Gecesars/emb_ant/README.md

# Painel setorial P1H · 5,09 a 5,25 GHz

**P2M19 R09 — simulações suspensas por solicitação do usuário em 14/11.** Referência RF preservada: R08, 14 passes, 20,544 dBi e ΔS 0,010484. Resumo enviado para gecesars@gmail.com. Planejamento da rede externa e montagem mecânica preliminar concluídos, com base de alumínio e dois conectores N. Falta de memória exige registro e parada sem repetição automática. [Estado, política e comunicação](projetos/P2M19/gestao_R09/README.md).

**P2M19 R08 — passes 13 e 14 concluídos em 14/11.** Malha preservada, colunas 72 mm, refletor 146 mm, 14 núcleos, 5,17 GHz, 16 entradas iguais/em fase e sem sweep. **ΔS final 0,010484 ≤0,05**; ganho frontal total **20,544 dBi**, aberturas **H 22,491° / V 3,783°**, máximos **+0,188° / +0,048°**. VSWR ativo **1,033–1,182**; maior VSWR com demais entradas casadas **1,316**. Entre os passes 13/14, ΔG **+0,0400 dB**, ΔH **−0,0986°**, ΔV **+0,0015°**; maior diferença de E/Emax **0,00353 H / 0,01006 V**. Balanço de potência consistente e zero reparos Major/Minor. O critério completo de 0,1 dB nas nove sondas por dois passes **ainda não foi atendido**; maior variação final 0,182 dB numa direção cerca de 31 dB abaixo do ganho frontal. Executados exatamente dois passes adicionais, sem novos cálculos programados. [Relatório, HFSS, VSWR e diagramas](projetos/P2M19/continuacao_72mm_ref146_14passes/README.md).

**P2M19 R07 — passes 11 e 12 concluídos em 14/11.** Malha preservada, colunas 72 mm, refletor 146 mm, 14 núcleos, 5,17 GHz, 16 entradas iguais/em fase e sem sweep. **ΔS final 0,014268 ≤0,05**; ganho frontal total **20,475 dBi**, aberturas **H 22,683° / V 3,778°**, máximos **+0,144° / +0,039°**. VSWR ativo **1,009–1,174**; maior VSWR com demais entradas casadas **1,301**. Entre os passes 11/12, ΔG **+0,0248 dB**, ΔH **−0,0634°**, ΔV **+0,0044°**. Balanço de potência consistente e zero reparos Major/Minor. A estabilidade completa de 0,1 dB nas nove sondas por dois passes **ainda não foi confirmada**; maior variação final 0,375 dB em uma direção cerca de 31 dB abaixo do ganho frontal. Executados exatamente dois passes adicionais, sem reiniciar a malha ou programar novos cálculos. [Relatório, HFSS, VSWR e diagramas](projetos/P2M19/continuacao_72mm_ref146_12passes/README.md).

**P2M19 R06 — convergência de ΔS confirmada em 14/11.** Executados somente os passes **9 e 10**, preservando os oito anteriores, colunas de 72 mm e refletor de 146 mm. 14 núcleos, 5,17 GHz, 16 entradas de 0,0625 W / 0°, sem sweep. ΔS **0,021617 / 0,024510**, dois passes consecutivos abaixo de 0,05. Ganho frontal total **20,391 dBi**, H/V **22,761° / 3,768°**, VSWR ativo **1,054–1,221** e máximo com demais entradas casadas **1,294**. Balanço de potência consistente e zero reparos Major/Minor. **A estabilidade completa dos campos ainda não foi confirmada**: ganho frontal variou +0,122 dB no último passe; maior variação entre as nove sondas foi 0,463 dB. Nenhum passe além de dez foi executado. [Resultados, HFSS e diagramas atualizados](projetos/P2M19/continuacao_72mm_ref146_10passes/README.md).

**P2M19 R05 — dois passes adicionais concluídos em 13/11, PRELIMINAR.** Preservados a geometria de colunas a 72 mm, refletor 146 mm e os seis passes anteriores; executados somente os passes 7/8, com 14 núcleos, 5,17 GHz, 16 entradas iguais/em fase, sem sweep. Resultado: **20,101 dBi**, H **22,734°**, V **3,753°**, VSWR ativo **1,143–1,353**. **ΔS=0,05196469 >0,05: não convergiu.** Balanço de potência consistente, zero reparos Major/Minor; ganho ainda variou +0,241 dB no último passe. O acompanhamento desta execução está concluído, sem novos passes programados. [Resultados, HFSS, comparação 6/8 e diagramas](projetos/P2M19/continuacao_72mm_ref146_8passes/README.md).

**P2M19 — comparação de 72/88 mm e três refletores concluída em 13/11, PRELIMINAR.** Executada fila local finita, com 14 núcleos, seis passes por geometria, entradas iguais/em fase, 5,17 GHz e sem sweep. Na comparação direta, mantendo refletor de 178 mm, colunas de 72 mm deram **19,209 dBi, H 24,238°, V 3,752°**, lóbulo horizontal **−4,866 dB** e ΔS **0,156138**. Os ajustes para refletores de 162/146 mm deram **19,418/19,500 dBi**, com H **23,989/23,550°**. **Nenhum caso convergiu ao alvo ΔS≤0,05 ou confirmou estabilidade dos campos; nenhum chegou a H=30°.** Balanços de potência consistentes, zero reparos Major/Minor, sem passes adicionais. A fila encerrou; não há agendamento recorrente. [Comparação, diagramas, nativos e evidências](projetos/P2M19/estudo_72mm/README.md) · [Operação da fila local](projetos/P2M19/automacao/README.md).

**P2M19 R01 — 16 níveis × duas colunas a 88 mm, estudo preliminar de 13/11.** Oito placas C12, 32 radiadores, dezesseis entradas de **0,0625 W / 0°**, 5,17 GHz, 14 núcleos e sem sweep. Encerrou no limite de **seis passes**, com **ΔS 0,177100 > 0,05: não convergiu**. Ganho frontal total **19,055 dBi**, abertura central H **19,428°**, V **3,820°**. Atinge 19 dBi numericamente, com margem de apenas 0,055 dB, sem validar a meta. Lóbulo horizontal em −37° a **−2,829 dB** do pico; VSWR ativo **1,364–2,295**. Balanço de potência consistente, zero reparos Major/Minor. Inclui perdas dos divisores impressos; exclui rede externa, cabos 3D e radome. [HFSS, CAD, diagramas, convergência e dados](projetos/P2M19/centro_16x2_88mm/README.md).

**P2S13 R17 — montagem DN100 dimensionada, preliminar (12/11).** Dois flanges Al Ø110 ×4,76 mm com canais **2,5 ×2,5 mm**, fixadores POM, dois N Amphenol082-6784 no flange inferior, chapa com linguetas e chicote completo. [FreeCAD, STEP, BOM, DXF e 12 páginas de documentação](projetos/P2S13/mecanica_R17/README.md). O teste sem abas resultou em **14,305 dBi, H78,77°, V10,11°, VSWR1,124/1,057**; ΔS0,030507 em seis passes, só um consecutivo válido. Abas pouco alteraram H; mantidas na montagem principal pelo vertical mais simétrico no resultado anterior. [Comparação HFSS/Nexxim e limites](projetos/P2S13/comparacao_refletor_R17/README.md). O fechamento mecânico completo ainda não foi qualificado em RF.

**P2S13 no tubo PVC — R16 concluída em 12/11 como estudo preliminar.** O ajuste `dn100_c02` atingiu **VSWR ativo 1,099 / 1,087** nas entradas do conjunto e **14,320 dBi** calculados em 5,17 GHz, com duas fontes iguais/em fase. Antena e divisor simulados separadamente; cabos somente no Nexxim, com perdas nominais. Tubo de catálogo **De 101,6 × parede 1,8 mm**, trecho aberto de 350 mm; propriedades dielétricas preliminares. Divisor convergiu em **6 passes / ΔS 0,017252**; antena encerrou em **6 / 0,041601**, sem os dois passes consecutivos exigidos e sem estabilidade completa de campos. Abertura agora informativa. **Não é qualificação do tubo comercial.** A sintonia melhora o conjunto carregado; isolado com saídas em 50 Ω, o divisor apresenta VSWR 2,154/2,153. [Pesquisa de tubos, explicação do VSWR, resultados e nativos](projetos/P2S13/tubo_pvc/README.md).

**Histórico anterior, sem tubo PVC:**

**P2S13 C09 ajustada — casamento do conjunto confirmado em 12/11.** Selecionada a c02: **VSWR ativo 1,184 / 1,226**, entradas de 0,5 W / 0° em 5,17 GHz; com a outra entrada casada, **1,142 / 1,207**. Seis ramais iguais de 19,323907 mm e PCB de 36 × 78 mm preservados, alterando apenas as duas seções dos transformadores. Divisor recalculado no HFSS: **5 passes, ΔS 0,020366, 14 núcleos**, sem radome, cabos 3D ou sweep. Nexxim efetivamente executado e conferido, erro S2 **6,15×10⁻¹⁶**. Com a antena S6 preservada, **14,146 dBi, H/V 86,241° / 10,068°, máximos 0° / +0,075°** permanecem preliminares pela estabilidade de campos da antena. O ajuste é para a carga da antena; o divisor isolado com saídas em 50 Ω tem VSWR 1,716/1,706. A abertura H≈100° e a qualificação completa continuam pendentes. [Relatório, dimensões, HFSS, Nexxim e FreeCAD](projetos/P2S13/casamento_c09/README.md). Montagem ajustada deixada aberta; nenhum novo Gerber liberado.

**Histórico C09 antes do ajuste:**

**P2S13 C09 compacto — Nexxim executado em 12/11, preliminar.** Novo divisor duplo 1:3 de **36 × 78 mm**, duas seções por ramal e comprimentos físicos/elétricos nominais iguais. HFSS separado para antena S6 e divisor S8, **sem radome e sem cabos longos em 3D**; seis coaxiais iguais de 134 mm representados por RLGC no Nexxim. Em 5,17 GHz, entradas de 0,5 W / 0°: **13,925 dBi** frontais, **VSWR 1,528 / 1,700**, H/V **86,228° / 10,073°**, máximos H/V **0° / +0,069°**. O casamento **não atende 1,25** e a abertura H está abaixo dos aproximadamente 100° buscados. Antena convergiu em **6 passes / ΔS 0,024379** e divisor em **5 / 0,019563**, todos com 14 núcleos; ainda há variação de campo de **0,309 dB** no último passe. A matriz Nexxim confere com cálculo independente, erro **4,61×10⁻¹⁶**. [Circuito nativo, diagramas, CAD e evidências](projetos/P2S13/compacto_c09/c00/README.md). Nenhum novo sweep; C08/Gerbers anteriores preservados, sem liberação C09 para fabricação.

**P2S13 R12 — continuação de oito passes e CAD/KiCad, 12/11.** Executados apenas passes 7 e 8 preservando a malha, 14 núcleos, 5,17 GHz, sem sweep e entradas 0,5 W / 0°. **ΔS 0,034291**, dois passes consecutivos ≤0,05: convergência S atendida. Ganho frontal **11,569 dBi**, VSWR ativo **1,547 / 1,455**, H/V **99,818° / 9,843°**, máximo V **−0,134°**; balanço de potência consistente. **Ganho frontal ≥12 dBi e VSWR ≤1,25 não atendidos; estabilidade de campo e simetria de 0,2 dB ainda pendentes** (assimetria V 0,208 dB). [Resultados, comparação e diagramas](projetos/P2S13/curvilinear_simplificado/continuacao8/README.md) · [KiCad/Gerbers: 3×M00 + 1×C08, DRC zero erros](projetos/P2S13/kicad/conjunto_R12/README.md) · [Montagem FreeCAD preliminar, deixada aberta](projetos/P2S13/mecanica_R12/README.md).

**Histórico P2S13 R12 — seis passes, 12/11, não validado.** Conjunto integral com C08, cabos e radome FR-4 de 2 mm; solver direto, elementos curvilíneos, 14 núcleos, duas entradas de 0,5 W / 0°. Em 5,17 GHz, seis passes: **ΔS 0,07831**, ganho frontal **11,572 dBi**, VSWR ativo **1,620 / 1,523**, H/V **98,902° / 9,796°**. O balanço de potência está consistente e o lóbulo principal vertical está praticamente centrado (**−0,008°**, assimetria **0,068 dB**). **Não atende à convergência, ao ganho frontal ≥12 dBi nem ao VSWR ≤1,25.** O pico horizontal é 12,724 dBi em +27,75°, distinto do ganho frontal. [Nativo, diagramas e auditoria R12](projetos/P2S13/curvilinear_simplificado/README.md).

**KiCad do divisor P2S13 C07 — 11/11:** [projeto, Gerbers e documentação](projetos/P2S13/kicad/divisor_duplo_1x3_C07/README.md), com a geometria nominal HFSS preservada. Conferência CAD/KiCad/CAM concluída; oito furos NPTH Ø0,9195 mm. **Fabricação padrão JLC ainda não liberada:** nove violações de folga mantidas porque o cobre chega aos furos e à borda. O ZIP inclui instruções de revisão especial; nenhum solve ou pedido de compra.

**P2S13 R09 — divisor corrigido e lóbulo principal vertical centrado nominalmente, 11/11.** Selecionada a C07, com compensação física nas trilhas e duas entradas de **0,5 W / 0°**. Em **5,17 GHz**, sem sweep: ganho frontal **12,746 dBi**, VSWR ativo **1,093/1,092**, aberturas H/V **98,614°/10,162°**, máximo vertical **−0,01°** na grade de 0,01° e assimetria máxima de **0,060 dB em ±4°**. Atende numericamente à meta atual de ≥12 dBi e à prioridade de centragem do lóbulo principal. O divisor convergiu em **seis passes**, **ΔS 0,023112**, dois consecutivos ≤0,05, **14 núcleos**, sem reparos Major/Minor; circuito conferido no Nexxim. Com a outra entrada casada, B fica em **1,255**, ligeiramente acima de 1,25. Resultado **preliminar**: permanecem as pendências de campos/reciprocidade da antena e não foi somada a radiação direta do divisor aos diagramas. [Relatório ilustrado, HFSS, FreeCAD, circuito e evidências](projetos/P2S13/divisor_duplo_1x3_correcao/README.md).

**Histórico R08, anterior à correção R09:**

**P2S13 — divisor duplo 1:3 físico simulado em 11/11.** A versão C01 concluiu seis passes, todos com 14 núcleos, em 5,17 GHz e sem sweep: **ΔS 0,049458**, dois passes consecutivos abaixo de 0,05. Conectada ao S6 da antena e conferida no Nexxim, com duas entradas de 0,5 W / 0°: **VSWR ativo 1,319/1,417**, ganho frontal **11,772 dBi**, H/V **99,308°/10,321°**. **Não atende VSWR≤1,25 nem ganho≥13 dBi.** O layout físico apresenta desequilíbrio de potência/fase nas saídas e não confirma o desempenho do plano de linhas anterior. Mantidas as ressalvas da antena e do modelo de componentes; nenhuma liberação para fabricação. [HFSS, circuito, CAD, diagramas e diagnóstico](projetos/P2S13/divisor_duplo_1x3_hfss/README.md).

**P2S13 — continuação de oito passes concluída em 11/11.** Três PCBs de dois elementos, dobra **28,5 mm / 150°**, mesma malha e geometria; somente passes 7 e 8 novos. Em 5,17 GHz, 14 núcleos, seis entradas iguais/em fase e sem sweep: **ΔS 0,017600**, ganho frontal **13,349 dBi**, H/V **98,727°/9,931°**, VSWR ativo máximo **1,3220**. Convergência S atendida; estabilidade de campos e reciprocidade estrita ainda pendentes. [Resultados e nativos](projetos/P2S13/continuacao_tres_placas2/README.md).

**Divisor duplo 1:3 — plano preliminar de circuito:** dois Wilkinson idênticos e ajuste comum de entrada resultam em VSWR máximo **1,1979** nas duas entradas, considerando fontes iguais/em fase e outra entrada casada. Ganho estimado **13,143 dBi**, H/V **98,720°/9,931°**; interconexão conferida no Nexxim. O divisor ainda não tem layout/validação EM, e os limites da malha da antena permanecem. [Plano, dimensões, dados e circuito](projetos/P2S13/divisor_duplo_1x3/README.md). [Histórico de seis passes](projetos/P2S13/tres_placas2/README.md) · [Campanha 4+2 interrompida](projetos/P2S13/dobras_placas_ajustadas/README.md).

**P2M21 R18 — mecânica PRELIMINAR concluída em 10/11:** [documentação, FreeCAD, chapa dobrada/planificada, BOM e imagens](projetos/P2M21/mecanica_preliminar_R18/README.md). Dez PCBs de quatro elementos, cinco por coluna: **20 níveis × 2 colunas**, passos **48/78 mm**, refletor de alumínio 2 mm, grampos de POM e dois N Amphenol 082-6784 a partir do STEP fornecido. Cabos de referência UT-141C. **Simulações interrompidas a pedido do usuário; nenhum solver será retomado automaticamente.** A rede externa de duas entradas para vinte conexões permanece pendente, assim como a liberação RF/mecânica. [Histórico R15/R16 e interrupção R17](projetos/P2M21/comparacao_colunas_niveis/README.md).

**P2M21, oito placas `4_elementos` — R14 de 10/11:** [conjunto 16×2, resultados e comparação](projetos/P2M21/oito_celulas_4_elementos/README.md), com passo horizontal aprovado de **72 mm** e folga de **2 mm**. Ensaio central com 16 portas iguais/em fase: **18,88 dBi**, H **25,25°**, V **3,75°** e VSWR ativo máximo **1,842**. **Ainda não validado: seis passes, ΔS 0,16430; requisito mantido em 0,05.** Nativos HFSS/FreeCAD, S16 e diagramas preservados, sem malhas no Git. Rede externa pendente da validação; sem sweep; a continuação posterior está registrada na R15.

**KiCad 4_elementos — 10/11:** [placa e documentação](projetos/P2M21/kicad/4_elementos/README.md) · [Gerbers para JLCPCB](projetos/P2M21/kicad/4_elementos/4_elementos_gerbers_JLCPCB.zip). Geometria R13 C12 preservada, 70 × 184 mm, RO4350B de núcleo 0,76 mm, dois divisores 1:4; DRC sem erros ou desconexões. O apontamento H +0,75° ainda excede a tolerância atual de ±0,5°; V −0,25° atende.

**P2M21 — módulo de quatro elementos, R13 de 10/11:** casamento numérico **VSWR ≤1,25 em 5,09–5,25 GHz**, com Fast de 161 pontos e conferências discretas. Pior VSWR ativo **1,23548**, outra entrada casada **1,23260**. Em 5,17 GHz: **12,4566 dBi**, H **72,055°**, V **15,183°**; máximos **+0,75°/−0,25°**, mantendo a ressalva de apontamento horizontal. Seis passes, ΔS **1,672%**, 14 núcleos, entradas iguais/em fase e cabos físicos com perdas. [Relatório, curvas, dimensões e nativos](projetos/P2M21/quatro_elementos_casamento_banda/README.md). A aprovação do casamento deste módulo não qualifica o painel completo de 21 dBi.

**P1H semipronta — campanha R07 suspensa a pedido do usuário em 8/11.** A R06 permanece qualificada somente em 5,17 GHz. O centro R07 foi conferido; a varredura de 17 frequências foi interrompida voluntariamente para iniciar o novo projeto. Não há aprovação de banda R07. [Registro do congelamento](resultados/r07/estado_semipronta.json).

**Continuação central P2M21 concluída:** dois passes adicionais, seis no total, em 5,17 GHz; 14 núcleos nos passes finais. Ganho total **23,32 dBi**, H **32,54°**, V **3,48°**. **Preliminar: ΔS 0,110424, sem convergência e com reprovações numéricas.** Sem sweep. [Comparação e diagramas polares E/Emax](projetos/P2M21/centro_sem_refinamento/continuacao_6_passes/README.md) · [Histórico de quatro passes](projetos/P2M21/centro_sem_refinamento/README.md).

**Novo projeto P2M21:** duas colunas, 16 níveis e duas entradas MIMO independentes, com meta de **21 dBi por entrada em 5,09–5,25 GHz**, a outra entrada casada em 50 Ω. [Concepção, placas KiCad, montagem FreeCAD e HFSS separado](projetos/P2M21/README.md).

**R06 qualificada numericamente em 5,17 GHz:** PCB contínua de dez elementos com divisores compactos, duas entradas de 0,5 W a 0°, cabos ideais sem atenuação. Resultado final: **17,3593 dBi, H 96,0643°, V 5,6158°**, VSWR ativo A/B **1,2115 / 1,1292** e com a outra entrada casada **1,2321 / 1,2474**. Convergência de 23 passes, estabilidade de malha aprovada e circuito conferido no Nexxim. [Relatório ilustrado de 15 páginas](resultados/r06/P1H_R06_Relatorio.pdf) · [Resultados e limites](resultados/r06/README.md) · [Cotação JLCPCB](resultados/r06/cotacao.md) · [Montagem e chapa R06](freecad/mecanica_R06/README.md). O aceite é somente no centro da banda, sem perdas dos cabos e com conectores N ideais. Os resultados reprovados abaixo são históricos, sob o método anterior.

**Histórico R02 — cálculo integrado anterior.** As duas montagens com divisores compactos reprovam o requisito conjunto de abertura horizontal e ganho em toda a banda. A 5,17 GHz, a placa contínua produziu **94,82° / 5,54° / 12,00 dBi** e as dez placas individuais **105,13° / 5,57° / 13,48 dBi**, respectivamente em H, V e ganho frontal realizado. A compacta teve a menor perda de distribuição entre as arquiteturas estudadas. [Comparação dos painéis](resultados/r02/comparacao_paineis.md) · [Relatório de engenharia](resultados/r02/Relatorio_P1H.pdf) · [Quatro materiais e divisores alongados](resultados/r03/README.md)

Projeto de uma coluna de dez antenas impressas com duas polarizações e passo de 52,6 mm no eixo X. A comparação atual usa duas PCBs distribuidoras, uma para os cinco radiadores inferiores e outra para os cinco superiores. Cada PCB atende às duas polarizações. A referência de ganho é a potência incidente nas duas entradas N, com 0,5 W a 0° em cada uma. Os modelos anteriores com divisor único e ramais de 254 mm também estão preservados.

| Para consultar | Arquivos |
|---|---|
| Modelos HFSS das duas montagens | [Uma placa](hfss/antenas/P1H_Continua.aedt) · [Dez placas](hfss/antenas/P1H_Separadas.aedt) · [Elemento de origem](hfss/antenas/P1H_AB_em_fase.aedt) |
| Modelos HFSS da alimentação | [Divisor de 22 portas](hfss/alimentacao/Divisor_2x10_PTFE.aedt) · [Transição soldada](hfss/alimentacao/Junta_UT141_P1H.aedt) |
| Fontes KiCad | [Coluna contínua](kicad/P1H_Coluna_10) · [Radiador individual](kicad/P1H_Individual) · [Divisor duplo](kicad/Divisor_2x10) |
| Referências dimensionais FreeCAD | [Uma placa](freecad/P1H_10_Continua.FCStd) · [Dez placas](freecad/P1H_10_Separadas.FCStd) · [Envelope do divisor](freecad/Divisor_2x10_PTFE.FCStd) |
| Mecânica do protótipo com refletor contínuo | [Montagem, chapa dobrada, planificação e desenho de fabricação](freecad/mecanica_R01/README.md) |
| Painel integrado R01 | [Modelo HFSS com duas portas N](hfss/antenas/P1H_R01.aedt) · [Premissas e reprodução](automacao/r01/README.md) · [Cotação da placa contínua e do divisor](resultados/r01/cotacao.md) |
| R02 com divisores inferior e superior | [Montagem, chapa e chicote](freecad/mecanica_R02/README.md) · [HFSS integrado](hfss/antenas/P1H_R02.aedt) · [Reprodução](automacao/r02/README.md) · [Cotação das três placas](resultados/r02/cotacao.md) |
| Controle R02-S com as dez placas individuais | [HFSS no mesmo refletor e rede R02](hfss/antenas/P1H_R02_10Separadas.aedt) · [Comparação convergida dos painéis](resultados/r02/comparacao_paineis.md) · [Comparação dos divisores em 50 Ω](resultados/r02/rede/README.md) · [Relatório de engenharia](resultados/r02/Relatorio_P1H.pdf) |
| R03 com saídas alinhadas e dois divisores alongados | [Comparação com a compacta e quatro laminados](resultados/r03/README.md) · [Montagem e chapa](freecad/mecanica_R03/README.md) · [HFSS do painel completo](hfss/antenas/P1H_R03_Alongada.aedt) · [Cotação](resultados/r03/cotacao.md) |
| Fabricação | [Pacotes Gerber com furação das revisões](fabricacao/gerbers) · [Ligação dos cabos da versão inicial](fabricacao/montagem/ligacao_dos_cabos.csv) · [Cotação JLCPCB inicial](fabricacao/cotacao/Cotacao_JLCPCB.md) |
| Estudos anteriores | [Colunas de 8, 9 e 10 elementos](documentacao/historico/comparacao_colunas.md) · [Elemento com ambas as portas em fase](documentacao/historico/analise_AB.md) · [Dados numéricos](resultados/historico) |
| Como reproduzir | [Procedimento e convenções](automacao/README.md) |

Os **critérios atuais de RF da R06** são abertura horizontal a −3 dB entre 81° e 99° (alvo 90°), VSWR < 1,5 nas duas entradas e ganho realizado frontal ≥ 16 dBi em +Z, no centro de 5,17 GHz e sem perdas dos cabos. A abertura vertical pode ser menor que 7°. A banda de interesse continua 5,09–5,25 GHz; os 17 pontos dos divisores não demonstram por si só desempenho do painel em toda a banda. As reprovações dos painéis integrais anteriores permanecem como histórico.

O ensaio anterior das duas revisões de PCB com refletores individuais foi interrompido após a convergência da placa contínua no centro da banda. O ganho mínimo de 16,58 dBi do estudo histórico corresponde às antenas individuais antes dos ajustes dos pads e furos. As campanhas R01, R02 e R02-S usam a mecânica completa, incluindo o refletor dobrado e os conectores N. [Estudo histórico](documentacao/historico/comparacao_colunas.md)

No painel completo R01, o ponto convergido de 5,17 GHz apresentou 14,06 dBi de ganho frontal e aberturas de 102,34° na horizontal e 6,19° na vertical. A R01 reprova as metas simultâneas de banda. [Campos, convergência e métricas](resultados/r01/README.md)

Os **radiadores** usam RO4350B de 0,76 mm (Dk de projeto 3,66). Os divisores de referência usam PTFE ZYF300CA-C de 1,52 mm. São espessuras do laminado. A placa longa mede 501,7125 × 28,3125 mm e a individual mede 28,3125 × 28,3125 mm. Os modelos RF anteriores usam dez refletores individuais de 48,3125 × 36 mm. Os protótipos mecânicos R01 a R03 usam refletor contínuo dobrado de alumínio de 2 mm, apoios em poliacetal e conectores N com junta de vedação. Os modelos históricos de cobre excluíam a camada de níquel-fósforo; a R06 inclui ENIG nominal sobre cobre físico de 35 µm.

Os modelos HFSS nativos podem gerar a malha novamente. O Git guarda projetos, dados de engenharia e documentos. As malhas, os campos volumétricos, os backups e os arquivos temporários ficam nos diretórios locais de trabalho. Os Gerbers em **fabricacao/gerbers** correspondem aos protótipos cotados. As campanhas integrais anteriores reprovam suas metas; a R06 atende ao aceite de centro pelo método separado solicitado, conforme o relatório final.
