Gecesars/emb_ant/projetos/P2M21/README.md

# P2M21 — duas colunas, MIMO 2×2, meta de 21 dBi por entrada

**P2M21 R18 — mecânica PRELIMINAR concluída em 10/11:** [documentação, FreeCAD, chapa dobrada/planificada, BOM e imagens](mecanica_preliminar_R18/README.md). Dez PCBs de quatro elementos, cinco por coluna: **20 níveis × 2 colunas**, passos **48/78 mm**, refletor de alumínio 2 mm, grampos de POM e dois N Amphenol 082-6784 a partir do STEP fornecido. Cabos de referência UT-141C. **Simulações interrompidas a pedido do usuário; nenhum solver será retomado automaticamente.** A rede externa de duas entradas para vinte conexões permanece pendente, assim como a liberação RF/mecânica. [Histórico R15/R16 e interrupção R17](comparacao_colunas_niveis/README.md).

**Painel de oito células — R14 de 10/11:** [montagem HFSS/FreeCAD, diagramas e comparação](oito_celulas_4_elementos/README.md). Oito cópias de `4_elementos`, em quatro placas verticais × duas colunas, totalizam 16 níveis × 2 radiadores. Passos de **48 mm vertical / 72 mm horizontal**, com **2 mm de folga lateral**. Em 5,17 GHz, 16 portas de 0,0625 W/0°, 1 W total: **18,8776 dBi**, H **25,2549°**, V **3,7541°**, máximos **−1,25° / 0°**, VSWR ativo máximo **1,8421** e com demais portas casadas **1,4125**. **Não validado: seis passes, ΔS 0,164297, acima do alvo 0,05**, e campos ainda variando. Malha sem reparos Major/Minor; passividade, reciprocidade e recomposição dos campos conferidas. Mantidos 14 núcleos, sem GUI e sem sweep; inclui os cabos físicos de 50 mm das células. O painel individual R04 também não convergiu e tem outros espaçamentos, portanto a comparação é histórica. A rede externa de duas entradas para 16 conexões aguarda validação dos diagramas; o estado de seis passes é histórico; os dois passes adicionais autorizados estão registrados na R15.

**KiCad em 10/11 — [4_elementos](kicad/4_elementos/README.md):** criada a placa de **70 × 184 mm**, com passo de **48 mm** e dois divisores 1:4, preservando a geometria R13 C12. [Gerbers/Excellon para JLCPCB](kicad/4_elementos/4_elementos_gerbers_JLCPCB.zip), RO4350B de núcleo 0,76 mm. Cobre, contorno e dez furos conferidos; **DRC sem erros ou desconexões**. A tolerância atual é **±0,5° em H e V**: a C12 mantém H +0,75° (fora) e V −0,25° (dentro). Esta conversão não altera a geometria nem inicia nova simulação.

**Módulo de quatro elementos — R13 concluída em 10/11:** a meta de **VSWR ≤1,25** foi atendida numericamente na banda de **5,09–5,25 GHz**. O Fast tem 161 pontos de saída e foi conferido por soluções discretas em 5,09/5,17/5,25 GHz e no pior ponto, **5,173 GHz**. Máximo ativo confirmado: **1,23548**; com a outra entrada em 50 Ω: **1,23260**. O ajuste usa três seções nos transformadores de raiz, iguais nas duas polarizações, mantendo os dipolos, passo de **48 mm** e altura de **14,949 mm**. [Relatório, dimensões, curvas, HFSS e FreeCAD](quatro_elementos_casamento_banda/README.md).

Em **5,17 GHz**, A=B=0,5 W/0°: **12,4566 dBi frontais**, aberturas **H 72,055° / V 15,183°**, máximos **H +0,75° / V −0,25°** e SLL vertical **−10,075 dB**. A forma e as larguras foram preservadas nos limites documentados; o máximo horizontal ainda excede o limite de trabalho de ±0,5°. Portanto, o casamento atende à meta, com essa ressalva de apontamento. **Seis passes, convergida em ΔS 1,672%, 14 núcleos**, sem novos passes nos sweeps. Inclui os dois cabos físicos de 50 mm e suas perdas. Ganho e diagramas foram calculados somente no centro; esta entrega não qualifica o painel 16×2 ou o desempenho MIMO por entrada.

**Módulo de quatro elementos — continuação R12 de 9/11:** [oito passes e Fast da banda](quatro_elementos_8passes_fast/README.md). A variante com passo de **48 mm** e altura de **14,949 mm** recebeu exatamente os passes 7 e 8, preservando a malha anterior. **Convergiu**, com ΔS final **1,977%**, dois passes consecutivos abaixo de 5% e 14 núcleos. Em **5,17 GHz**, com A=B=0,5 W/0°: **12,7586 dBi frontais**, VSWR ativo **1,3648/1,2285**, casado **1,2091/1,1733**, aberturas **H 73,322° / V 15,058°**, máximos **H 0° / V −1,25°** e SLL vertical **−9,095 dB**. O **Fast de 5,09–5,25 GHz**, com 161 pontos de saída e sem novos passes adaptativos, revelou máximos de VSWR ativo **2,2796/2,0142 em 5,09 GHz**. Portanto, a convergência foi atingida, mas o casamento na banda e o apontamento vertical ainda precisam de ajuste. Ganho e diagramas foram medidos somente no centro. A referência R11 permanece preservada; o ajuste de casamento R13 esta documentado acima.

**R00: concepção criada, ainda sem qualificação eletromagnética do novo painel.** A P1H foi preservada como semipronta; seus resultados não aprovam esta nova geometria.

**Distribuição solicitada em 9/11:** [dez divisores 1:4 em cinco PCBs duplas](rede_dez_1x4/README.md), com dois circuitos centrais e oito locais. O usuário aprovou uma entrada por polarização e as divisões finais 1:2 impressas nas placas radiantes. A integração do painel completo continua pendente; os estudos de módulos usam dois ou quatro elementos verticais e dois cabos físicos.

**Estudo do módulo de dois elementos:** foram testadas conexões centrais, retornos de terra e comprimentos dos divisores impressos, em 5,17 GHz, na GUI, com 14 núcleos e até seis passes por geometria. A comparação distingue apontamento, casamento e convergência e mantém a referência original. [Resultados, diagramas e nativos das variantes](dois_verticais_divisor/README.md). Este módulo não qualifica o painel 16×2 nem a banda MIMO.

**KiCad e expansão em 9/11:** criada a placa [2_elementos](kicad/2_elementos/README.md) a partir da v05 convergida, com 49 × 82,8 mm, DRC sem erros ou conexões pendentes e comparação geométrica com a fonte HFSS. O [planejamento de quatro elementos verticais](planejamento/4_elementos/README.md) foi convertido no ensaio HFSS abaixo, mantendo passo de 48 mm, duas conexões centrais e um divisor 1:4 por polarização, em uma placa de 70 × 178,8 mm.

**Quatro elementos — ajuste R11 de 9/11:** [comparação de divisores, espaçamentos e distância ao refletor](quatro_elementos_ajuste/README.md). Foram preservados 19 ensaios em 5,17 GHz, incluindo passos de 42/44/48/50/52/54 mm e distâncias de 14,949/16,610/18,271 mm. As variantes finais mantêm divisores espelhados e duas entradas de 0,5 W / 0°. O candidato numérico mais promissor usa **48 mm de passo e 14,949 mm entre laminado e refletor**, com transformadores de raiz iguais de **0,656371 × 9,000142 mm**: **12,7018 dBi frontais**, VSWR ativo **1,2327/1,0940**, casado **1,1041/1,1808**, aberturas **H 73,630° / V 15,180°** e SLL vertical **−8,385 dB**. Continua **preliminar, não liberado**: seis passes, **ΔS 0,057225 (5,7225%)**, acima do alvo de 5%, e máximos **H −1,00° / V −1,25°**. Nenhum ensaio R11 completou os dois passes consecutivos de convergência configurados. O estudo usa 14 núcleos, sem GUI, sem sweep, com os dois cabos físicos de 50 mm e perdas nominais; não qualifica o painel 16×2. A comparação controlada de alturas foi preservada separadamente do reajuste posterior do transformador.

**Quatro elementos — referência R10 de 9/11:** [modelo, resultados e diagramas](quatro_elementos_hfss/README.md). Simulação sem GUI, 14 núcleos, somente 5,17 GHz, dois divisores 1:4 impressos e dois cabos físicos de 50 mm, fontes de 0,5 W / 0° cada. Terminou no limite de seis passes com **ΔS = 0,048783 (4,8783%)**, acima do alvo de 4%: **preliminar, não convergido**. Ganho frontal realizado total **11,0946 dBi**; VSWR ativo A/B **1,4470 / 1,5774**. Máximos dos cortes H/V em **−25,25° / +0,50°**, com aberturas **83,858° / 14,961°**. A frente está 0,404 dB abaixo do pico horizontal; o pico não está centrado em 0° e a entrada B excede VSWR 1,5. Malha sem reparos Major/Minor, matriz passiva e balanço de potência conferido; essas verificações não substituem a convergência. Não foi executado sweep nem ampliado o limite de passes.

**Continuação concluída em 9/11:** somente os dois passes adicionais autorizados (5 e 6), mantendo 14 núcleos e 5,17 GHz. Resultado: **23,3227 dBi, H 32,5429°, V 3,4843° e ΔS 0,110424**. Continua **preliminar e não convergido**; a eficiência calculada de 100,425% e o erro de reciprocidade também impedem a qualificação. Os dois diagramas polares E/Emax foram revisados visualmente. [Comparação, dados e diagramas](centro_sem_refinamento/continuacao_6_passes/README.md).

**Histórico do painel completo — 9/11:** somente ganho total e diagramas H/V em **5,17 GHz**, com 16 níveis × 2 colunas e as 64 portas iguais/em fase. A revisão R04 usa Classic com resolução global padrão, sem refinamentos locais/iniciais impostos, sem lambda refinement inicial e com base mista. O primeiro cálculo foi limitado a quatro passes; o pedido seguinte autorizou exatamente mais dois, preservando a malha e o histórico. A continuação terminou às 05:53 com **seis passes no total**, sem sweep e sem alteração geométrica. O resultado de quatro passes permanece arquivado: **23,06 dBi, H 32,72°, V 3,50° e ΔS 0,617681**. [Histórico de quatro passes](centro_sem_refinamento/README.md). O ensaio R02 e a tentativa TAU R03 permanecem históricos. A alimentação direta não inclui a rede externa nem comprova ganho MIMO por entrada.

**Estudo de 9/11, antes de corrigir a malha:** a pedido do usuário, foi comparada a alimentação de **todas as portas A/B simultaneamente, com amplitude igual e fase de 0°**, mantendo 1 W total. A estimativa com a referência P1H R06 favorece manter **16 níveis × 2 colunas**: ganho total frontal de aproximadamente **22,50 dBi**, H **39,1°** e V **3,49°** em 5,17 GHz, sem a nova rede. O caso 10×2 fica em 20,46 dBi. Foram documentadas 36 combinações de níveis, colunas e espaçamentos. Este estudo coerente não comprova o requisito MIMO por entrada nem a banda e não alterou a geometria ou iniciou novo ciclo HFSS. [Comparação, método e gráficos](estimativa_uniforme/README.md).

**Atualização de 8/11, após a execução R00:** a antena terminou às 16h43 sem convergir em seis passes: ΔS = 0,040859, contra o limite então adotado de 0,02. Foram identificados sete corpos com reparos Major. Aquela fila interrompeu antes da varredura do painel e do circuito; ganho e VSWR por entrada nos 17 pontos continuam sem confirmação. [Diagnóstico e evidências](diagnostico_20261108.md).

O requisito original do projeto, ainda não qualificado e fora desta etapa de centro, é ganho frontal realizado **≥21 dBi em cada entrada**, de **5,09 a 5,25 GHz**, nos 17 pontos separados por 10 MHz, com a outra entrada terminada em 50 Ω. Cada entrada alimenta uma polarização dos 32 radiadores, distribuídos nas duas colunas. Os dois canais permanecem independentes. Não se soma a potência dos canais para alegar 21 dBi por entrada.

## Arquitetura escolhida

| Item | R00 |
|---|---|
| Arranjo | 16 níveis × 2 colunas; 32 radiadores de duas polarizações |
| Passo vertical / horizontal | 52,6 / 40 mm |
| Placas radiantes | 4 módulos iguais de 2 colunas × 4 níveis |
| Dimensão de cada módulo | 186,1125 × 68,3125 mm |
| Radiadores | RO4350B, núcleo 0,76 mm; Dk de projeto 3,66; tanδ 0,0037 |
| Alimentação | Um divisor duplo 1:4 central e quatro divisores duplos 1:8 locais |
| Placa de cada divisor | 39 × 78 mm, PTFE ZYF300CA-C de 1,52 mm; Dk 2,94; tanδ 0,0016 |
| Metalização RF | Cu físico 35 µm; ENIG nominal Au 0,0254 µm / NiP 4,5 µm |
| Refletor | Face 850 × 100 mm; alumínio 2 mm; base dobrada a 90° |
| Apoios | Oito berços transversais em poliacetal, espessura 5 mm |
| Entradas mecânicas | Dois furos Ø16 mm na base, reservados aos conectores N |

RO4350B é laminado hidrocarboneto/cerâmico; o PTFE está nas distribuidoras. A disponibilidade dessas famílias e espessuras foi consultada no contexto P1H: [materiais JLCPCB](https://jlcpcb.com/news/rogers-ptfe-high-frequency-pcb-available). A cotação P1H não é uma cotação destas novas placas. Não houve compra.

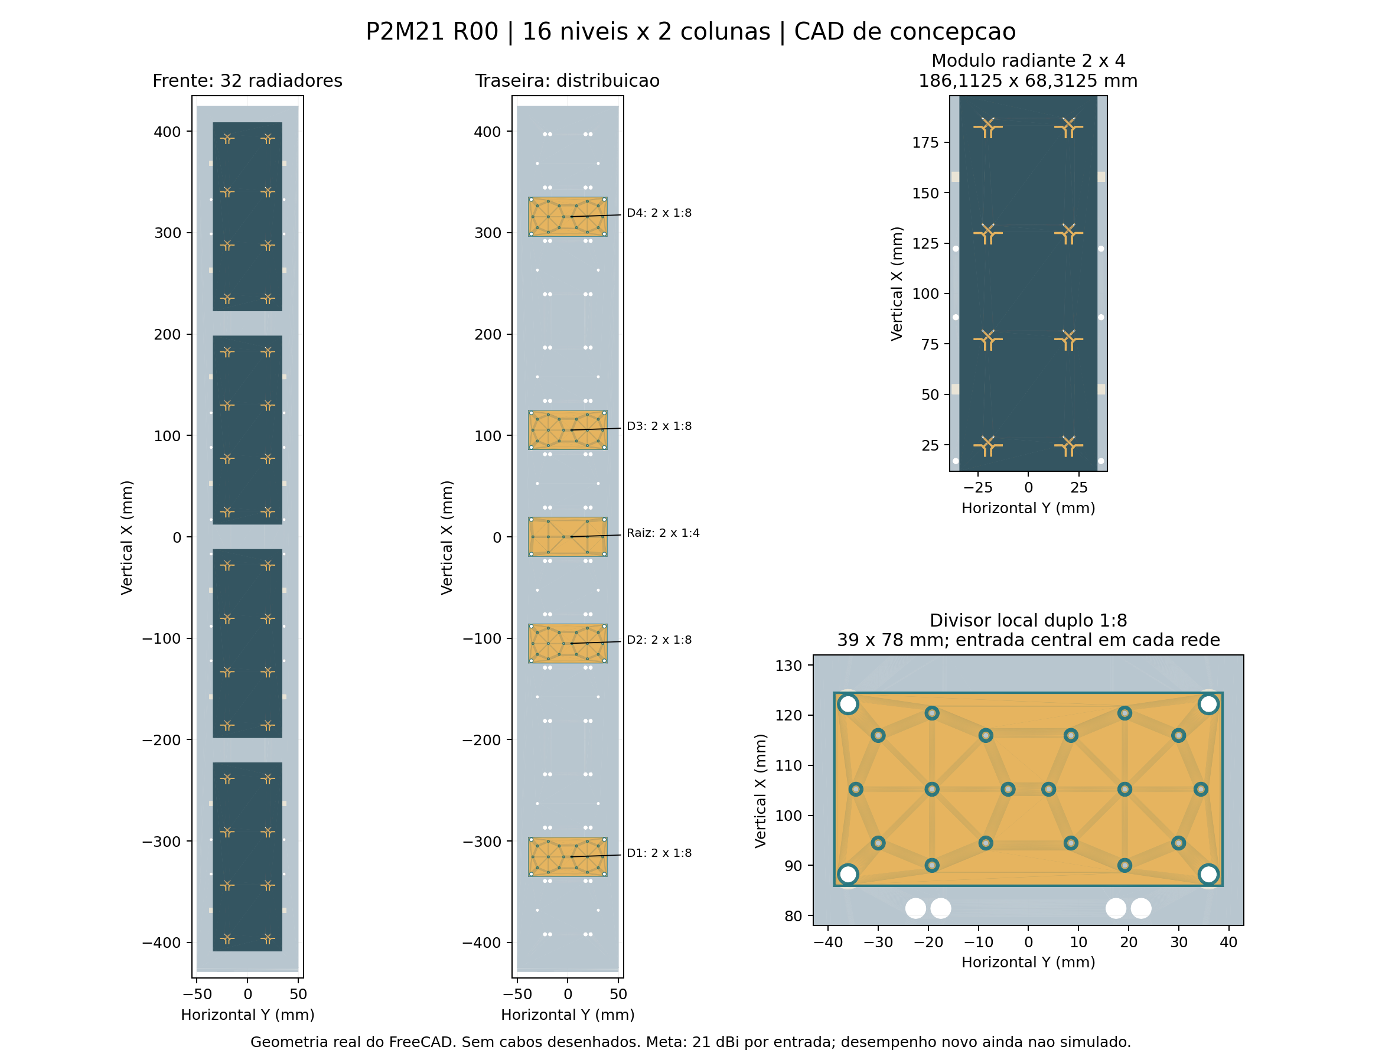
[picture p1: projetos/P2M21/imagens/montagem_e_placas.png]
Montagem CAD e detalhes das placas


[Detalhe do cobre nas duas faces da PCB](imagens/pcb_duas_faces.png)

## Por que 16 níveis e distribuição central

Foram comparados 10, 12, 14, 16, 18 e 20 níveis, com separações entre colunas de 32 a 48 mm. O pré-dimensionamento usa os campos complexos **por entrada individual** da R06 em 5,17 GHz, escala de número de radiadores e fator de arranjo horizontal. A seleção 16×2/40 mm dá uma estimativa de **22,42 dBi antes da reserva adicional**, ou **21,67 dBi com reserva de projeto assumida de 0,75 dB**, H aproximadamente **37,85°** e V aproximadamente **3,57°** no centro. A reserva não é perda simulada nem comprovação de banda. O novo acoplamento, as emendas das PCBs, o refletor e a rede podem alterar esses valores.

[Tabela de alternativas](planejamento/comparacao.csv) · [Gráfico](planejamento/predimensionamento.png) · [Premissas e referência](configuracao.json)

As distribuidoras locais ficam atrás dos centros dos quatro módulos, em X = −315,6, −105,2, +105,2 e +315,6 mm. A raiz fica em X = 0. Isso reduz a maior distância longitudinal entre centros, de 740,6 mm para uma raiz na base a 315,6 mm para a raiz central. Trata-se de comparação geométrica, antes dos arcos e conexões.

O histórico P1H mostrou perdas e desequilíbrios maiores nas versões alongadas inicialmente testadas. Por isso esta R00 parte de distribuidoras compactas locais. As redes são divisores radiais com transformadores de quarto de onda: **não são Wilkinson e não têm resistores de isolamento entre as saídas da mesma polarização**. O circuito completo deve considerar as reflexões e o acoplamento dos radiadores.

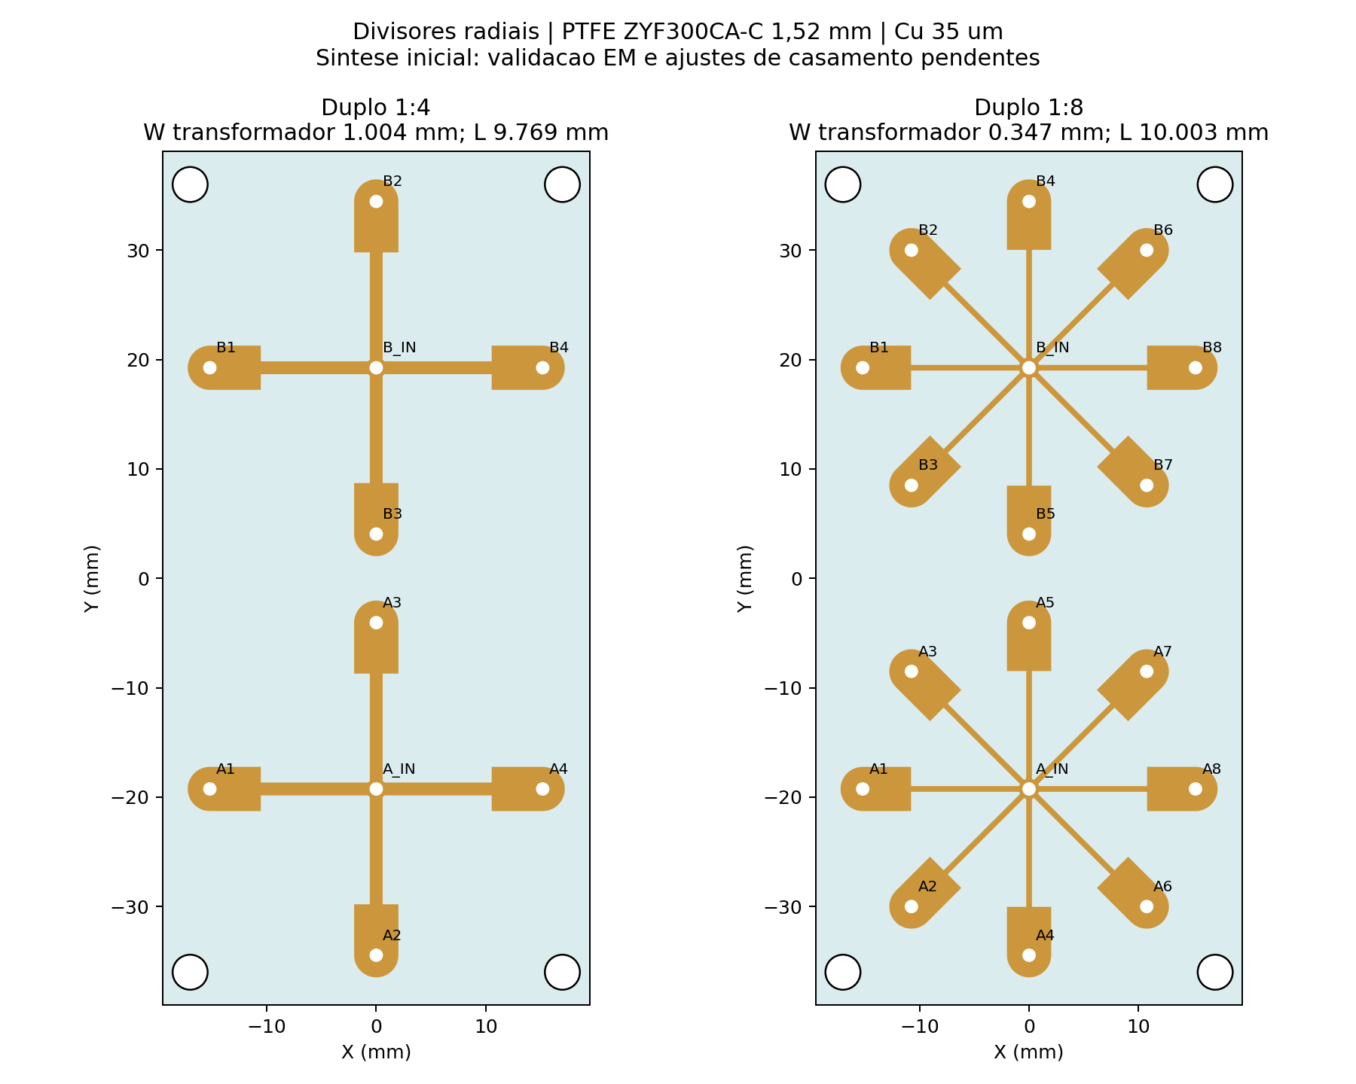
[picture p2: projetos/P2M21/imagens/divisores_detalhados.png]
Divisores em detalhe


O [mapa de conexões](mapa_conexoes.csv) associa as 64 portas dos radiadores às saídas dos divisores. A atribuição minimiza a soma das distâncias ortogonais. Há reservas iniciais iguais de **165 mm nos ramais** e **365 mm nos troncos**, calculadas com margem para roteamento. **Não são comprimentos de corte liberados:** faltam as curvas físicas, folgas de montagem e o ajuste das fases usando as matrizes S reais. As entradas N na base exigem duas ligações adicionais até a raiz. A montagem CAD ainda não inclui o chicote e os conectores N detalhados.

## Arquivos criados

- [Módulo radiante KiCad](kicad/P2M21_Modulo_2x4/P2M21_Modulo_2x4.kicad_pcb), [divisor duplo 1:4](kicad/P2M21_Duplo_1x4/P2M21_Duplo_1x4.kicad_pcb) e [divisor duplo 1:8](kicad/P2M21_Duplo_1x8/P2M21_Duplo_1x8.kicad_pcb).
- [Montagem FreeCAD](freecad/P2M21_Montagem.FCStd), [chapa dobrada STEP](freecad/Refletor_dobrado.step), [planificação FreeCAD](freecad/Refletor_planificado.FCStd) e [DXF de corte/dobra](freecad/Refletor_corte_dobra_R00.dxf).
- HFSS separado: [antena de 64 portas](hfss/antena/P2M21_Antena.aedt), [divisor de 10 portas](hfss/divisor_1x4/P2M21_Duplo_1x4.aedt) e [divisor de 18 portas](hfss/divisor_1x8/P2M21_Duplo_1x8.aedt).

O cobre do radiador foi copiado do CAD R06, incluindo vias e soldas locais; os substratos, distribuição em duas colunas, reflector e apoios são novos. Os scripts em [automacao](automacao) reproduzem a construção. O CAD nativo mantém os corpos separados para edição e posicionamento; não recupera uma árvore de esboços do cobre importado. A montagem é por posicionamento, não uma montagem cinemática.

## Verificações e limites

O primeiro ensaio do divisor duplo 1:4 convergiu em seis passes, com ΔS final 0,01449 e dois passes consecutivos aprovados. Em 5,17 GHz, com todas as saídas casadas, VSWR A/B = 1,53665 / 1,53646; perda excedente = 0,33193 / 0,33038 dB. Isso ainda não aprova o casamento nem o ganho do painel carregado. A fila inicial resolve os divisores em separado e só então o centro da antena, sem aumentar o limite de seis passes. O estado de execução está em [qualificacao.json](qualificacao.json).

O divisor duplo 1:8 também convergiu em seis passes, com ΔS 0,018707 e dois consecutivos aprovados. No centro, VSWR A/B = 1,69614 / 1,69673 e perda excedente = 0,52494 / 0,52296 dB. As terminações casadas desse ensaio não reproduzem a impedância ativa da antena; o casamento final depende do circuito carregado. **Ambos completaram os 17 pontos**, com passividade/reciprocidade verificadas e zero reparos Major/Minor. A execução da antena de 64 portas ocorreu em 8/11 das 16:03 às 16:43 e terminou sem convergência; ainda não há ganho qualificado do painel.

Os modelos CAD foram reabertos e verificados: 653 objetos na antena, 44 no divisor 1:4 e 76 no 1:8, todos válidos, sem interseções volumétricas indevidas entre corpos. Contatos tangentes entre materiais são permitidos. O DRC das três placas tem **zero erros e zero itens desconectados**. Permanecem respectivamente 203, 20 e 36 avisos de máscara aberta/ponte de máscara nas áreas RF; os relatórios completos acompanham os nativos.

A chapa planificada mede 895,398 × 100 mm, com raio interno de 2 mm e fator K assumido de 0,4. Confirmar o raio, ferramental, ajuste dos conectores e vedação antes de fabricação. A planificação é preliminar, não uma liberação industrial.

No histórico R00 foram usados seis passes e ΔS ≤0,02. A revisão R04 foi inicialmente limitada a quatro passes e continuada somente por mais dois mediante novo pedido, com 14 núcleos, sem sweep. O alvo de referência continua 0,04; o ΔS final de 0,110424 não o atende. Atingir o limite de passes não comprova convergência. Os nativos R00 preservam as antigas varreduras; sua existência não autoriza executá-las nesta etapa. Para o estudo futuro da rede separada, a matriz S64 da antena e S10/S18 das distribuidoras serão conectadas por linhas ideais de fase, sem atenuação, com referência à potência incidente em cada entrada MIMO individual.

Para a meta original MIMO, fora desta etapa central, ainda faltam a convergência EM, matrizes e campos nas 17 frequências, circuito carregado, VSWR por entrada, ganho e H/V por canal, isolamento/correlação MIMO e ajustes de casamento. O curto DC deverá incorporar as duas bobinas de entrada da referência P1H, com nova conferência da sua integração. Os avisos de máscara, terminais soldados, conectores e chicote precisam entrar na revisão de fabricação. **Nenhum resultado R00 demonstra ainda 21 dBi em toda a banda.**
