Gecesars/emb_ant/automacao/r03/README.md

# Reprodução do estudo da rede alongada

Os arquivos nativos e os dois Gerbers de referência usam ZYF300CA-C. Os materiais alternativos têm trilhas próprias para conservar as impedâncias e atrasos elétricos. A placa de radiadores usa RO4350B de 0,76 mm em todas as versões. Trabalhar em uma pasta externa ao Git para as malhas.

1. Executar `projeto.py DIRETORIO` em Python com SciPy, NumPy, Shapely e scikit-rf. O programa produz os contornos, fixações, cobre e rede de cada laminado. Executar `chicote.py DIRETORIO/candidatos.json` para sintetizar as entradas coaxiais.
2. No Python do FreeCAD, definir `P1H_R03` como DIRETORIO e executar `montagem.py`. O CAD testa os percursos coaxiais contra a montagem, a folga entre capas e os furos. A macro `../r02/apresentar.FCMacro` usa `P1H_VISTA=R03`, `P1H_R03` e `P1H_REPO` para gravar os documentos com cores e registrar a vista.
3. Usar o Python do KiCad com `../P1H/Divisor_10X_PTFE/gerar_pcb.py` em cada diretório de geometria, exportar Gerber e furação PTH e NPTH pelo KiCad CLI, e executar o DRC. `fabricacao.py DIRETORIO` verifica contornos, diâmetros, centros dos furos, integridade dos ZIPs e os DXFs de corte/dobra da chapa.
4. `perdas.py DIRETORIO` aplica a análise nodal em microstrip e UT-141C às duas arquiteturas para todos os laminados. Os cálculos usam uma polarização com a outra idêntica. Documentar a referência adotada nas comparações.
5. `cupons_hfss.py`, executado pelo AEDT, cria e resolve linhas de 20 e 120 mm de cada laminado. `extrair_cupons.py DIRETORIO` elimina os terminais por autovalores da matriz de transferência composta. Exigir dois passes consecutivos com ΔS ≤ 0,003 e todas as 17 frequências. O script de extração registra o número de passes, inclusive se houver resultado provisório de uma execução anterior.
6. `rede_cad.py` no FreeCAD e `rede_hfss.py` no AEDT produzem a rede física de cada material, com duas emendas metálicas por polarização (sinal e retorno). `P1H_MATERIAIS` seleciona laminados separados por vírgula. `P1H_CALCULAR_REDE=1` habilita a solução, com simetria magnética para as duas entradas em fase. `medir_rede.py DIRETORIO` soma as potências nas dez saídas do modo par depois de transportar as referências pelos coaxiais. Cada porta do modelo já contém 1,5 mm de coaxial, deduzidos ao transportar as referências.
7. Para o painel montado, apontar `P1H_CAD_BASE` para a geometria comum de radiadores/conectores da R01, `P1H_R01` para a pasta de trabalho do novo painel e `P1H_MATERIAL` para o laminado escolhido. Executar `painel_cad.py` no FreeCAD, depois `../r01/modelo_hfss.py` e `../r01/resolver.py` no AEDT. O diretório `estudo` deve existir. Ativar `P1H_ITERATIVO=1`, `P1H_ORDEM=0` e definir `P1H_NOME` como o nome do projeto. `../r01/medir.py` verifica o S2P e os cortes nos planos de referência dos N.

A fila PowerShell aceita o diretório de campanha e os PIDs opcionais dos cálculos anteriores de painel e cupons. Ela preserva as soluções em andamento, refina os cupons que precisam de mais passes, executa uma rede ou painel grande por vez e grava os estados de execução. Os valores com as terminações casadas excluem a bobina, o interior do N e o casamento dos radiadores. A comparação integrada inclui esses elementos.

Para comparar todas as compactas por matrizes HFSS, usar `ensaiar_compactas.ps1 -Estudo DIRETORIO`. Esse ensaio reaproveita as duas matrizes da R02 em ZYF300CA-C, sintetiza o 1:2 e o 1:5 nos outros três laminados e liga os estágios nos mesmos planos dos vinte cabos. Para uma estimativa intermediária, `perdas.py DIRETORIO --cupons` substitui a constante de propagação complexa apenas dos trechos de 50 Ω pelos resultados diferenciais convergidos. Transformadores de outras impedâncias e nós de divisão continuam no modelo por linhas. A previsão intermediária e a matriz da rede física têm arquivos distintos.
