Gecesars/emb_ant/projetos/P2M21/comparacao_colunas_niveis/R17_Dez_Celulas_78mm/README.md

# R17 — interrompida pelo usuario

Dez placas / 40 radiadores, passo entre colunas 78 mm. Simulacao interrompida durante o segundo passe em 10/11/2026. Nao ha ganho, VSWR ou diagrama final. O nativo preserva a geometria preparada; nenhum solver deve ser retomado sem nova instrucao. A mecanica preliminar foi concluida na R18.
