Gecesars/emb_ant/projetos/P2M21/mecanica_preliminar_R18/P2M21_R18_Desenhos_PRELIMINARES_A3.pdf

01 — Montagem do painel e interfaces | PRELIMINAR

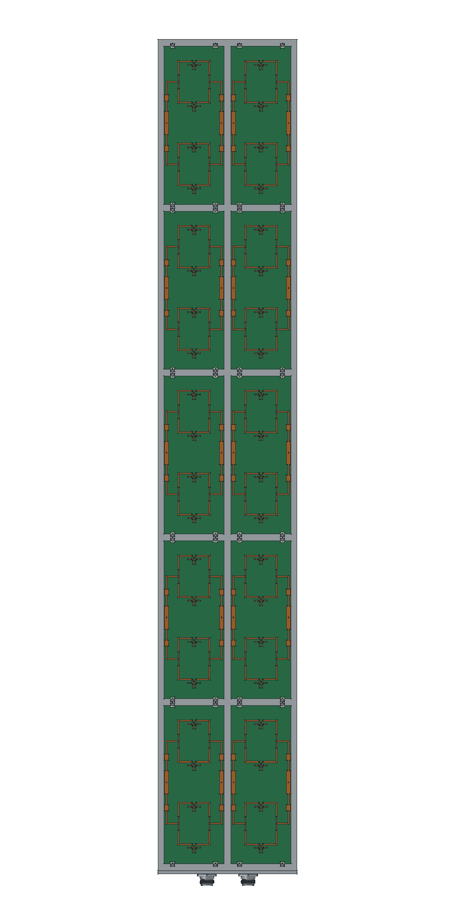
[picture p134: figure]
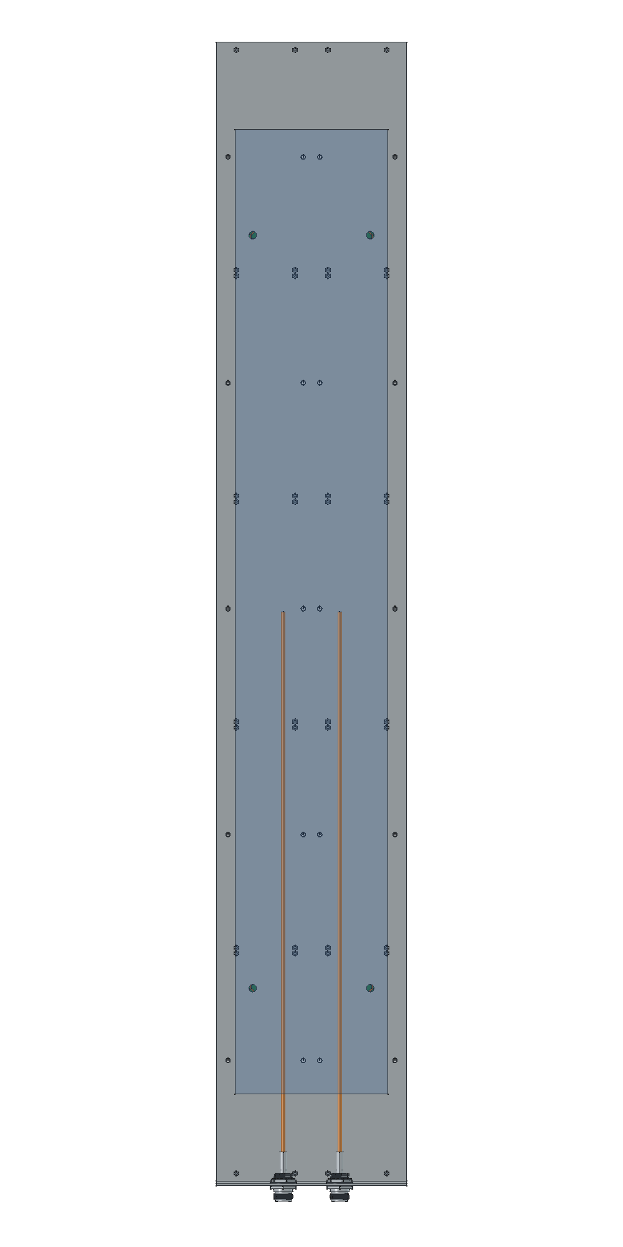
[picture p135: figure]

P2M21 R18 • 10/11/2026 • mm • confirmar tolerâncias e ferramental antes de fabricar | Prancha 1 / 3

Face refletora: 968 × 162 × 2

10 PCBs de 70 × 184; núcleo 0,76

Passo vertical dos radiadores: 48

Passo entre PCBs: 192

Passo entre colunas: 78

Folgas lateral / vertical: 8 / 8

Altura da face inferior do núcleo: 14,949

20 cabos de referência, 50 mm cada

40 grampos POM, seção de 5 mm

2 N Amphenol 082-6784

Rede externa: 2 × 1:10 PENDENTE

Fechamento e mastro: A DEFINIR

02 — Chapa planificada / corte | PRELIMINAR

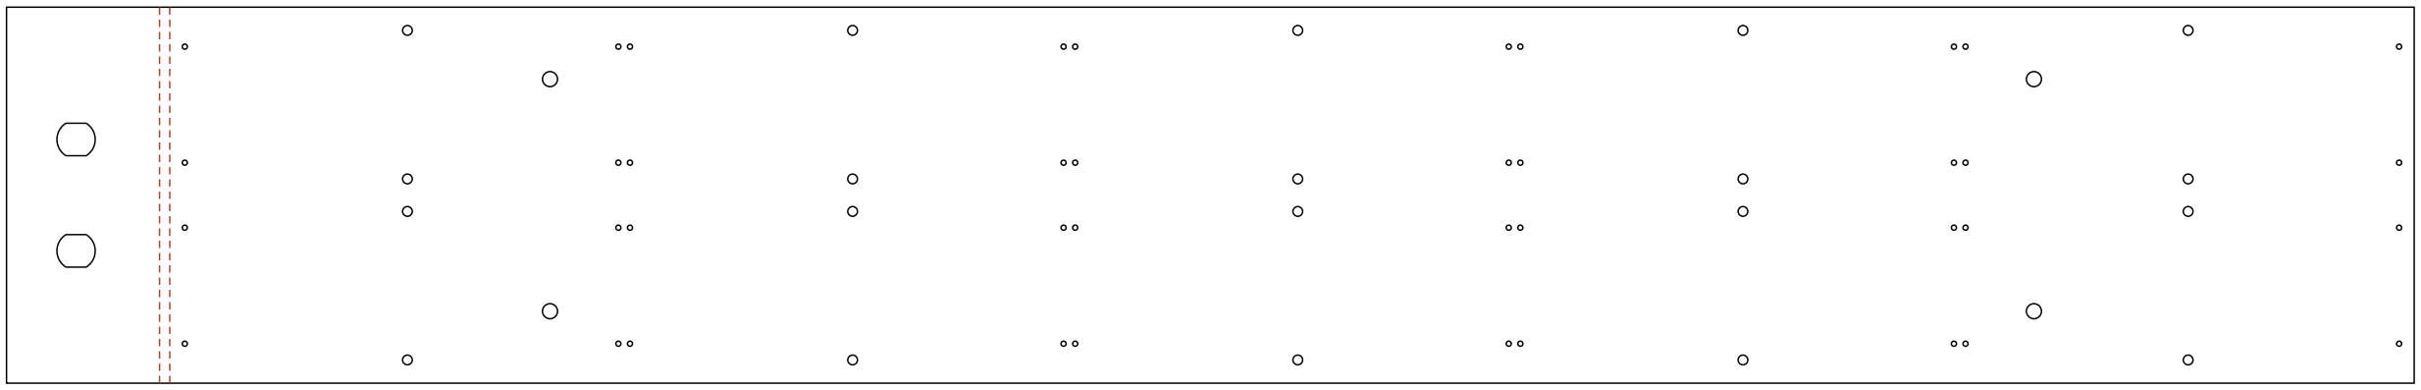
[picture p136: figure]

P2M21 R18 • 10/11/2026 • mm • confirmar tolerâncias e ferramental antes de fabricar | Prancha 2 / 3

Comprimento 1038.398 • largura 162 • espessura 2 • vista em escala 1:3

Material nominal: alumínio 5052; têmpera e acabamento pendentes.

Dobra 90°, Ri=2; K=0,4 assumido; BA=4.398230. Confirmar em oficina.

DXF CORTE: 67 contornos, unidades mm, 1:1. DXF DOBRA separado.

Furação: 20 × Ø4,2 + 40 × Ø2,2 + 4 × Ø6,5 + 2 duplo-D Ø16,5 / planos 14.

Origem: centro da face plana do refletor. Base desenvolve no sentido X negativo.

Furos N: X plano=-524.398230; Y=±24. Na peça dobrada: Z=−40.

Coordenadas completas: furacao_refletor_PRELIMINAR.csv. Não aplicar compensação de corte duas vezes.

03 — Grampo POM e base dos conectores | PRELIMINAR

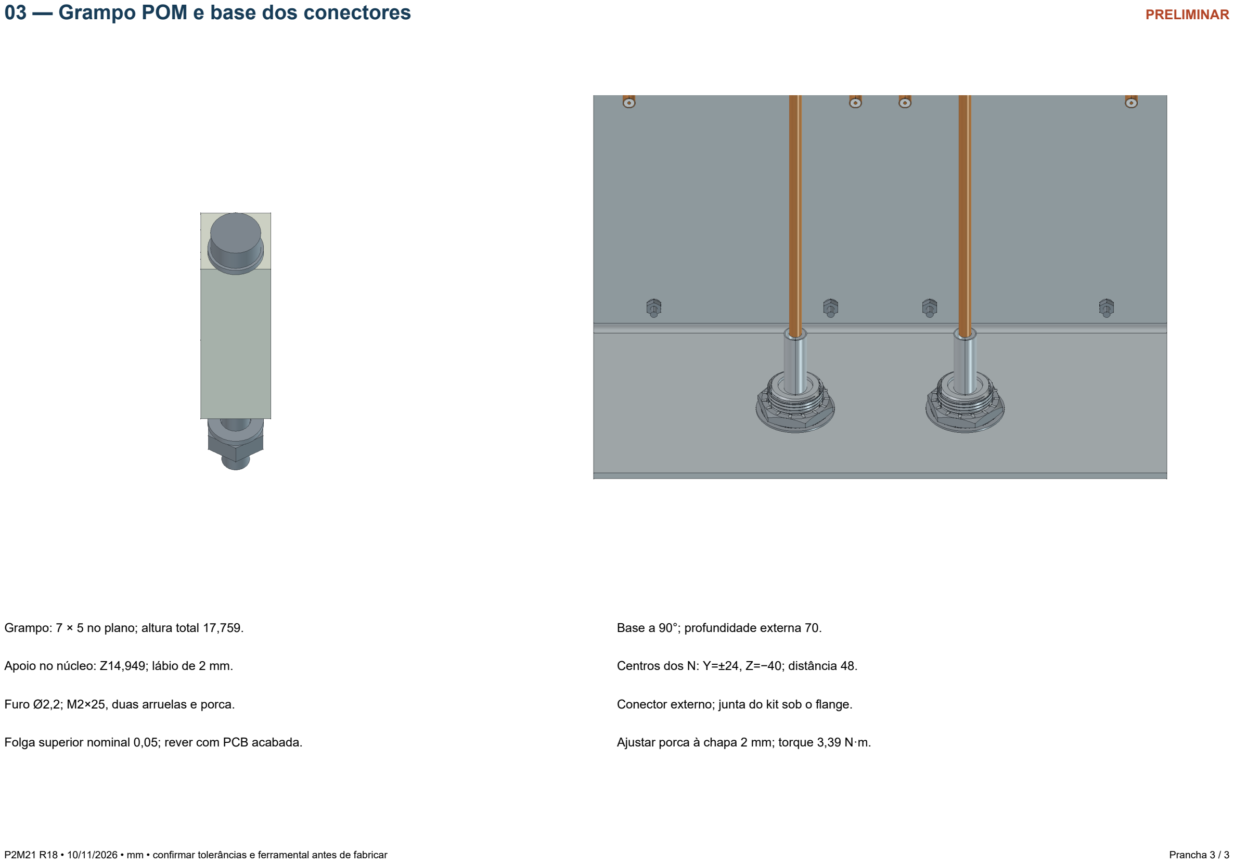
[picture p137: page 3]

P2M21 R18 • 10/11/2026 • mm • confirmar tolerâncias e ferramental antes de fabricar | Prancha 3 / 3

Grampo: 7 × 5 no plano; altura total 17,759.

Apoio no núcleo: Z14,949; lábio de 2 mm.

Furo Ø2,2; M2×25, duas arruelas e porca.

Folga superior nominal 0,05; rever com PCB acabada.

Base a 90°; profundidade externa 70.

Centros dos N: Y=±24, Z=−40; distância 48.

Conector externo; junta do kit sob o flange.

Ajustar porca à chapa 2 mm; torque 3,39 N·m.
