Gecesars/emb_ant/automacao/r02/README.md

# Reprodução da variante com divisores por grupo

As unidades dos geradores mecânicos são milímetros. O eixo X aponta da base para o topo. O projeto HFSS integrado tem duas portas de 50 Ω nos conectores N e 1 W de potência incidente total, 0,5 W a 0° em cada entrada.

1. Definir `P1H_R02` como pasta de trabalho fora do Git. Executar `radiais.py <P1H_R02>/revisao` com NumPy, SciPy, Shapely e scikit-rf. As geometrias contêm os dois 1:2 e os dois 1:5 de cada grupo com Dk 2,94, tan δ 0,0016 e núcleo de 1,52 mm.
2. Executar `ramais.py <P1H_R02>/revisao/1x5/geometria.json <P1H_R02>/compacta`, `enlaces.py <P1H_R02>/compacta` e `placas.py <P1H_R02>`. Para cada lado, apontar `P1H_RADIAL_DIR` a `<P1H_R02>/placas/Inferior` ou `Superior` e executar o [gerador KiCad](../P1H/Divisor_10X_PTFE/gerar_pcb.py) no Python do KiCad 10. Executar DRC com severidade de erro, gerar sete camadas Gerber, job e furação Excellon e executar `verificar_placas.py <P1H_R02>/placas`. O verificador confere contorno externo, janela interna, coordenadas e diâmetros dos furos.
3. Executar `montagem.py` e `chapa.py` no Python do FreeCAD 1.1. Executar `chapa.py --dxf` com ezdxf e Shapely. Para gravar a apresentação e a imagem nativa, abrir `apresentar.FCMacro` numa instância gráfica separada com `P1H_REPO` apontando à raiz deste repositório. O script `fabricacao.py` reabre a montagem, gera o mapa de soldagem e verifica por reimportação os sete STEP dos suportes.
4. Gerar os STEP de referência da R01 conforme o [procedimento da R01](../r01/README.md). Definir `P1H_CAD_BASE` como a pasta destes STEP e `P1H_R01` como a nova pasta FEM da **R02**, distinta da R01. Criar a subpasta `estudo`, definir `P1H_NOME=P1H_R02` e `P1H_ITERATIVO=1`. Rodar `preparar_em.py` no FreeCAD e [modelo_hfss.py](../r01/modelo_hfss.py) no AEDT 2024 R2 por `-ng -RunScriptAndExit`. O conjunto incorpora as duas placas físicas, o condutor e dielétrico dos 26 cabos, as terminações e o refletor montado. A bobina e suas interfaces são copiadas do lançamento integrado original até 5 mm antes do plano da PCB. O script verifica a união galvânica de capa, pino e espiras em um sólido de cobre por entrada.
5. A validação nativa do modelo deve devolver `1`. Executar `gerar_malha.py` no AEDT para antecipar a malha inicial. O [solver](../r01/resolver.py) configura adaptação, varredura e exportação dos planos YZ e XZ. Medir os resultados com [medir.py](../r01/medir.py). As premissas de condutividade, rugosidade, enchimento interno dos N e polímeros são as mesmas da R01.
6. Para ensaiar os estágios isolados, usar o [construtor do divisor](../P1H/Divisor_10X_PTFE/construir_radial.py) e `resolver_divisor.py` no AEDT, com `P1H_RADIAL_DIR` apontando a cada geometria. O alvo é ΔS ≤ 0,012 em dois passes consecutivos a 5,17 GHz. Exportar as matrizes nas 17 frequências. O ensaio de rede usa o diretório `rede/1x2` para o primeiro estágio e `revisao/1x5` para os divisores de grupo. As duas geometrias do 1:2 são idênticas. `ensaiar_rede.py` fecha as conexões bidirecionais nas quatro linhas e termina as vinte saídas em 50 Ω. Os comprimentos elétricos descontam 1,5 mm por lançamento já contido no FEM de cada placa.

[Mecânica completa e comprimentos](../../freecad/mecanica_R02/README.md) · [Modelo integrado HFSS](../../hfss/antenas/P1H_R02.aedt) · [Cotação](../../resultados/r02/cotacao.md)

[Ensaio da rede nas 17 frequências](../../resultados/r02/rede/README.md) · [Verificação independente das conexões](verificar_rede.py)

## Controle com dez radiadores individuais

A [R02-S](../../hfss/antenas/P1H_R02_10Separadas.aedt) compara as PCBs fabricáveis na mesma montagem externa. A coluna contínua vira dez núcleos RO4350B de 28,3125 × 28,3125 × 0,76 mm. As posições das soldas, o cobre de cada elemento, o refletor único, ambas as redes, os conectores e os 26 cabos vêm da R02. As cinco posições de berço recebem duas guias laterais em POM com bolsões e batentes. As guias retêm as dez PCBs na altura original. A diferença de resultado inclui as guias e o laminado retirado entre os elementos. Esta configuração constitui um controle de RF com montagem nominal. Os arquivos de fabricação e a cotação principal se referem à alternativa contínua.

Para reproduzir, definir `P1H_R02_CAD` como os STEP por material da R02 e `P1H_R01` como outra pasta, destinada apenas ao controle. Executar [separar_radiadores.py](separar_radiadores.py) no Python do FreeCAD com essas variáveis. Ele verifica os dez sólidos do laminado e a ausência de penetração das guias nas placas. Criar `estudo` na pasta de destino, definir `P1H_NOME=P1H_R02_10Separadas` e executar os mesmos scripts nativos de modelagem e solução. Para a campanha de bancada com um único painel pesado por vez, a R02 e a R02-S têm bases FEM de ordem zero (`P1H_ORDEM=0`) e alvo de ΔS de 0,015. A referência R01 usa a ordem mista (`P1H_ORDEM=-1`). Avaliar também a estabilidade de ganho e abertura e os avisos de solução ao qualificar os resultados.
