Gecesars/emb_ant/freecad/mecanica_R01/07_Verso.png

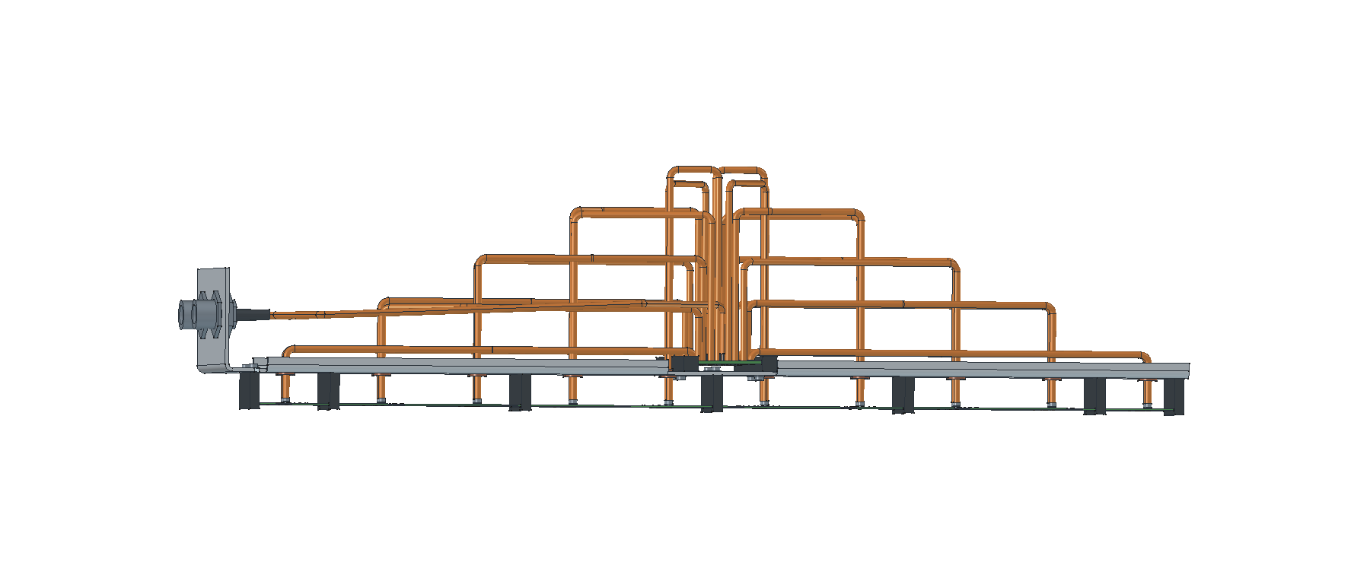
freecad/mecanica_R01/07_Verso.png
