Gecesars/emb_ant/freecad/mecanica_R06/frente.png

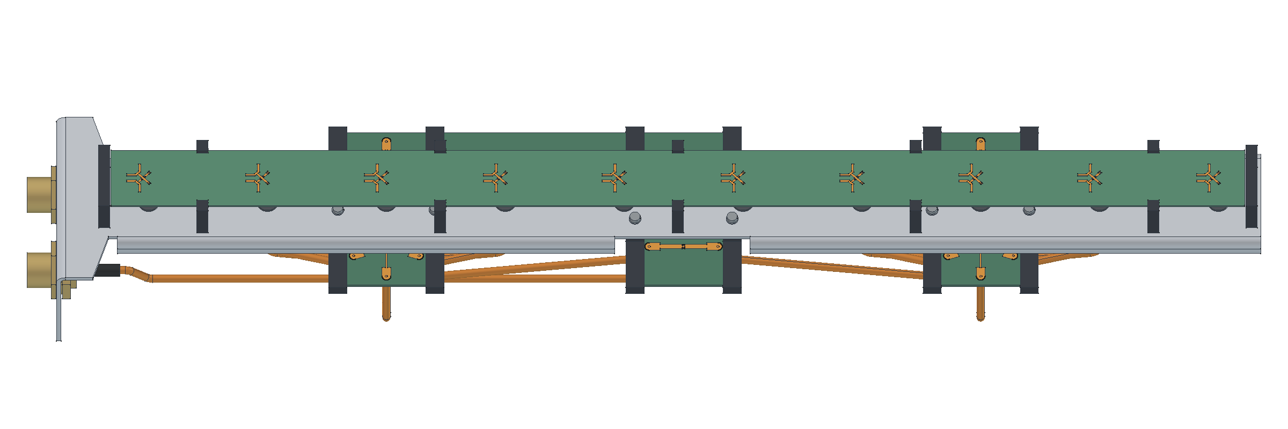
freecad/mecanica_R06/frente.png
