Gecesars/emb_ant/projetos/P2M21/dois_verticais_divisor/variantes/v00_terra6/layout.png

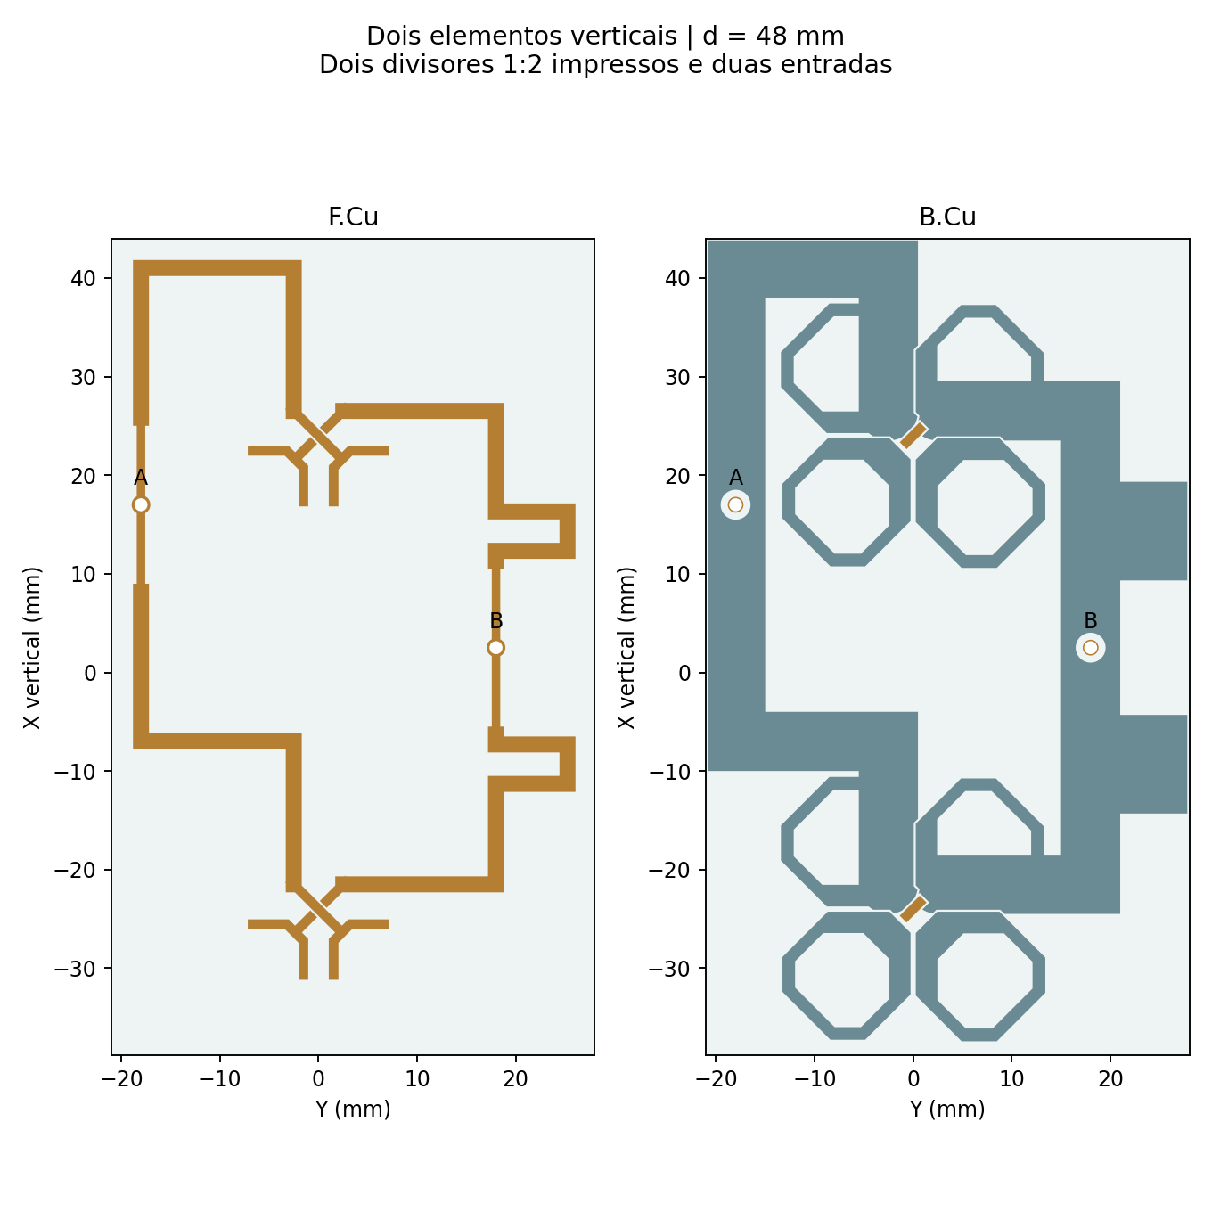
projetos/P2M21/dois_verticais_divisor/variantes/v00_terra6/layout.png
