Gecesars/emb_ant/projetos/P2M21/imagens/pcb_duas_faces.png

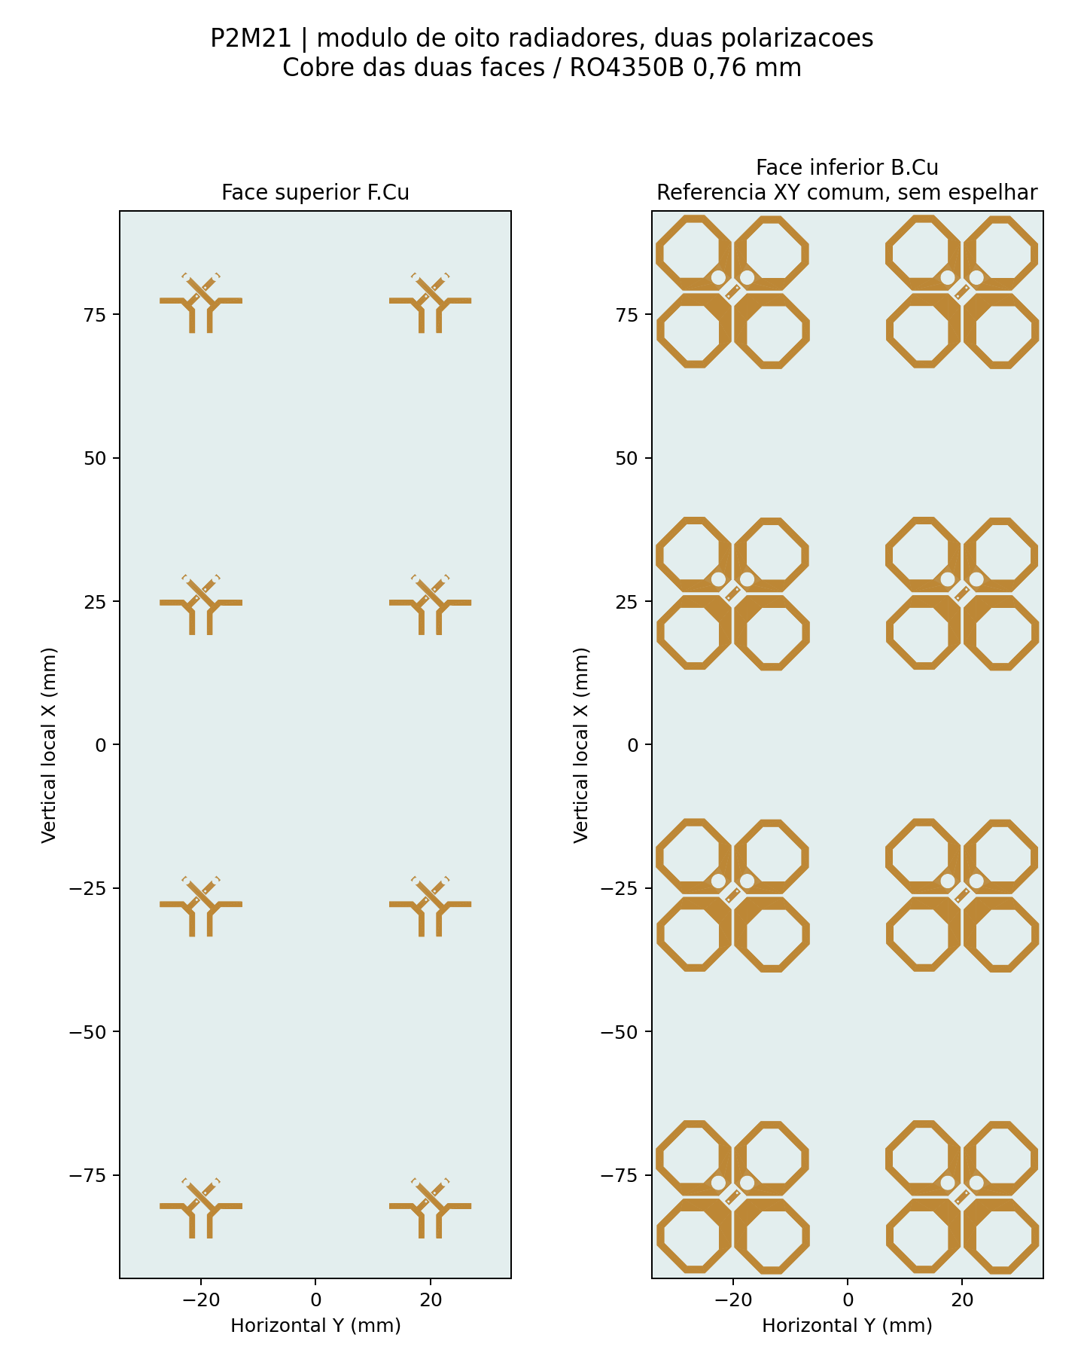
projetos/P2M21/imagens/pcb_duas_faces.png
