Gecesars/emb_ant/projetos/P2M21/kicad/4_elementos/preview/4_elementos.png

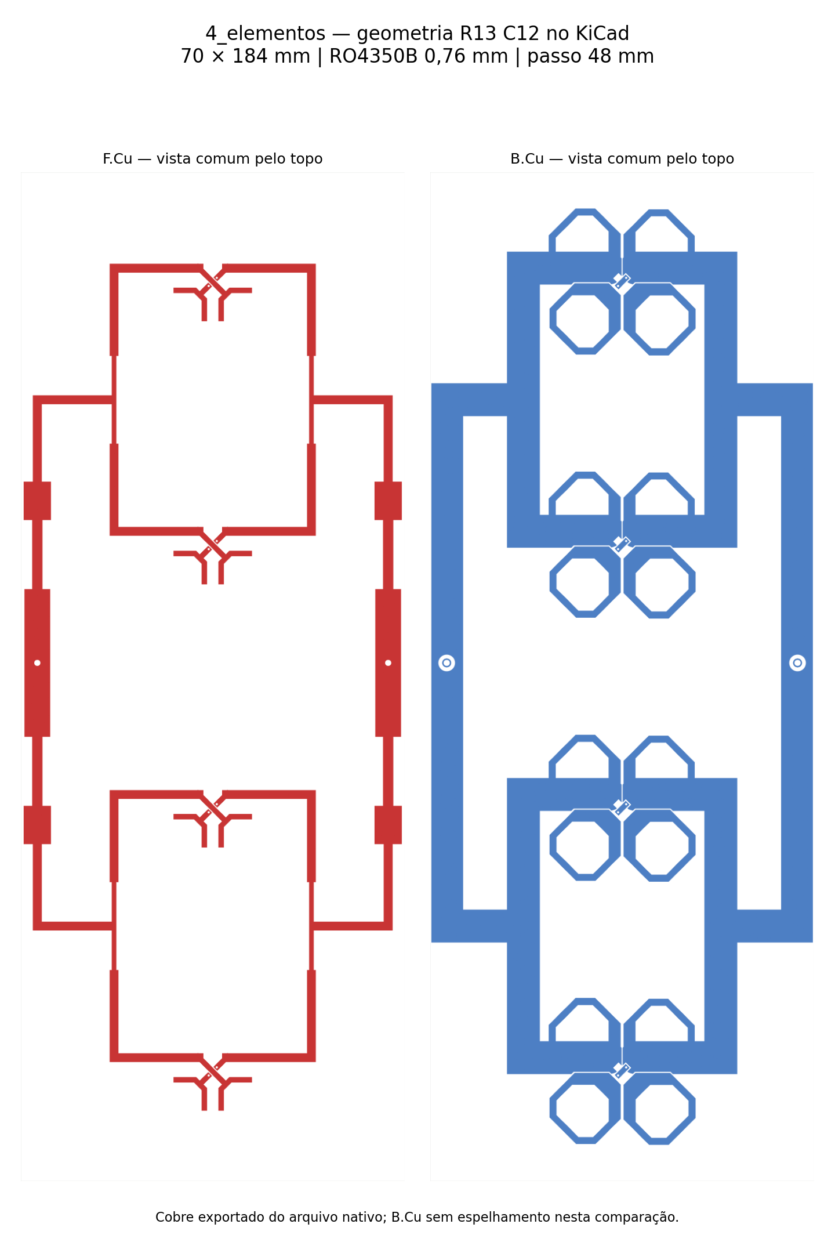
projetos/P2M21/kicad/4_elementos/preview/4_elementos.png
