Gecesars/emb_ant/projetos/P2M21/mecanica_preliminar_R18/imagens/cabo_secao.png

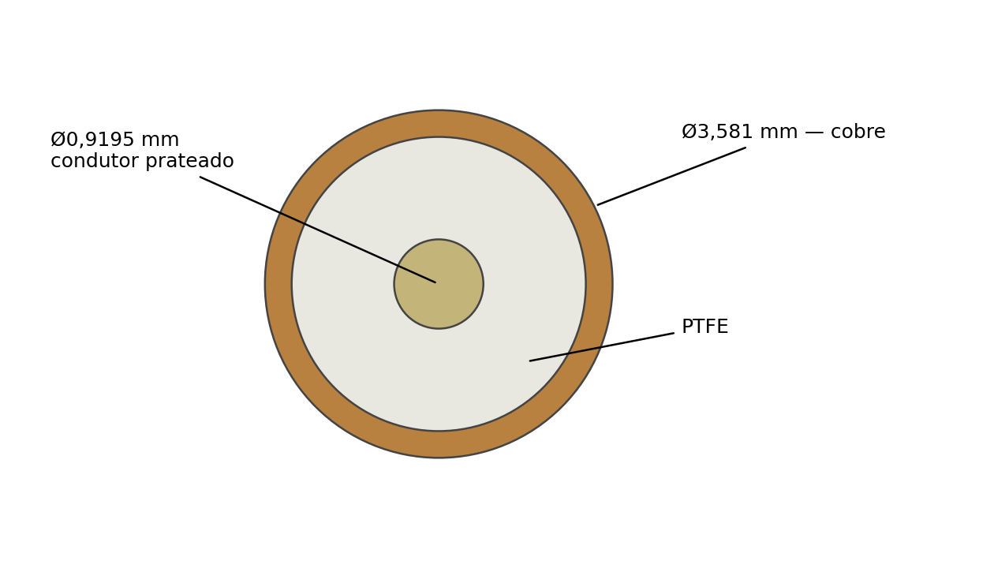
projetos/P2M21/mecanica_preliminar_R18/imagens/cabo_secao.png
