Gecesars/emb_ant/projetos/P2M21/mecanica_preliminar_R18/imagens/chapa_plana.png

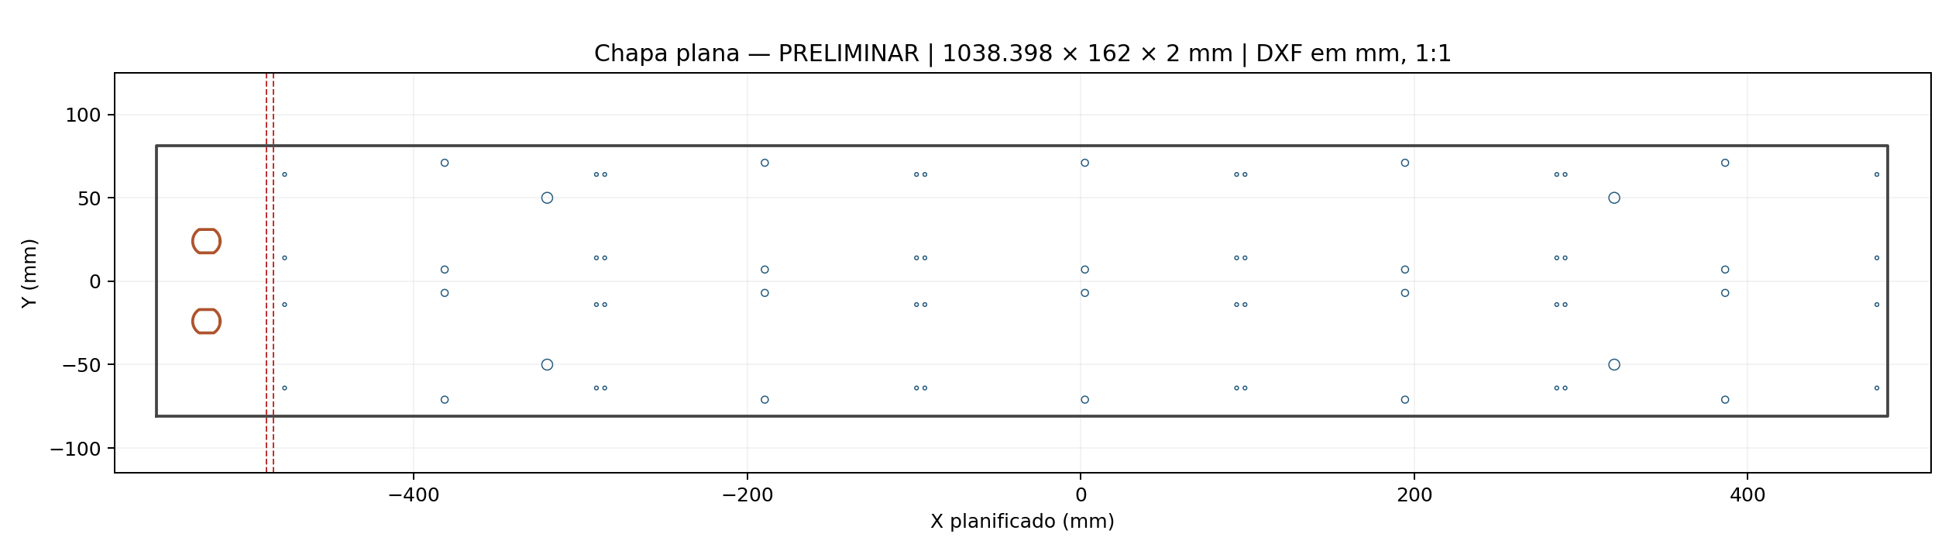
projetos/P2M21/mecanica_preliminar_R18/imagens/chapa_plana.png
