Gecesars/emb_ant/projetos/P2M21/mecanica_preliminar_R18/imagens/fixacao_pom.png

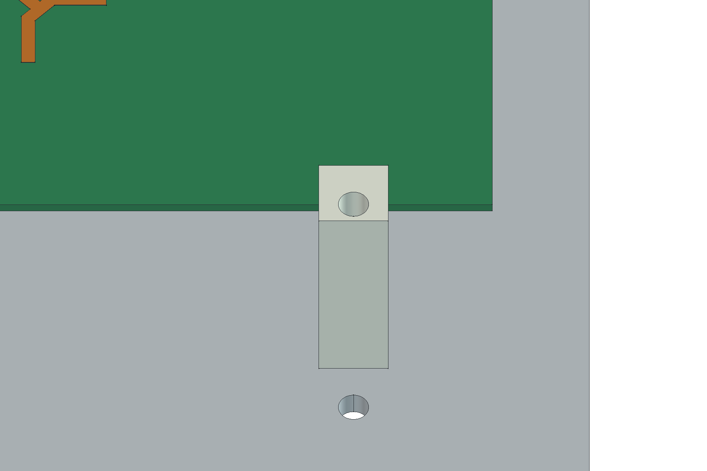
projetos/P2M21/mecanica_preliminar_R18/imagens/fixacao_pom.png
