Gecesars/emb_ant/projetos/P2M21/mecanica_preliminar_R18/imagens/pcb_frente.png

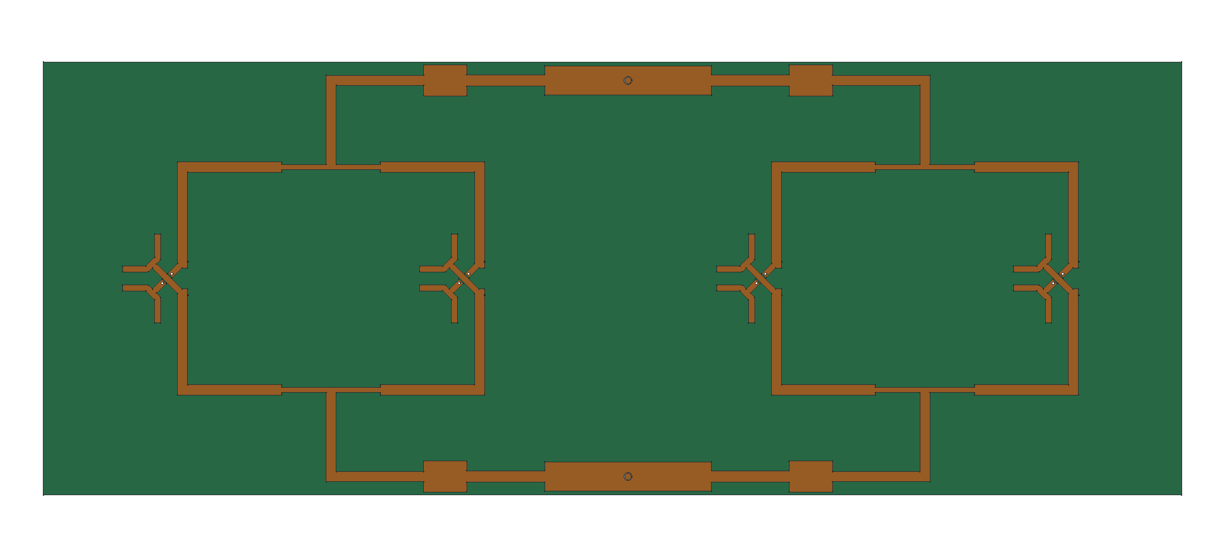
projetos/P2M21/mecanica_preliminar_R18/imagens/pcb_frente.png
