Gecesars/emb_ant/projetos/P2M21/mecanica_preliminar_R18/imagens/refletor_dobrado.png

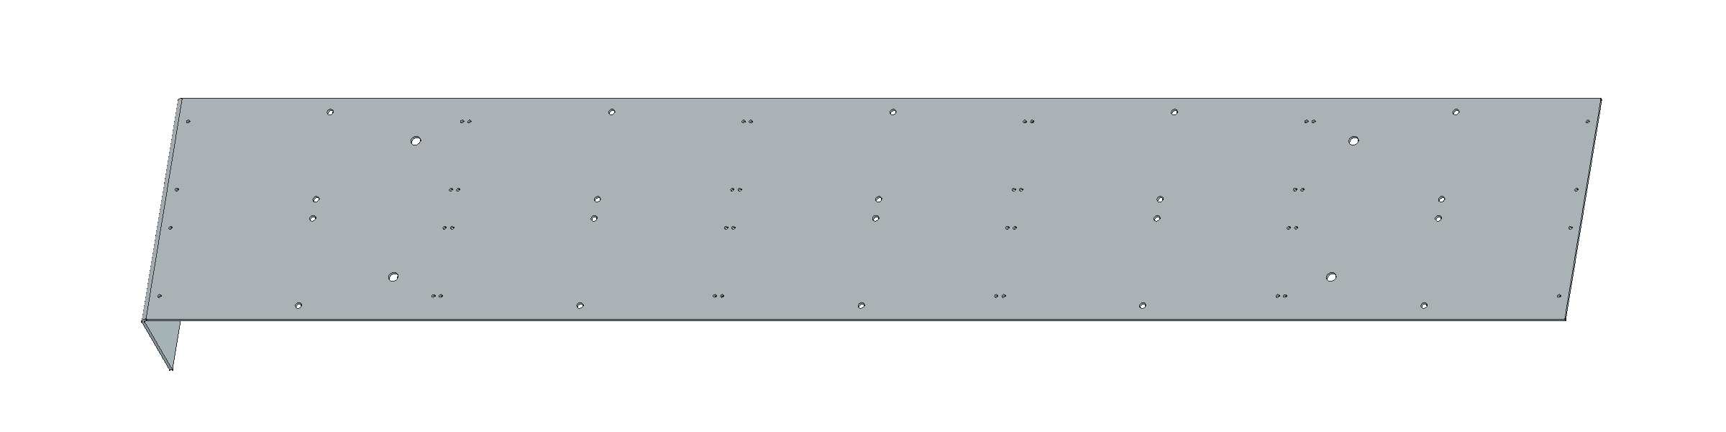
projetos/P2M21/mecanica_preliminar_R18/imagens/refletor_dobrado.png
