Gecesars/emb_ant/projetos/P2M21/oito_celulas_4_elementos/estimativa_inicial.png

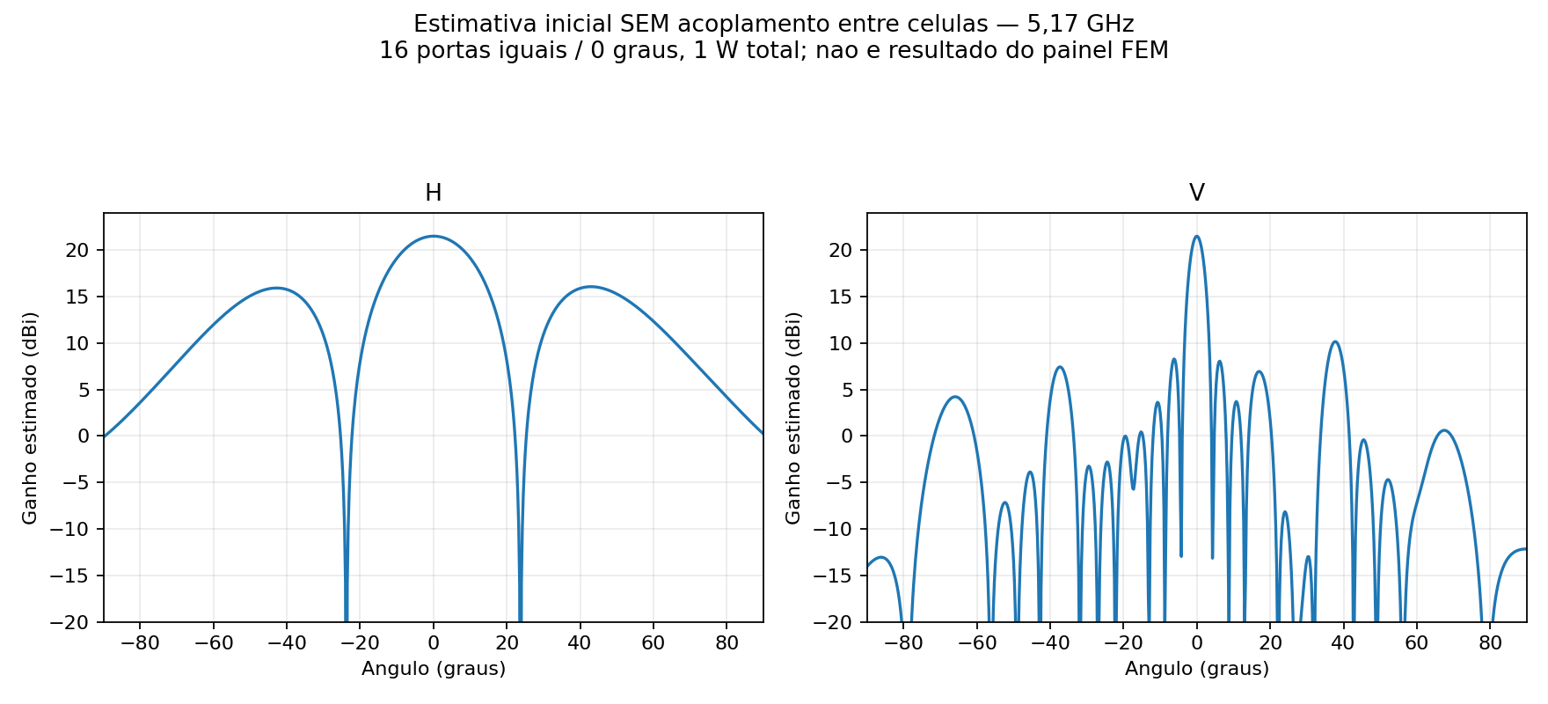
projetos/P2M21/oito_celulas_4_elementos/estimativa_inicial.png
