Gecesars/emb_ant/projetos/P2M21/planejamento/predimensionamento.png

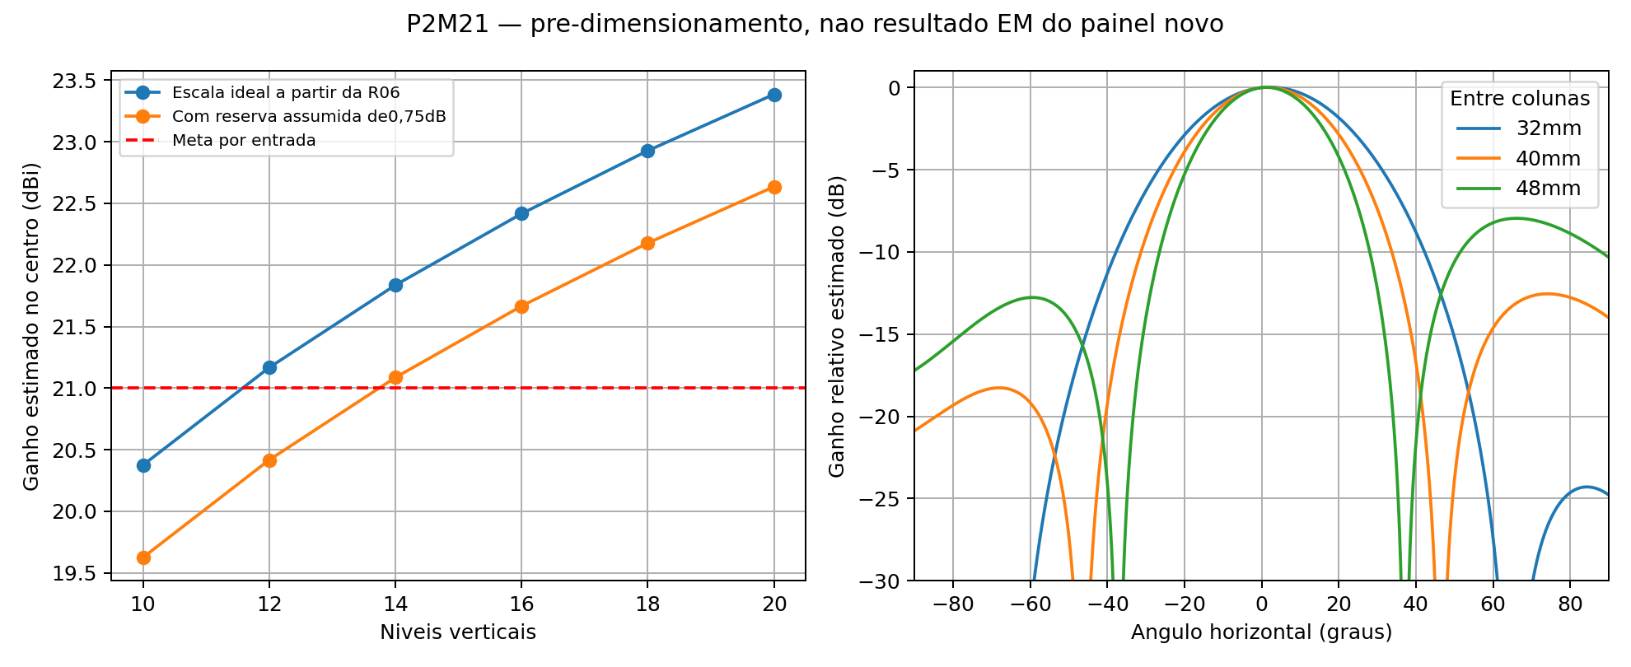
projetos/P2M21/planejamento/predimensionamento.png
