Gecesars/emb_ant/projetos/P2M21/quatro_elementos_8passes_fast/centro/diagramas_HV.png

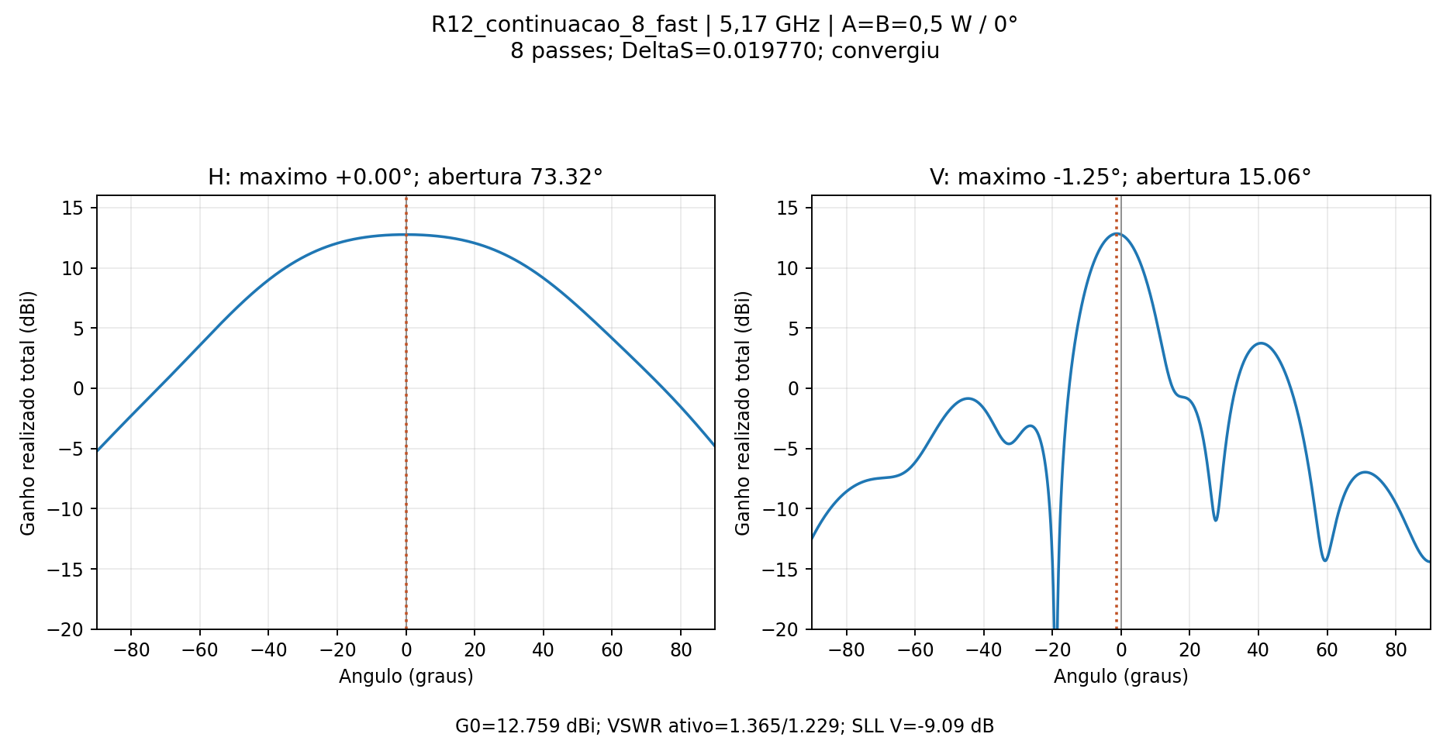
projetos/P2M21/quatro_elementos_8passes_fast/centro/diagramas_HV.png
