Gecesars/emb_ant/projetos/P2M21/quatro_elementos_ajuste/espacamento_ideal.png

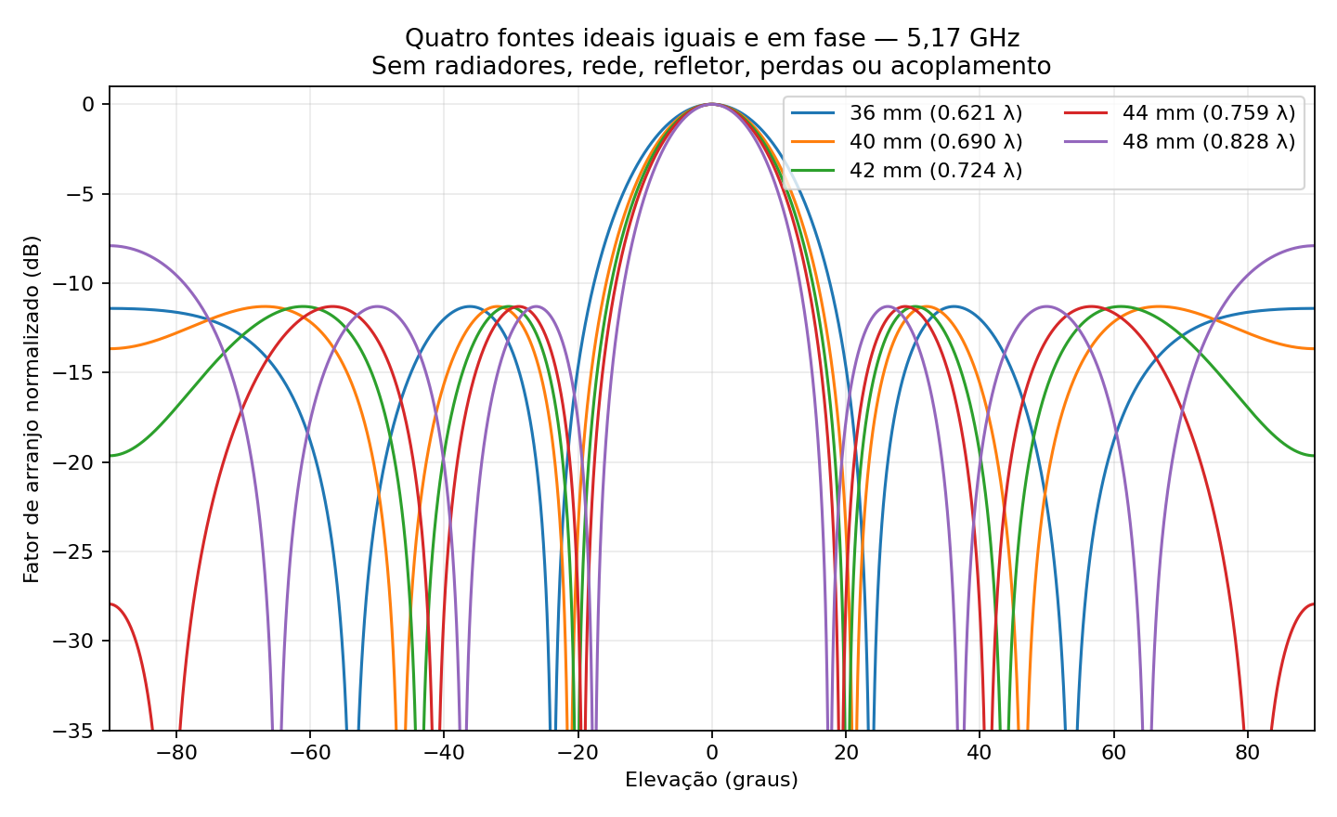
projetos/P2M21/quatro_elementos_ajuste/espacamento_ideal.png
