Gecesars/emb_ant/projetos/P2M21/quatro_elementos_casamento_banda/c11_raiz_largura/diagramas_HV.png

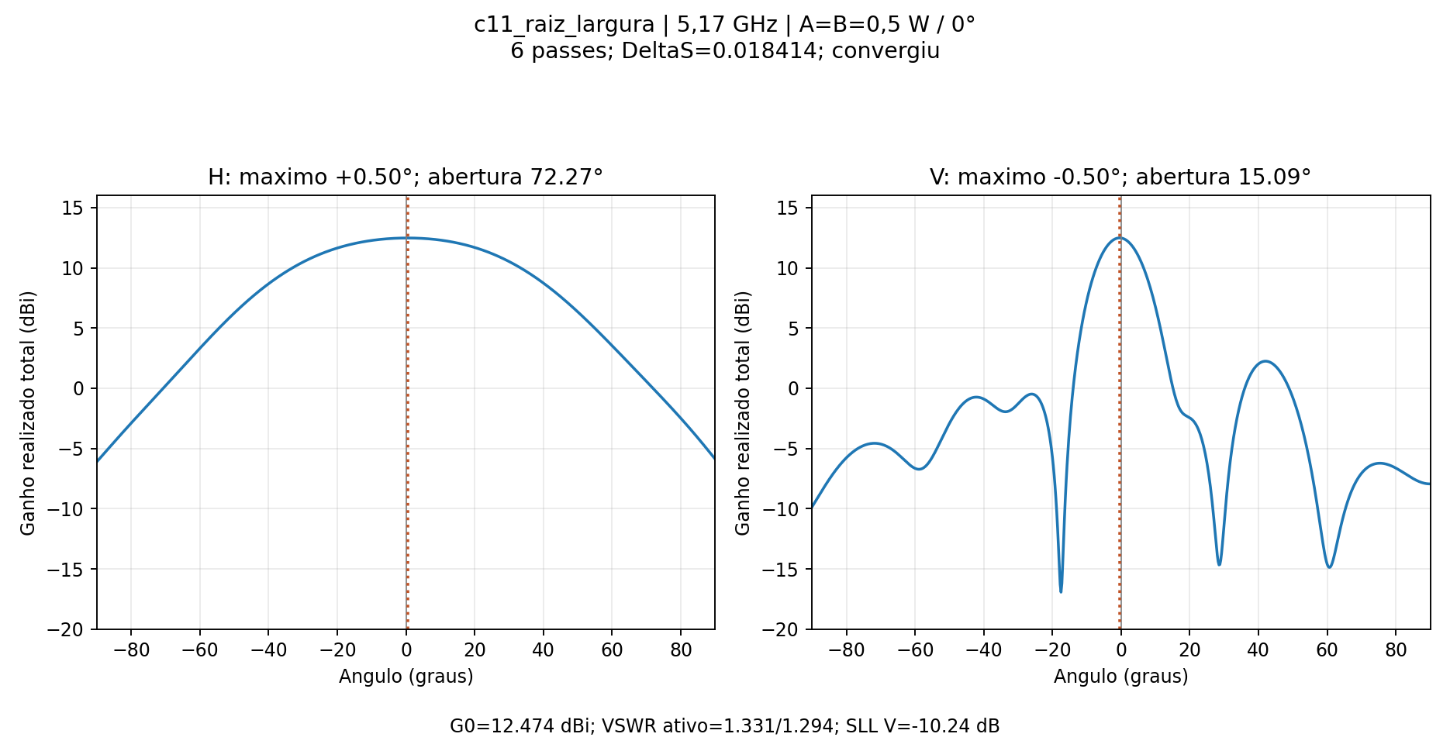
projetos/P2M21/quatro_elementos_casamento_banda/c11_raiz_largura/diagramas_HV.png
