Gecesars/emb_ant/projetos/P2S13/compacto_c09/c00/visual/isometrica.png

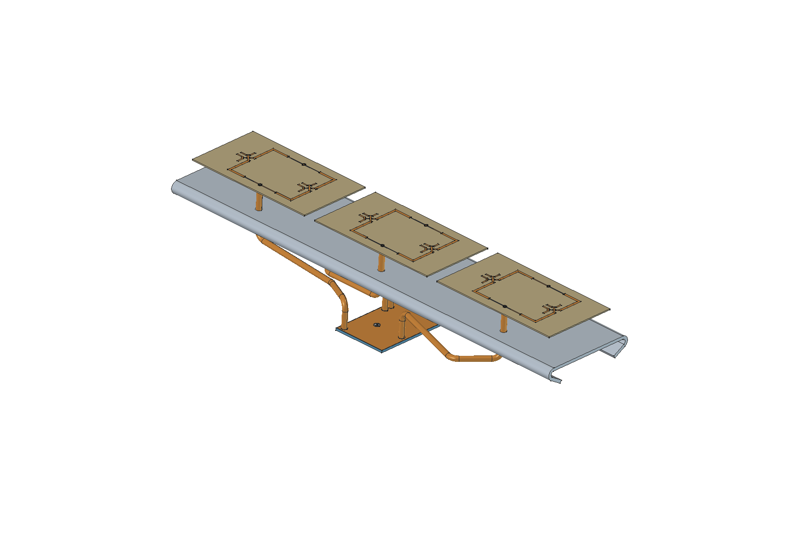
projetos/P2S13/compacto_c09/c00/visual/isometrica.png
