Gecesars/emb_ant/projetos/P2S13/comparacao_HV.png

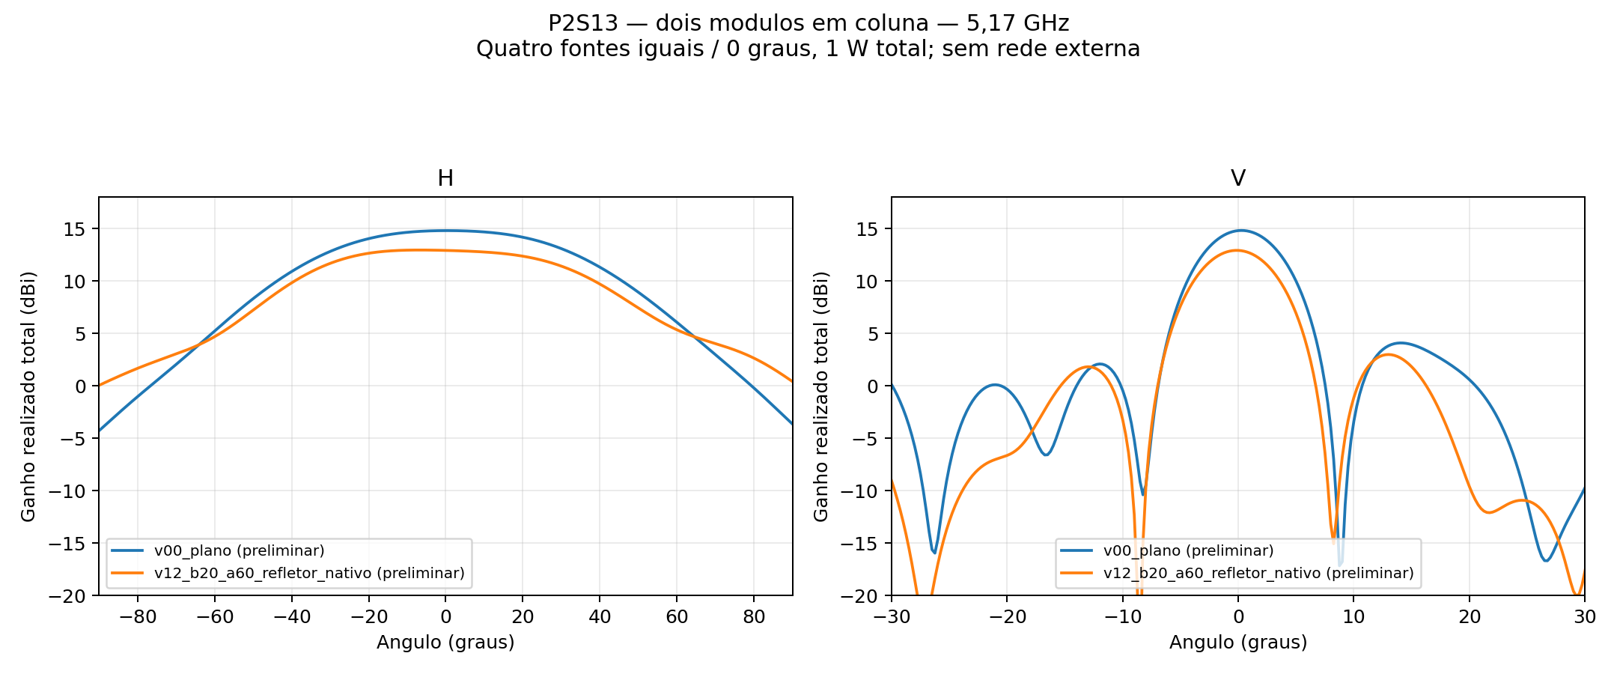
projetos/P2S13/comparacao_HV.png
