Gecesars/emb_ant/projetos/P2S13/comparacao_normalizada.png

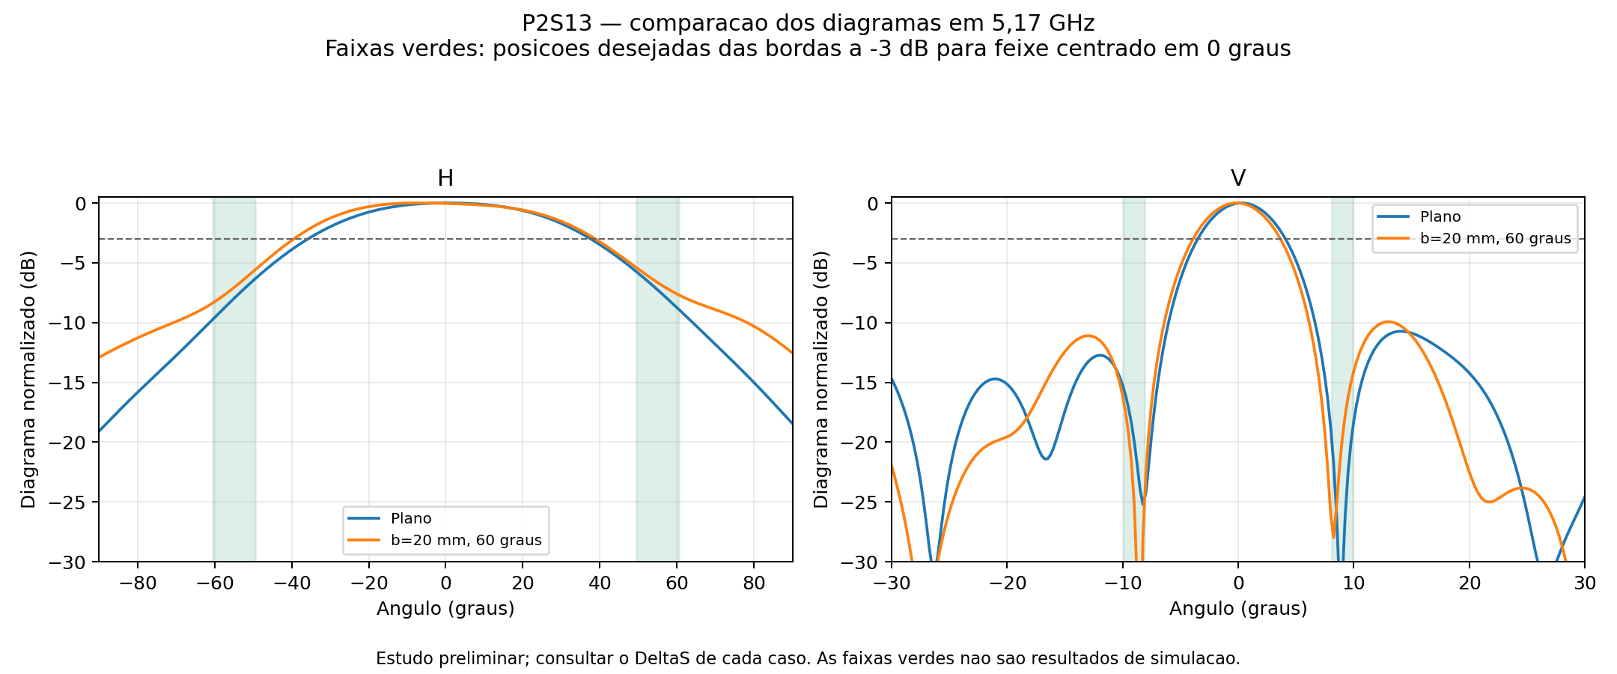
projetos/P2S13/comparacao_normalizada.png
