Gecesars/emb_ant/projetos/P2S13/continuacao_placa2/diagramas_HV.png

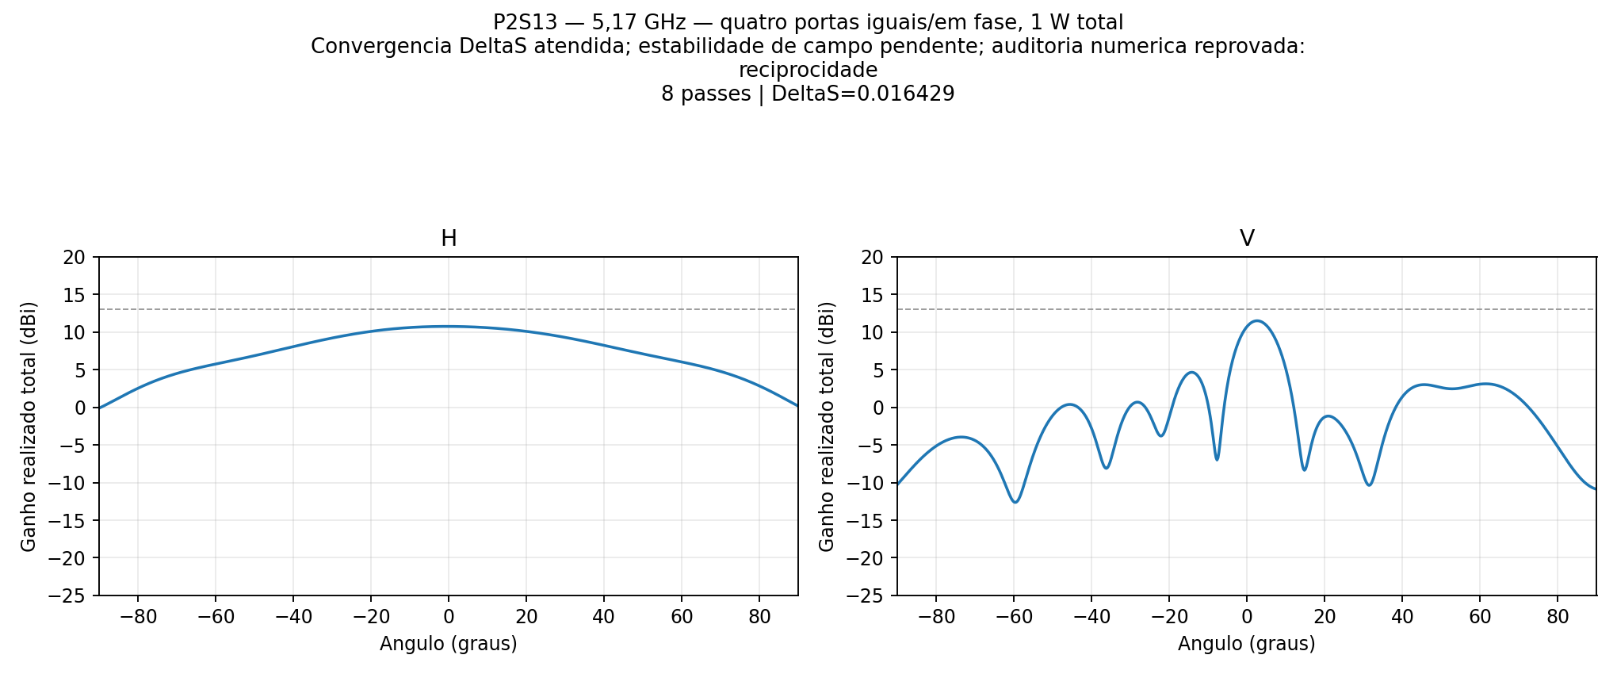
projetos/P2S13/continuacao_placa2/diagramas_HV.png
