Gecesars/emb_ant/projetos/P2S13/continuacao_tres_placas2/diagramas_HV.png

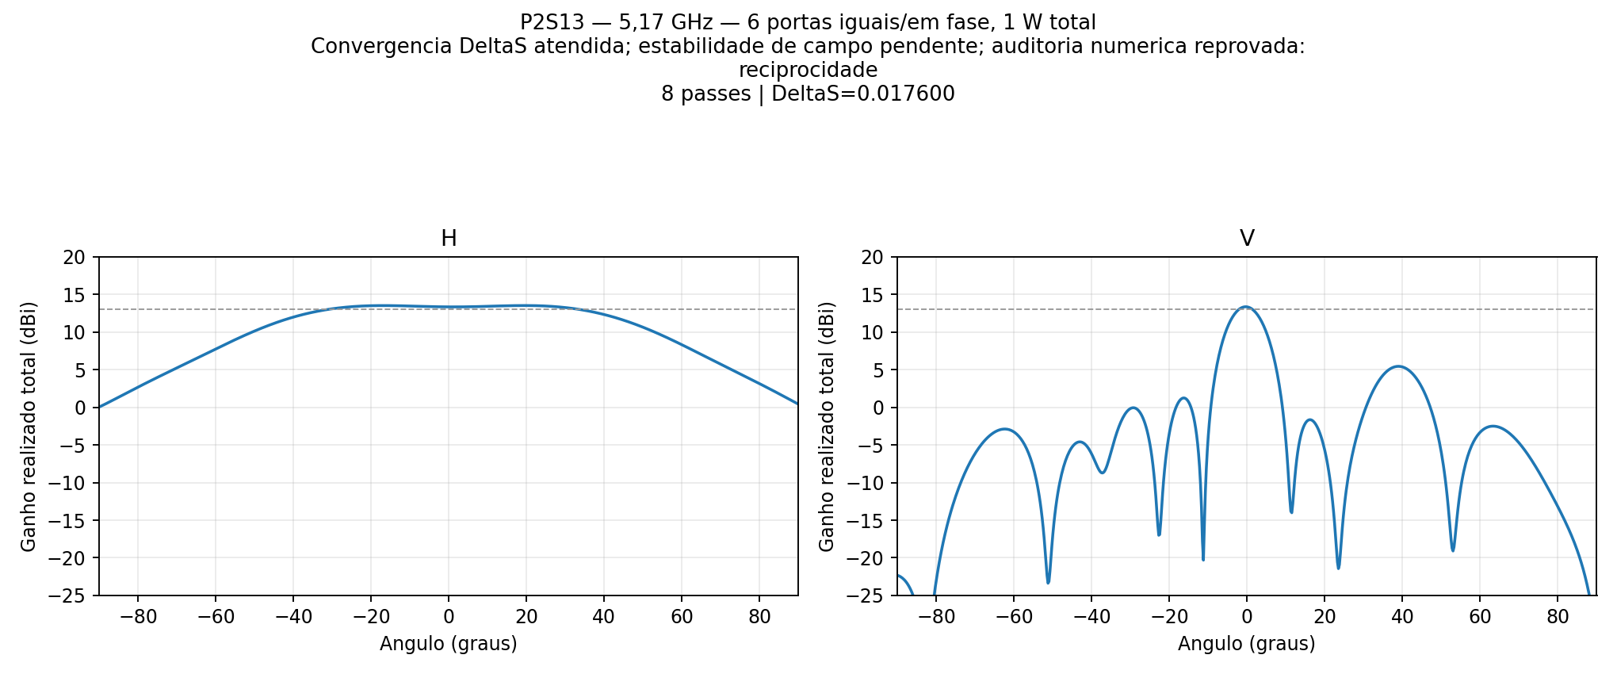
projetos/P2S13/continuacao_tres_placas2/diagramas_HV.png
