Gecesars/emb_ant/projetos/P2S13/divisor_duplo_1x3_correcao/c00_direto/layout.png

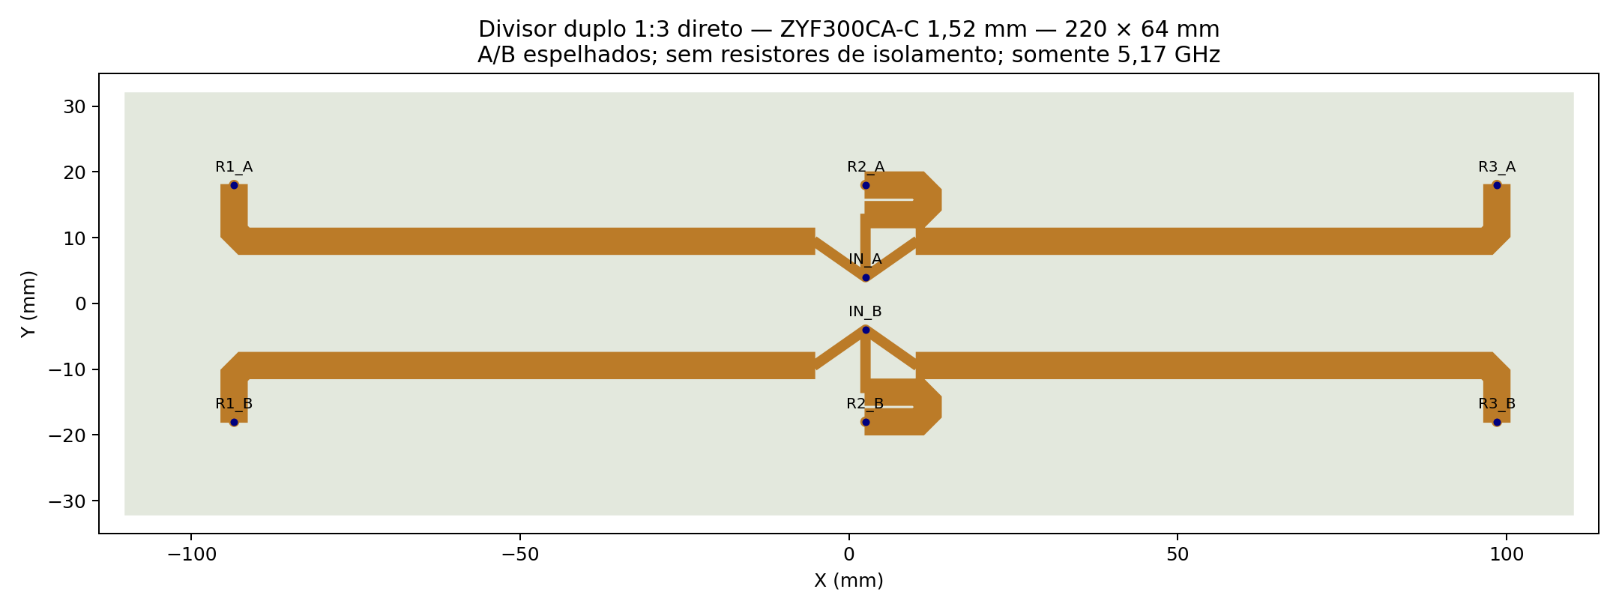
projetos/P2S13/divisor_duplo_1x3_correcao/c00_direto/layout.png
