Gecesars/emb_ant/projetos/P2S13/divisor_duplo_1x3_correcao/c02_fase/balanceamento.png

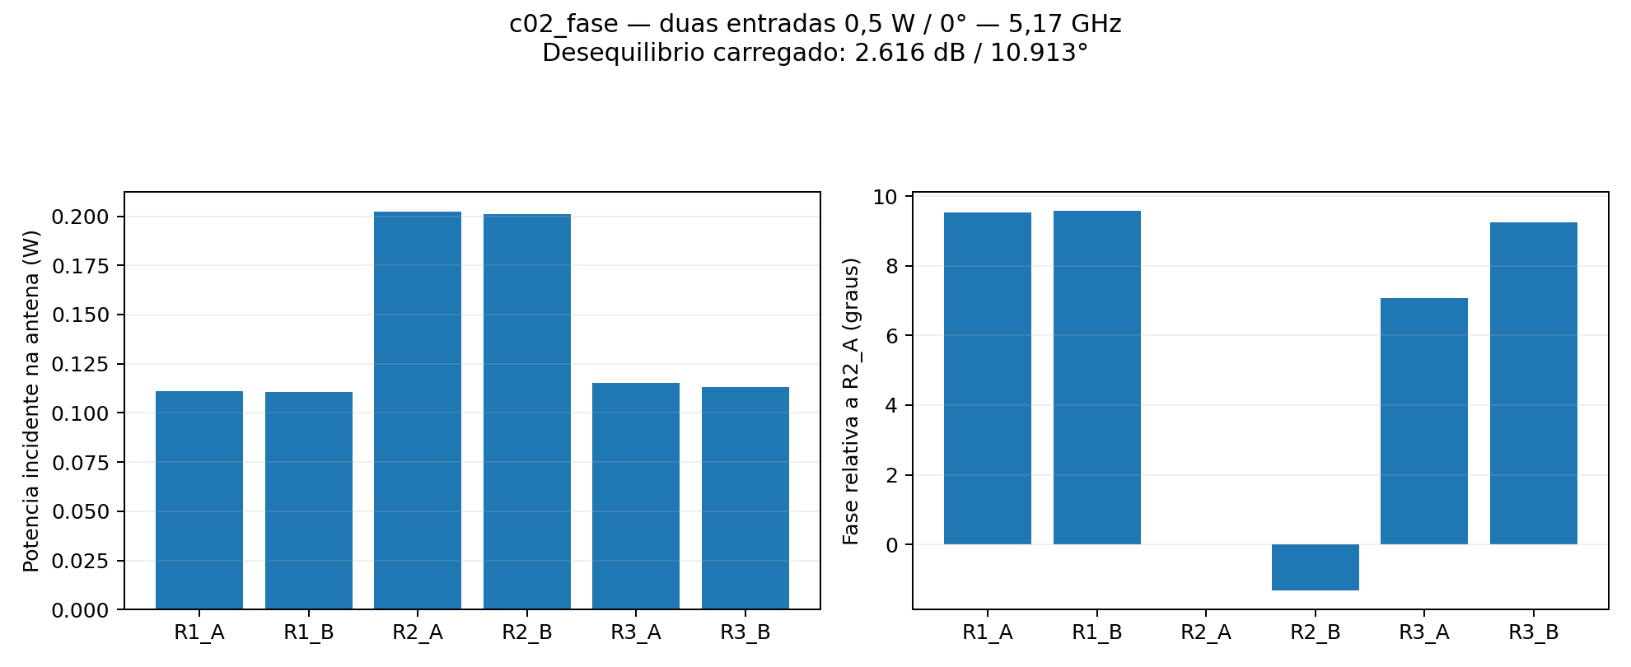
projetos/P2S13/divisor_duplo_1x3_correcao/c02_fase/balanceamento.png
