Gecesars/emb_ant/projetos/P2S13/divisor_duplo_1x3_correcao/c03_ordem2/balanceamento.png

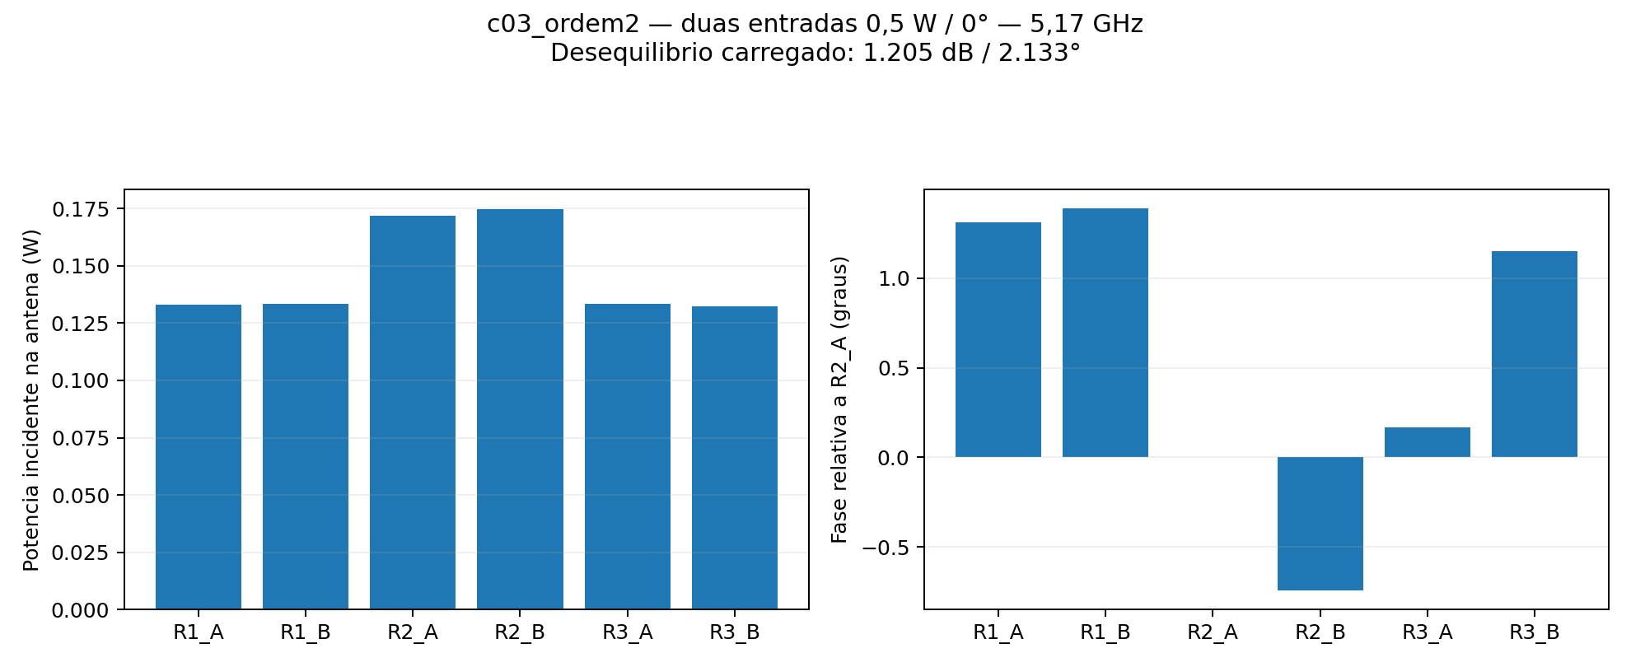
projetos/P2S13/divisor_duplo_1x3_correcao/c03_ordem2/balanceamento.png
