Gecesars/emb_ant/projetos/P2S13/divisor_duplo_1x3_correcao/c04_mascara/layout.png

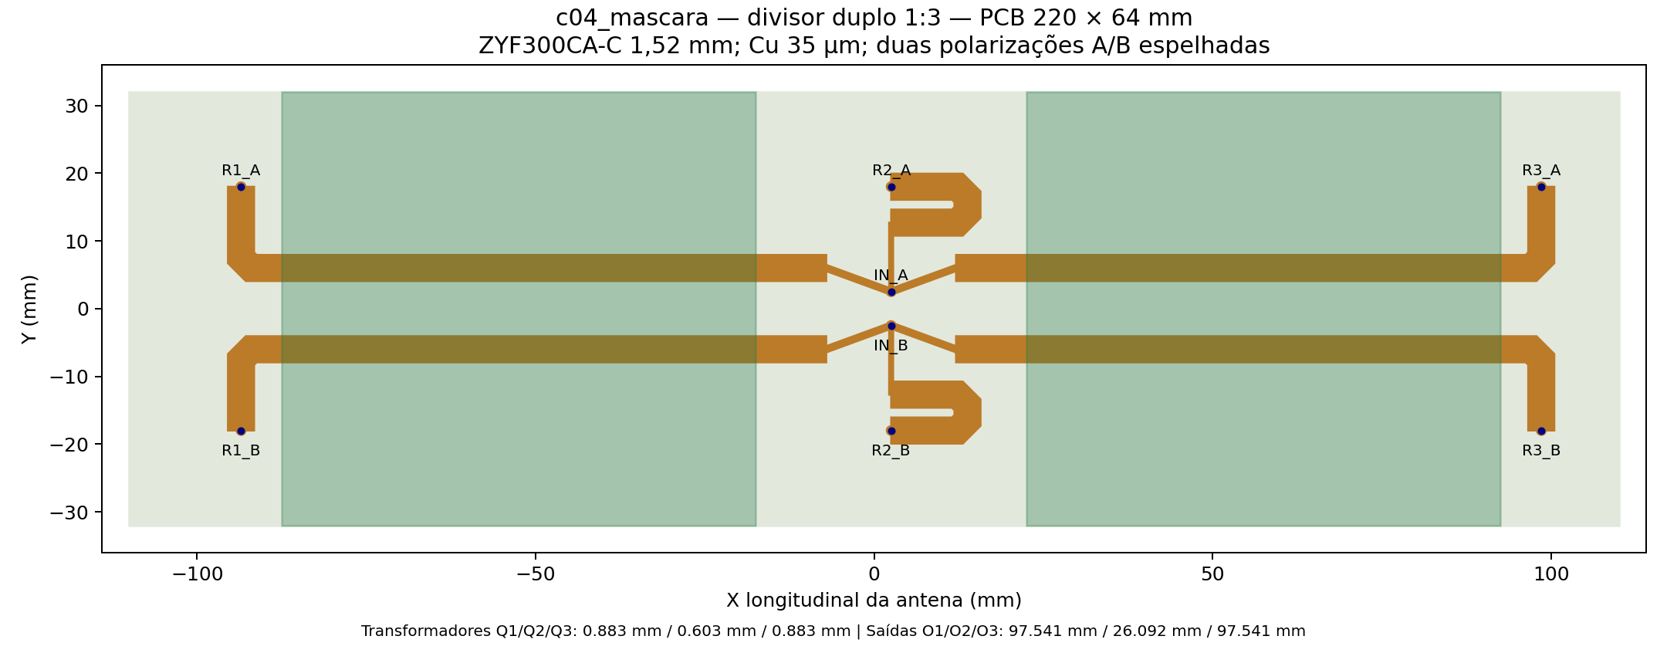
projetos/P2S13/divisor_duplo_1x3_correcao/c04_mascara/layout.png
