Gecesars/emb_ant/projetos/P2S13/divisor_duplo_1x3_hfss/inicial/distribuicao.png

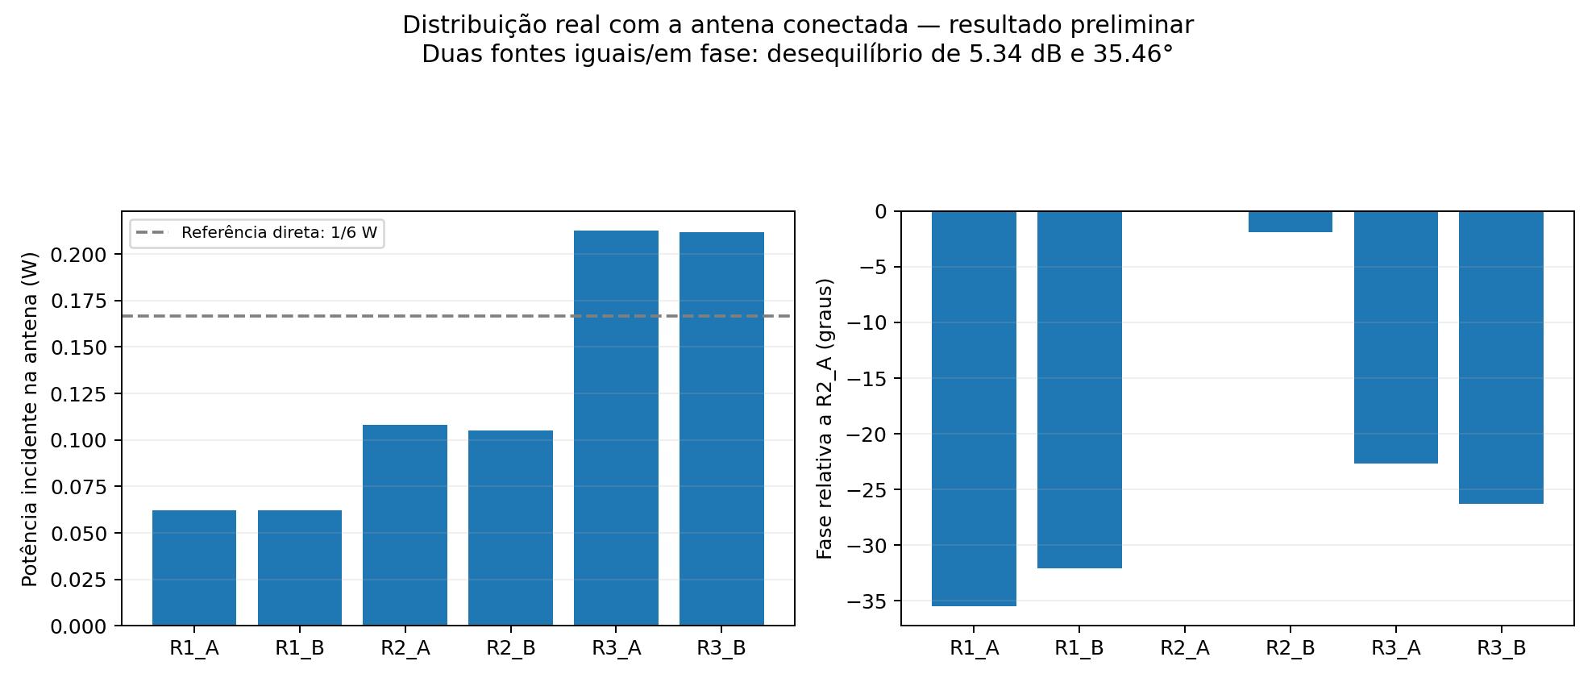
projetos/P2S13/divisor_duplo_1x3_hfss/inicial/distribuicao.png
