Gecesars/emb_ant/projetos/P2S13/dobras_placas_ajustadas/d00_b3_a90/diagramas_HV.png

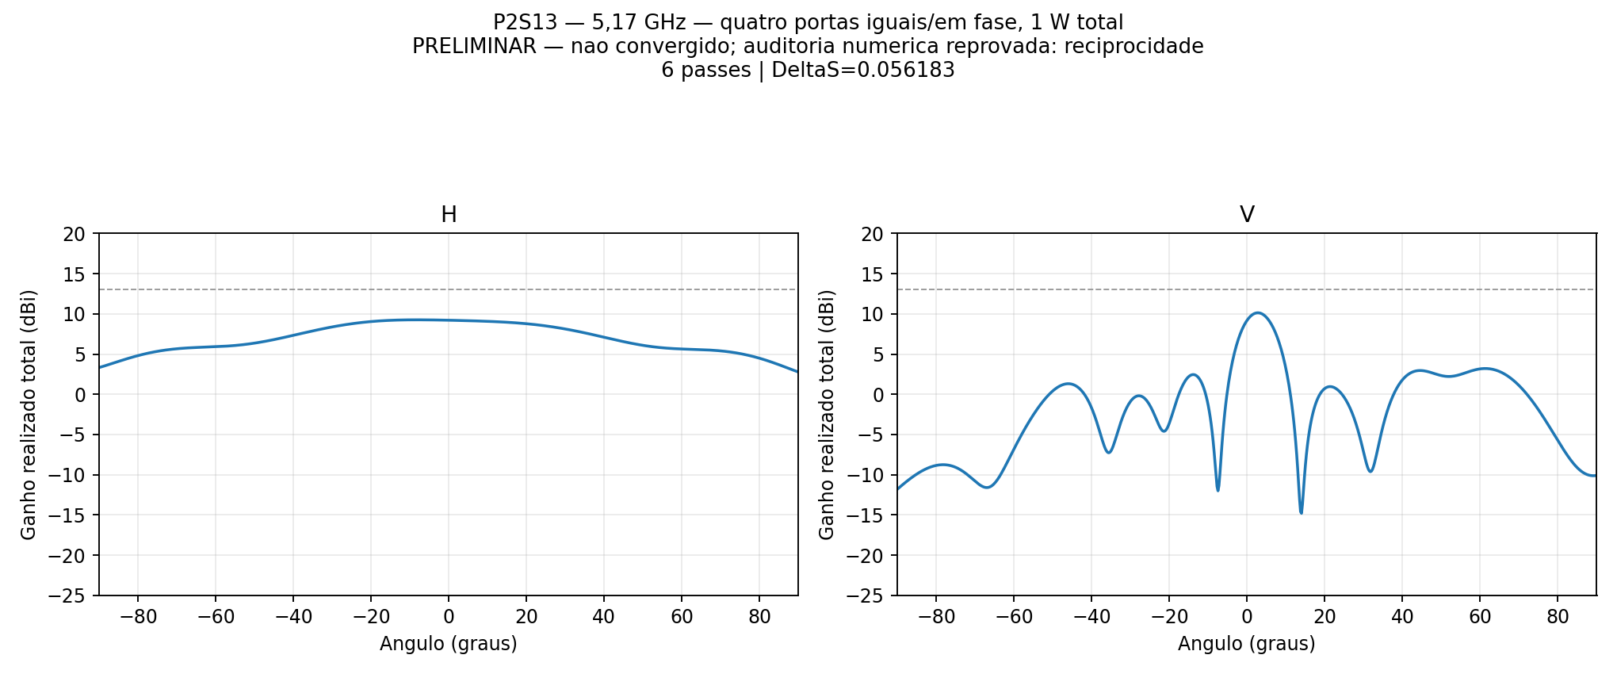
projetos/P2S13/dobras_placas_ajustadas/d00_b3_a90/diagramas_HV.png
