Gecesars/emb_ant/projetos/P2S13/dobras_placas_ajustadas/d02_b20_a150/diagramas_HV.png

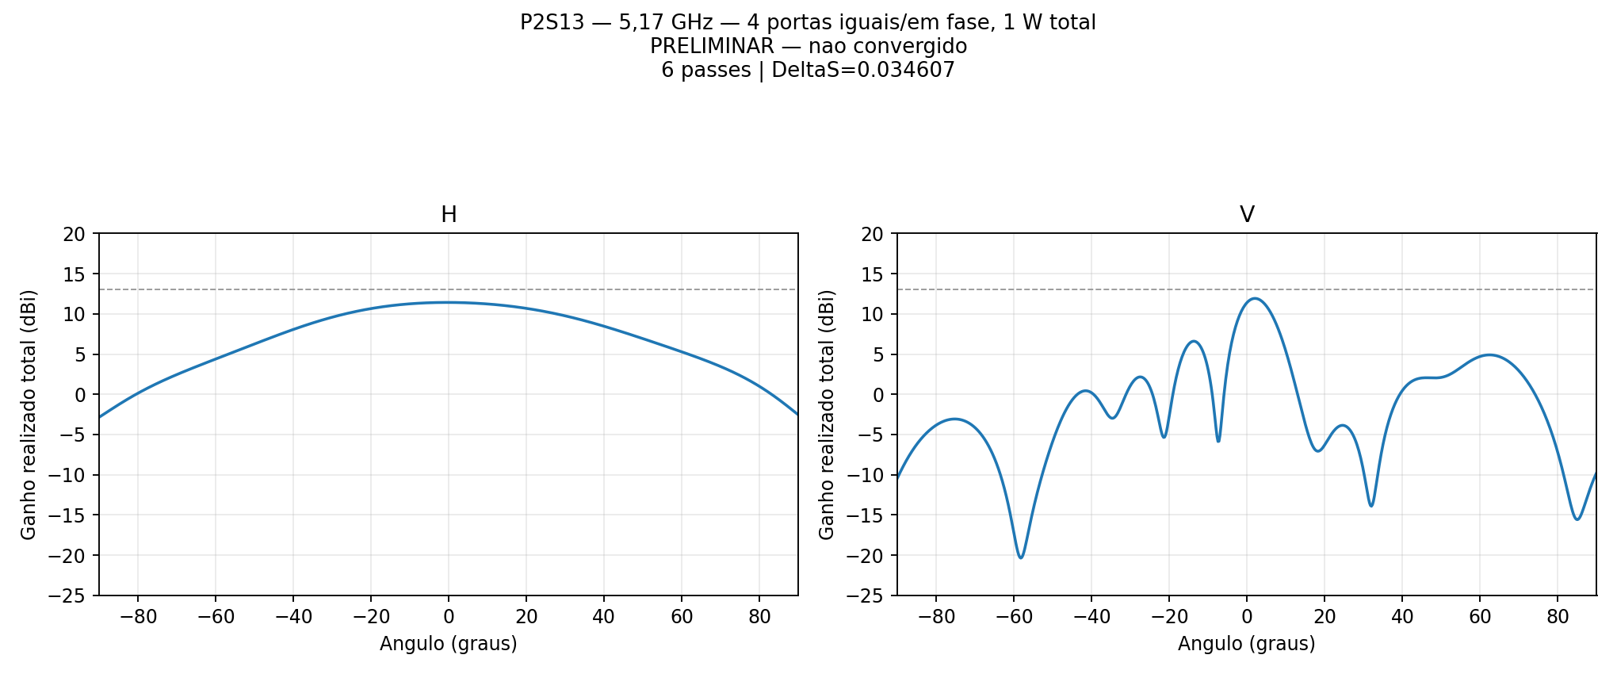
projetos/P2S13/dobras_placas_ajustadas/d02_b20_a150/diagramas_HV.png
