Gecesars/emb_ant/projetos/P2S13/kicad/conjunto_R12/placa2_M00/preview/2_elementos-B_Cu.png

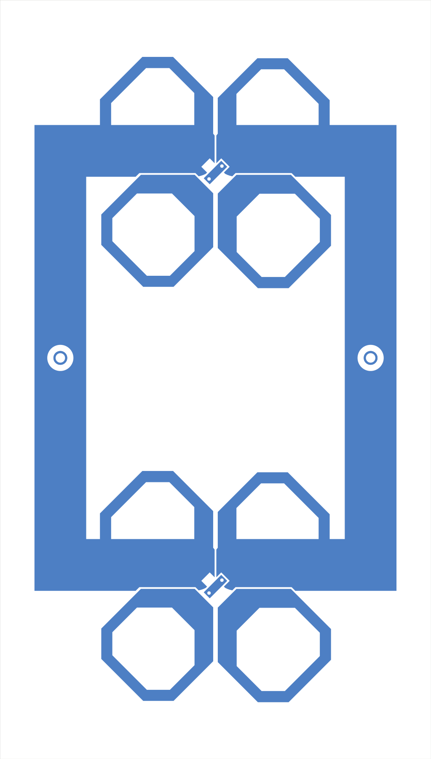
projetos/P2S13/kicad/conjunto_R12/placa2_M00/preview/2_elementos-B_Cu.png
