Gecesars/emb_ant/projetos/P2S13/mecanica_R12/imagens/03_frontal.png

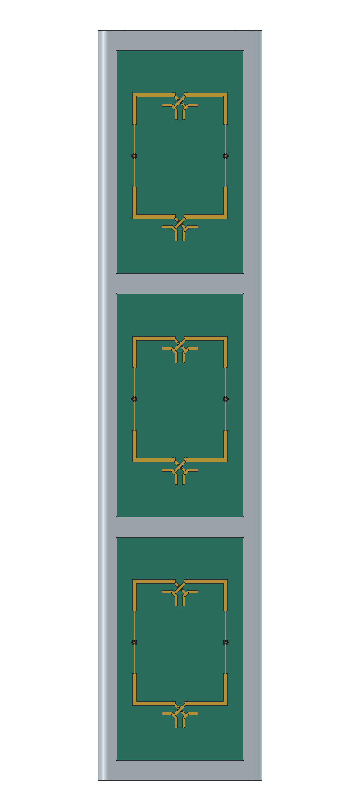
projetos/P2S13/mecanica_R12/imagens/03_frontal.png
