Gecesars/emb_ant/projetos/P2S13/mecanica_R17/imagens/interno_frente.png

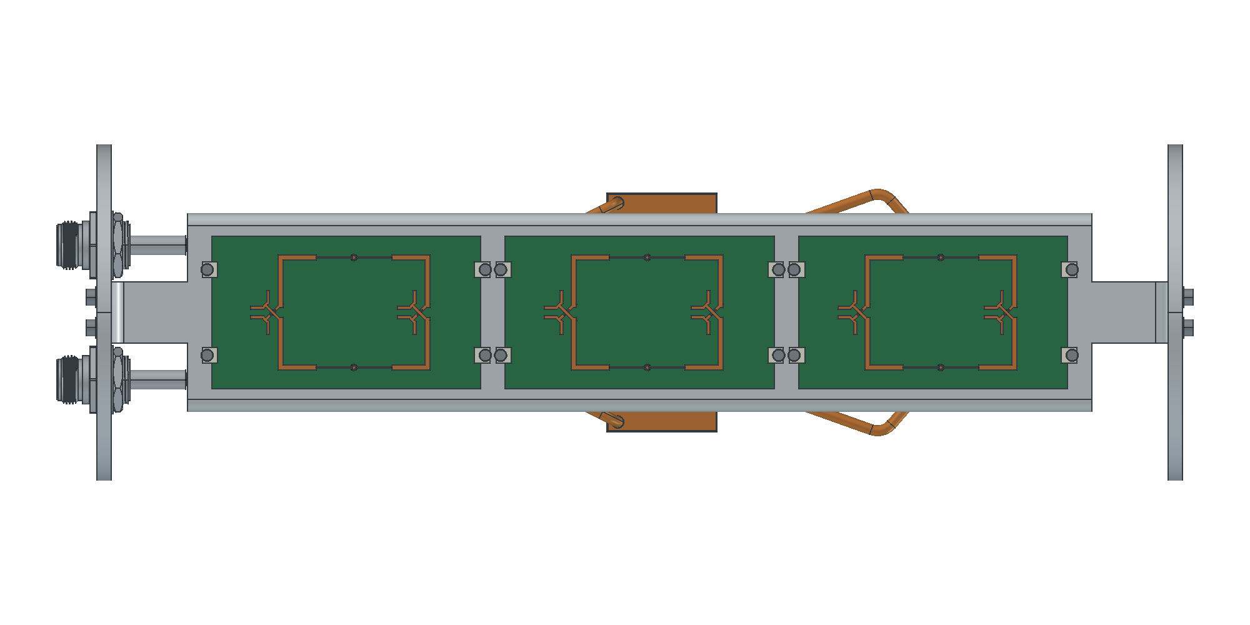
projetos/P2S13/mecanica_R17/imagens/interno_frente.png
