Gecesars/emb_ant/projetos/P2S13/referencia_plana/diagramas_HV.png

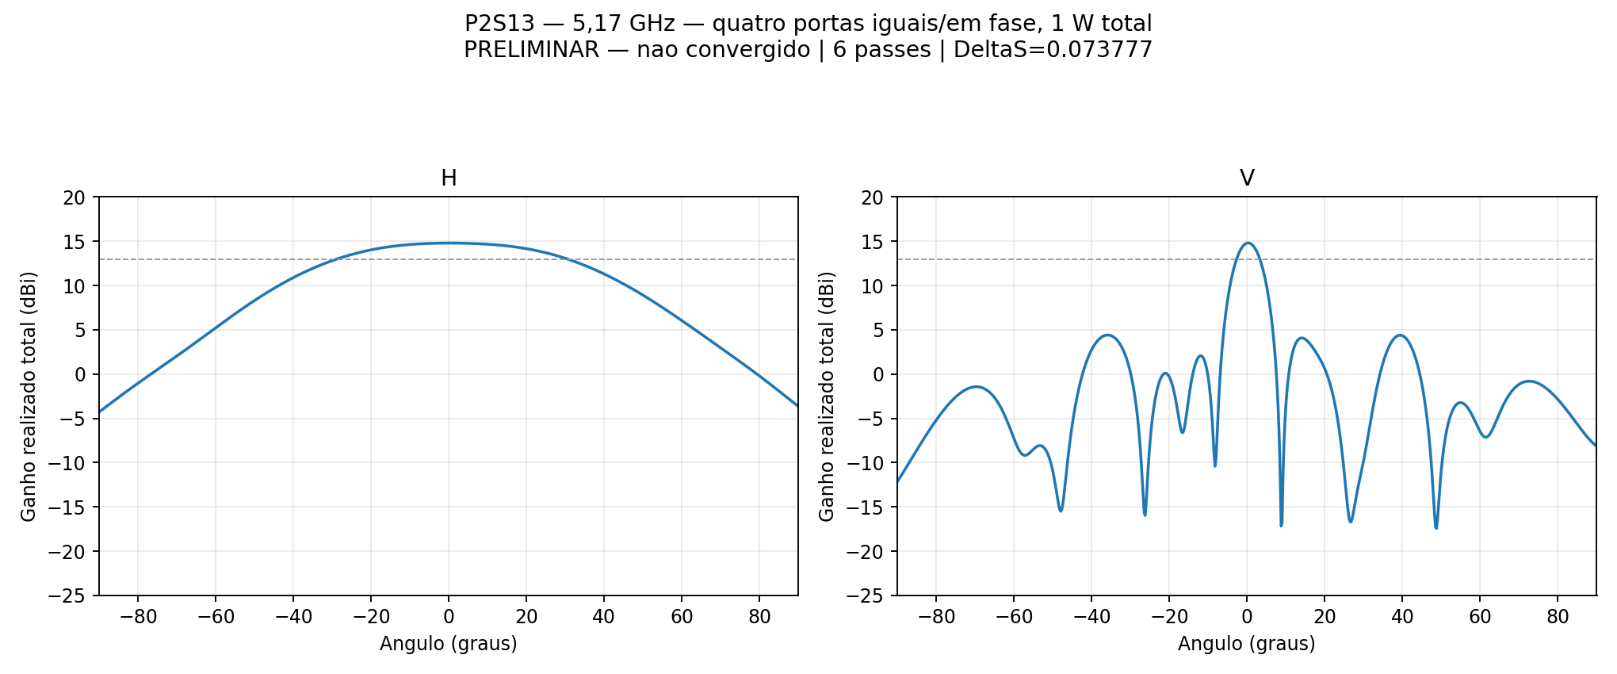
projetos/P2S13/referencia_plana/diagramas_HV.png
