Gecesars/emb_ant/projetos/P2S13/refletor_nativo_b20_60/diagramas_HV.png

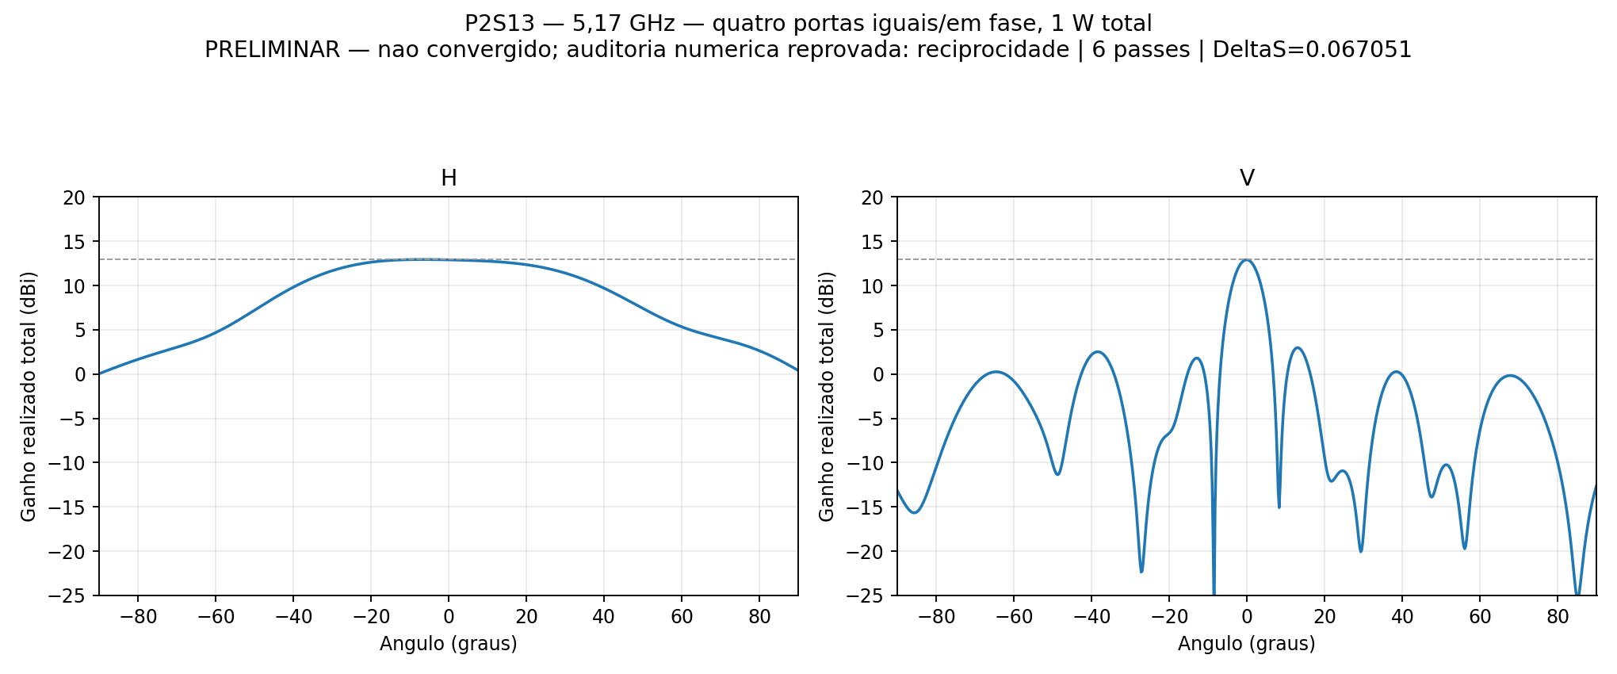
projetos/P2S13/refletor_nativo_b20_60/diagramas_HV.png
