Gecesars/emb_ant/projetos/P2S13/tres_placas2/t00_b3_a90/diagramas_HV.png

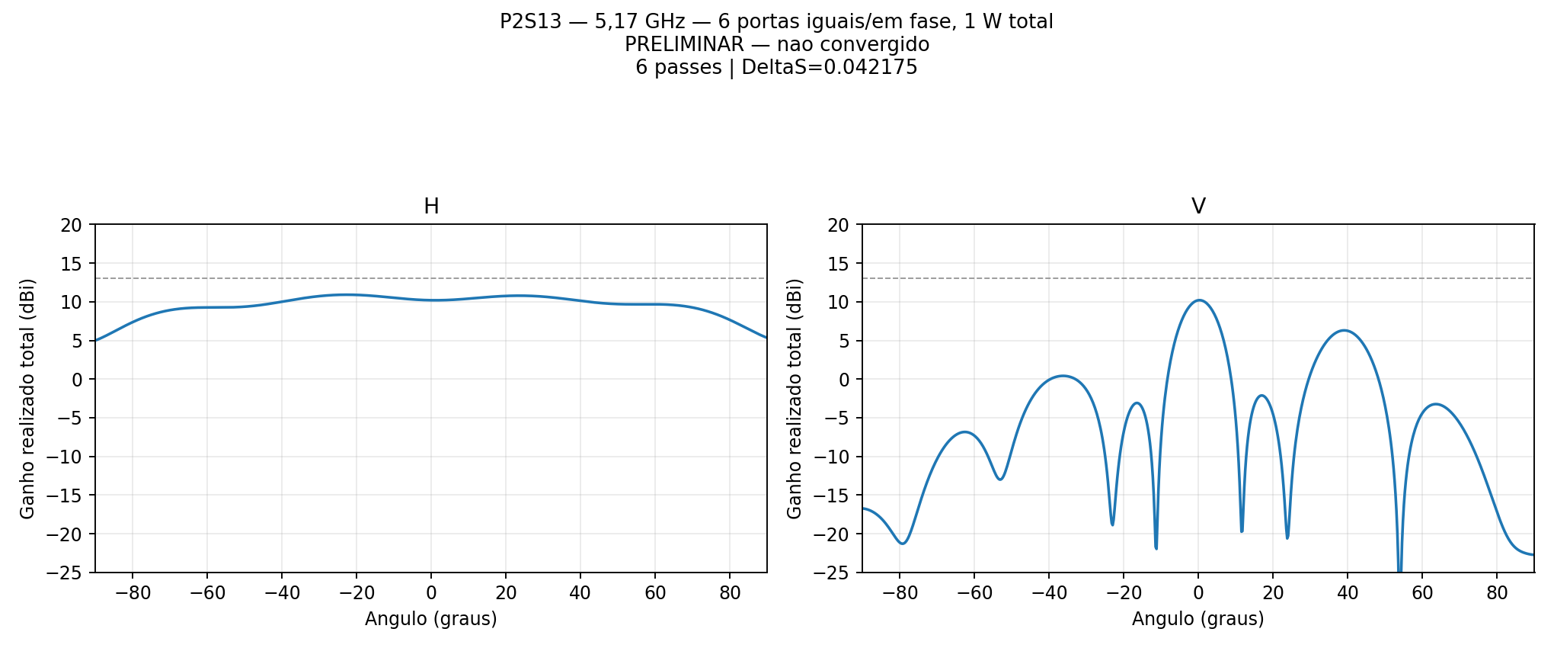
projetos/P2S13/tres_placas2/t00_b3_a90/diagramas_HV.png
