Gecesars/emb_ant/projetos/P2S13/tres_placas2/t01_b20_a120/diagramas_HV.png

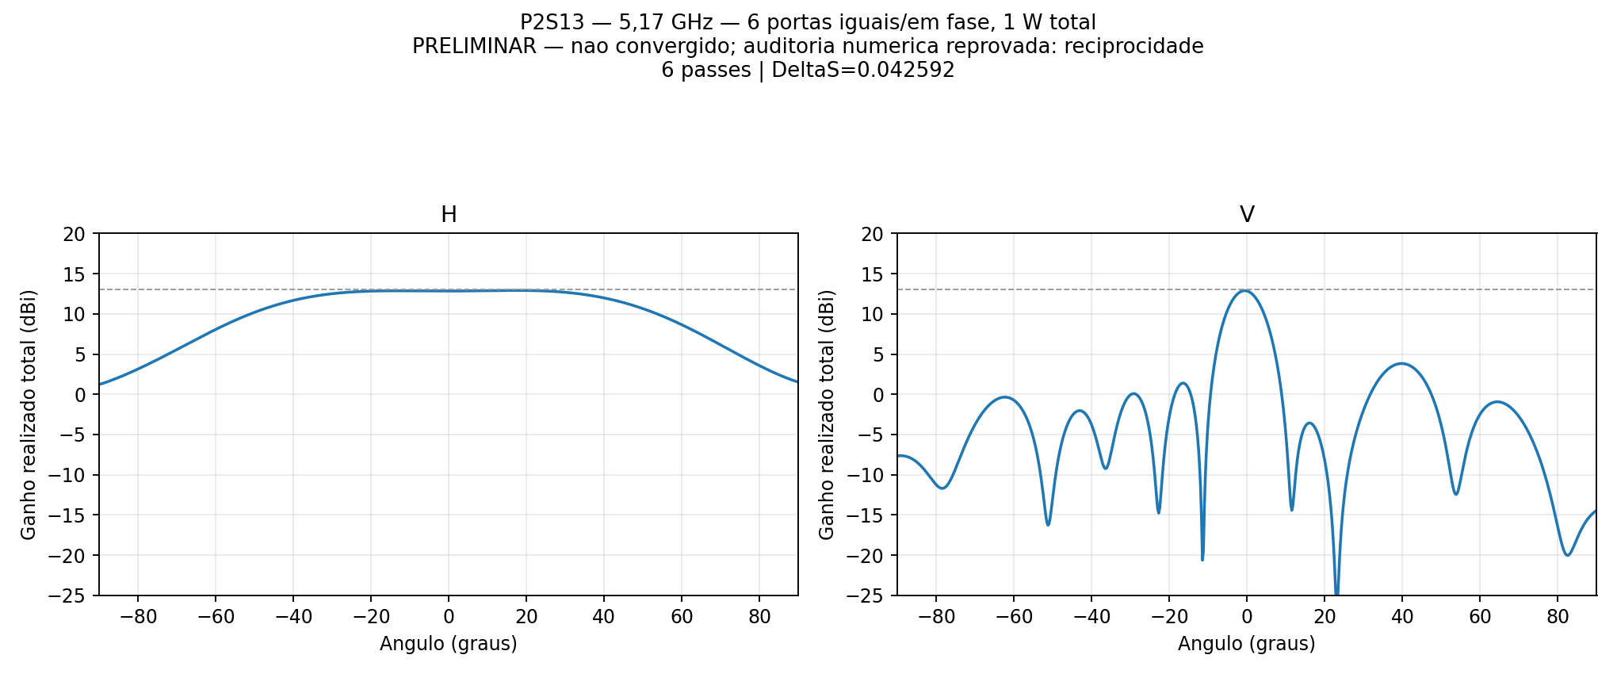
projetos/P2S13/tres_placas2/t01_b20_a120/diagramas_HV.png
