Gecesars/emb_ant/projetos/P2S13/kicad/conjunto_R12/lista_placas.csv

referencia | quantidade_por_antena | arquivo | material | core_mm | cobre_externo_um | metalizacao_PTH_modelada_um | largura_mm | comprimento_mm
R1 R2 R3 | 3 | placa2_M00/2_elementos.kicad_pcb | RO4350B | 0.76 | 35 | 35 | 50 | 88
D1 | 1 | divisor_C08/divisor_duplo_1x3_C08.kicad_pcb | ZYF300CA-C | 1.52 | 35 | 18 | 64 | 220
