Gecesars/emb_ant/projetos/P2S13/kicad/divisor_duplo_1x3_C07/conexoes.csv

Referencia | Porta | HFSS_X_mm | HFSS_Y_mm | KiCad_X_mm | KiCad_Y_mm | Furo_NPTH_mm | Antipad_BCu_mm
J1 | IN_A | 2.50916841304 | 2.5 | 122.50916841304 | 39.5 | 0.9195 | 3.03
J2 | R1_A | -93.49083158696 | 18 | 26.50916841304 | 24 | 0.9195 | 3.03
J3 | R2_A | 2.50916841304 | 18 | 122.50916841304 | 24 | 0.9195 | 3.03
J4 | R3_A | 98.50916841304 | 18 | 218.50916841304002 | 24 | 0.9195 | 3.03
J5 | IN_B | 2.50916841304 | -2.5 | 122.50916841304 | 44.5 | 0.9195 | 3.03
J6 | R1_B | -93.49083158696 | -18 | 26.50916841304 | 60 | 0.9195 | 3.03
J7 | R2_B | 2.50916841304 | -18 | 122.50916841304 | 60 | 0.9195 | 3.03
J8 | R3_B | 98.50916841304 | -18 | 218.50916841304002 | 60 | 0.9195 | 3.03
