Gecesars/emb_ant/fabricacao/historico/ligacao_dos_cabos.csv

ref_placa | porta_divisor | polarizacao | x_placa_mm | y_placa_mm | centro_elemento_X_mm | porta_no_HFSS | comprimento_nominal_UT141C_mm
J1 | A_IN | A | 0 | -16.5 |  | Entrada externa
J2 | A1 | A | -12.2414 | -21.5706 | -184.1 | E016_PA | 195
J3 | A2 | A | -12.2414 | -11.4294 | -131.5 | E016_PA1 | 195
J4 | A3 | A | -5.0706 | -28.7414 | -78.9 | E016_PA2 | 195
J5 | A4 | A | -5.0706 | -4.2586 | -26.3 | E016_PA3 | 195
J6 | A5 | A | 5.0706 | -28.7414 | 26.3 | E016_PA4 | 195
J7 | A6 | A | 5.0706 | -4.2586 | 78.9 | E016_PA5 | 195
J8 | A7 | A | 12.2414 | -21.5706 | 131.5 | E016_PA6 | 195
J9 | A8 | A | 12.2414 | -11.4294 | 184.1 | E016_PA7 | 195
J10 | B_IN | B | 0 | 16.5 |  | Entrada externa
J11 | B1 | B | -12.2414 | 11.4294 | -184.1 | E016_PB | 195
J12 | B2 | B | -12.2414 | 21.5706 | -131.5 | E016_PB1 | 195
J13 | B3 | B | -5.0706 | 4.2586 | -78.9 | E016_PB2 | 195
J14 | B4 | B | -5.0706 | 28.7414 | -26.3 | E016_PB3 | 195
J15 | B5 | B | 5.0706 | 4.2586 | 26.3 | E016_PB4 | 195
J16 | B6 | B | 5.0706 | 28.7414 | 78.9 | E016_PB5 | 195
J17 | B7 | B | 12.2414 | 11.4294 | 131.5 | E016_PB6 | 195
J18 | B8 | B | 12.2414 | 21.5706 | 184.1 | E016_PB7 | 195
