Gecesars/emb_ant/fabricacao/montagem/ligacao_dos_cabos.csv

ref_placa | porta_divisor | polarizacao | x_placa_mm | y_placa_mm | centro_elemento_X_mm | porta_no_HFSS | comprimento_nominal_UT141C_mm
J1 | A_IN | A | 0 | -19.25 |  | Entrada externa
J2 | A1 | A | -14.4561 | -23.9471 | -236.7 | E016_PA | 254
J3 | A2 | A | -14.4561 | -14.5529 | -184.1 | E016_PA1 | 254
J4 | A3 | A | -8.9343 | -31.5471 | -131.5 | E016_PA2 | 254
J5 | A4 | A | -8.9343 | -6.9529 | -78.9 | E016_PA3 | 254
J6 | A5 | A | -0.0 | -34.45 | -26.3 | E016_PA4 | 254
J7 | A6 | A | 0.0 | -4.05 | 26.3 | E016_PA5 | 254
J8 | A7 | A | 8.9343 | -31.5471 | 78.9 | E016_PA6 | 254
J9 | A8 | A | 8.9343 | -6.9529 | 131.5 | E016_PA7 | 254
J10 | A9 | A | 14.4561 | -23.9471 | 184.1 | E016_PA8 | 254
J11 | A10 | A | 14.4561 | -14.5529 | 236.7 | E016_PA9 | 254
J12 | B_IN | B | 0 | 19.25 |  | Entrada externa
J13 | B1 | B | -14.4561 | 14.5529 | -236.7 | E016_PB | 254
J14 | B2 | B | -14.4561 | 23.9471 | -184.1 | E016_PB1 | 254
J15 | B3 | B | -8.9343 | 6.9529 | -131.5 | E016_PB2 | 254
J16 | B4 | B | -8.9343 | 31.5471 | -78.9 | E016_PB3 | 254
J17 | B5 | B | -0.0 | 4.05 | -26.3 | E016_PB4 | 254
J18 | B6 | B | 0.0 | 34.45 | 26.3 | E016_PB5 | 254
J19 | B7 | B | 8.9343 | 6.9529 | 78.9 | E016_PB6 | 254
J20 | B8 | B | 8.9343 | 31.5471 | 131.5 | E016_PB7 | 254
J21 | B9 | B | 14.4561 | 14.5529 | 184.1 | E016_PB8 | 254
J22 | B10 | B | 14.4561 | 23.9471 | 236.7 | E016_PB9 | 254
