Gecesars/emb_ant/freecad/mecanica_R01/03_Antena_montada.FCStd

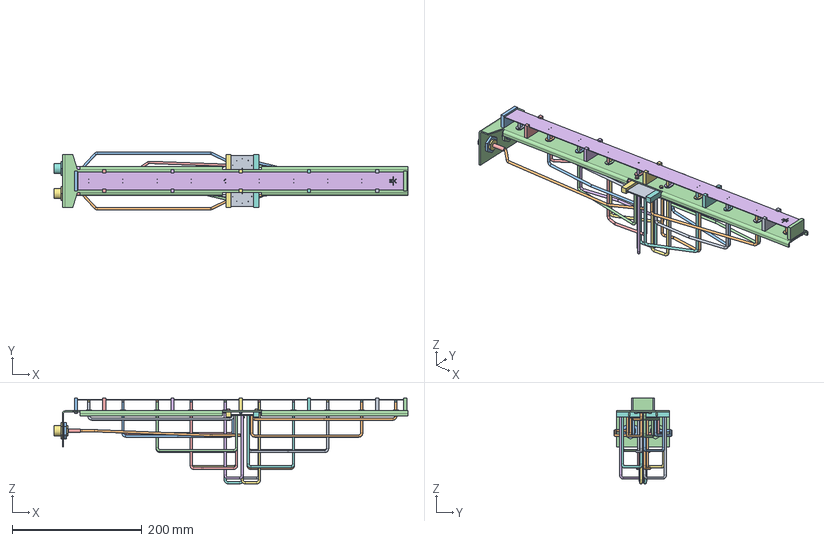
[picture p290: CAD file, 2026-11-06]
freecad/mecanica_R01/03_Antena_montada.FCStd
546.0 x 89.6 x 132.6 mm
Arruela_N_A
Arruela_N_B
Batente_6
Batente_7
Berco_1
Berco_2
Berco_3
Berco_4
Berco_5
Bobina_A
Bobina_B
Chapa_Aluminio_2mm
CobreRF_01
CobreRF_02
CobreRF_03
CobreRF_04
CobreRF_05
CobreRF_06
CobreRF_07
CobreRF_08
CobreRF_09
CobreRF_10
Conector_N_A
Conector_N_B
Divisor_PTFE
Entrada_IN_A
Entrada_IN_B
Junta_N_A
Junta_N_B
Nucleo_continuo
Par_0_0
Par_0_1
Par_1_0
Par_1_1
Par_2_0
Par_2_1
Par_3_0
Par_3_1
Par_4_0
Par_4_1
Par_5_0
Par_5_1
Par_6_0
Par_6_1
Par_trilho_0_0
Par_trilho_0_1
Par_trilho_1_0
Par_trilho_1_1
Passa_cabos_01
Passa_cabos_02
Passa_cabos_03
Passa_cabos_04
Passa_cabos_05
Passa_cabos_06
Passa_cabos_07
Passa_cabos_08
Passa_cabos_09
Passa_cabos_10
Porca_N_A
Porca_N_B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
