Gecesars/emb_ant/freecad/mecanica_R01/componentes/P03_Trilho_E.step

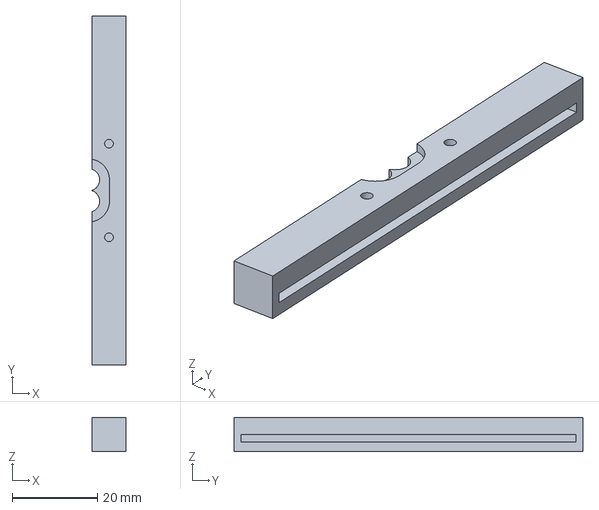
[picture p291: CAD file, 2026-11-06]
freecad/mecanica_R01/componentes/P03_Trilho_E.step
8.00 x 82.0 x 8.00 mm
