Gecesars/emb_ant/freecad/mecanica_R02/componentes/Trilho_RAIZ_E.step

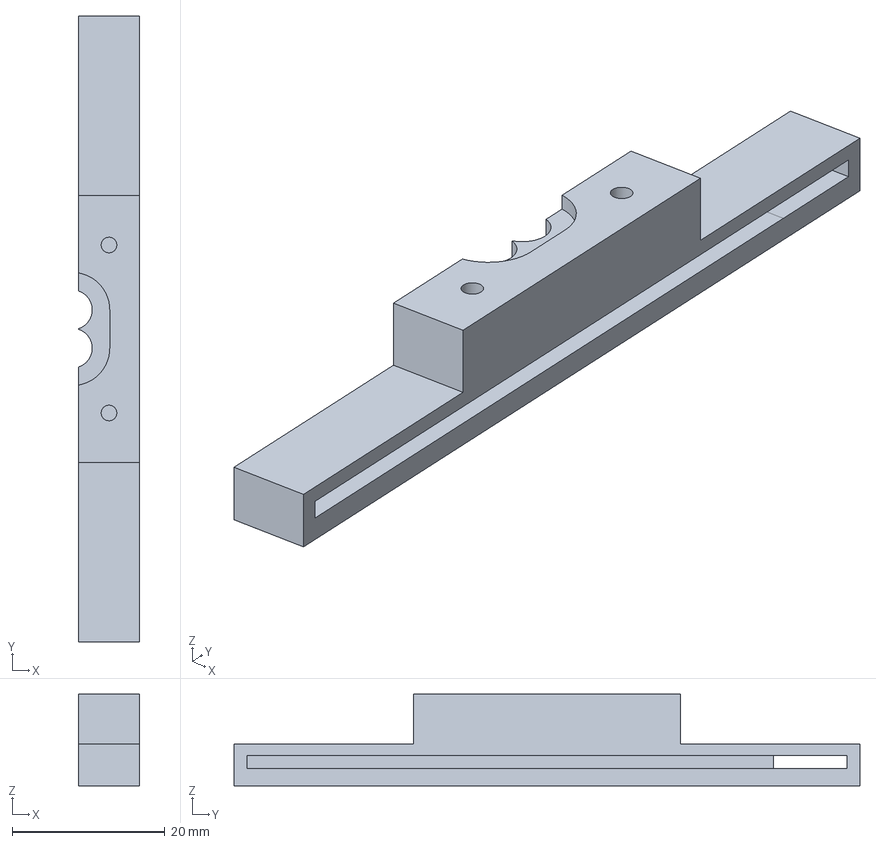
[picture p292: CAD file, 2026-11-06]
freecad/mecanica_R02/componentes/Trilho_RAIZ_E.step
8.00 x 82.0 x 12.0 mm
