Gecesars/emb_ant/freecad/mecanica_R03/02_Refletor_planificado.FCStd

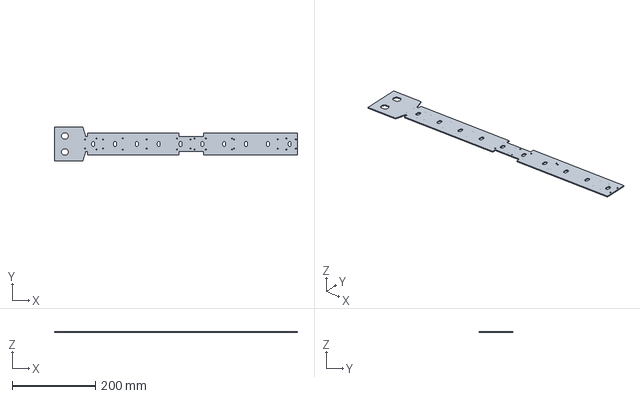
[picture p293: CAD file, 2026-11-07]
freecad/mecanica_R03/02_Refletor_planificado.FCStd
585.4 x 82.0 x 2.00 mm
