Gecesars/emb_ant/freecad/mecanica_R06/04_Refletor_CORTE_1a1.dxf

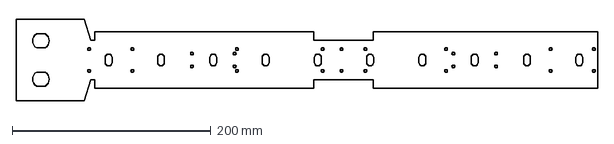
[picture p295: CAD file, 2026-11-07]
freecad/mecanica_R06/04_Refletor_CORTE_1a1.dxf
585.4 x 82.0 mm
