Gecesars/emb_ant/freecad/modelos_RF_R06/antena/PCB_R06.FCStd

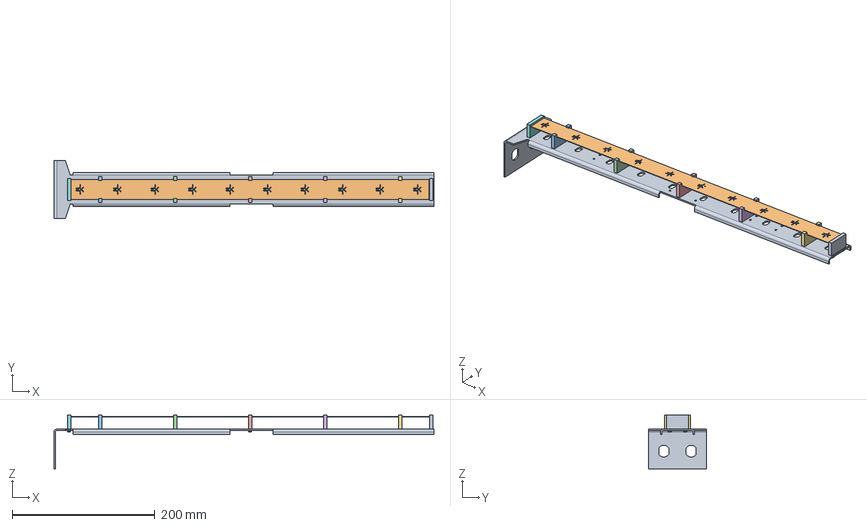
[picture p296: CAD file, 2026-11-08]
freecad/modelos_RF_R06/antena/PCB_R06.FCStd
533.0 x 82.0 x 75.6 mm
Refletor_R05
Rogers
Berco_1
Berco_2
Berco_3
Berco_4
Berco_5
Batente_6
Batente_7
Par_0_001
Par_0_003
Par_1_001
Par_1_003
Par_2_001
Par_2_003
Par_3_001
Par_3_003
Par_4_001
Par_4_003
Par_5_001
Par_5_003
Par_6_001
Par_6_003
Ant01_Ring_Q1
Ant01_Ring_Q2
Ant01_Ring_Q3
Ant01_Ring_Q4
Ant01_Crossover_Bridge
Ant01_Feed_A_Cu0
Ant01_Feed_A_Cu1
Ant01_Feed_B_Outer
Ant01_Feed_B_Inner_Cu0
Ant01_Feed_B_Inner_Cu1
Ant02_Ring_Q1
Ant02_Ring_Q2
Ant02_Ring_Q3
Ant02_Ring_Q4
Ant02_Crossover_Bridge
Ant02_Feed_A_Cu0
Ant02_Feed_A_Cu1
Ant02_Feed_B_Outer
Ant02_Feed_B_Inner_Cu0
Ant02_Feed_B_Inner_Cu1
Ant03_Ring_Q1
Ant03_Ring_Q2
Ant03_Ring_Q3
Ant03_Ring_Q4
Ant03_Crossover_Bridge
Ant03_Feed_A_Cu0
Ant03_Feed_A_Cu1
Ant03_Feed_B_Outer
Ant03_Feed_B_Inner_Cu0
Ant03_Feed_B_Inner_Cu1
Ant04_Ring_Q1
Ant04_Ring_Q2
Ant04_Ring_Q3
Ant04_Ring_Q4
Ant04_Crossover_Bridge
Ant04_Feed_A_Cu0
Ant04_Feed_A_Cu1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
