Gecesars/emb_ant/freecad/modelos_RF_R06/divisor_inferior/cad/SAC305.step

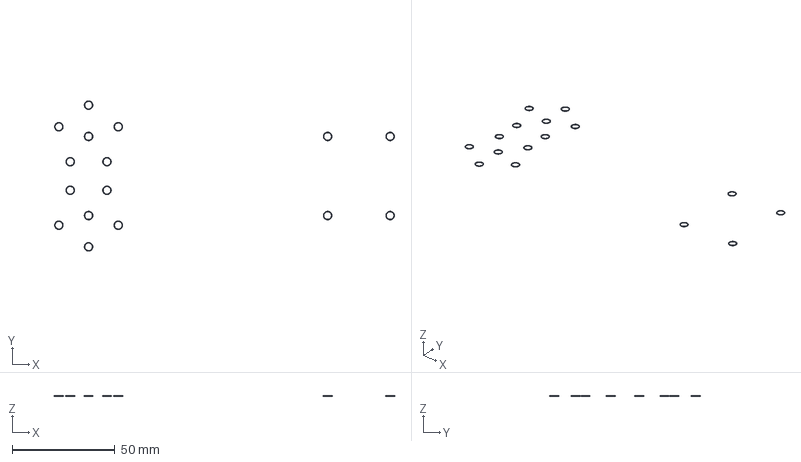
[picture p297: CAD file, 2026-11-08]
freecad/modelos_RF_R06/divisor_inferior/cad/SAC305.step
165.4 x 73.2 x 0.18 mm
Solda_Inferior_A_IN
Solda_Inferior_A1
Solda_Inferior_A2
Solda_Inferior_A3
Solda_Inferior_A4
Solda_Inferior_A5
Solda_Inferior_B_IN
Solda_Inferior_B1
Solda_Inferior_B2
Solda_Inferior_B3
Solda_Inferior_B4
Solda_Inferior_B5
Solda_Inferior_RA1
Solda_Inferior_RA2
Solda_Inferior_RB1
Solda_Inferior_RB2
