Gecesars/emb_ant/freecad/modelos_RF_R06/divisor_inferior/Divisor_Inferior.FCStd

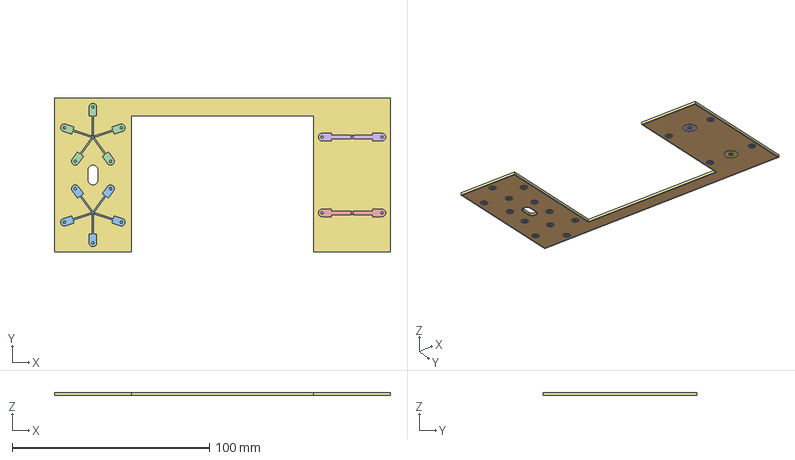
[picture p298: CAD file, 2026-11-08]
freecad/modelos_RF_R06/divisor_inferior/Divisor_Inferior.FCStd
170.5 x 78.0 x 1.77 mm
Terminal_A_IN
Massa_terminal_A_IN
Isol_terminal_A_IN
Terminal_A1
Massa_terminal_A1
Isol_terminal_A1
Terminal_A2
Massa_terminal_A2
Isol_terminal_A2
Terminal_A3
Massa_terminal_A3
Isol_terminal_A3
Terminal_A4
Massa_terminal_A4
Isol_terminal_A4
Terminal_A5
Massa_terminal_A5
Isol_terminal_A5
Terminal_B_IN
Massa_terminal_B_IN
Isol_terminal_B_IN
Terminal_B1
Massa_terminal_B1
Isol_terminal_B1
Terminal_B2
Massa_terminal_B2
Isol_terminal_B2
Terminal_B3
Massa_terminal_B3
Isol_terminal_B3
Terminal_B4
Massa_terminal_B4
Isol_terminal_B4
Terminal_B5
Massa_terminal_B5
Isol_terminal_B5
Terminal_RA_IN
Massa_terminal_RA_IN
Isol_terminal_RA_IN
Terminal_RA1
Massa_terminal_RA1
Isol_terminal_RA1
Terminal_RA2
Massa_terminal_RA2
Isol_terminal_RA2
Terminal_RB_IN
Massa_terminal_RB_IN
Isol_terminal_RB_IN
Terminal_RB1
Massa_terminal_RB1
Isol_terminal_RB1
Terminal_RB2
Massa_terminal_RB2
Isol_terminal_RB2
PCB_Inferior
Pad_Inferior_A_IN
Pad_Inferior_A1
Pad_Inferior_A2
Pad_Inferior_A3
Pad_Inferior_A4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
