Gecesars/emb_ant/freecad/modelos_RF_R06/divisor_superior/Divisor_Superior.FCStd

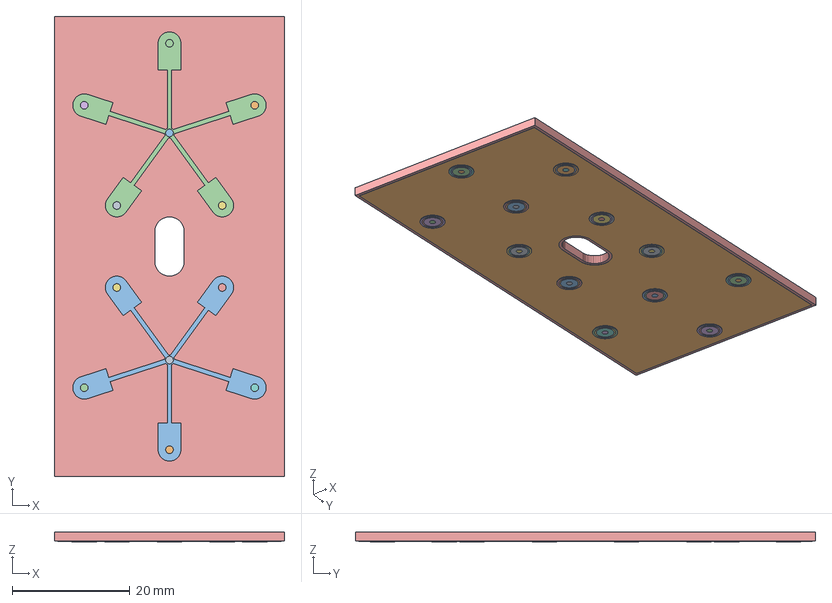
[picture p299: CAD file, 2026-11-08]
freecad/modelos_RF_R06/divisor_superior/Divisor_Superior.FCStd
39.0 x 78.0 x 1.77 mm
Terminal_A_IN
Massa_terminal_A_IN
Isol_terminal_A_IN
Terminal_A1
Massa_terminal_A1
Isol_terminal_A1
Terminal_A2
Massa_terminal_A2
Isol_terminal_A2
Terminal_A3
Massa_terminal_A3
Isol_terminal_A3
Terminal_A4
Massa_terminal_A4
Isol_terminal_A4
Terminal_A5
Massa_terminal_A5
Isol_terminal_A5
Terminal_B_IN
Massa_terminal_B_IN
Isol_terminal_B_IN
Terminal_B1
Massa_terminal_B1
Isol_terminal_B1
Terminal_B2
Massa_terminal_B2
Isol_terminal_B2
Terminal_B3
Massa_terminal_B3
Isol_terminal_B3
Terminal_B4
Massa_terminal_B4
Isol_terminal_B4
Terminal_B5
Massa_terminal_B5
Isol_terminal_B5
PCB_Superior
Pad_Superior_A_IN
Pad_Superior_A1
Pad_Superior_A2
Pad_Superior_A3
Pad_Superior_A4
Pad_Superior_A5
Pad_Superior_B_IN
Pad_Superior_B1
Pad_Superior_B2
Pad_Superior_B3
Pad_Superior_B4
Pad_Superior_B5
Massa_Superior
Estrela_Superior_A
Estrela_Superior_B
Solda_Superior_A_IN
Solda_Superior_A1
Solda_Superior_A2
Solda_Superior_A3
Solda_Superior_A4
Solda_Superior_A5
Solda_Superior_B_IN
Solda_Superior_B1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
