Gecesars/emb_ant/freecad/P1H_10_Continua.FCStd

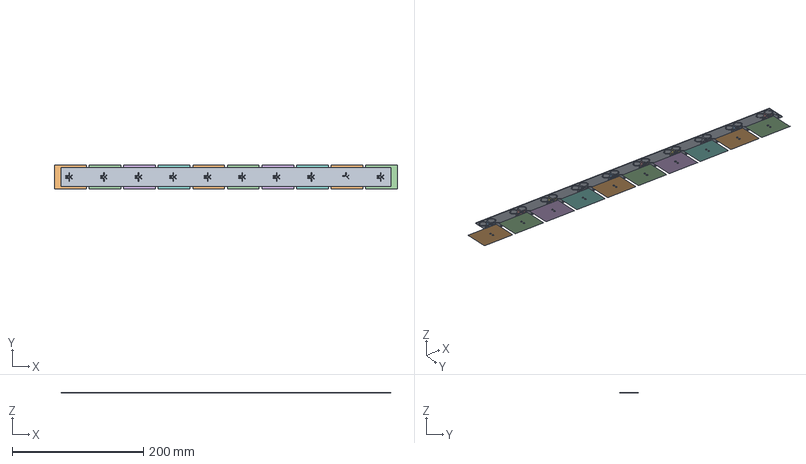
[picture p300: CAD file, 2026-11-06]
freecad/P1H_10_Continua.FCStd
521.7 x 36.0 x 17.4 mm
Nucleo_continuo
Refletor_01
CobreRF_01
Refletor_02
CobreRF_02
Refletor_03
CobreRF_03
Refletor_04
CobreRF_04
Refletor_05
CobreRF_05
Refletor_06
CobreRF_06
Refletor_07
CobreRF_07
Refletor_08
CobreRF_08
Refletor_09
CobreRF_09
Refletor_10
CobreRF_10
