Gecesars/emb_ant/projetos/P2M19/estudo_72mm/casos/R03_72mm_ref162/P2M19_R03_72mm_ref162.FCStd

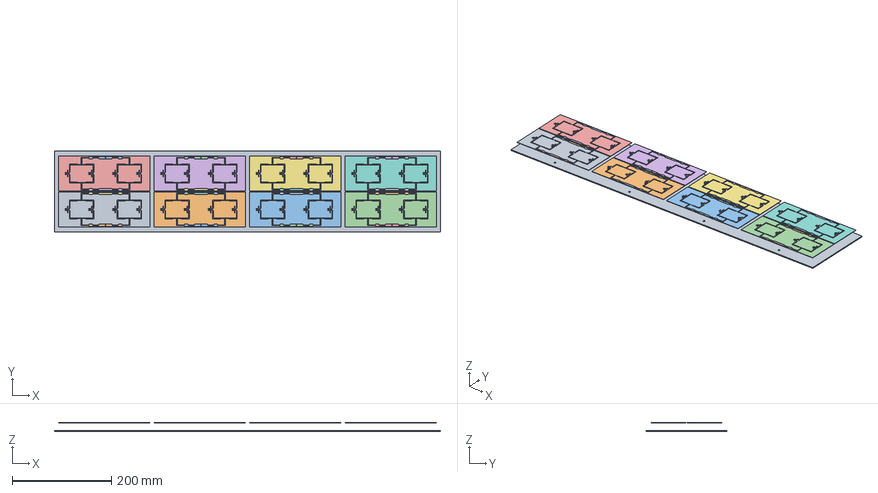
[picture p303: CAD file, 2026-11-13]
projetos/P2M19/estudo_72mm/casos/R03_72mm_ref162/P2M19_R03_72mm_ref162.FCStd
776.0 x 162.0 x 17.8 mm
C1R1_PCB_RO4350B
C1R1_B_E1_Q2_Cu0
C1R1_B_E1_Q3_Cu0
C1R1_B_E2_Q2_Cu0
C1R1_B_E2_Q3_Cu0
C1R1_B_E3_Q2_Cu0
C1R1_B_E3_Q3_Cu0
C1R1_B_E4_Q2_Cu0
C1R1_B_E4_Q3_Cu0
C1R1_B_RET_A_Cu0
C1R1_B_RET_B_Cu0
C1R1_B_SIG_A_Cu0
C1R1_B_SIG_B_Cu0
C1R1_B_SIG_B_Cu1
C1R1_B_SIG_B_Cu2
C1R1_B_SIG_B_Cu3
C1R1_B_SIG_B_Cu4
C1R1_F_SIG_A_Cu0
C1R1_F_SIG_B_Cu0
C1R1_F_SIG_B_Cu1
C1R1_F_SIG_B_Cu2
C1R1_F_SIG_B_Cu3
C1R1_F_SIG_B_Cu4
C1R1_Via_0
C1R1_Via_1
C1R1_Via_2
C1R1_Via_3
C1R1_Via_4
C1R1_Via_5
C1R1_Via_6
C1R1_Via_7
C1R1_Vivo_A
C1R1_Blindagem_A
C1R1_PTFE_A
C1R1_Solda_A
C1R1_PTH_A
C1R1_Vivo_B
C1R1_Blindagem_B
C1R1_PTFE_B
C1R1_Solda_B
C1R1_PTH_B
C1R2_PCB_RO4350B
C1R2_B_E1_Q2_Cu0
C1R2_B_E1_Q3_Cu0
C1R2_B_E2_Q2_Cu0
C1R2_B_E2_Q3_Cu0
C1R2_B_E3_Q2_Cu0
C1R2_B_E3_Q3_Cu0
C1R2_B_E4_Q2_Cu0
C1R2_B_E4_Q3_Cu0
C1R2_B_RET_A_Cu0
C1R2_B_RET_B_Cu0
C1R2_B_SIG_A_Cu0
C1R2_B_SIG_B_Cu0
C1R2_B_SIG_B_Cu1
C1R2_B_SIG_B_Cu2
C1R2_B_SIG_B_Cu3
C1R2_B_SIG_B_Cu4
C1R2_F_SIG_A_Cu0
C1R2_F_SIG_B_Cu0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
