Gecesars/emb_ant/projetos/P2M19/mecanica_R09_PRELIMINAR/referencias/82-6784.stp

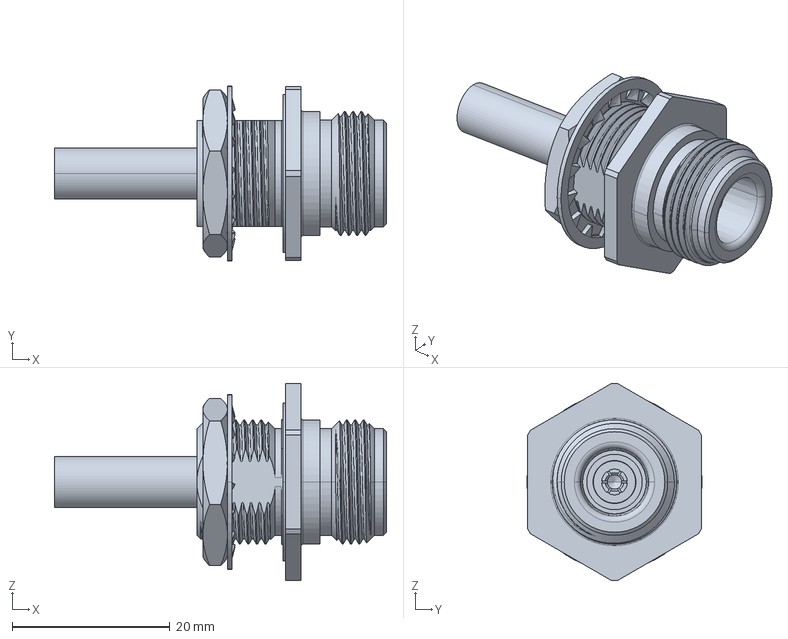
[picture p304: CAD file, 2026-11-10]
projetos/P2M19/mecanica_R09_PRELIMINAR/referencias/82-6784.stp
42.0 x 22.2 x 25.0 mm
