Gecesars/emb_ant/projetos/P2M19/mecanica_R09_PRELIMINAR/Refletor_furado_PRELIMINAR.step

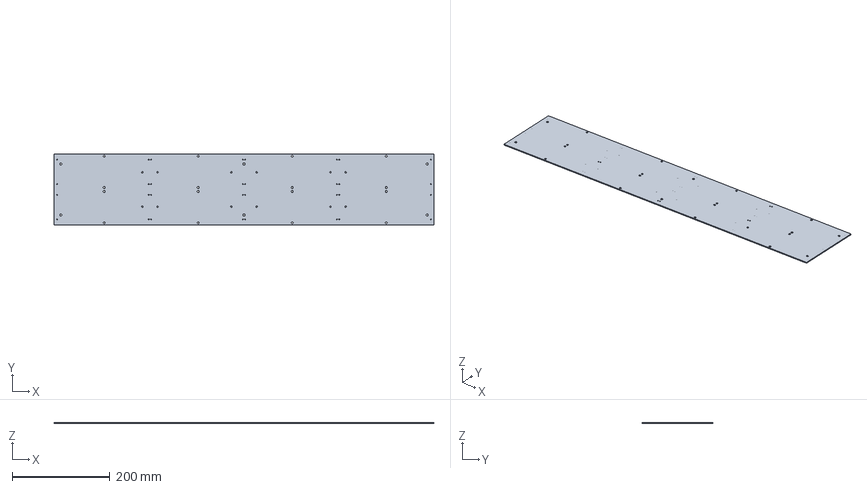
[picture p305: CAD file, 2026-11-14]
projetos/P2M19/mecanica_R09_PRELIMINAR/Refletor_furado_PRELIMINAR.step
776.0 x 146.0 x 2.00 mm
