Gecesars/emb_ant/projetos/P2M21/dois_verticais_divisor/variantes/v02_central_terra6/Dois_Verticais.FCStd

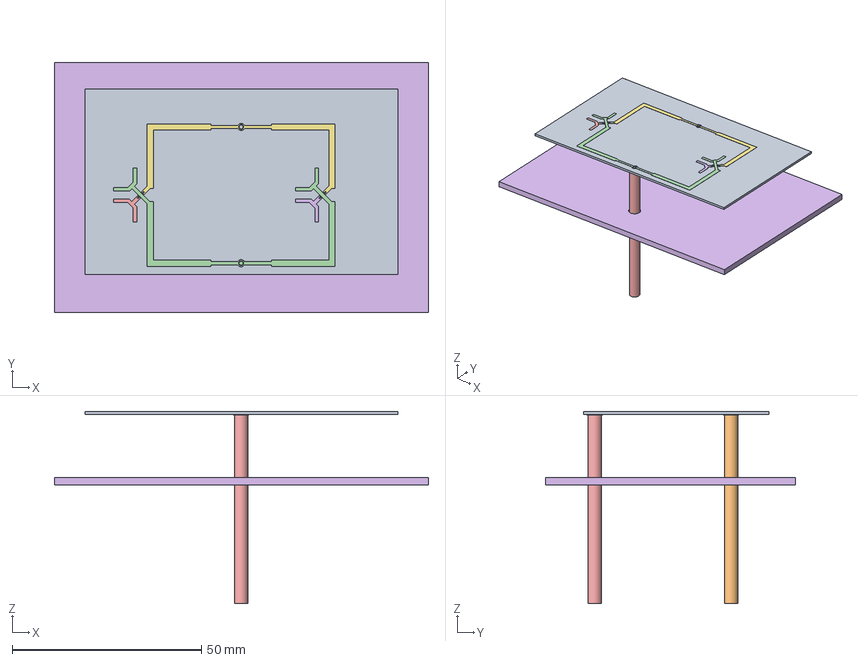
[picture p310: CAD file, 2026-11-09]
projetos/P2M21/dois_verticais_divisor/variantes/v02_central_terra6/Dois_Verticais.FCStd
98.8 x 66.0 x 50.8 mm
PCB_RO4350B
B_E1_Q2_Cu0
B_E1_Q3_Cu0
B_E2_Q2_Cu0
B_E2_Q3_Cu0
B_RET_A_Cu0
B_RET_B_Cu0
B_SIG_A_Cu0
B_SIG_B_Cu0
B_SIG_B_Cu1
B_SIG_B_Cu2
F_SIG_A_Cu0
F_SIG_B_Cu0
F_SIG_B_Cu1
F_SIG_B_Cu2
Via_0
Via_1
Via_2
Via_3
Vivo_A
Blindagem_A
PTFE_A
Solda_A
PTH_A
Vivo_B
Blindagem_B
PTFE_B
Solda_B
PTH_B
Refletor_Al2mm
