Gecesars/emb_ant/projetos/P2M21/freecad/Refletor_planificado.step

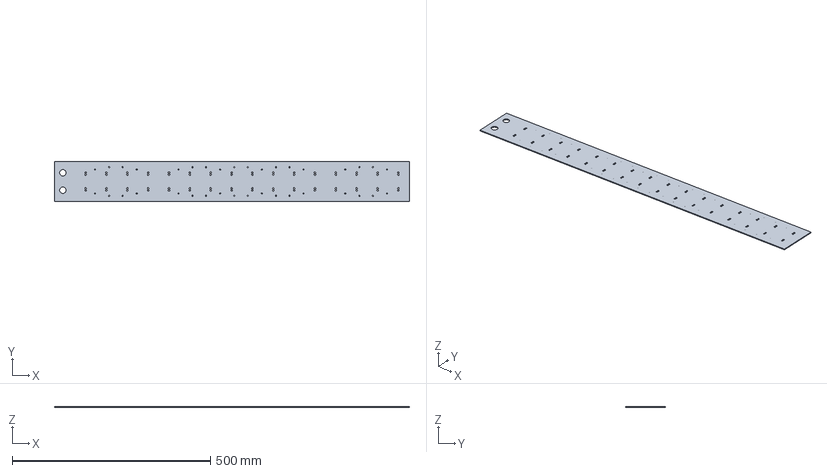
[picture p311: CAD file, 2026-11-08]
projetos/P2M21/freecad/Refletor_planificado.step
895.4 x 100.0 x 2.00 mm
