Gecesars/emb_ant/projetos/P2M21/hfss/antena/cad/SAC305.step

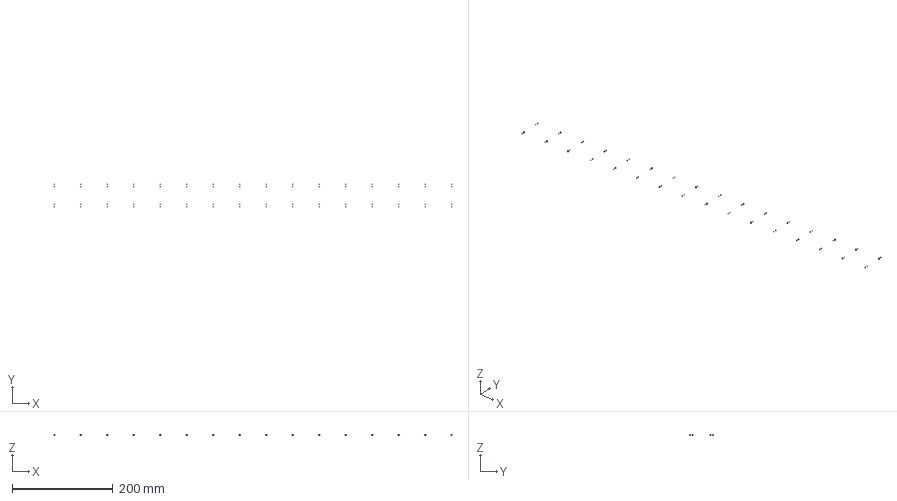
[picture p312: CAD file, 2026-11-08]
projetos/P2M21/hfss/antena/cad/SAC305.step
790.2 x 46.2 x 0.845 mm
E01_Solda_terminal_00
E01_Solda_terminal_01
E01_Solda_terminal_02
E01_Solda_terminal_03
E02_Solda_terminal_00
E02_Solda_terminal_01
E02_Solda_terminal_02
E02_Solda_terminal_03
E03_Solda_terminal_00
E03_Solda_terminal_01
E03_Solda_terminal_02
E03_Solda_terminal_03
E04_Solda_terminal_00
E04_Solda_terminal_01
E04_Solda_terminal_02
E04_Solda_terminal_03
E05_Solda_terminal_00
E05_Solda_terminal_01
E05_Solda_terminal_02
E05_Solda_terminal_03
E06_Solda_terminal_00
E06_Solda_terminal_01
E06_Solda_terminal_02
E06_Solda_terminal_03
E07_Solda_terminal_00
E07_Solda_terminal_01
E07_Solda_terminal_02
E07_Solda_terminal_03
E08_Solda_terminal_00
E08_Solda_terminal_01
E08_Solda_terminal_02
E08_Solda_terminal_03
E09_Solda_terminal_00
E09_Solda_terminal_01
E09_Solda_terminal_02
E09_Solda_terminal_03
E10_Solda_terminal_00
E10_Solda_terminal_01
E10_Solda_terminal_02
E10_Solda_terminal_03
E11_Solda_terminal_00
E11_Solda_terminal_01
E11_Solda_terminal_02
E11_Solda_terminal_03
E12_Solda_terminal_00
E12_Solda_terminal_01
E12_Solda_terminal_02
E12_Solda_terminal_03
E13_Solda_terminal_00
E13_Solda_terminal_01
E13_Solda_terminal_02
E13_Solda_terminal_03
E14_Solda_terminal_00
E14_Solda_terminal_01
E14_Solda_terminal_02
E14_Solda_terminal_03
E15_Solda_terminal_00
E15_Solda_terminal_01
E15_Solda_terminal_02
E15_Solda_terminal_03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
