Gecesars/emb_ant/projetos/P2M21/hfss/divisor_1x4/cad/PTFE_terminal.step

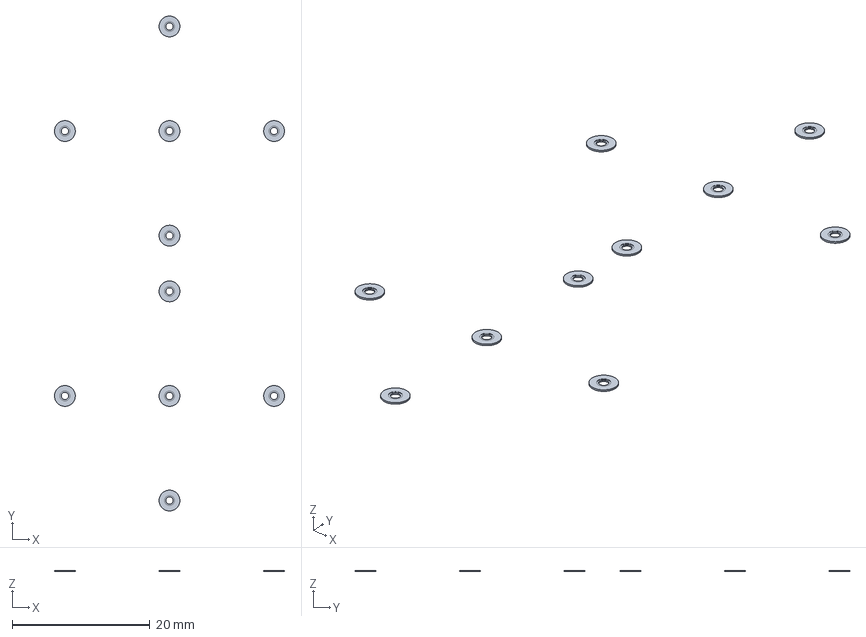
[picture p314: CAD file, 2026-11-08]
projetos/P2M21/hfss/divisor_1x4/cad/PTFE_terminal.step
33.4 x 71.9 x 0.18 mm
Isol_terminal_A_IN
Isol_terminal_A1
Isol_terminal_A2
Isol_terminal_A3
Isol_terminal_A4
Isol_terminal_B_IN
Isol_terminal_B1
Isol_terminal_B2
Isol_terminal_B3
Isol_terminal_B4
