Gecesars/emb_ant/projetos/P2M21/hfss/divisor_1x8/cad/folha_cu.step

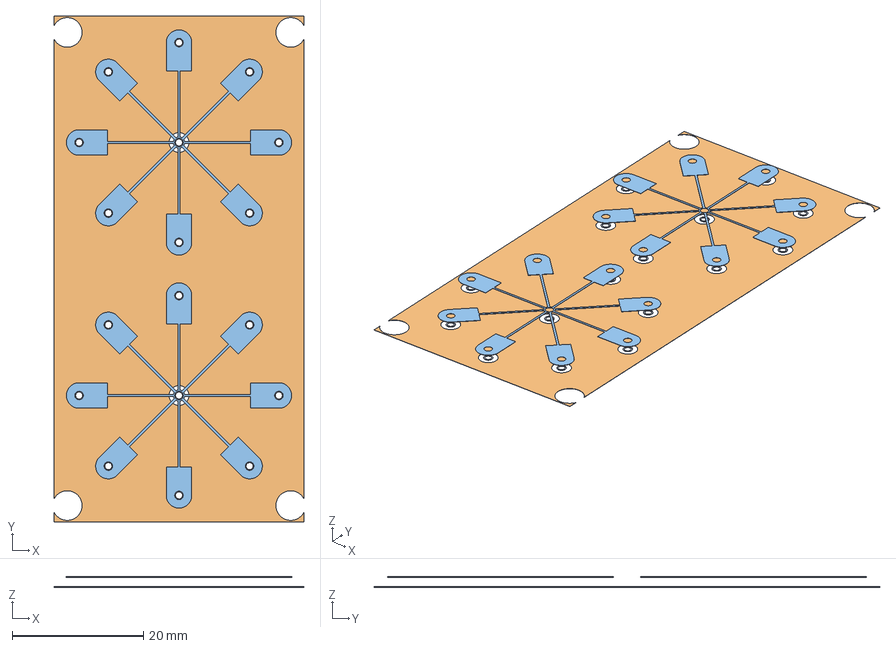
[picture p315: CAD file, 2026-11-08]
projetos/P2M21/hfss/divisor_1x8/cad/folha_cu.step
38.0 x 77.0 x 1.59 mm
Pad_A_IN
Pad_A1
Pad_A2
Pad_A3
Pad_A4
Pad_A5
Pad_A6
Pad_A7
Pad_A8
Pad_B_IN
Pad_B1
Pad_B2
Pad_B3
Pad_B4
Pad_B5
Pad_B6
Pad_B7
Pad_B8
GND
Estrela_A
Estrela_B
