Gecesars/emb_ant/projetos/P2M21/hfss/divisor_1x8/P2M21_Duplo_1x8.FCStd

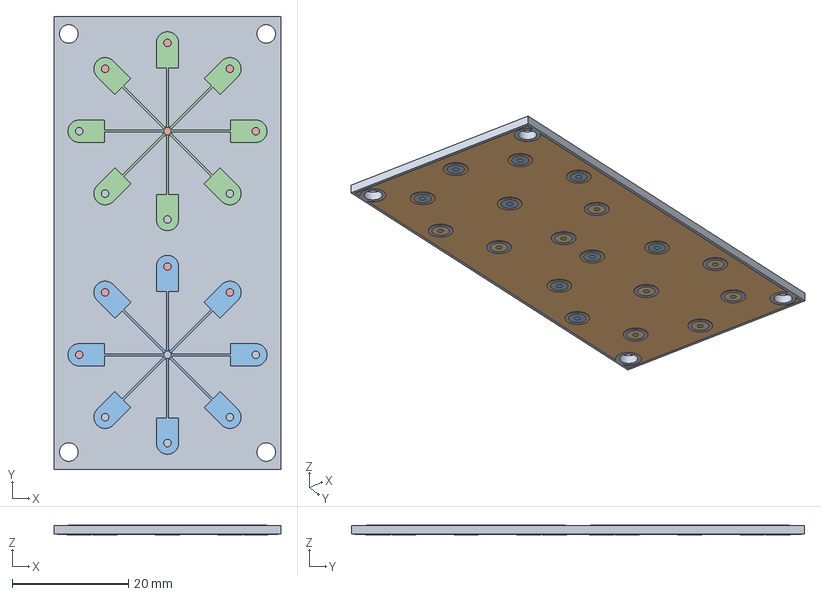
[picture p316: CAD file, 2026-11-08]
projetos/P2M21/hfss/divisor_1x8/P2M21_Duplo_1x8.FCStd
39.0 x 78.0 x 1.77 mm
Terminal_A_IN
Massa_terminal_A_IN
Isol_terminal_A_IN
Pad_A_IN
Terminal_A1
Massa_terminal_A1
Isol_terminal_A1
Pad_A1
Terminal_A2
Massa_terminal_A2
Isol_terminal_A2
Pad_A2
Terminal_A3
Massa_terminal_A3
Isol_terminal_A3
Pad_A3
Terminal_A4
Massa_terminal_A4
Isol_terminal_A4
Pad_A4
Terminal_A5
Massa_terminal_A5
Isol_terminal_A5
Pad_A5
Terminal_A6
Massa_terminal_A6
Isol_terminal_A6
Pad_A6
Terminal_A7
Massa_terminal_A7
Isol_terminal_A7
Pad_A7
Terminal_A8
Massa_terminal_A8
Isol_terminal_A8
Pad_A8
Terminal_B_IN
Massa_terminal_B_IN
Isol_terminal_B_IN
Pad_B_IN
Terminal_B1
Massa_terminal_B1
Isol_terminal_B1
Pad_B1
Terminal_B2
Massa_terminal_B2
Isol_terminal_B2
Pad_B2
Terminal_B3
Massa_terminal_B3
Isol_terminal_B3
Pad_B3
Terminal_B4
Massa_terminal_B4
Isol_terminal_B4
Pad_B4
Terminal_B5
Massa_terminal_B5
Isol_terminal_B5
Pad_B5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
