Gecesars/emb_ant/projetos/P2M21/mecanica_preliminar_R18/Grampo_POM_PRELIMINAR.step

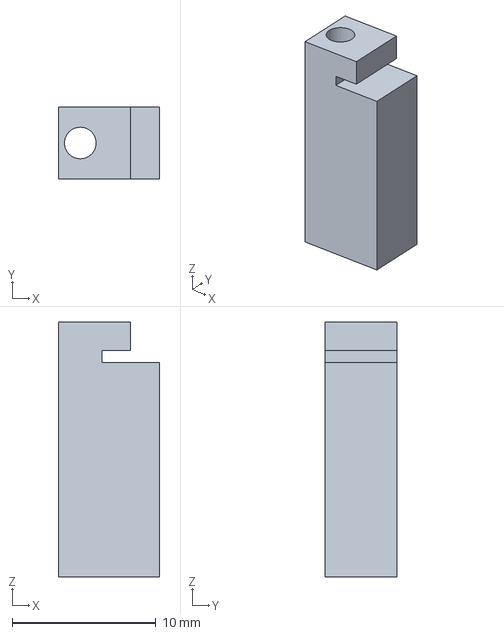
[picture p317: CAD file, 2026-11-10]
projetos/P2M21/mecanica_preliminar_R18/Grampo_POM_PRELIMINAR.step
7.00 x 5.00 x 17.8 mm
