Gecesars/emb_ant/projetos/P2M21/quatro_elementos_casamento_banda/c07_raiz_transicoes/4_elementos.FCStd

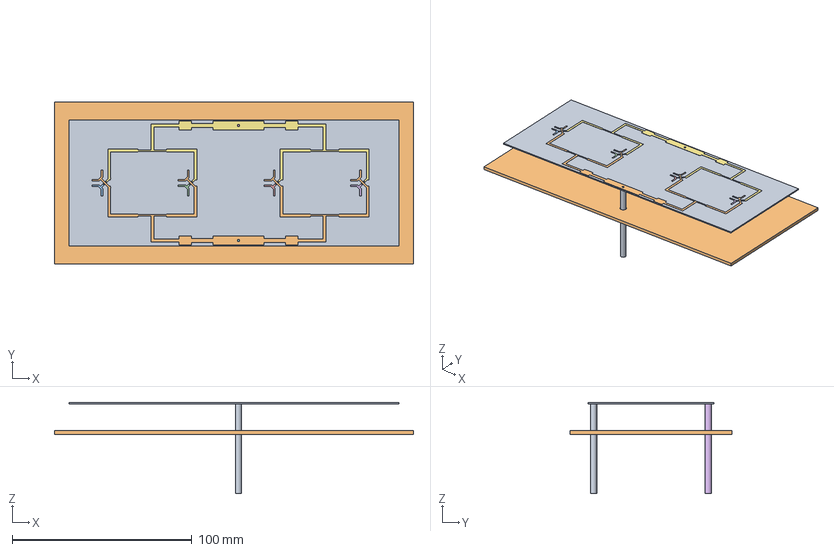
[picture p319: CAD file, 2026-11-10]
projetos/P2M21/quatro_elementos_casamento_banda/c07_raiz_transicoes/4_elementos.FCStd
200.0 x 90.0 x 50.8 mm
PCB_RO4350B
B_E1_Q2_Cu0
B_E1_Q3_Cu0
B_E2_Q2_Cu0
B_E2_Q3_Cu0
B_E3_Q2_Cu0
B_E3_Q3_Cu0
B_E4_Q2_Cu0
B_E4_Q3_Cu0
B_RET_A_Cu0
B_RET_B_Cu0
B_SIG_A_Cu0
B_SIG_B_Cu0
B_SIG_B_Cu1
B_SIG_B_Cu2
B_SIG_B_Cu3
B_SIG_B_Cu4
F_SIG_A_Cu0
F_SIG_B_Cu0
F_SIG_B_Cu1
F_SIG_B_Cu2
F_SIG_B_Cu3
F_SIG_B_Cu4
Via_0
Via_1
Via_2
Via_3
Via_4
Via_5
Via_6
Via_7
Vivo_A
Blindagem_A
PTFE_A
Solda_A
PTH_A
Vivo_B
Blindagem_B
PTFE_B
Solda_B
PTH_B
Refletor_Al2mm
