Gecesars/emb_ant/projetos/P2M21/rede_dez_1x4/freecad/P2M21_Dez_1x4_Posicionamento.FCStd

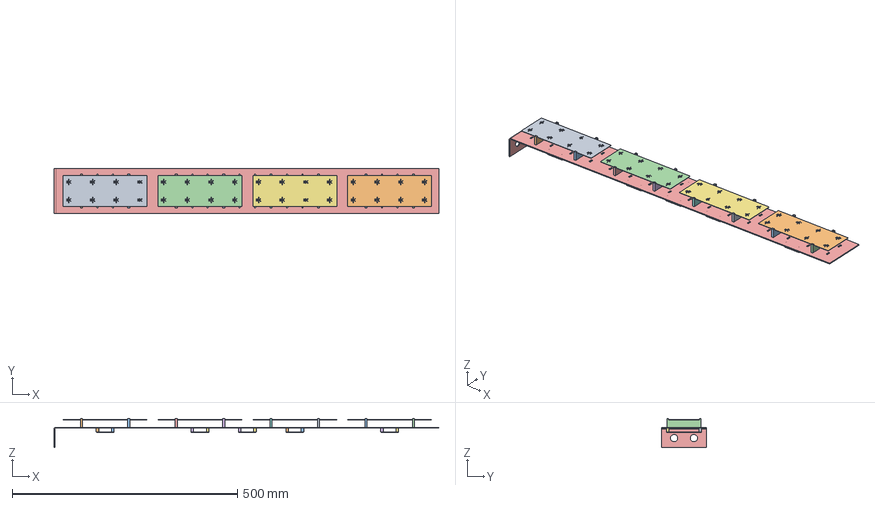
[picture p321: CAD file, 2026-11-09]
projetos/P2M21/rede_dez_1x4/freecad/P2M21_Dez_1x4_Posicionamento.FCStd
854.0 x 100.0 x 64.6 mm
E01_Ant01_Ring_Q1
E01_Ant01_Ring_Q2
E01_Ant01_Ring_Q3
E01_Ant01_Ring_Q4
E01_Ant01_Crossover_Bridge
E01_Ant01_Feed_A_Cu0
E01_Ant01_Feed_A_Cu1
E01_Ant01_Feed_B_Outer
E01_Ant01_Feed_B_Inner_Cu0
E01_Ant01_Feed_B_Inner_Cu1
E01_Via00_0
E01_Via00_1
E01_Sinal_INF_A1
E01_Capa_INF_A1
E01_Sinal_INF_B1
E01_Capa_INF_B1
E01_Solda_terminal_00
E01_Solda_terminal_01
E01_Solda_terminal_02
E01_Solda_terminal_03
E02_Ant01_Ring_Q1
E02_Ant01_Ring_Q2
E02_Ant01_Ring_Q3
E02_Ant01_Ring_Q4
E02_Ant01_Crossover_Bridge
E02_Ant01_Feed_A_Cu0
E02_Ant01_Feed_A_Cu1
E02_Ant01_Feed_B_Outer
E02_Ant01_Feed_B_Inner_Cu0
E02_Ant01_Feed_B_Inner_Cu1
E02_Via00_0
E02_Via00_1
E02_Sinal_INF_A1
E02_Capa_INF_A1
E02_Sinal_INF_B1
E02_Capa_INF_B1
E02_Solda_terminal_00
E02_Solda_terminal_01
E02_Solda_terminal_02
E02_Solda_terminal_03
E03_Ant01_Ring_Q1
E03_Ant01_Ring_Q2
E03_Ant01_Ring_Q3
E03_Ant01_Ring_Q4
E03_Ant01_Crossover_Bridge
E03_Ant01_Feed_A_Cu0
E03_Ant01_Feed_A_Cu1
E03_Ant01_Feed_B_Outer
E03_Ant01_Feed_B_Inner_Cu0
E03_Ant01_Feed_B_Inner_Cu1
E03_Via00_0
E03_Via00_1
E03_Sinal_INF_A1
E03_Capa_INF_A1
E03_Sinal_INF_B1
E03_Capa_INF_B1
E03_Solda_terminal_00
E03_Solda_terminal_01
E03_Solda_terminal_02
E03_Solda_terminal_03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
