Gecesars/emb_ant/projetos/P2S13/casamento_c09/c01/divisor/cad/folha_cu.step

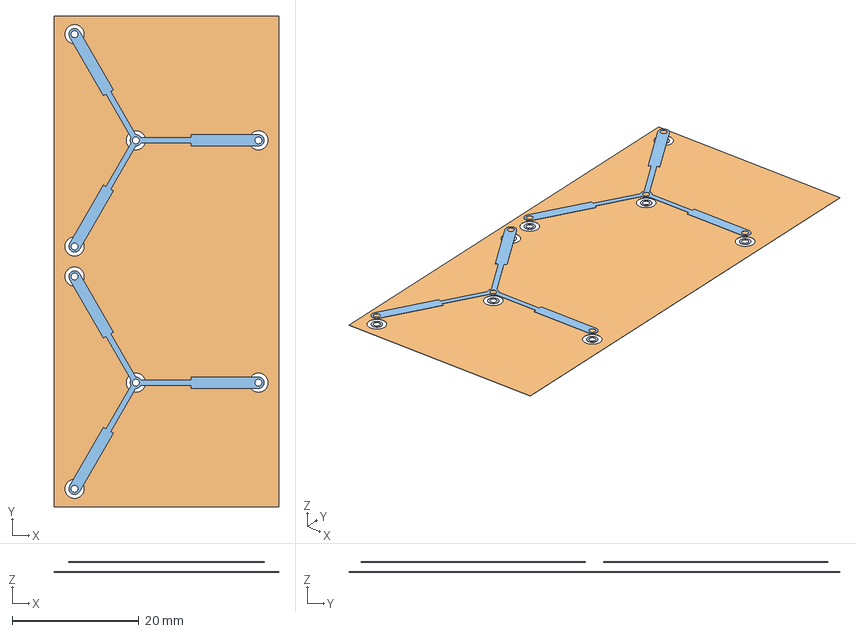
[picture p322: CAD file, 2026-11-12]
projetos/P2S13/casamento_c09/c01/divisor/cad/folha_cu.step
35.4 x 77.4 x 1.59 mm
Ilha_inferior_IN_A
Ilha_inferior_R1_A
Ilha_inferior_R2_A
Ilha_inferior_R3_A
Ilha_inferior_IN_B
Ilha_inferior_R1_B
Ilha_inferior_R2_B
Ilha_inferior_R3_B
Terra
Sinal_A
Sinal_B
