Gecesars/emb_ant/projetos/P2S13/compacto_c09/c00/divisor/Divisor_Duplo3.FCStd

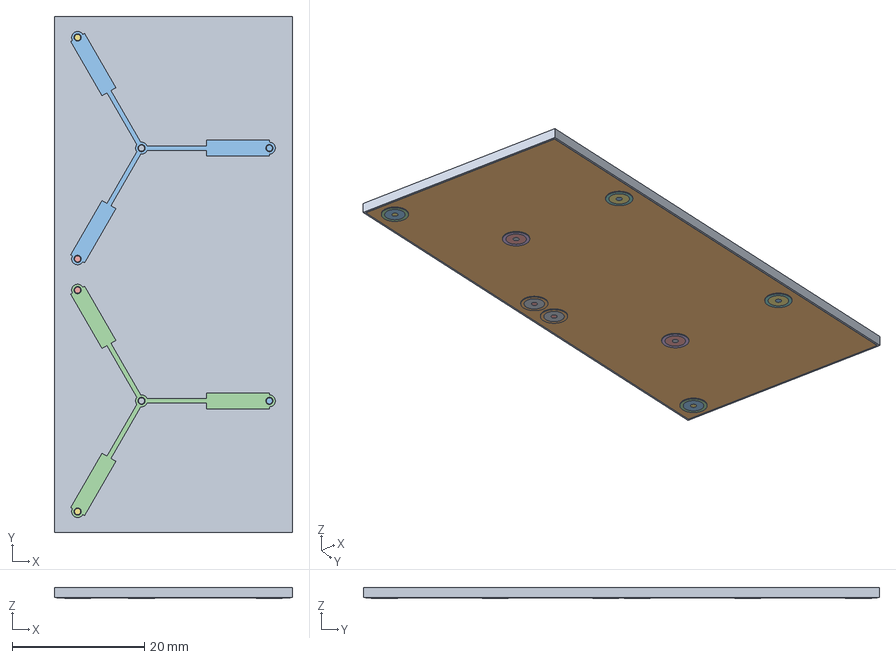
[picture p327: CAD file, 2026-11-12]
projetos/P2S13/compacto_c09/c00/divisor/Divisor_Duplo3.FCStd
36.0 x 78.0 x 1.74 mm
Pino_IN_A
Barril_IN_A
Solda_IN_A
Ilha_inferior_IN_A
PTFE_IN_A
Massa_IN_A
Pino_R1_A
Barril_R1_A
Solda_R1_A
Ilha_inferior_R1_A
PTFE_R1_A
Massa_R1_A
Pino_R2_A
Barril_R2_A
Solda_R2_A
Ilha_inferior_R2_A
PTFE_R2_A
Massa_R2_A
Pino_R3_A
Barril_R3_A
Solda_R3_A
Ilha_inferior_R3_A
PTFE_R3_A
Massa_R3_A
Pino_IN_B
Barril_IN_B
Solda_IN_B
Ilha_inferior_IN_B
PTFE_IN_B
Massa_IN_B
Pino_R1_B
Barril_R1_B
Solda_R1_B
Ilha_inferior_R1_B
PTFE_R1_B
Massa_R1_B
Pino_R2_B
Barril_R2_B
Solda_R2_B
Ilha_inferior_R2_B
PTFE_R2_B
Massa_R2_B
Pino_R3_B
Barril_R3_B
Solda_R3_B
Ilha_inferior_R3_B
PTFE_R3_B
Massa_R3_B
Substrato
Terra
Sinal_A
Sinal_B
