Gecesars/emb_ant/projetos/P2S13/divisor_duplo_1x3_correcao/c00_direto/cad/copper.step

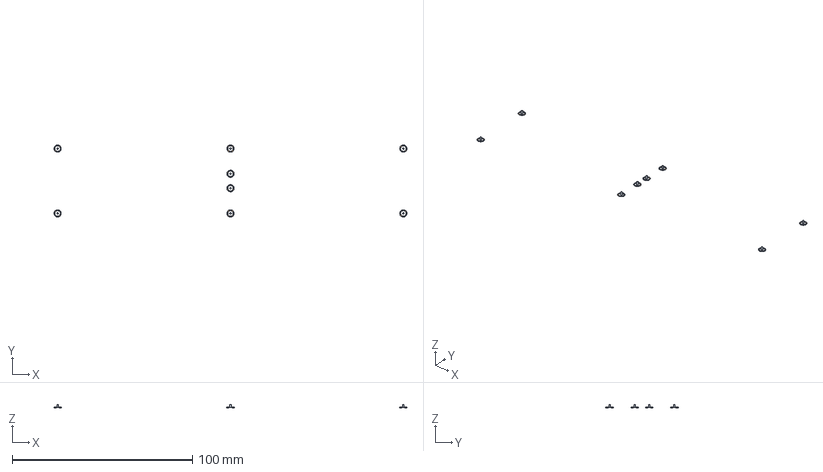
[picture p331: CAD file, 2026-11-11]
projetos/P2S13/divisor_duplo_1x3_correcao/c00_direto/cad/copper.step
196.0 x 40.0 x 1.73 mm
Pino_IN_A
Massa_IN_A
Pino_R1_A
Massa_R1_A
Pino_R2_A
Massa_R2_A
Pino_R3_A
Massa_R3_A
Pino_IN_B
Massa_IN_B
Pino_R1_B
Massa_R1_B
Pino_R2_B
Massa_R2_B
Pino_R3_B
Massa_R3_B
