Gecesars/emb_ant/projetos/P2S13/divisor_duplo_1x3_correcao/c01_aberto/cad/PTFE_terminal.step

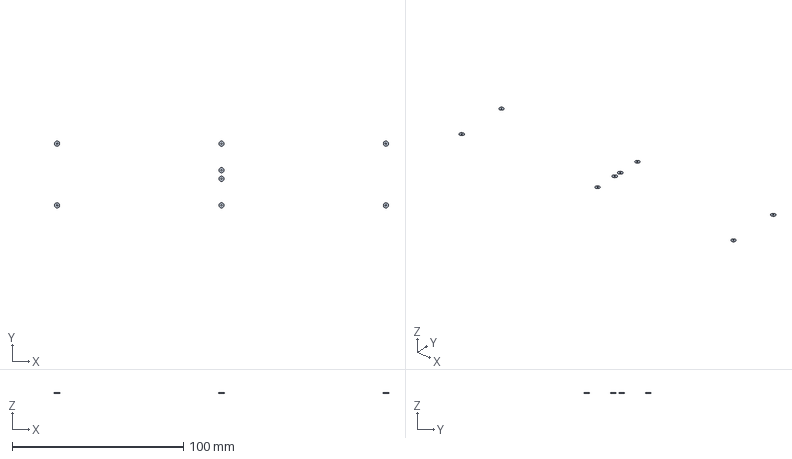
[picture p333: CAD file, 2026-11-11]
projetos/P2S13/divisor_duplo_1x3_correcao/c01_aberto/cad/PTFE_terminal.step
195.0 x 39.0 x 0.18 mm
PTFE_IN_A
PTFE_R1_A
PTFE_R2_A
PTFE_R3_A
PTFE_IN_B
PTFE_R1_B
PTFE_R2_B
PTFE_R3_B
