Gecesars/emb_ant/projetos/P2S13/divisor_duplo_1x3_correcao/c02_fase/cad/SAC305.step

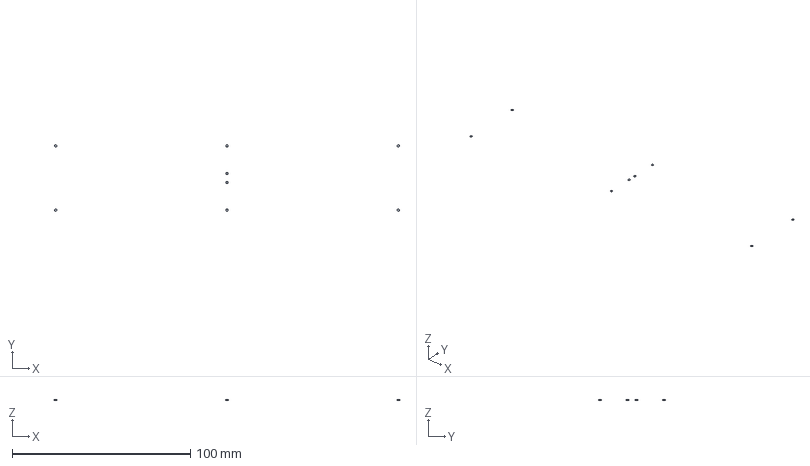
[picture p334: CAD file, 2026-11-11]
projetos/P2S13/divisor_duplo_1x3_correcao/c02_fase/cad/SAC305.step
193.3 x 37.3 x 0.07 mm
Solda_IN_A
Solda_R1_A
Solda_R2_A
Solda_R3_A
Solda_IN_B
Solda_R1_B
Solda_R2_B
Solda_R3_B
