Gecesars/emb_ant/projetos/P2S13/divisor_duplo_1x3_correcao/c03_ordem2/cad/ZYF300.step

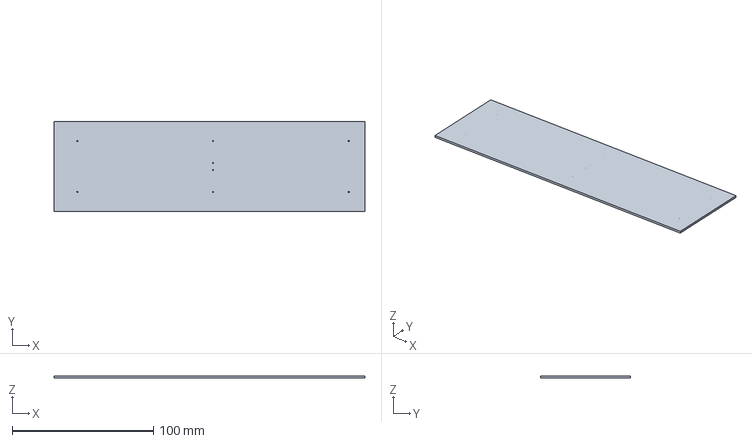
[picture p335: CAD file, 2026-11-11]
projetos/P2S13/divisor_duplo_1x3_correcao/c03_ordem2/cad/ZYF300.step
220.0 x 64.0 x 1.52 mm
