Gecesars/emb_ant/projetos/P2S13/divisor_duplo_1x3_correcao/c04_mascara/cad/folha_cu.step

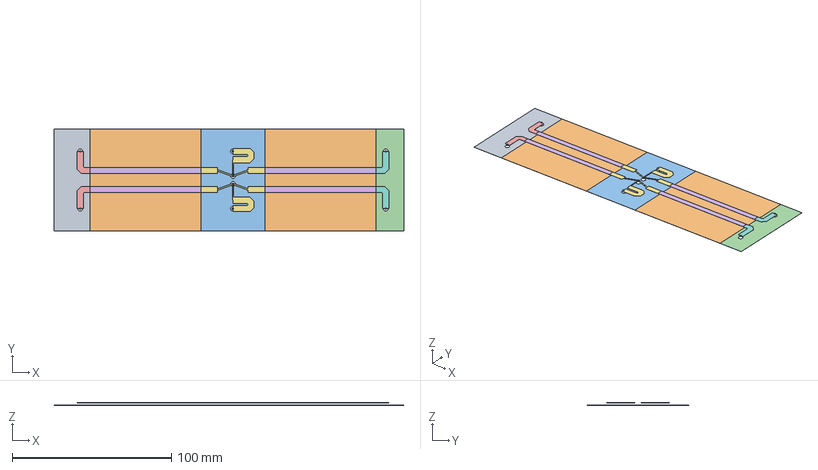
[picture p336: CAD file, 2026-11-11]
projetos/P2S13/divisor_duplo_1x3_correcao/c04_mascara/cad/folha_cu.step
220.0 x 64.0 x 1.59 mm
Terra_0
Terra_1
Terra_2
Terra_3
Terra_4
Sinal_A_0
Sinal_A_1
Sinal_A_2
Sinal_A_3
Sinal_A_4
Sinal_B_0
Sinal_B_1
Sinal_B_2
Sinal_B_3
Sinal_B_4
