Gecesars/emb_ant/projetos/P2S13/divisor_duplo_1x3_correcao/c04_mascara/Divisor_Duplo3.FCStd

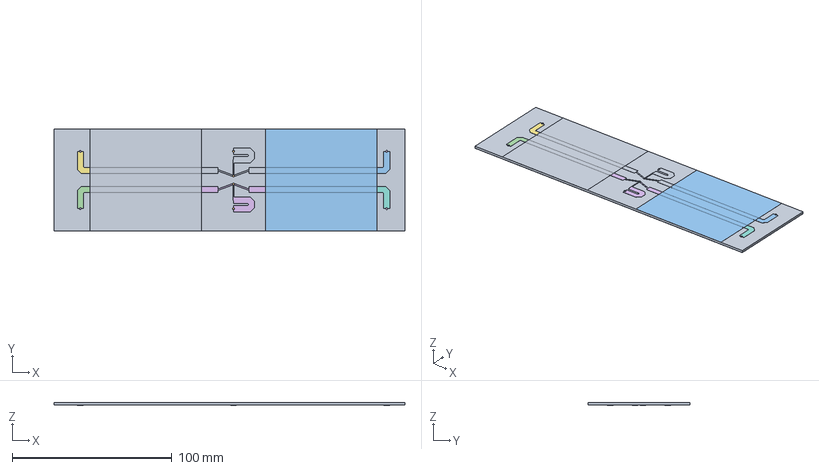
[picture p337: CAD file, 2026-11-11]
projetos/P2S13/divisor_duplo_1x3_correcao/c04_mascara/Divisor_Duplo3.FCStd
220.0 x 64.0 x 1.80 mm
Pino_IN_A
Solda_IN_A
PTFE_IN_A
Massa_IN_A
Pino_R1_A
Solda_R1_A
PTFE_R1_A
Massa_R1_A
Pino_R2_A
Solda_R2_A
PTFE_R2_A
Massa_R2_A
Pino_R3_A
Solda_R3_A
PTFE_R3_A
Massa_R3_A
Pino_IN_B
Solda_IN_B
PTFE_IN_B
Massa_IN_B
Pino_R1_B
Solda_R1_B
PTFE_R1_B
Massa_R1_B
Pino_R2_B
Solda_R2_B
PTFE_R2_B
Massa_R2_B
Pino_R3_B
Solda_R3_B
PTFE_R3_B
Massa_R3_B
Substrato
Terra_0
Terra_1
Terra_2
Terra_3
Terra_4
Sinal_A_0
Sinal_A_1
Sinal_A_2
Sinal_A_3
Sinal_A_4
Sinal_B_0
Sinal_B_1
Sinal_B_2
Sinal_B_3
Sinal_B_4
Mascara_top_1
Mascara_bottom_1
Mascara_top_3
Mascara_bottom_3
