Gecesars/emb_ant/projetos/P2S13/dobras_placas_ajustadas/d00_b3_a90/cad/AL5052.step

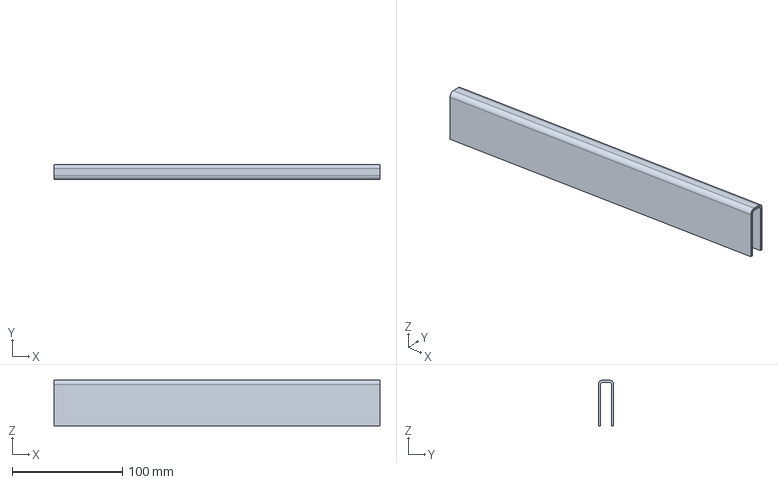
[picture p340: CAD file, 2026-11-11]
projetos/P2S13/dobras_placas_ajustadas/d00_b3_a90/cad/AL5052.step
296.0 x 14.0 x 41.6 mm
