Gecesars/emb_ant/projetos/P2S13/dobras_placas_ajustadas/d01_b20_a120/cad/AL5052.step

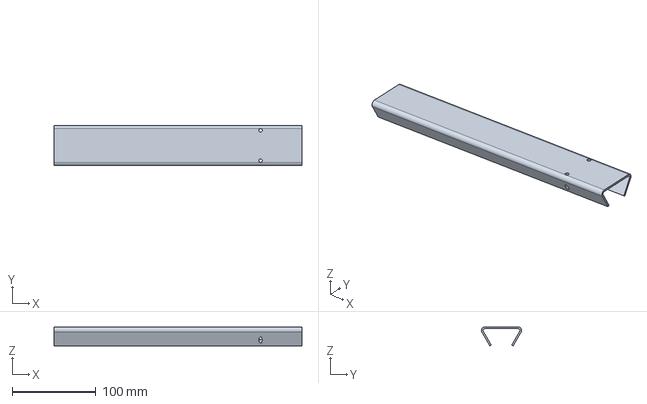
[picture p342: CAD file, 2026-11-11]
projetos/P2S13/dobras_placas_ajustadas/d01_b20_a120/cad/AL5052.step
296.0 x 48.0 x 22.6 mm
