Gecesars/emb_ant/projetos/P2S13/dobras_placas_ajustadas/d02_b20_a150/cad/AL5052.step

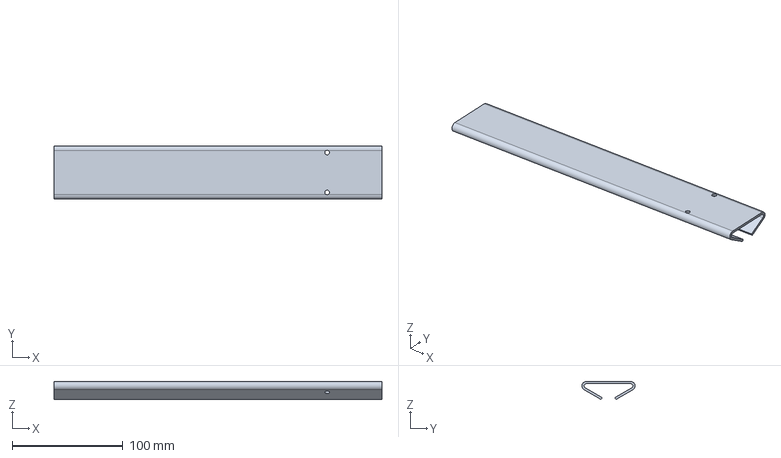
[picture p343: CAD file, 2026-11-11]
projetos/P2S13/dobras_placas_ajustadas/d02_b20_a150/cad/AL5052.step
296.0 x 48.0 x 16.3 mm
