Gecesars/emb_ant/projetos/P2S13/mecanica_R17/alternativa_plana/Refletor_plano_alternativo.step

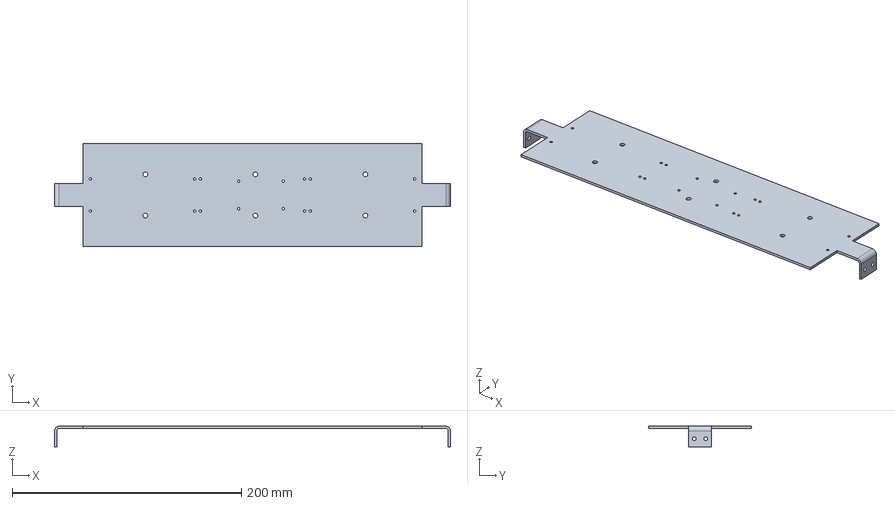
[picture p345: CAD file, 2026-11-12]
projetos/P2S13/mecanica_R17/alternativa_plana/Refletor_plano_alternativo.step
345.6 x 90.0 x 18.0 mm
