Gecesars/emb_ant/projetos/P2S13/mecanica_R17/documentacao/Flange_Inferior.dxf

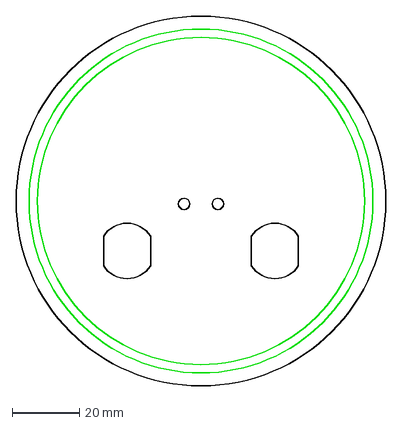
[picture p346: CAD file, 2026-11-12]
projetos/P2S13/mecanica_R17/documentacao/Flange_Inferior.dxf
110.0 x 110.0 mm
