Gecesars/emb_ant/projetos/P2S13/refletor_nativo_b20_60/cad/SAC305.step

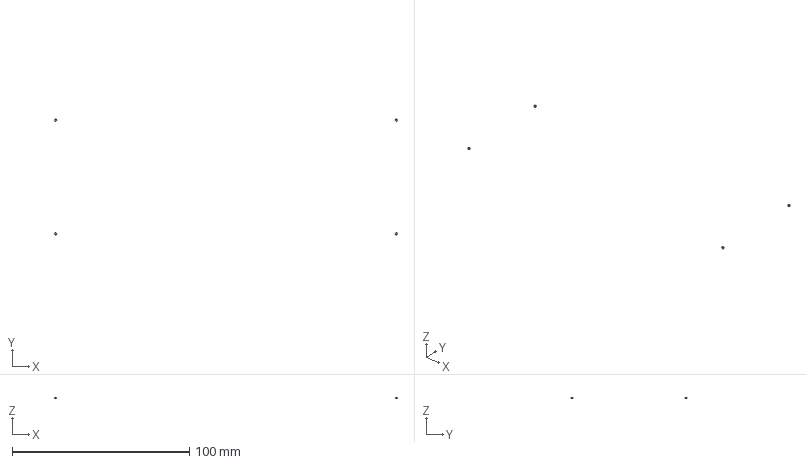
[picture p348: CAD file, 2026-11-10]
projetos/P2S13/refletor_nativo_b20_60/cad/SAC305.step
193.3 x 65.3 x 0.83 mm
R1_Solda_A
R1_Solda_B
R2_Solda_A
R2_Solda_B
