Gecesars/emb_ant/projetos/P2S13/refletor_nativo_b20_60/P2S13.FCStd

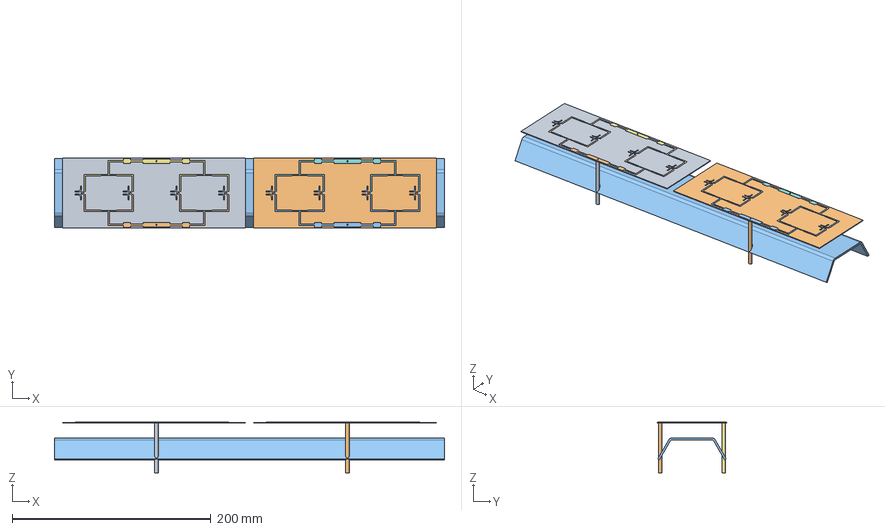
[picture p349: CAD file, 2026-11-10]
projetos/P2S13/refletor_nativo_b20_60/P2S13.FCStd
392.0 x 70.0 x 50.8 mm
R1_PCB_RO4350B
R1_B_E1_Q2_Cu0
R1_B_E1_Q3_Cu0
R1_B_E2_Q2_Cu0
R1_B_E2_Q3_Cu0
R1_B_E3_Q2_Cu0
R1_B_E3_Q3_Cu0
R1_B_E4_Q2_Cu0
R1_B_E4_Q3_Cu0
R1_B_RET_A_Cu0
R1_B_RET_B_Cu0
R1_B_SIG_A_Cu0
R1_B_SIG_B_Cu0
R1_B_SIG_B_Cu1
R1_B_SIG_B_Cu2
R1_B_SIG_B_Cu3
R1_B_SIG_B_Cu4
R1_F_SIG_A_Cu0
R1_F_SIG_B_Cu0
R1_F_SIG_B_Cu1
R1_F_SIG_B_Cu2
R1_F_SIG_B_Cu3
R1_F_SIG_B_Cu4
R1_Via_0
R1_Via_1
R1_Via_2
R1_Via_3
R1_Via_4
R1_Via_5
R1_Via_6
R1_Via_7
R1_Vivo_A
R1_Blindagem_A
R1_PTFE_A
R1_Solda_A
R1_PTH_A
R1_Vivo_B
R1_Blindagem_B
R1_PTFE_B
R1_Solda_B
R1_PTH_B
R2_PCB_RO4350B
R2_B_E1_Q2_Cu0
R2_B_E1_Q3_Cu0
R2_B_E2_Q2_Cu0
R2_B_E2_Q3_Cu0
R2_B_E3_Q2_Cu0
R2_B_E3_Q3_Cu0
R2_B_E4_Q2_Cu0
R2_B_E4_Q3_Cu0
R2_B_RET_A_Cu0
R2_B_RET_B_Cu0
R2_B_SIG_A_Cu0
R2_B_SIG_B_Cu0
R2_B_SIG_B_Cu1
R2_B_SIG_B_Cu2
R2_B_SIG_B_Cu3
R2_B_SIG_B_Cu4
R2_F_SIG_A_Cu0
R2_F_SIG_B_Cu0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
