Gecesars/emb_ant/projetos/P2S13/tres_placas2/t00_b3_a90/P2S13_TresPCB2.FCStd

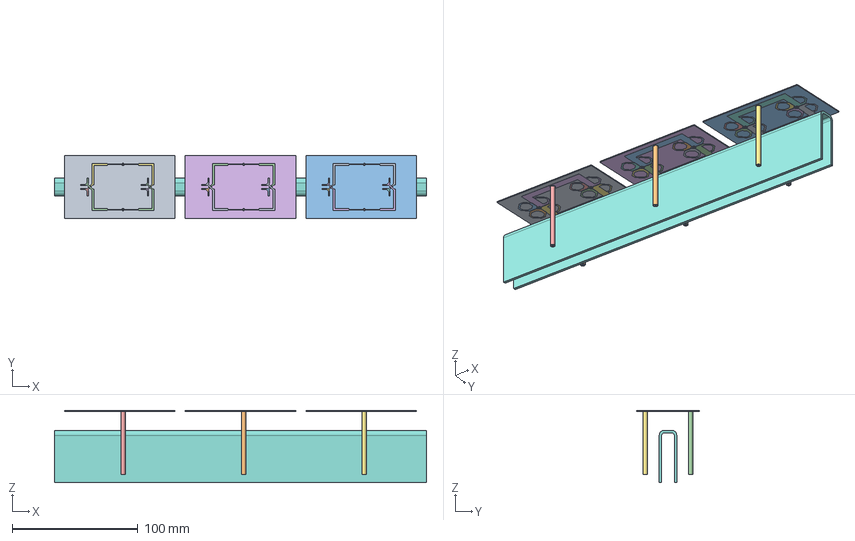
[picture p351: CAD file, 2026-11-11]
projetos/P2S13/tres_placas2/t00_b3_a90/P2S13_TresPCB2.FCStd
296.0 x 50.0 x 57.4 mm
R1_PCB_RO4350B
R1_B_E1_Q2_Cu0
R1_B_E1_Q3_Cu0
R1_B_E2_Q2_Cu0
R1_B_E2_Q3_Cu0
R1_B_RET_A_Cu0
R1_B_RET_B_Cu0
R1_B_SIG_A_Cu0
R1_B_SIG_B_Cu0
R1_B_SIG_B_Cu1
R1_B_SIG_B_Cu2
R1_F_SIG_A_Cu0
R1_F_SIG_B_Cu0
R1_F_SIG_B_Cu1
R1_F_SIG_B_Cu2
R1_Via_0
R1_Via_1
R1_Via_2
R1_Via_3
R1_Vivo_A
R1_Blindagem_A
R1_PTFE_A
R1_Solda_A
R1_PTH_A
R1_Vivo_B
R1_Blindagem_B
R1_PTFE_B
R1_Solda_B
R1_PTH_B
R2_PCB_RO4350B
R2_B_E1_Q2_Cu0
R2_B_E1_Q3_Cu0
R2_B_E2_Q2_Cu0
R2_B_E2_Q3_Cu0
R2_B_RET_A_Cu0
R2_B_RET_B_Cu0
R2_B_SIG_A_Cu0
R2_B_SIG_B_Cu0
R2_B_SIG_B_Cu1
R2_B_SIG_B_Cu2
R2_F_SIG_A_Cu0
R2_F_SIG_B_Cu0
R2_F_SIG_B_Cu1
R2_F_SIG_B_Cu2
R2_Via_0
R2_Via_1
R2_Via_2
R2_Via_3
R2_Vivo_A
R2_Blindagem_A
R2_PTFE_A
R2_Solda_A
R2_PTH_A
R2_Vivo_B
R2_Blindagem_B
R2_PTFE_B
R2_Solda_B
R2_PTH_B
R3_PCB_RO4350B
R3_B_E1_Q2_Cu0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
