Gecesars/emb_ant/projetos/P2S13/tres_placas2/t02_b22_a150/cad/AL5052.step

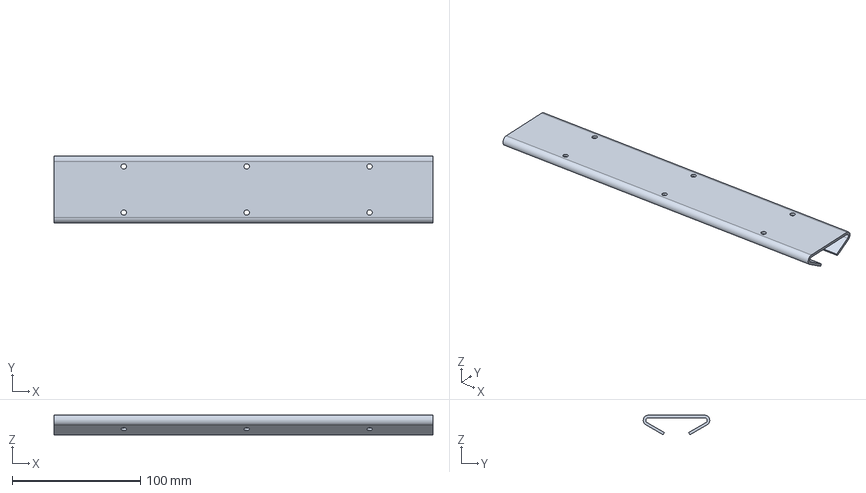
[picture p353: CAD file, 2026-11-11]
projetos/P2S13/tres_placas2/t02_b22_a150/cad/AL5052.step
296.0 x 52.0 x 15.3 mm
