Gecesars/emb_ant/projetos/P2S13/tres_placas2/t03_b24_a150/cad/AL5052.step

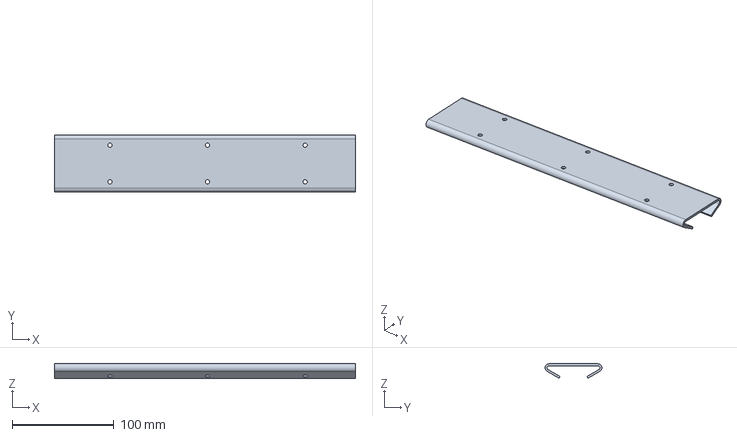
[picture p355: CAD file, 2026-11-11]
projetos/P2S13/tres_placas2/t03_b24_a150/cad/AL5052.step
296.0 x 56.0 x 14.3 mm
