Gecesars/emb_ant/projetos/P2S13/tres_placas2/t04_b28p5_a150/cad/AL5052.step

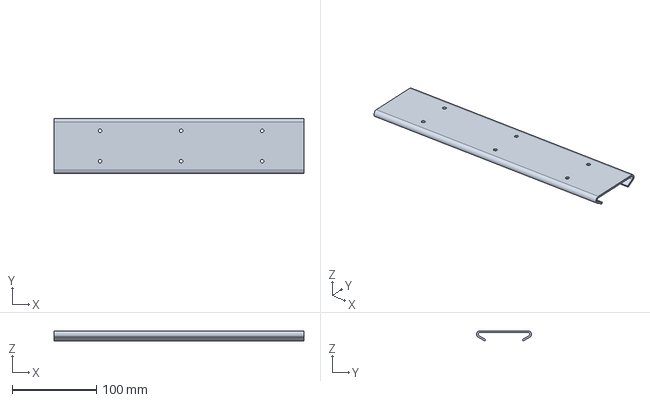
[picture p357: CAD file, 2026-11-11]
projetos/P2S13/tres_placas2/t04_b28p5_a150/cad/AL5052.step
296.0 x 65.0 x 12.0 mm
