Gecesars/emb_ant/freecad/Divisor_2x10_PTFE.FCStd

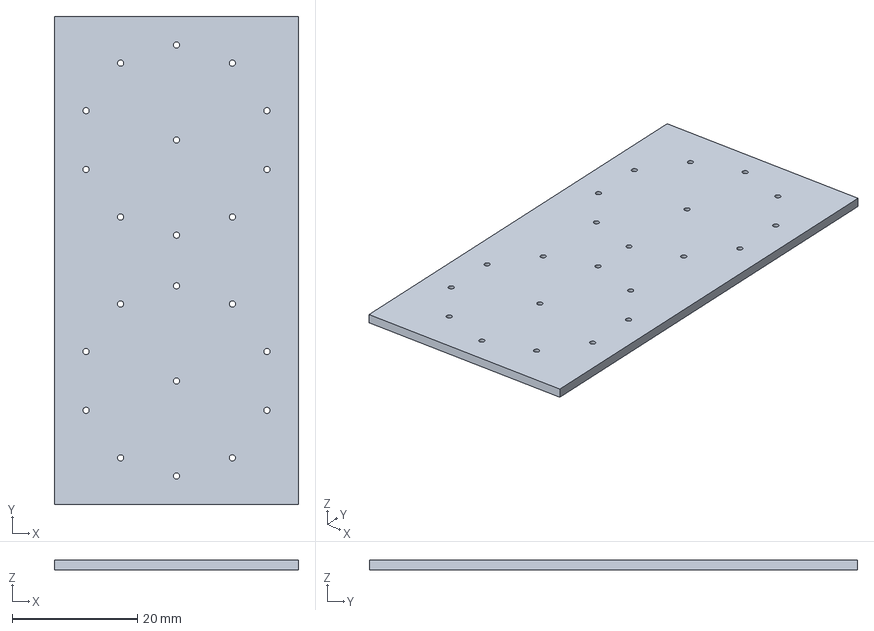
[picture p360: CAD file, 2026-11-06]
freecad/Divisor_2x10_PTFE.FCStd
39.0 x 78.0 x 1.52 mm
