Gecesars/emb_ant/freecad/mecanica_R01/01_Refletor_dobrado.step

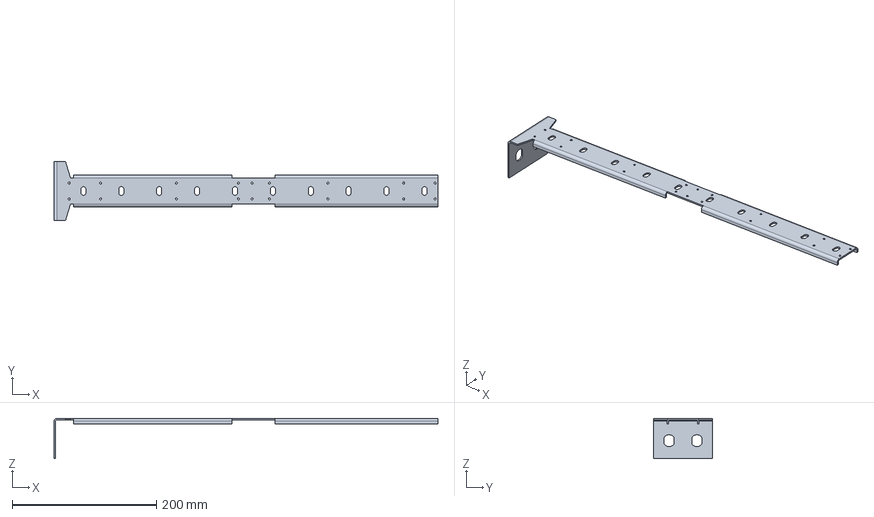
[picture p361: CAD file, 2026-11-06]
freecad/mecanica_R01/01_Refletor_dobrado.step
533.0 x 82.0 x 56.0 mm
