Gecesars/emb_ant/freecad/mecanica_R02/componentes/Trilho_INF_D.step

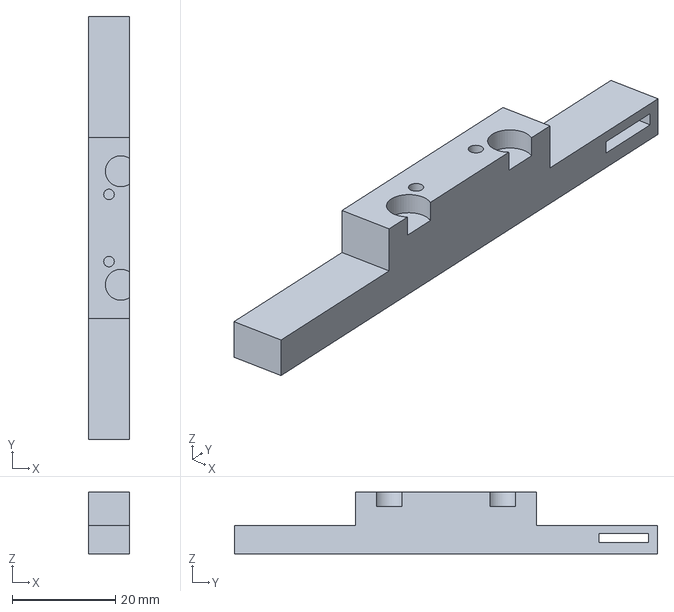
[picture p362: CAD file, 2026-11-06]
freecad/mecanica_R02/componentes/Trilho_INF_D.step
8.00 x 82.0 x 12.0 mm
