Gecesars/emb_ant/freecad/mecanica_R02/P1H_R02_compacta.FCStd

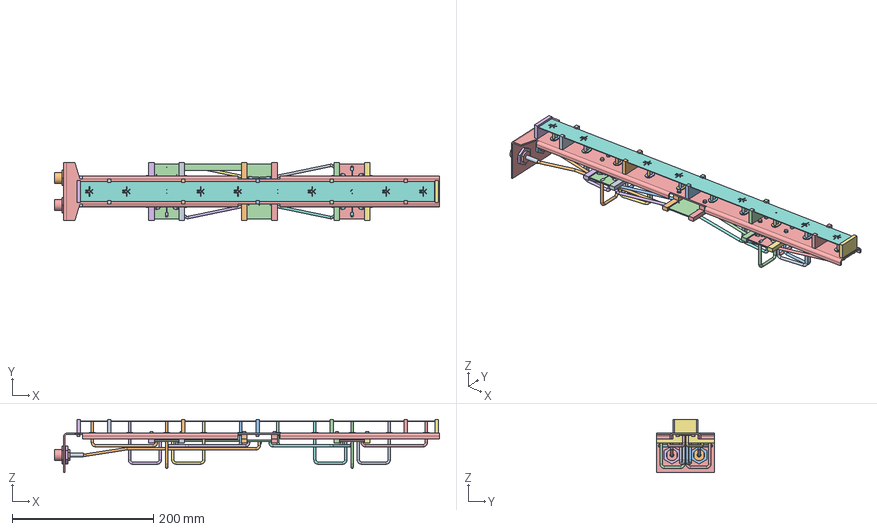
[picture p363: CAD file, 2026-11-06]
freecad/mecanica_R02/P1H_R02_compacta.FCStd
546.0 x 82.0 x 75.6 mm
Berco_1
Berco_2
Berco_3
Berco_4
Berco_5
Batente_6
Batente_7
Nucleo_continuo
CobreRF_01
CobreRF_02
CobreRF_03
CobreRF_04
CobreRF_05
CobreRF_06
CobreRF_07
CobreRF_08
CobreRF_09
CobreRF_10
Passa_cabos_01
Passa_cabos_02
Passa_cabos_03
Passa_cabos_04
Passa_cabos_05
Passa_cabos_06
Passa_cabos_07
Passa_cabos_08
Passa_cabos_09
Passa_cabos_10
Conector_N_A
Porca_N_A
Arruela_N_A
Junta_N_A
Termorretratil_N_A
Conector_N_B
Porca_N_B
Arruela_N_B
Junta_N_B
Termorretratil_N_B
Par_0_0
Par_0_1
Par_1_0
Par_1_1
Par_2_0
Par_2_1
Par_3_0
Par_3_1
Par_4_0
Par_4_1
Par_5_0
Par_5_1
Par_6_0
Par_6_1
Refletor_R02
RF_INF_A
RF_INF_B
RF_SUP_A
RF_SUP_B
RF_RAIZ_A
RF_RAIZ_B
PCB_inferior_com_raiz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
