Gecesars/emb_ant/freecad/mecanica_R06/P1H_R06_compacta.FCStd

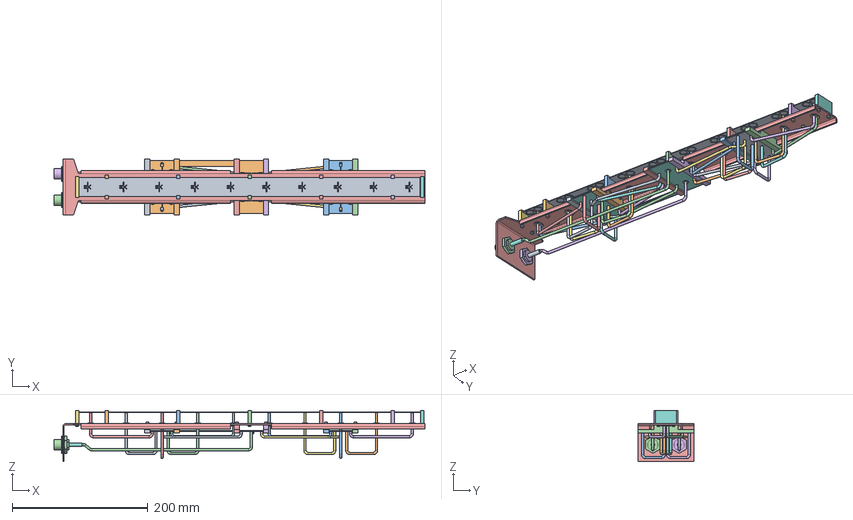
[picture p365: CAD file, 2026-11-07]
freecad/mecanica_R06/P1H_R06_compacta.FCStd
546.0 x 82.0 x 75.6 mm
Par_0_0
Par_0_001
Par_0_1
Par_0_003
Par_1_0
Par_1_001
Par_1_1
Par_1_003
Par_2_0
Par_2_001
Par_2_1
Par_2_003
Par_3_0
Par_3_001
Par_3_1
Par_3_003
Par_4_0
Par_4_001
Par_4_1
Par_4_003
Par_5_0
Par_5_001
Par_5_1
Par_5_003
Par_6_0
Par_6_001
Par_6_1
Par_6_003
Trilho_INF_E_par_0
Trilho_INF_E_par_001
Trilho_INF_E_par_1
Trilho_INF_E_par_003
Trilho_INF_D_par_0
Trilho_INF_D_par_001
Trilho_INF_D_par_1
Trilho_INF_D_par_003
Trilho_SUP_E_par_0
Trilho_SUP_E_par_001
Trilho_SUP_E_par_1
Trilho_SUP_E_par_003
Trilho_SUP_D_par_0
Trilho_SUP_D_par_001
Trilho_SUP_D_par_1
Trilho_SUP_D_par_003
Trilho_RAIZ_E_par_0
Trilho_RAIZ_E_par_001
Trilho_RAIZ_E_par_1
Trilho_RAIZ_E_par_003
Trilho_RAIZ_D_par_0
Trilho_RAIZ_D_par_001
Trilho_RAIZ_D_par_1
Trilho_RAIZ_D_par_003
Refletor_R05
Via00_0
Via00_1
Via01_0
Via01_1
Via02_0
Via02_1
Via03_0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
