Gecesars/emb_ant/freecad/modelos_RF_R06/antena/cad/aco_nom.step

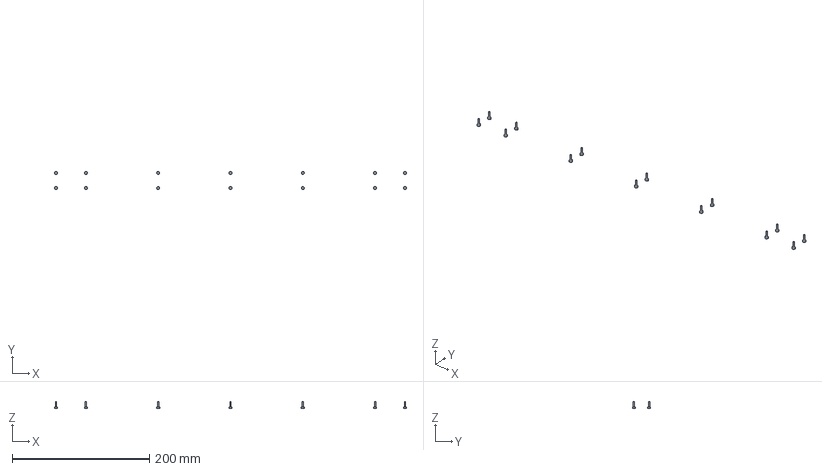
[picture p366: CAD file, 2026-11-08]
freecad/modelos_RF_R06/antena/cad/aco_nom.step
512.3 x 26.5 x 10.0 mm
Par_0_001
Par_0_003
Par_1_001
Par_1_003
Par_2_001
Par_2_003
Par_3_001
Par_3_003
Par_4_001
Par_4_003
Par_5_001
Par_5_003
Par_6_001
Par_6_003
