Gecesars/emb_ant/freecad/modelos_RF_R06/divisor_superior/cad/SAC305.step

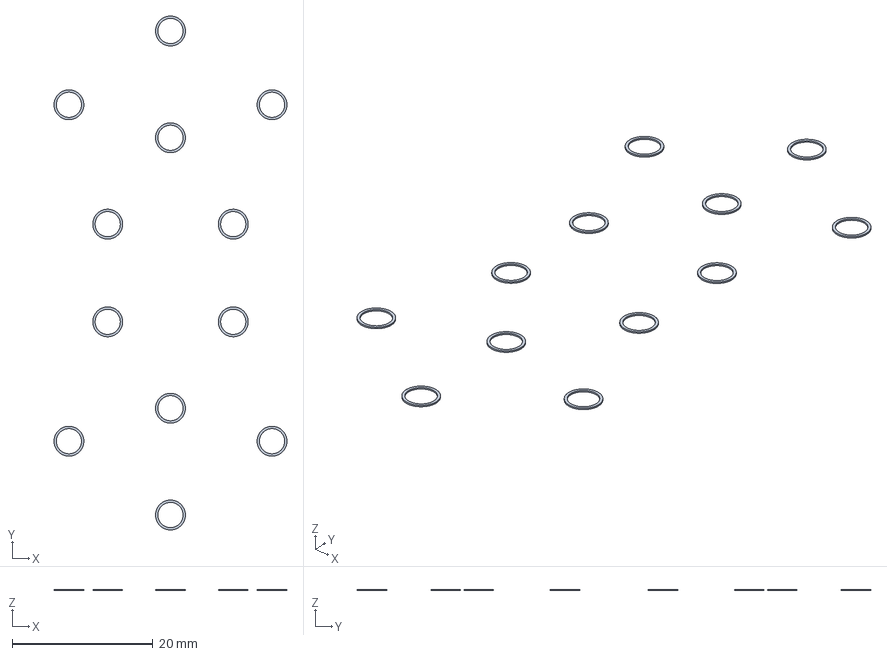
[picture p367: CAD file, 2026-11-08]
freecad/modelos_RF_R06/divisor_superior/cad/SAC305.step
33.2 x 73.2 x 0.18 mm
Solda_Superior_A_IN
Solda_Superior_A1
Solda_Superior_A2
Solda_Superior_A3
Solda_Superior_A4
Solda_Superior_A5
Solda_Superior_B_IN
Solda_Superior_B1
Solda_Superior_B2
Solda_Superior_B3
Solda_Superior_B4
Solda_Superior_B5
