Gecesars/emb_ant/projetos/P2M19/mecanica_R09_PRELIMINAR/P2M19_R09_PRELIMINAR.step

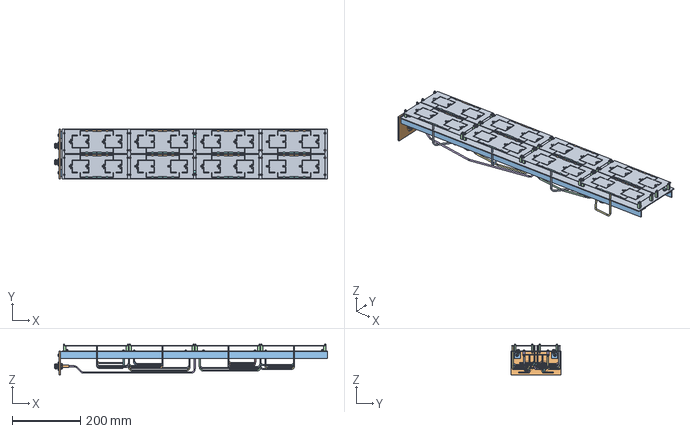
[picture p368: CAD file, 2026-11-14]
projetos/P2M19/mecanica_R09_PRELIMINAR/P2M19_R09_PRELIMINAR.step
797.3 x 146.0 x 90.1 mm
