Gecesars/emb_ant/projetos/P2M21/freecad/Refletor_dobrado.step

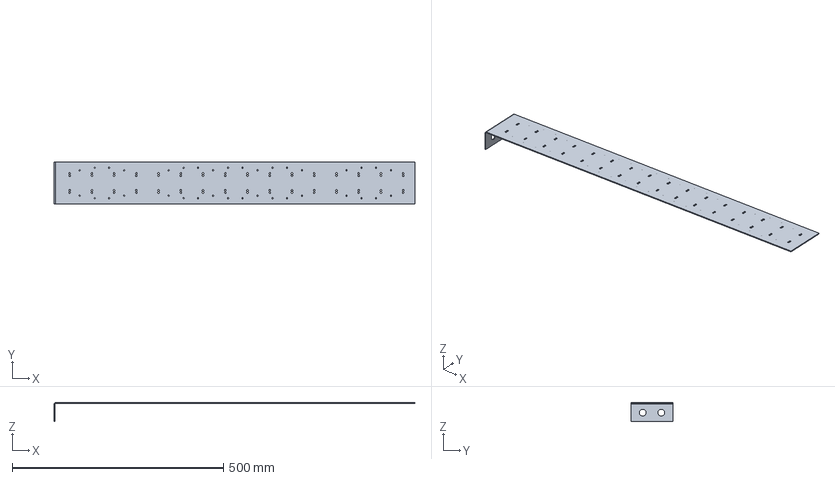
[picture p369: CAD file, 2026-11-08]
projetos/P2M21/freecad/Refletor_dobrado.step
854.0 x 100.0 x 45.0 mm
