Gecesars/emb_ant/projetos/P2M21/hfss/antena/cad/RO4350B_R01.step

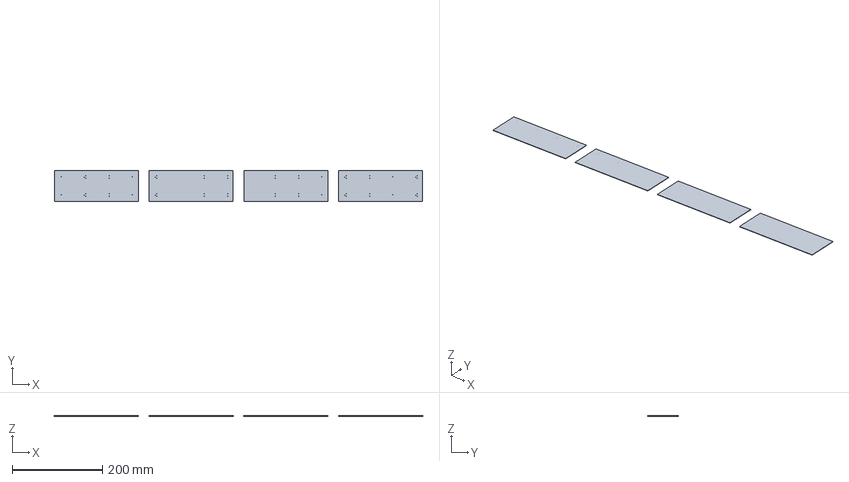
[picture p370: CAD file, 2026-11-08]
projetos/P2M21/hfss/antena/cad/RO4350B_R01.step
817.3 x 68.3 x 0.76 mm
PCB_Modulo_1
PCB_Modulo_2
PCB_Modulo_3
PCB_Modulo_4
