Gecesars/emb_ant/projetos/P2M21/mecanica_preliminar_R18/Refletor_CORTE_PRELIMINAR_1a1.dxf

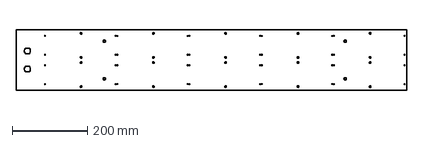
[picture p371: CAD file, 2026-11-10]
projetos/P2M21/mecanica_preliminar_R18/Refletor_CORTE_PRELIMINAR_1a1.dxf
1038.4 x 162.0 mm
