Gecesars/emb_ant/projetos/P2S13/casamento_c09/c01/divisor/cad/SAC305.step

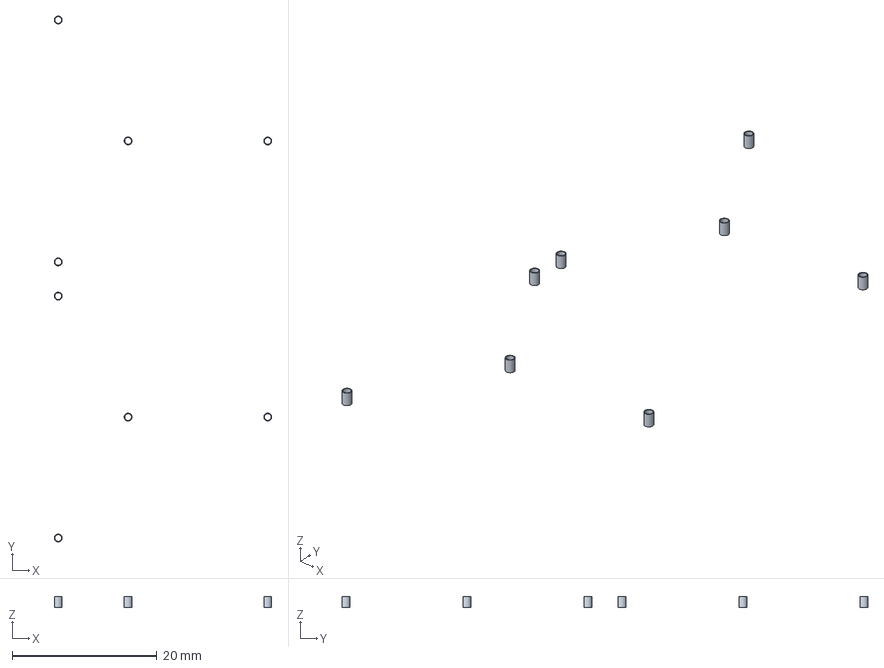
[picture p372: CAD file, 2026-11-12]
projetos/P2S13/casamento_c09/c01/divisor/cad/SAC305.step
30.1 x 72.8 x 1.59 mm
Solda_IN_A
Solda_R1_A
Solda_R2_A
Solda_R3_A
Solda_IN_B
Solda_R1_B
Solda_R2_B
Solda_R3_B
