Gecesars/emb_ant/projetos/P2S13/casamento_c09/c02/divisor/cad/ZYF300.step

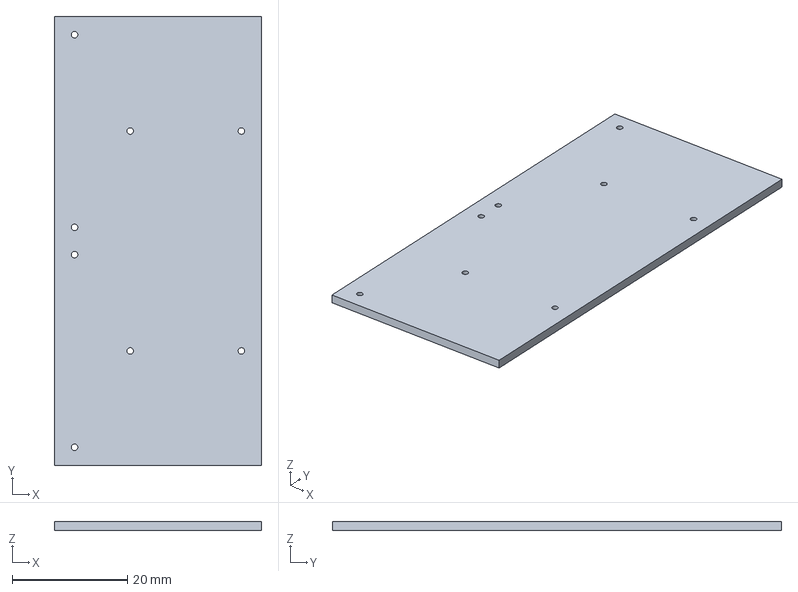
[picture p373: CAD file, 2026-11-12]
projetos/P2S13/casamento_c09/c02/divisor/cad/ZYF300.step
36.0 x 78.0 x 1.52 mm
