Gecesars/emb_ant/projetos/P2S13/divisor_duplo_1x3_hfss/c01_juncao/cad/Alumina_nominal.step

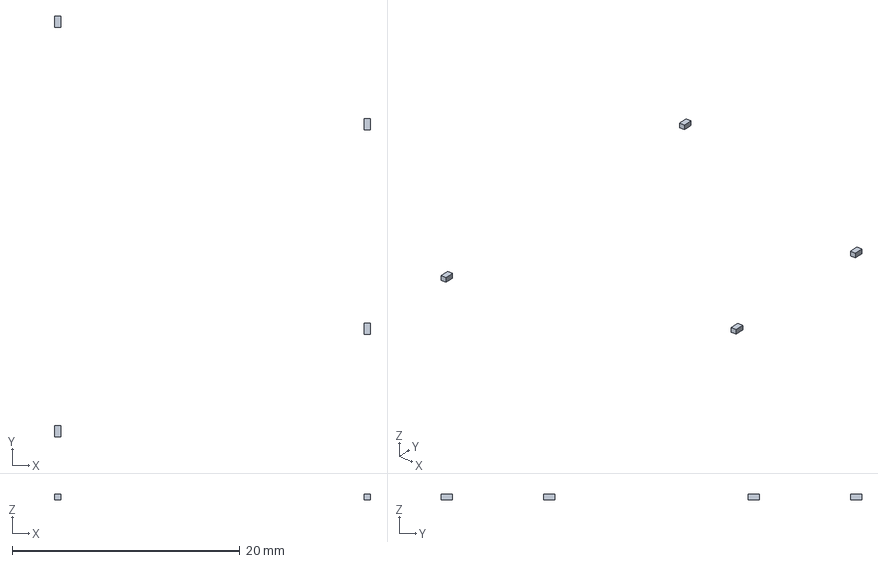
[picture p374: CAD file, 2026-11-11]
projetos/P2S13/divisor_duplo_1x3_hfss/c01_juncao/cad/Alumina_nominal.step
27.8 x 37.0 x 0.5 mm
Corpo_A_R106
Corpo_A_R100
Corpo_B_R106
Corpo_B_R100
