Gecesars/emb_ant/projetos/P2S13/mecanica_R17/Refletor_planificado_PRELIMINAR.step

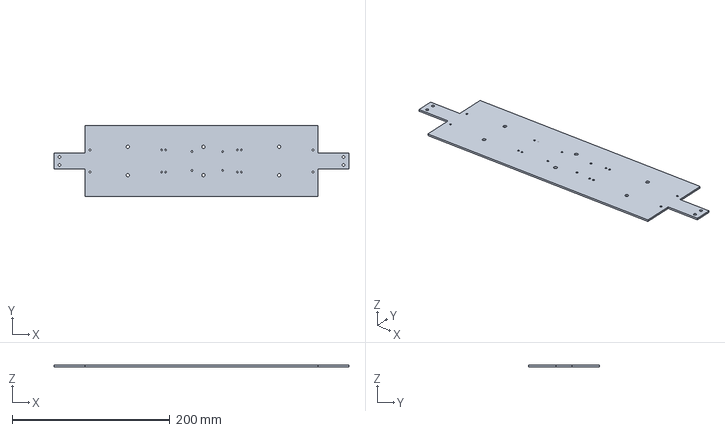
[picture p376: CAD file, 2026-11-12]
projetos/P2S13/mecanica_R17/Refletor_planificado_PRELIMINAR.step
374.4 x 90.0 x 2.00 mm
