Gecesars/emb_ant/projetos/P2S13/refletor_nativo_b20_60/cad/copper.step

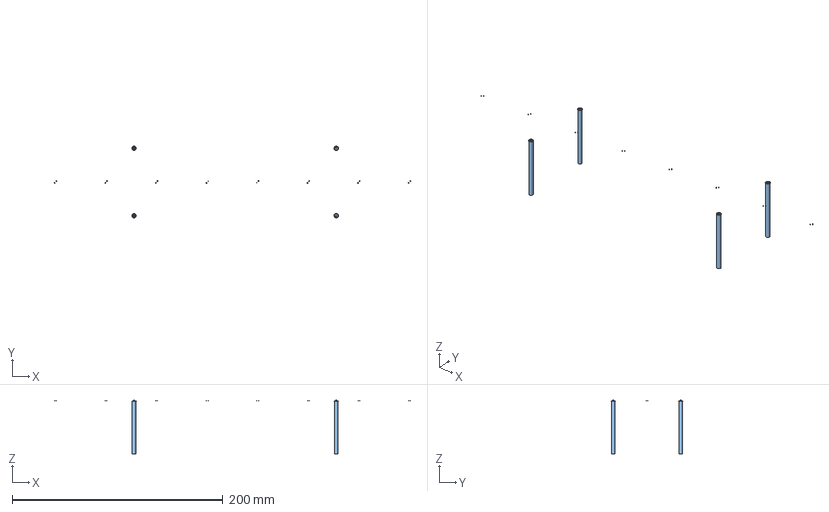
[picture p377: CAD file, 2026-11-10]
projetos/P2S13/refletor_nativo_b20_60/cad/copper.step
338.0 x 68.3 x 50.8 mm
R1_Via_0
R1_Via_1
R1_Via_2
R1_Via_3
R1_Via_4
R1_Via_5
R1_Via_6
R1_Via_7
R1_Vivo_A
R1_Blindagem_A
R1_PTH_A
R1_Vivo_B
R1_Blindagem_B
R1_PTH_B
R2_Via_0
R2_Via_1
R2_Via_2
R2_Via_3
R2_Via_4
R2_Via_5
R2_Via_6
R2_Via_7
R2_Vivo_A
R2_Blindagem_A
R2_PTH_A
R2_Vivo_B
R2_Blindagem_B
R2_PTH_B
