Gecesars/emb_ant/projetos/P2S13/refletor_nativo_b20_60/Refletor_nativo.step

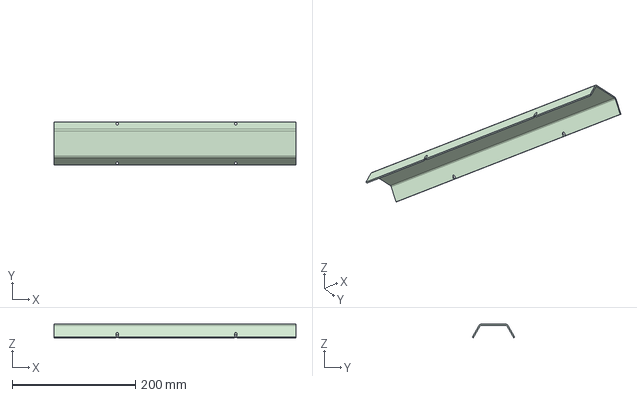
[picture p378: CAD file, 2026-11-10]
projetos/P2S13/refletor_nativo_b20_60/Refletor_nativo.step
392.0 x 69.0 x 22.1 mm
