Gecesars/emb_ant/(list of files, cad)

Other CAD files:
projetos/P2M19/estudo_72mm/casos/R02_16x2_72mm/P2M19_R02_16x2_72mm.FCStd
projetos/P2M21/comparacao_colunas_niveis/R16_Oito_Celulas_78mm/P2M21_8celulas_78mm.FCStd
projetos/P2M21/dois_verticais_divisor/variantes/v03_B_longo/Dois_Verticais.FCStd
projetos/P2M21/dois_verticais_divisor/variantes/v04_superior_16/Dois_Verticais.FCStd
projetos/P2M21/dois_verticais_divisor/variantes/v05_B_longo_inferior_15/Dois_Verticais.FCStd
projetos/P2M21/dois_verticais_divisor/variantes/v06_B12_superior2/Dois_Verticais.FCStd
projetos/P2M21/dois_verticais_divisor/variantes/v07_B10_superior3/Dois_Verticais.FCStd
projetos/P2M21/dois_verticais_divisor/variantes/v08_B145_inferior05_terra33/Dois_Verticais.FCStd
projetos/P2M21/dois_verticais_divisor/variantes/v09_B968_superior366/Dois_Verticais.FCStd
projetos/P2M21/quatro_elementos_casamento_banda/c01_rede_banda/4_elementos.FCStd
projetos/P2M21/quatro_elementos_casamento_banda/c02_raiz_ordem2/4_elementos.FCStd
projetos/P2M21/quatro_elementos_casamento_banda/c03_dipolos_1012/4_elementos.FCStd
projetos/P2M21/quatro_elementos_casamento_banda/c04_transformadores_duplos/4_elementos.FCStd
projetos/P2M21/quatro_elementos_casamento_banda/c05_segmentos_em_fase/4_elementos.FCStd
projetos/P2M21/quatro_elementos_casamento_banda/c08_raiz_ajuste_fino/4_elementos.FCStd
projetos/P2M21/quatro_elementos_casamento_banda/c09_raiz_banda_fina/4_elementos.FCStd
projetos/P2M21/quatro_elementos_casamento_banda/c10_raiz_secantes/4_elementos.FCStd
projetos/P2M21/quatro_elementos_casamento_banda/c11_raiz_largura/4_elementos.FCStd
projetos/P2M21/quatro_elementos_casamento_banda/c12_raiz_intermediaria/4_elementos.FCStd
projetos/P2M21/rede_dez_1x4/referencia_1x4/P2M21_Duplo_1x4.FCStd
projetos/P2S13/compacto_c09/c00/P2S13_Compacto_SemRadome.FCStd
projetos/P2S13/compacto_c09/c00/visual/Antena_C09_SemRadome_PRELIMINAR.FCStd
projetos/P2S13/divisor_duplo_1x3_correcao/c01_aberto/Divisor_Duplo3.FCStd
projetos/P2S13/divisor_duplo_1x3_correcao/c02_fase/Divisor_Duplo3.FCStd
projetos/P2S13/divisor_duplo_1x3_correcao/c03_ordem2/Divisor_Duplo3.FCStd
projetos/P2S13/divisor_duplo_1x3_correcao/c05_blindado/cad/copper.step
projetos/P2S13/divisor_duplo_1x3_correcao/c06_vertical/cad/SAC305.step
projetos/P2S13/divisor_duplo_1x3_correcao/c06_vertical/Divisor_Duplo3.FCStd
projetos/P2S13/divisor_duplo_1x3_correcao/c07_centro/cad/folha_cu.step
projetos/P2S13/divisor_duplo_1x3_correcao/c07_centro/Divisor_Duplo3.FCStd
projetos/P2S13/divisor_duplo_1x3_hfss/c01_juncao/cad/ZYF300.step
projetos/P2S13/divisor_duplo_1x3_hfss/inicial/cad/PTFE_terminal.step
projetos/P2S13/divisor_duplo_1x3_hfss/inicial/Divisor_Duplo3.FCStd
projetos/P2S13/dobras_placas_ajustadas/d01_b20_a120/P2S13_Dobras.FCStd
projetos/P2S13/dobras_placas_ajustadas/d02_b20_a150/P2S13_Dobras.FCStd
projetos/P2S13/fabricavel_radome/a00/P2S13_Radome.FCStd
projetos/P2S13/mecanica_R12/Antena_R12_PRELIMINAR.FCStd
projetos/P2S13/mecanica_R17/Grampo_R01.step
projetos/P2S13/seis_elementos/s00_b20_a60/P2S13_6elementos.FCStd
projetos/P2S13/seis_elementos/s01_b20_a90/P2S13_6elementos.FCStd
projetos/P2S13/seis_elementos/s02_b10_a90/P2S13_6elementos.FCStd
projetos/P2S13/tres_placas2/t00_b3_a90/cad/AL5052.step
projetos/P2S13/tres_placas2/t01_b20_a120/cad/AL5052.step
projetos/P2S13/tubo_pvc/dn100_c01/divisor/cad/folha_cu.step
projetos/P2S13/tubo_pvc/dn100_c01/divisor/Divisor_Duplo3.FCStd
projetos/P2S13/tubo_pvc/dn100_c01/visual/Antena_PVC_DN100_C01_PRELIMINAR.FCStd
projetos/P2S13/tubo_pvc/dn100_c02/divisor/Divisor_Duplo3.FCStd
projetos/P2S13/tubo_pvc/dn100_c02/visual/Antena_PVC_DN100_C02_PRELIMINAR.FCStd
freecad/mecanica_R01/componentes/P04_Trilho_D.step
projetos/P2M21/hfss/divisor_1x4/cad/ZYF300.step
projetos/P2M21/hfss/divisor_1x8/cad/ZYF300.step
projetos/P2S13/divisor_duplo_1x3_correcao/c00_direto/cad/PTFE_terminal.step
projetos/P2S13/divisor_duplo_1x3_correcao/c01_aberto/cad/SAC305.step
projetos/P2S13/divisor_duplo_1x3_correcao/c02_fase/cad/copper.step
projetos/P2S13/divisor_duplo_1x3_correcao/c03_ordem2/cad/copper.step
projetos/P2S13/divisor_duplo_1x3_correcao/c04_mascara/cad/SAC305.step
projetos/P2S13/divisor_duplo_1x3_correcao/c05_blindado/cad/folha_cu.step
projetos/P2S13/divisor_duplo_1x3_correcao/c06_vertical/cad/ZYF300.step
projetos/P2S13/divisor_duplo_1x3_correcao/c07_centro/cad/copper.step
projetos/P2S13/divisor_duplo_1x3_hfss/inicial/cad/SAC305.step
projetos/P2S13/mecanica_R12/Antena_R12_RF.step
freecad/P1H_10_Separadas.FCStd
freecad/mecanica_R01/01_Refletor_dobrado.FCStd
freecad/mecanica_R01/02_Refletor_planificado.FCStd
freecad/mecanica_R01/04_Refletor_CORTE_1a1.dxf
freecad/mecanica_R01/05_Refletor_marcacao_dobras.dxf
freecad/mecanica_R01/componentes/P01_Berco.step
freecad/mecanica_R01/componentes/P02_Batente.step
freecad/mecanica_R01/componentes/P05_Passa_duplo.step
freecad/mecanica_R02/01_Refletor_dobrado.FCStd
freecad/mecanica_R02/01_Refletor_dobrado.step
freecad/mecanica_R02/02_Refletor_planificado.FCStd
freecad/mecanica_R02/04_Refletor_CORTE_1a1.dxf
freecad/mecanica_R02/05_Refletor_marcacao_dobras.dxf
freecad/mecanica_R02/componentes/Berco_2.step
freecad/mecanica_R02/componentes/Trilho_INF_E.step
freecad/mecanica_R02/componentes/Trilho_RAIZ_D.step
freecad/mecanica_R02/componentes/Trilho_SUP_D.step
freecad/mecanica_R02/componentes/Trilho_SUP_E.step
freecad/mecanica_R03/01_Refletor_dobrado.FCStd
freecad/mecanica_R03/01_Refletor_dobrado.step
freecad/mecanica_R03/04_Refletor_CORTE_1a1.dxf
freecad/mecanica_R03/05_Refletor_marcacao_dobras.dxf
freecad/mecanica_R05/04_Refletor_CORTE_1a1.dxf
freecad/mecanica_R05/05_Refletor_marcacao_dobras.dxf
freecad/mecanica_R06/01_Refletor_dobrado.FCStd
freecad/mecanica_R06/01_Refletor_dobrado.step
freecad/mecanica_R06/02_Refletor_planificado.FCStd
freecad/mecanica_R06/05_Refletor_marcacao_dobras.dxf
freecad/modelos_RF_R06/antena/cad/AL5052.step
freecad/modelos_RF_R06/antena/cad/POM_nom.step
freecad/modelos_RF_R06/antena/cad/RO4350B_R01.step
freecad/modelos_RF_R06/antena/cad/SAC305.step
freecad/modelos_RF_R06/antena/cad/copper.step
freecad/modelos_RF_R06/antena/cad/folha_cu.step
freecad/modelos_RF_R06/divisor_inferior/cad/PTFE_terminal.step
freecad/modelos_RF_R06/divisor_inferior/cad/ZYF300.step
freecad/modelos_RF_R06/divisor_inferior/cad/copper.step
freecad/modelos_RF_R06/divisor_inferior/cad/folha_cu.step
freecad/modelos_RF_R06/divisor_superior/cad/PTFE_terminal.step
freecad/modelos_RF_R06/divisor_superior/cad/ZYF300.step
freecad/modelos_RF_R06/divisor_superior/cad/copper.step
freecad/modelos_RF_R06/divisor_superior/cad/folha_cu.step
projetos/P2M19/mecanica_R09_PRELIMINAR/Base_aluminio_PRELIMINAR.step
projetos/P2M19/mecanica_R09_PRELIMINAR/P2M19_R09_PRELIMINAR.FCStd
projetos/P2M21/freecad/P2M21_Montagem.FCStd
projetos/P2M21/freecad/Refletor_corte_dobra_R00.dxf
projetos/P2M21/freecad/Refletor_planificado.FCStd
projetos/P2M21/hfss/antena/cad/AL5052.step
projetos/P2M21/hfss/antena/cad/POM_nom.step
projetos/P2M21/hfss/antena/cad/copper.step
projetos/P2M21/hfss/antena/cad/folha_cu.step
projetos/P2M21/hfss/divisor_1x4/cad/copper.step
projetos/P2M21/hfss/divisor_1x4/cad/folha_cu.step
projetos/P2M21/hfss/divisor_1x8/cad/PTFE_terminal.step
projetos/P2M21/hfss/divisor_1x8/cad/copper.step
projetos/P2M21/mecanica_preliminar_R18/Grampo_POM_PRELIMINAR.FCStd
projetos/P2M21/mecanica_preliminar_R18/P2M21_R18_PRELIMINAR.FCStd
projetos/P2M21/mecanica_preliminar_R18/Refletor_DOBRA_PRELIMINAR_1a1.dxf
projetos/P2M21/mecanica_preliminar_R18/Refletor_dobrado_PRELIMINAR.FCStd
projetos/P2M21/mecanica_preliminar_R18/Refletor_dobrado_PRELIMINAR.step
projetos/P2M21/mecanica_preliminar_R18/Refletor_planificado_PRELIMINAR.FCStd
projetos/P2M21/mecanica_preliminar_R18/Refletor_planificado_PRELIMINAR.step
projetos/P2M21/quatro_elementos_ajuste/ensaios/v09_transformadores/4_elementos.FCStd
projetos/P2M21/quatro_elementos_ajuste/ensaios/v13_passo50_ajustado/4_elementos.FCStd
projetos/P2M21/quatro_elementos_ajuste/ensaios/v14_passo52_ajustado/4_elementos.FCStd
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
