Gecesars/emb_ant/projetos/P2S13/fabricavel_radome/README.md

# R11 — C07 fabricavel e radome FR-4

Solicitacao: corrigir C07 para JLCPCB e avaliar conjunto a 5,17 GHz, 14 nucleos, no maximo seis passes, DeltaS 0,05, sem sweep. Duas entradas 0,5 W / 0 graus. Metas: VSWR ativo <=1,25, ganho frontal >=12 dBi e lobo principal vertical simetrico/centrado. O maximo e a assimetria reais serao reportados; para verificacao numerica usam-se a tolerancia angular anterior +/-0,5 graus e 0,2 dB de assimetria no intervalo comum de meia potencia. VSWR com a outra porta casada tambem e reportado.

**Resultado conferido em 12/11/2026: sexto passe concluido em 11/11 as 20:19; exportacao encerrada as 20:20. SOLUCAO NUMERICAMENTE INVALIDA, sem aprovacao RF.** Nao liberar para producao com base apenas no DRC.

O limite de seis passes e os 14 nucleos foram respeitados. DeltaS final 0,13888655, acima de 0,05; zero passes consecutivos aprovados no final. O quinto tinha DeltaS 0,04060184, mas o sexto piorou e o solver matricial falhou ao atingir 600 iteracoes: residual maximo 0,04803 / medio 0,02777, contra alvo configurado 0,00001. O perfil registra a falha mesmo quando a lista resumida de mensagens informa conclusao normal da execucao.

Com duas entradas 0,5 W / 0 graus, os valores EXPORTADOS apenas para diagnostico sao: ganho frontal 14,291067 dBi; VSWR ativo A/B 1,598462 / 2,023363; outra casada 1,738580 / 1,541813; H 63,088705 graus com pico +16,25; V 9,847765 graus com pico fino +0,523084 graus. Assimetria principal V 1,375320 dB no intervalo +/-4,26718 graus. A tolerancia angular anterior +/-0,5 e o criterio de auditoria de simetria 0,2 dB nao sao atendidos numericamente.

**Nao interpretar o ganho 14,29 dBi como cumprimento da meta de 12 dBi.** O HFSS exportou 3,231681 W radiados para 1 W incidente e 0,916192 W aceitos, impossivel neste sistema passivo. O erro de reciprocidade S foi 0,144768 e uma sonda de campo mudou 12,107688 dB entre os dois ultimos passes. A recomposicao coerente dos arquivos confere, mas nao corrige a solucao fisica invalida. A malha nao apresenta reparos Major/Minor. Nao houve novo solve, sweep ou passe adicional durante a verificacao de 12/11.

Arquivos: `a00/resultado.json`, `auditoria_solver_matricial.json`, `convergencia.txt`, `polar_HV.png`, `simetria_vertical.png` e `Relatorio_R11_C08_Radome.pdf`. Os graficos sao marcados como invalidos. A falha precisa ser resolvida no sistema linear antes de atribuir as mudancas de diagrama ao radome ou ajustar a geometria com base nelas. Pressao de memoria foi observada durante o passe6, mas nao foi registrado erro fatal de falta de memoria; nao se afirma que ela seja a unica causa.

- `d00`: divisor C08 DFM derivado da C07, com as mesmas rotas de sinal. Oito PTH acabados de 1,10 mm, metalizacao nominal de 18 um, ilhas de 1,80 mm, antipads de 3,03 mm. Terra recuado 0,30 mm da borda. Core ZYF300CA-C de 1,52 mm, cobre 35 um, ENIG, sem mascara/serigrafia. Pino cobre de 0,9195 mm e solda SAC305 preenchendo folga ao barril. Solda nivelada com a face da ilha, sem excesso externo modelado.
- `a00`: montagem integral das tres PCBs de dois elementos, seis cabos fisicos de 50 mm, refletor Al2mm, divisor corrigido e radome. Geometria das placas radiantes e do refletor preservada. Divisor girado 180 graus em X, transladado Z=-35,231 mm. Todas as seis interfaces coaxiais unem-se em Z=-35,051 mm; nao ha portas internas artificiais nesses contatos.
- Radome: caixa fechada nominal, parede uniforme 2 mm, dimensoes externas 314 x 84 x 84 mm. Interior X=-155..155, Y=-40..40, Z=-45..35 mm. Sem cobre. Material Isola 370HR de referencia, FR-4 com E-glass, epsilon_r=3,92 e tan(delta)=0,025 (valores tipicos a 5 GHz da ficha, aplicados em 5,17 GHz). Fonte: https://isola-group.com/wp-content/uploads/data-sheets/370hr.pdf. PDF preservado localmente em `fontes/`; o repositorio inclui URL, parametros e SHA256 em `fontes/referencia_370HR.json`. O usuario autorizou material de referencia.
- O radome e simetrico em X/Y. Folga frontal nominal aproximada de 19,2 mm; folga lateral de 15 mm em relacao as PCBs de 50 mm e de 7,5 mm em relacao ao envelope do refletor. As duas portas externas da rede sao referencias eletromagneticas ideais dentro da caixa. Conectores N, passagens/vedacoes externas, cola/juntas, suportes e tolerancias de lote nao estao caracterizados nesta analise.

O calculo integral inclui perdas nos seis cabos, dielétricos, condutores, soldas e radome, alem da radiacao e interacao espacial do divisor. Esse escopo supera a recomposicao S8+S6 da C07 anterior, que nao somava a radiacao direta do divisor. Comparacoes devem declarar essa diferenca.

Classic automatico, sem operacoes locais impostas, sem MeshLink, sem refinamento lambda inicial. Base de ordem 2, solver iterativo 1e-5. Os nove campos sao monitoramento, nao autorizacao para exceder seis passes. Verificar dois passes consecutivos abaixo de DeltaS 0,05, historico de campos, reparos de malha, passividade, reciprocidade, potencia e soma dos campos complexos. Limite de seis passes nao equivale a convergencia.

A conformidade DFM segue as capacidades publicas JLCPCB consultadas em 11/11/2026; a aprovacao final de producao depende do stackup e da revisao fabril contratados. Fonte: https://jlcpcb.com/capabilities/pcb-capabilities e https://jlcpcb.com/pcb-fabrication/high-frequency-pcb. Nao houve cotacao nem compra nesta revisao.
