Gecesars/emb_ant/fabricacao/montagem/comprimento_eletrico.csv

comprimento_mm | ganho_minimo_nominal_dBi | ganho_minimo_mais_menos_1mm_comum_dBi
240 | 16.06310474480175 | 16.05705506047993
241 | 16.062286413984715 | 16.05705506047993
242 | 16.089984398110293 | 16.062286413984715
243 | 16.11506528921833 | 16.089984398110293
244 | 16.137498377609013 | 16.11506528921833
245 | 16.15724629480112 | 16.137498377609013
246 | 16.17368761192575 | 16.15724629480112
247 | 16.18213874943431 | 16.17368761192575
248 | 16.187373395414696 | 16.18213874943431
249 | 16.208212068323686 | 16.187373395414696
250 | 16.253771299453074 | 16.208212068323686
251 | 16.320209584109737 | 16.253771299453074
252 | 16.401802095968666 | 16.320209584109737
253 | 16.4913165030001 | 16.401802095968666
254 | 16.580627952864187 | 16.4913165030001
255 | 16.61468149199422 | 16.452041711858183
256 | 16.452041711858183 | 16.302837840863663
257 | 16.302837840863663 | 16.17983844521446
258 | 16.17983844521446 | 16.09246588894698
259 | 16.09246588894698 | 16.046773049518777
260 | 16.046773049518777 | 16.04056257220483
