Gecesars/emb_ant/projetos/P2S13/fabricavel_radome/d00/diagrama_H.csv

angulo_graus | ganho_realizado_total_dBi | E_Emax
-180.0 | -14.417465159323193 | 0.044030840908802084
-179.75 | -14.18385670093662 | 0.045231126346473416
-179.5 | -13.924349979215464 | 0.04660287811130124
-179.25 | -13.644265166754657 | 0.04813012387002009
-179.0 | -13.348524431026982 | 0.049797095918501046
-178.75 | -13.04152084845499 | 0.05158865381884
-178.5 | -12.727061343084674 | 0.05349056319942275
-178.25 | -12.408364466939048 | 0.05548965368909023
-178.0 | -12.08809424974694 | 0.0575738835764579
-177.75 | -11.768414510733198 | 0.05973233776353466
-177.5 | -11.451052064257954 | 0.06195518163229985
-177.25 | -11.137361048962958 | 0.06423358851837133
-177.0 | -10.828383674596285 | 0.06655965374432836
-176.75 | -10.524904912461421 | 0.06892630415037088
-176.5 | -10.22750015137774 | 0.0713272089267142
-176.25 | -9.936575766194954 | 0.07375669524820064
-176.0 | -9.652403065258536 | 0.07620967059810889
-175.75 | -9.375146333344569 | 0.07868155258788859
-175.5 | -9.104885769274949 | 0.0811682063899126
-175.25 | -8.84163610330578 | 0.08366588948533879
-175.0 | -8.585361614734847 | 0.08617120320044667
-174.75 | -8.33598818377121 | 0.08868105039809684
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
