Gecesars/emb_ant/projetos/P2S13/fabricavel_radome/d00/diagrama_V.csv

angulo_graus | ganho_realizado_total_dBi | E_Emax
-180.0 | -14.41746515932319 | 0.04509582312258612
-179.75 | -14.252497711768006 | 0.04596049429454236
-179.5 | -14.100261621104579 | 0.046773136675333525
-179.25 | -13.962558779818048 | 0.0475205695725862
-179.0 | -13.840972907861877 | 0.04819044436684147
-178.75 | -13.736901390386166 | 0.048771319649544204
-178.5 | -13.651587944780792 | 0.049252715413282994
-178.25 | -13.58615467317254 | 0.04962515116668867
-178.0 | -13.541632719526323 | 0.049880171772542656
-177.75 | -13.518991237112077 | 0.050010363878353725
-177.5 | -13.519164717366262 | 0.0500093650487162
-177.25 | -13.54307897260104 | 0.04987186711414683
-177.0 | -13.591676237060835 | 0.04959361480371363
-176.75 | -13.665939983126362 | 0.04917140040573426
-176.5 | -13.766920167145074 | 0.048603054979696365
-176.25 | -13.895759744475276 | 0.04788743650414876
-176.0 | -14.053723446892661 | 0.04702441527502886
-175.75 | -14.242230020025044 | 0.04601485685744376
-175.5 | -14.462889401023709 | 0.044860602938052455
-175.25 | -14.717546712906135 | 0.04356445052894408
-175.0 | -15.008335511768752 | 0.04213013015103001
-174.75 | -15.337743518568521 | 0.04056228390366861
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
