Gecesars/emb_ant/fabricacao/cotacao/cotacao_coluna_5.jpg

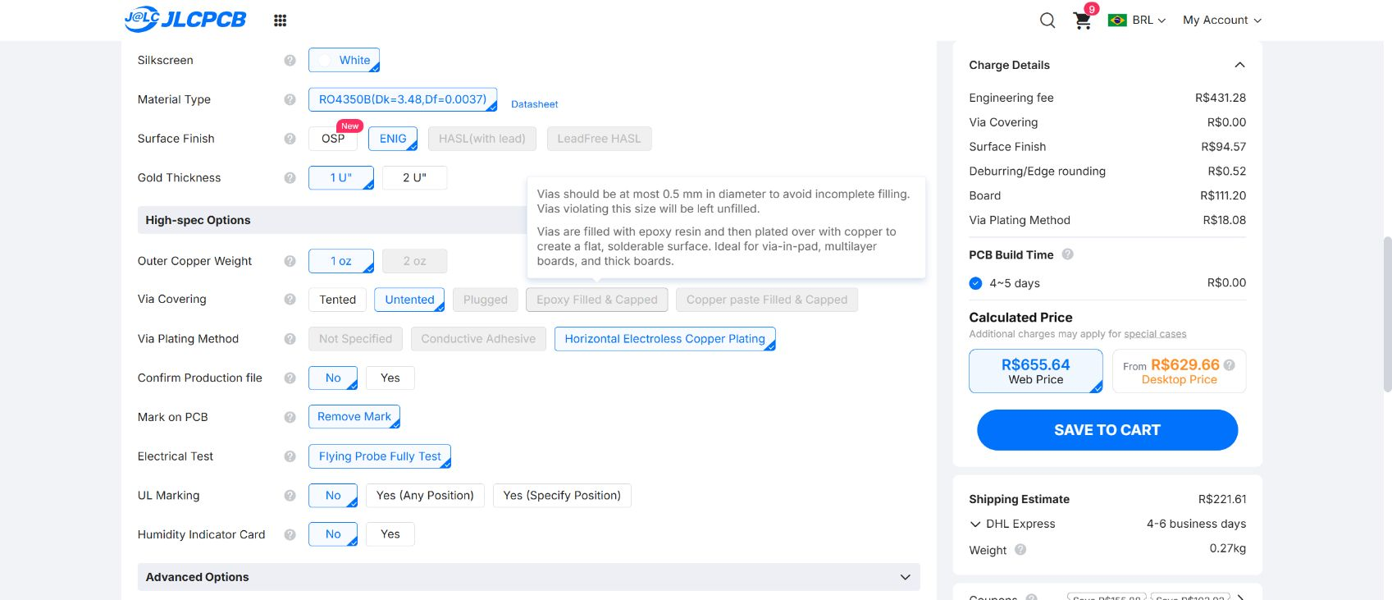
fabricacao/cotacao/cotacao_coluna_5.jpg
