Gecesars/emb_ant/fabricacao/cotacao/cotacao_divisor.jpg

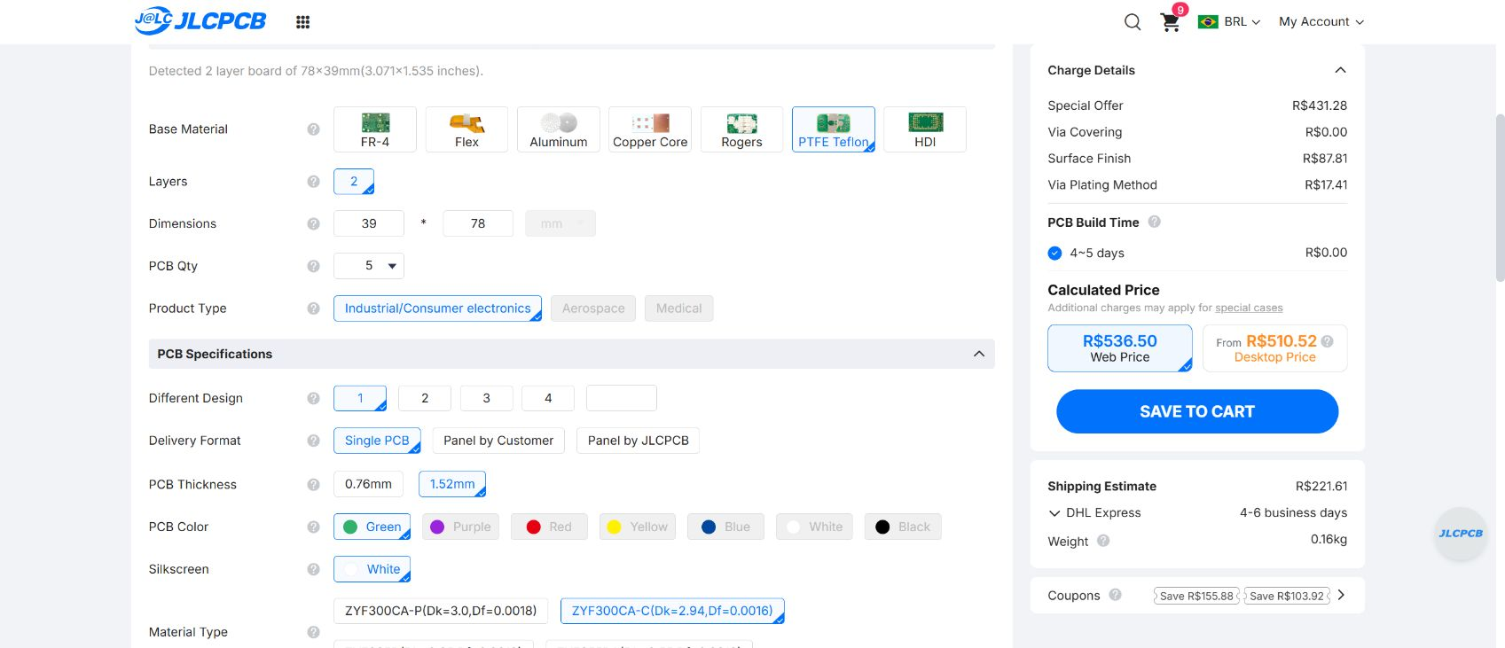
fabricacao/cotacao/cotacao_divisor.jpg
