Gecesars/emb_ant/fabricacao/cotacao/cotacao_individual_10.jpg

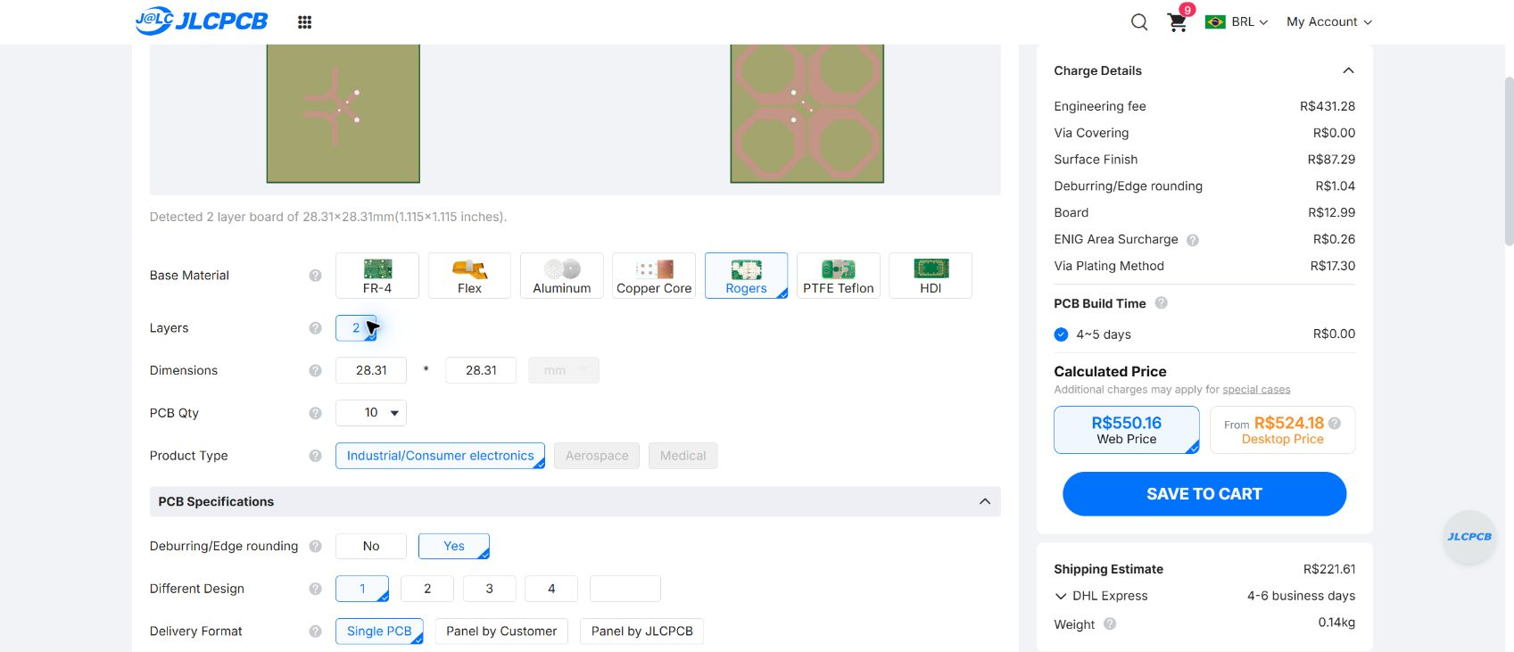
fabricacao/cotacao/cotacao_individual_10.jpg
