Gecesars/emb_ant/fabricacao/cotacao/cotacao_individual_50.jpg

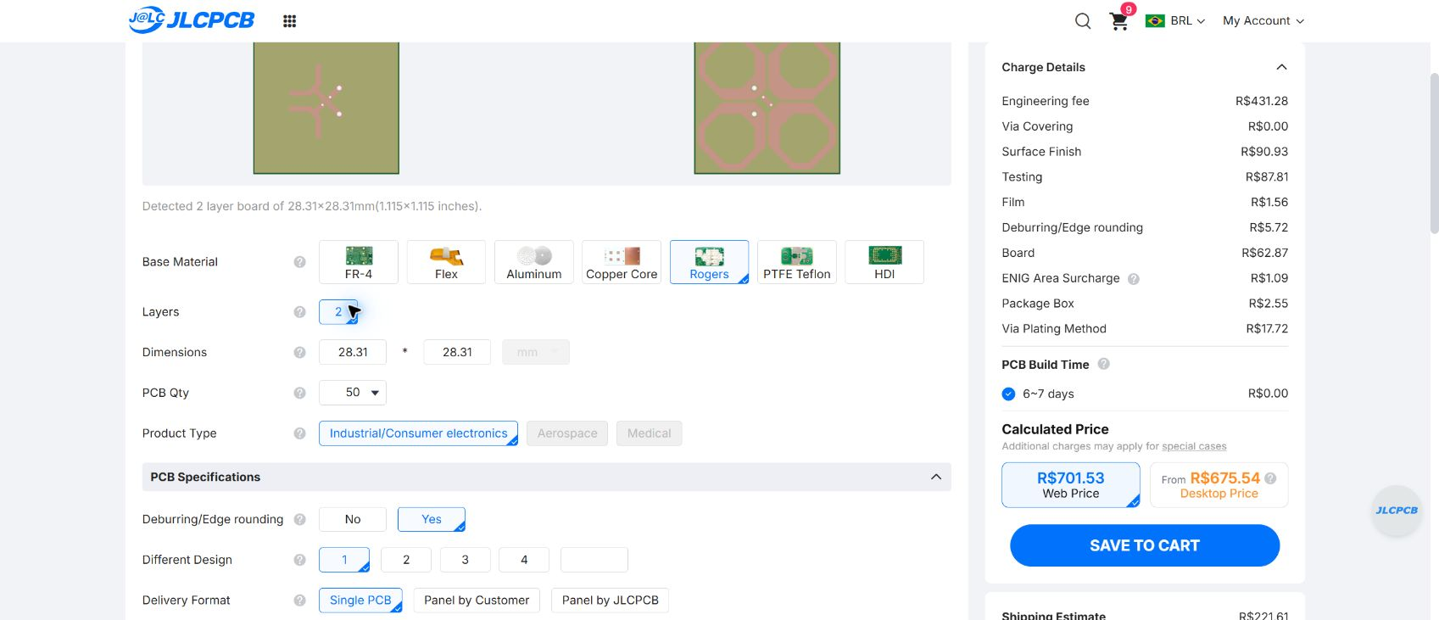
fabricacao/cotacao/cotacao_individual_50.jpg
