Gecesars/emb_ant/fabricacao/historico/mapa_divisor.png

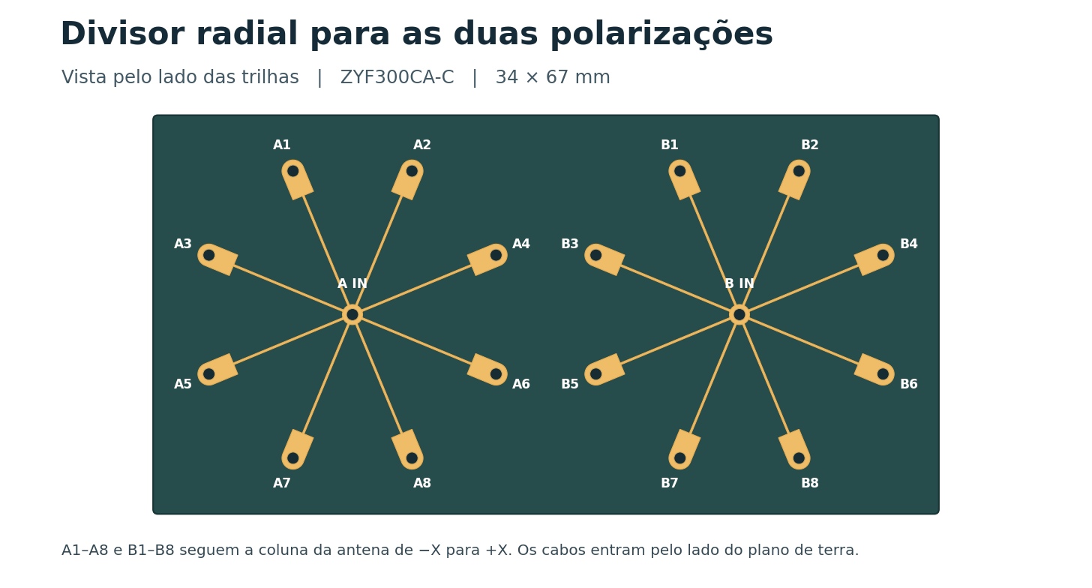
fabricacao/historico/mapa_divisor.png
