Gecesars/emb_ant/fabricacao/montagem/mapa_divisor.png

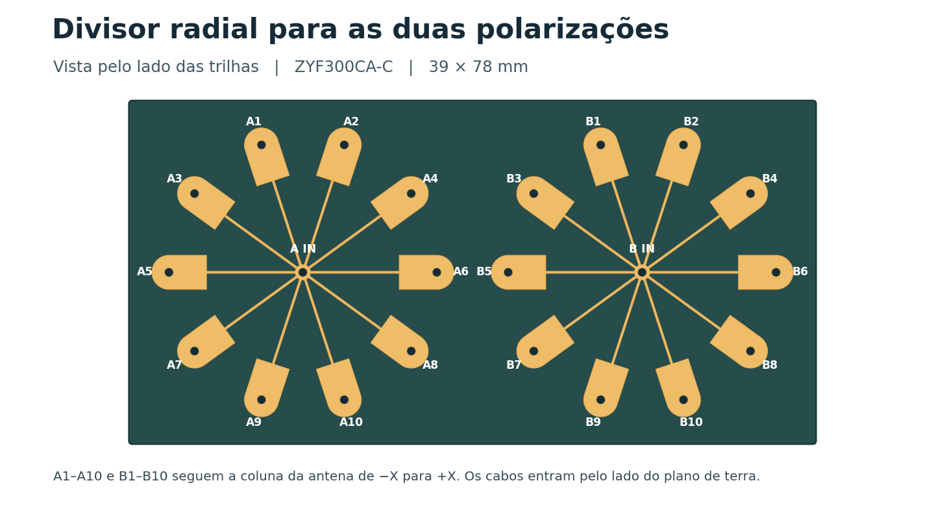
fabricacao/montagem/mapa_divisor.png
