Gecesars/emb_ant/projetos/P2M19/estudo_72mm/casos/R02_16x2_72mm/montagem_frontal.png

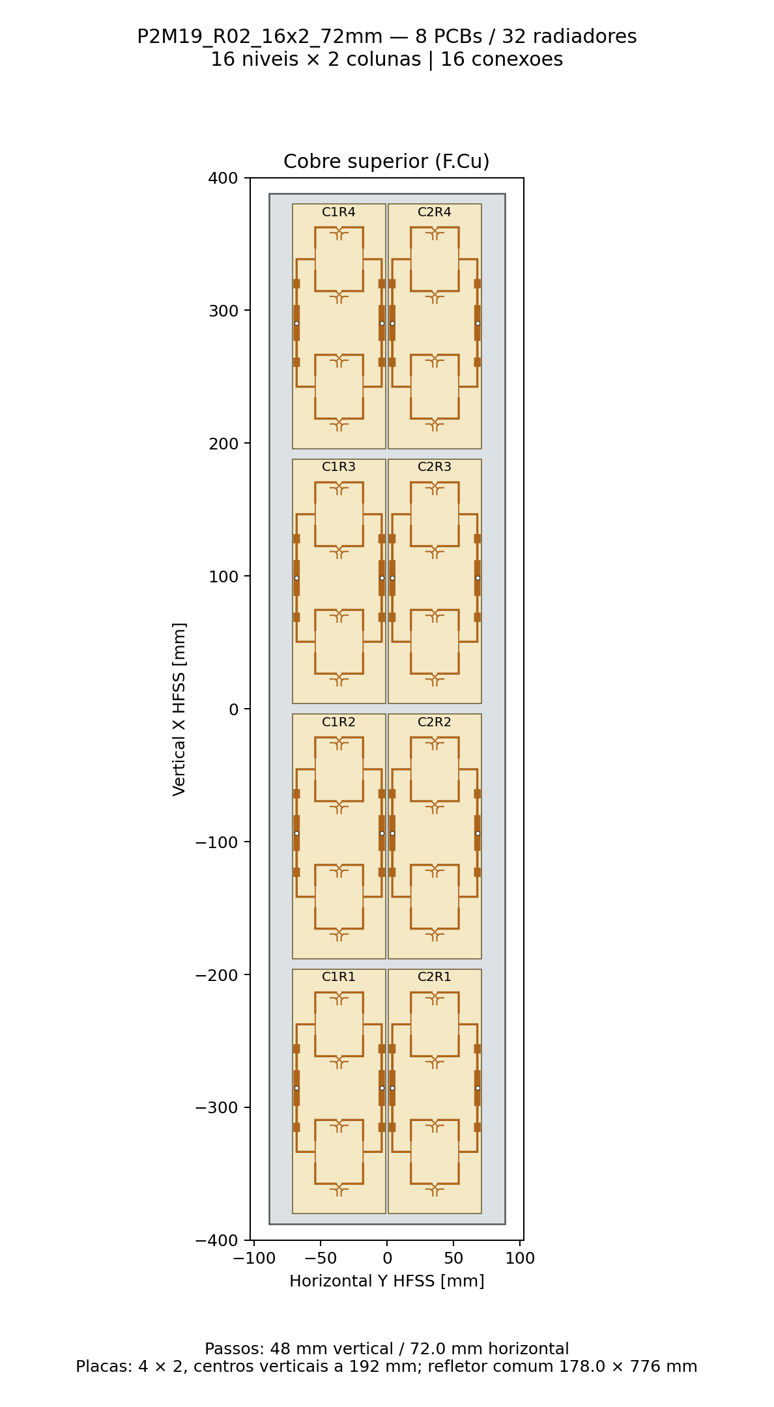
projetos/P2M19/estudo_72mm/casos/R02_16x2_72mm/montagem_frontal.png
