Gecesars/emb_ant/projetos/P2M19/estudo_72mm/casos/R03_72mm_ref162/montagem_frontal.png

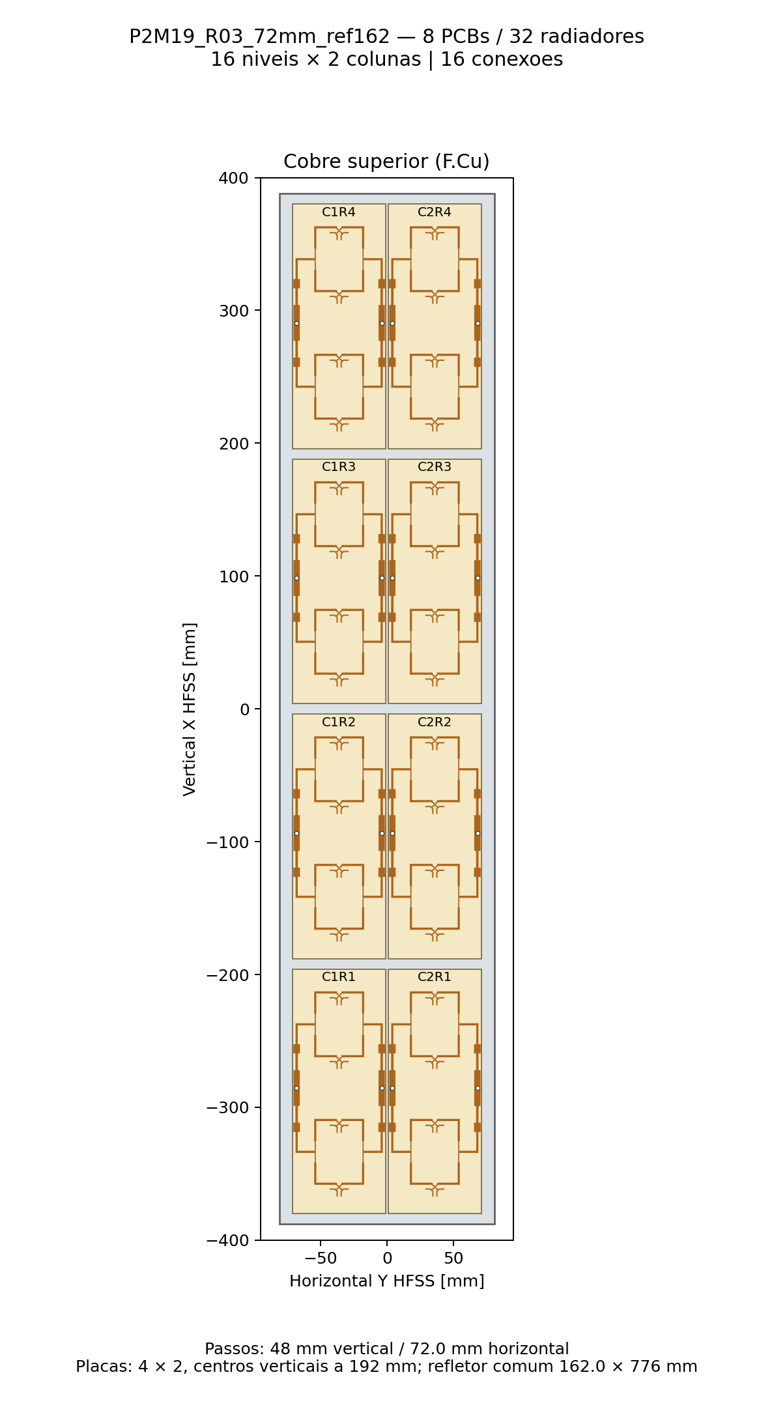
projetos/P2M19/estudo_72mm/casos/R03_72mm_ref162/montagem_frontal.png
