Gecesars/emb_ant/projetos/P2M21/comparacao_colunas_niveis/R17_Dez_Celulas_78mm/montagem_duas_faces.png

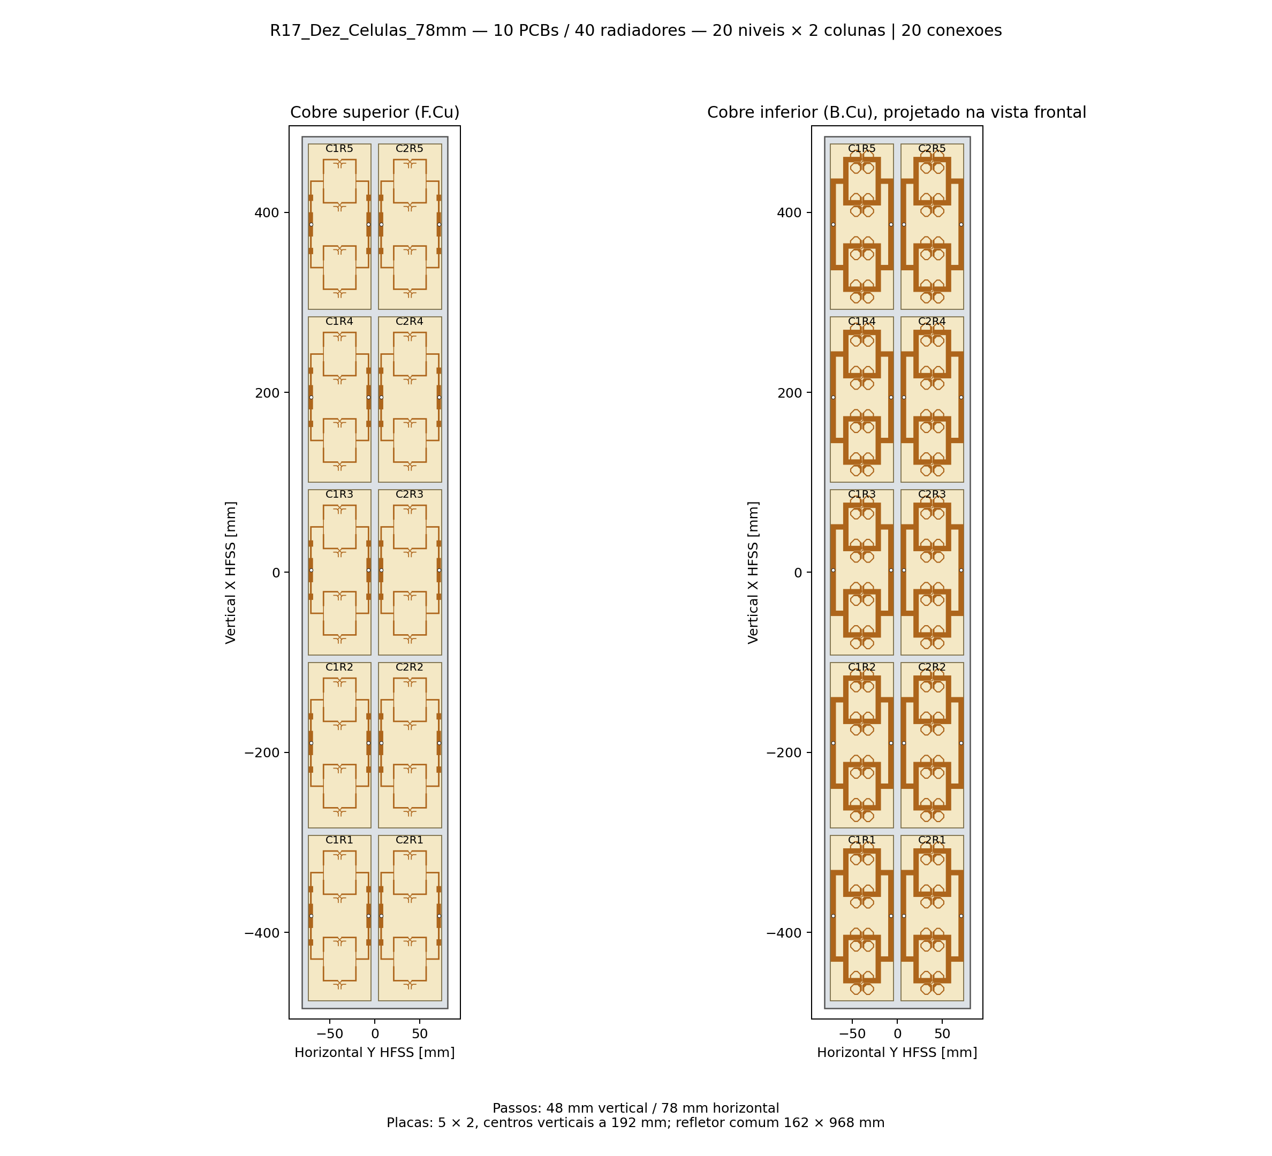
projetos/P2M21/comparacao_colunas_niveis/R17_Dez_Celulas_78mm/montagem_duas_faces.png
