Gecesars/emb_ant/projetos/P2S13/mecanica_R17/imagens/montagem_corte.png

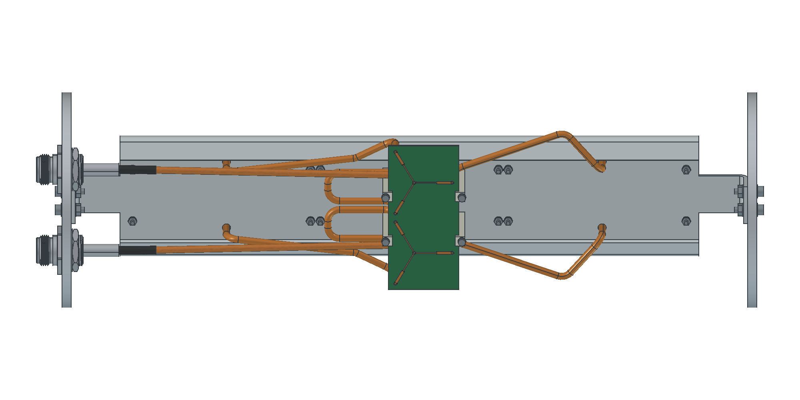
projetos/P2S13/mecanica_R17/imagens/montagem_corte.png
