Gecesars/emb_ant/resultados/r06/cotacao.md

# JLCPCB · atualização de 7 de novembro de 2026

Três Gerbers enviados pela extensão do Chrome, sem alterar os pacotes da R02. Cotações instantâneas para cinco PCBs nuas de cada tipo, em BRL. Não houve compra.

| PCB | Dielétrico | Dimensões reconhecidas | Quantidade | Web Price |
|---|---|---|---:|---:|
| Coluna contínua de dez radiadores | RO4350B, 0,76 mm | 501,71 × 28,31 mm | 5 | R$ 657,83 |
| Distribuidora inferior | ZYF300CA-C, 1,52 mm | 170,5 × 78 mm | 5 | R$ 632,75 |
| Distribuidora superior | ZYF300CA-C, 1,52 mm | 39 × 78 mm | 5 | R$ 538,28 |
| **Cinco conjuntos completos** | | | | **R$ 1.828,86** |

Equivalente a **R$ 365,77 por conjunto** em PCBs. Duas camadas, cobre externo de 1 oz, ENIG de 1 µin e categoria Industrial/Consumer electronics. Fabricação indicada de 4–5 dias. Cada cotação exibiu DHL Express por R$ 223,08 e trânsito de 4–6 dias úteis. O total de fabricação não inclui frete consolidado, tributos, conectores, coaxiais, chapa ou montagem.

O configurador confirmou que **0,76 mm é a espessura do dielétrico**, com placa acabada de **0,9 ±0,1 mm**. Para o PTFE de **1,52 mm**, indicou placa acabada de **1,65 mm ±10%**. O seletor RO4350B informa Dk de ensaio 3,48 e Df 0,0037; o HFSS mantém o Dk de projeto 3,66 declarado no modelo. O PTFE selecionado informa Dk 2,94 e Df 0,0016.

[Coluna contínua](cotacao/continua.jpg) · [Inferior](cotacao/inferior.jpg) · [Superior](cotacao/superior.jpg). As capturas e transcrições das telas estão na pasta de cotação. As opções selecionadas foram conferidas após o processamento automático dos arquivos.

| Gerber | SHA-256 |
|---|---|
| Gerber_P1H_Coluna_10.zip | `6f7b16622e02315e772a2115624d73dff43d2ac2e488a7dcc91708f004db86d8` |
| Gerber_R02_Inferior.zip | `b2fe4fc91d02352b0b645f4bb0b78cc56f26a9cc7d5b875ef14f434f2af69a93` |
| Gerber_R02_Superior.zip | `fdf3b822a98f9ea16f61fa1edad377cc326f1d7ac41b446f7b3e9ce63b489c60` |

Origem: [configurador JLCPCB](https://cart.jlcpcb.com/quote). Preços sujeitos a revisão de fabricação e atualização do configurador.
