Gecesars/emb_ant/resultados/r03/cotacao.md

# Placas alongadas no configurador JLCPCB

Preços web em BRL consultados em 06/11/2026 pela extensão do Chrome após a leitura automática de cada Gerber. São cinco unidades de cada PCB, duas camadas, cobre externo de 1 oz e ENIG de 1 µin. As duas distribuidoras usam ZYF300CA-C de 1,52 mm. A placa dos dez radiadores é a mesma RO4350B de 0,76 mm cotada para a R02.

| PCB | Dimensões detectadas | Lote de cinco | Comprovante |
|---|---|---:|---|
| Divisor inferior | 260,15 × 82,00 mm | R$ 688,85 | [JLCPCB](cotacao_inferior.jpg) |
| Divisor superior | 229,35 × 82,00 mm | R$ 670,50 | [JLCPCB](cotacao_superior.jpg) |
| Coluna de radiadores | 501,71 × 28,31 mm | R$ 655,64 | [JLCPCB](../r01/cotacao_jlc_continua.jpg) |
| **Cinco conjuntos de três placas** | | **R$ 2.014,99** | |

A alongada custa **R$ 403,00 por conjunto** em PCBs. O custo incremental frente à compacta é de R$ 192,20 por cinco, ou R$ 38,44 por conjunto. Com cinquenta radiadores individuais a R$ 701,53, o mesmo par de lotes de divisores soma R$ 2.060,88 para cinco conjuntos. A JLCPCB indicou 4 a 5 dias de fabricação dos divisores. A estimativa DHL individual foi de R$ 221,61 e 4 a 6 dias úteis. Os totais das tabelas incluem as PCBs nuas. Frete consolidado, tributos, chapa, conectores, coaxial e montagem dependem do pedido. [Cotação das compactas e referências anteriores](../r02/cotacao.md)

Os Gerbers foram verificados contra os contornos e as coordenadas dos furos do modelo. Constam 12 furos metalizados e 8 de fixação na inferior, e 10 e 6 na superior. [Hashes SHA-256 dos dois arquivos enviados](verificacao_cam.json) · [Pacotes de fabricação](../../fabricacao/gerbers)
