Gecesars/emb_ant/resultados/r02/cotacao.md

# JLCPCB · três placas de cada painel P1H R02

Cotação instantânea de 6 de novembro de 2026 pelo configurador da JLCPCB na extensão do Chrome. Cada linha corresponde a um lote independente de cinco PCBs nuas. A mesma placa impressa contínua de dez elementos serve às duas arquiteturas.

| PCB | Material | Medidas reconhecidas | Qtd. | Web Price |
|---|---|---:|---:|---:|
| Coluna de radiadores | RO4350B de 0,76 mm | 501,71 × 28,31 mm | 5 | R$ 655,64 |
| Distribuidora inferior com as duas primeiras divisões 1:2 | ZYF300CA-C de 1,52 mm | 170,5 × 78 mm | 5 | R$ 630,65 |
| Distribuidora superior | ZYF300CA-C de 1,52 mm | 39 × 78 mm | 5 | R$ 536,50 |
| **Cinco conjuntos completos** | | | | **R$ 1.822,79** |

São **R$ 364,56 de PCBs por conjunto**. A R01 com divisor único custou R$ 1.192,14 por cinco conjuntos. A segunda placa acrescenta R$ 630,65 por cinco, ou R$ 126,13 por conjunto. Prazo de fabricação indicado de 4 a 5 dias. Cada tela indicou DHL Express por R$ 221,61 e trânsito de 4 a 6 dias úteis. O total acima considera somente fabricação das PCBs. Frete consolidado, tributos, coaxiais, montagem e ferragens dependem do pedido.

Para cinco painéis com dez radiadores individuais, a cotação de 50 PCBs de antena foi de R$ 701,53. Com os mesmos divisores inferior e superior, são R$ 1.868,68 em PCBs, R$ 45,89 acima de cinco conjuntos com a coluna contínua. [Cotação de 10 e 50 radiadores individuais](../../fabricacao/cotacao/Cotacao_JLCPCB.md)

Duas camadas, cobre externo de 1 oz, ENIG de 1 µin e categoria Industrial/Consumer electronics. O PTFE escolhido exibe Dk 2,94 e Df 0,0016. [Comprovante inferior](JLC_Inferior.jpg) · [Comprovante superior](JLC_Superior.jpg) · [Comprovante da placa contínua](../r01/cotacao_jlc_continua.jpg)

| Gerber enviado | SHA-256 |
|---|---|
| [Coluna](../../fabricacao/gerbers/Gerber_P1H_Coluna_10.zip) | `6f7b16622e02315e772a2115624d73dff43d2ac2e488a7dcc91708f004db86d8` |
| [Inferior](../../fabricacao/gerbers/Gerber_R02_Inferior.zip) | `b2fe4fc91d02352b0b645f4bb0b78cc56f26a9cc7d5b875ef14f434f2af69a93` |
| [Superior](../../fabricacao/gerbers/Gerber_R02_Superior.zip) | `fdf3b822a98f9ea16f61fa1edad377cc326f1d7ac41b446f7b3e9ce63b489c60` |
