Gecesars/emb_ant/resultados/r01/cotacao.md

# JLCPCB · placa contínua e divisor da R01

Em 6 de novembro de 2026, os dois pacotes Gerber foram enviados separadamente ao configurador da JLCPCB pela extensão do Chrome. O configurador identificou duas camadas em ambos. Valores em reais, na opção **Web Price**, para PCBs nuas na categoria Industrial/Consumer electronics.

| PCB | Dimensões reconhecidas | Material e núcleo selecionados | Quantidade | Preço do lote | Fabricação |
|---|---:|---|---:|---:|---|
| [Coluna contínua de dez radiadores](../../fabricacao/gerbers/Gerber_P1H_Coluna_10.zip) | 28,31 × 501,71 mm | Rogers RO4350B, 0,76 mm | 5 | R$ 655,64 | 4 a 5 dias |
| [Dois divisores 1:10 numa placa](../../fabricacao/gerbers/Gerber_Divisor_PTFE_2x10.zip) | 39 × 78 mm | PTFE ZYF300CA-C, 1,52 mm | 5 | R$ 536,50 | 4 a 5 dias |

**Cinco pares de PCBs custam R$ 1.192,14, ou R$ 238,43 por par.** O acabamento selecionado foi ENIG de 1 µin e cobre externo de 1 oz. O Dk de processo exibido para o Rogers foi 3,48. O modelo de antena usa o Dk de projeto de 3,66. Para o divisor, o configurador identificou Dk 2,94 e Df 0,0016.

Para o lote da coluna, o formulário indicou frete DHL Express de R$ 221,61 e trânsito de 4 a 6 dias úteis. Frete consolidado, tributos, peças mecânicas, coaxiais e montagem ficam fora do total das placas. A consulta terminou na cotação instantânea, antes do pedido.

| Gerber enviado | SHA-256 |
|---|---|
| Coluna | `6f7b16622e02315e772a2115624d73dff43d2ac2e488a7dcc91708f004db86d8` |
| Divisor | `17813005736f5d3bb52e95a45e8aef289bdc1a86a5ba025c7a799501987d5729` |

[Captura da coluna](cotacao_jlc_continua.jpg) · [Captura do divisor](cotacao_jlc_divisor.jpg) · [Configurador JLCPCB](https://cart.jlcpcb.com/quote)
