Gecesars/emb_ant/resultados/r06/email_final.html

César,

A R06 da PCB contínua de dez elementos com divisores compactos está qualificada numericamente em 5,17 GHz, pelo método solicitado: PCBs simuladas separadamente no HFSS e circuito com parâmetros S e campos complexos. Os cabos entram somente como linhas ideais de fase, sem atenuação.

Métrica | Resultado final | Critério
Ganho frontal realizado total | 17,3593 dBi | ≥16 dBi
Abertura horizontal | 96,0643° | 81° a 99°
Abertura vertical | 5,6158° | Feixe mais estreito permitido
VSWR ativo A / B | 1,2115 / 1,1292 | Ambos <1,5
VSWR com outra entrada casada A / B | 1,2321 / 1,2474 | Ambos <1,5

Referência: duas entradas de 0,5 W a 0°, 1 W total incidente. Inclui descasamento e perdas das PCBs e das bobinas, com correção da atenuação dos acessos do cupom. Os conectores N são interfaces ideais.

O HFSS terminou em 23 passes, com 6.665.585 tetraedros. Os dois últimos ΔS foram 0,003156 / 0,001363, e as maiores variações de campo 0,010089 / 0,006865 dB. A comparação com a solução de 21 passes mudou o ganho em apenas −0,000581 dB e a abertura horizontal em +0,118830°. Todos os limites de estabilidade foram cumpridos. O Nexxim confirmou a matriz do circuito, com erro máximo de 4,65 × 10⁻¹⁵; passividade, reciprocidade, recomposição dos campos e balanço de potência foram conferidos.

Anexos: relatório ilustrado de 15 páginas e desenho de fabricação com três pranchas A3. Incluem as vistas detalhadas da PCB, das duas distribuidoras e da montagem FreeCAD, refletor de alumínio de 2 mm dobrado e planificado, apoios de poliacetal de 5 mm, passagens dos cabos, fixações, base dos N e bobinas de curto DC.

O chicote usa entrada / enlace / ramal de 290 / 132 / 133 mm, com 555 mm por caminho e 3.768 mm no conjunto. A montagem foi verificada sem interseções e com folga nominal mínima de 0,7611 mm. Os comprimentos de corte devem considerar inserções e decapagens reais.

A cotação JLCPCB de 7/11, já documentada, totaliza R$1.828,86 para cinco conjuntos de três PCBs, ou R$365,77 por conjunto, sem frete consolidado e tributos. Antena RO4350B de 0,76 mm e divisores ZYF300CA-C de 1,52 mm. Os Gerbers permanecem os mesmos; nenhuma compra foi efetuada.

- Relatório completo (https://github.com/Gecesars/emb_ant/blob/e4efa7a54ba92c9a4ba88561eddf84d454331642/resultados/r06/P1H_R06_Relatorio.pdf)
- FreeCAD, chapa dobrada/planificada, DXF e desenhos (https://github.com/Gecesars/emb_ant/blob/e4efa7a54ba92c9a4ba88561eddf84d454331642/freecad/mecanica_R06/README.md)
- Projetos KiCad (https://github.com/Gecesars/emb_ant/tree/e4efa7a54ba92c9a4ba88561eddf84d454331642/kicad)
- HFSS, Circuit/Nexxim, dados, cotação e limites do estudo (https://github.com/Gecesars/emb_ant/blob/e4efa7a54ba92c9a4ba88561eddf84d454331642/resultados/r06/README.md)
- Commit da qualificação: e4efa7a (https://github.com/Gecesars/emb_ant/commit/e4efa7a54ba92c9a4ba88561eddf84d454331642)

O repositório contém 343 artefatos conferidos no pacote final, sem malhas ou campos volumétricos. As tentativas anteriores e a recuperação de memória estão documentadas.

Alcance: o aceite é somente em 5,17 GHz. Os 17 pontos dos divisores não qualificam ganho/VSWR do painel em toda a banda. A análise separada exclui perdas dos cabos/N e acoplamento eletromagnético entre placas distintas. A qualificação numérica não substitui medições do conjunto real, inspeção da continuidade DC e ensaio de vedação.
