Gecesars/emb_ant/resultados/r03/controle_076/rede_hfss_centro.csv

material | MHz | potencia_entregue_por_W | perda_excedente_dB | retorno_ativo_dB | dispersao_amplitude_dB | dispersao_fase_graus
ZYF300CA-C | 5170 | 0.5751876901927744 | 2.401904170246135 | 12.441646361693161 | 4.382294928361109 | 36.806522630871314
