Gecesars/emb_ant/resultados/r02_separadas/README.md

# Dez radiadores individuais no painel R02-S

A solução convergida de 5,17 GHz apresentou **13,48 dBi**, **105,13° de abertura horizontal** e **5,57° de abertura vertical**. O ganho e a abertura horizontal reprovam as metas. O requisito de atendimento em toda a banda fica reprovado por esse ponto.

O diretório contém os dois cortes com passo angular de 0,25°, a matriz de duas portas N, as métricas, a convergência e os valores frontais de diretividade e ganho. A excitação é de 0,5 W a 0° em cada N. [Comparação com a placa contínua](../r02/comparacao_paineis.md)
