Gecesars/emb_ant/resultados/r01/README.md

# Painel completo R01

A 5,17 GHz a R01 ficou abaixo da meta de 16 dBi em +Z e acima do limite de 99° de abertura horizontal. Por esse ponto, a montagem com placa contínua e divisor único reprova o requisito de manter ambas as metas em toda a banda.

| Grandeza | Resultado |
|---|---:|
| Ganho frontal realizado | 14,059 dBi |
| Diretividade frontal | 15,187 dBi |
| Ganho frontal referido à potência aceita | 14,273 dBi |
| Abertura horizontal a −3 dB | 102,342° |
| Abertura vertical a −3 dB | 6,195° |
| Retorno ativo A / B | 12,08 / 14,68 dB |
| Potência total refletida | 47,97 mW |

As duas entradas N têm 0,5 W e fase zero, com os dez elementos montados, divisor, coaxiais, soldas, bobinas, refletor e apoios. O máximo do corte horizontal ocorre a +16,75°. Os limites de meia potência do lóbulo são −48,07° e +54,27°. O ganho frontal é avaliado em +Z, independentemente do ângulo do máximo do corte.

O HFSS atingiu dois passes consecutivos com ΔS ≤ 0,015 e terminou com 3.232.419 tetraedros e ΔS de 0,01206. Os arquivos de centro contêm os dois cortes angulares, matriz S, convergência, potência refletida e métricas. O resultado é específico da montagem R01.
