Gecesars/emb_ant/resultados/historico/resultados_P1H.csv

frequencia_MHz | abertura_H_graus | abertura_V_graus | ganho_realizado_frontal_dBi
5090 | 94.5845 | 7.1052 | 16.3586
5110 | 94.4596 | 7.0783 | 16.3652
5130 | 94.3343 | 7.0518 | 16.3710
5150 | 94.2089 | 7.0256 | 16.3758
5170 | 94.0833 | 6.9995 | 16.3797
5190 | 93.9572 | 6.9717 | 16.3824
5210 | 93.8310 | 6.9440 | 16.3841
5230 | 93.7045 | 6.9166 | 16.3846
5250 | 93.5779 | 6.8896 | 16.3839
