Gecesars/emb_ant/resultados/r06/antena/Centro_H.csv

Freq [GHz] | Phi [deg] | Theta [deg] | dB(RealizedGainTotal) [] | dB(GainTotal) [] | dB(DirTotal) []
5.17 | 90.0000000000002 | -180 | -5.38022296750547 | -5.23958631121134 | -5.10776123777467
5.17 | 90.0000000000002 | -179.75 | -5.38328657985649 | -5.24264992356236 | -5.11082485012569
5.17 | 90.0000000000002 | -179.5 | -5.38711079507891 | -5.24647413878478 | -5.11464906534811
5.17 | 90.0000000000002 | -179.25 | -5.39169688724494 | -5.25106023095081 | -5.11923515751414
5.17 | 90.0000000000002 | -179 | -5.39704700683797 | -5.25641035054384 | -5.12458527710717
5.17 | 90.0000000000002 | -178.75 | -5.40316418240406 | -5.26252752610993 | -5.13070245267326
5.17 | 90.0000000000002 | -178.5 | -5.41005232241026 | -5.26941566611613 | -5.13759059267946
5.17 | 90.0000000000002 | -178.25 | -5.4177162173036 | -5.27707956100947 | -5.1452544875728
5.17 | 90.0000000000002 | -178 | -5.42616154176317 | -5.28552488546904 | -5.15369981203237
5.17 | 90.0000000000002 | -177.75 | -5.43539485713719 | -5.29475820084306 | -5.16293312740639
5.17 | 90.0000000000002 | -177.5 | -5.44542361405654 | -5.30478695776241 | -5.17296188432574
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
