Gecesars/emb_ant/resultados/r06/antena/Centro_V.csv

Freq [GHz] | Phi [deg] | Theta [deg] | dB(RealizedGainTotal) [] | dB(GainTotal) [] | dB(DirTotal) []
5.17 | 0 | -180 | -5.38022296750546 | -5.23958631121133 | -5.10776123777466
5.17 | 0 | -179.75 | -5.25172890147756 | -5.11109224518343 | -4.97926717174676
5.17 | 0 | -179.5 | -5.18429522817805 | -5.04365857188392 | -4.91183349844725
5.17 | 0 | -179.25 | -5.17804322269326 | -5.03740656639913 | -4.90558149296246
5.17 | 0 | -179 | -5.23362195639422 | -5.09298530010009 | -4.96116022666342
5.17 | 0 | -178.75 | -5.35224073747299 | -5.21160408117886 | -5.07977900774219
5.17 | 0 | -178.5 | -5.53572641151297 | -5.39508975521884 | -5.26326468178217
5.17 | 0 | -178.25 | -5.78661118927391 | -5.64597453297978 | -5.51414945954311
5.17 | 0 | -178 | -6.10826018826273 | -5.96762353196861 | -5.83579845853193
5.17 | 0 | -177.75 | -6.50505312115317 | -6.36441646485905 | -6.23259139142237
5.17 | 0 | -177.5 | -6.98264279881004 | -6.84200614251591 | -6.71018106907924
5.17 | 0 | -177.25 | -7.54832660750187 | -7.40768995120774 | -7.27586487777107
5.17 | 0 | -177 | -8.21159014622059 | -8.07095348992646 | -7.93912841648979
5.17 | 0 | -176.75 | -8.98492323008878 | -8.84428657379465 | -8.71246150035798
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
