Gecesars/emb_ant/resultados/r06/circuito/diagrama.csv

theta_graus | H_dBi | V_dBi
-180.0 | -5.531374669308875 | -5.531374669308873
-179.75 | -5.534308891077999 | -5.408659118021819
-179.5 | -5.538006430675351 | -5.345704443965424
-179.25 | -5.542468494317326 | -5.342703650272524
-179.0 | -5.547697173347588 | -5.400344634054411
-178.75 | -5.55369544589716 | -5.519843599994017
-178.5 | -5.560467178780295 | -5.703001056854116
-178.25 | -5.568017129619528 | -5.952285748429553
-178.0 | -5.576350949192054 | -6.270954981101607
-177.75 | -5.585475183989315 | -6.6632244451485665
-177.5 | -5.595397278980842 | -7.134507853119429
-177.25 | -5.606125580572556 | -7.691758431052379
-177.0 | -5.617669339748984 | -8.343964007445567
-176.75 | -5.630038715388118 | -9.102881939893045
-176.5 | -5.643244777736816 | -9.984163169778641
-176.25 | -5.6572995120333935 | -11.009135766736108
-176.0 | -5.672215822263521 | -12.20776445432689
-175.75 | -5.688007535034021 | -13.623837384071653
-175.5 | -5.7046894035480875 | -15.324686571277697
-175.25 | -5.722277111664144 | -17.42095700621838
-175.0 | -5.740787278018583 | -20.110745561633145
-174.75 | -5.760237460191316 | -23.783500345873144
-174.5 | -5.780646158890335 | -29.09044574640904
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
