Gecesars/emb_ant/resultados/r06/antena_refinada1/Centro_H.csv

Freq [GHz] | Phi [deg] | Theta [deg] | dB(RealizedGainTotal) [] | dB(GainTotal) [] | dB(DirTotal) []
5.17 | 90.0000000000002 | -180 | -5.70094691710179 | -5.50179659418901 | -5.36513976453229
5.17 | 90.0000000000002 | -179.75 | -5.70230218476782 | -5.50315186185503 | -5.36649503219832
5.17 | 90.0000000000002 | -179.5 | -5.70425271307967 | -5.50510239016688 | -5.36844556051017
5.17 | 90.0000000000002 | -179.25 | -5.70680180729349 | -5.5076514843807 | -5.37099465472399
5.17 | 90.0000000000002 | -179 | -5.70995400276128 | -5.51080367984849 | -5.37414685019178
5.17 | 90.0000000000002 | -178.75 | -5.71371506461901 | -5.51456474170622 | -5.37790791204951
5.17 | 90.0000000000002 | -178.5 | -5.71809198721068 | -5.51894166429789 | -5.38228483464118
5.17 | 90.0000000000002 | -178.25 | -5.72309299326398 | -5.52394267035119 | -5.38728584069448
5.17 | 90.0000000000002 | -178 | -5.72872753283709 | -5.5295772099243 | -5.39292038026759
5.17 | 90.0000000000002 | -177.75 | -5.73500628206032 | -5.53585595914753 | -5.39919912949082
5.17 | 90.0000000000002 | -177.5 | -5.74194114170042 | -5.54279081878763 | -5.40613398913092
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
