Gecesars/emb_ant/resultados/r06/antena_refinada1/Centro_V.csv

Freq [GHz] | Phi [deg] | Theta [deg] | dB(RealizedGainTotal) [] | dB(GainTotal) [] | dB(DirTotal) []
5.17 | 0 | -180 | -5.70094691710179 | -5.501796594189 | -5.36513976453229
5.17 | 0 | -179.75 | -5.55387034358975 | -5.35472002067696 | -5.21806319102025
5.17 | 0 | -179.5 | -5.46799956594735 | -5.26884924303456 | -5.13219241337785
5.17 | 0 | -179.25 | -5.44332343599202 | -5.24417311307923 | -5.10751628342252
5.17 | 0 | -179 | -5.48036051397119 | -5.28121019105841 | -5.1445533614017
5.17 | 0 | -178.75 | -5.58018630148172 | -5.38103597856893 | -5.24437914891222
5.17 | 0 | -178.5 | -5.74448495324113 | -5.54533463032834 | -5.40867780067163
5.17 | 0 | -178.25 | -5.97563056891035 | -5.77648024599756 | -5.63982341634085
5.17 | 0 | -178 | -6.27680650082447 | -6.07765617791168 | -5.94099934825497
5.17 | 0 | -177.75 | -6.65217601417283 | -6.45302569126005 | -6.31636886160334
5.17 | 0 | -177.5 | -7.10712525183883 | -6.90797492892604 | -6.77131809926933
5.17 | 0 | -177.25 | -7.64861183320842 | -7.44946151029564 | -7.31280468063892
5.17 | 0 | -177 | -8.28567337853459 | -8.08652305562181 | -7.9498662259651
5.17 | 0 | -176.75 | -9.03018729031475 | -8.83103696740196 | -8.69438013774525
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
