Gecesars/emb_ant/resultados/r06/circuito/divisores_cargas50.csv

placa | estagio | frequencia_MHz | perda_excedente_dB | potencia_destinos_W | refletida_W | nao_entregue_destinos_W | VSWR_ativo_A | VSWR_ativo_B
inferior | 1x5 | 5090.0 | 0.336162562891275 | 0.9255156006880121 | 0.05066262978509171 | 0.023821769526896207 | 1.582770987594441 | 1.5790742799433157
inferior | 1x5 | 5100.0 | 0.3348447789878377 | 0.9257964733831981 | 0.050298016139606105 | 0.023905510477195746 | 1.580061982813368 | 1.5763839698428985
inferior | 1x5 | 5110.0 | 0.3336160599741035 | 0.9260584395630428 | 0.049952254872205115 | 0.023989305564752095 | 1.577487768136879 | 1.5738304158236194
inferior | 1x5 | 5120.0 | 0.3324767540063179 | 0.9263014088736887 | 0.04962541801933611 | 0.024073173106975168 | 1.5750494576590093 | 1.5714146900002781
inferior | 1x5 | 5130.0 | 0.33142719727418085 | 0.9265252946023457 | 0.049317573893933306 | 0.02415713150372102 | 1.5727481262311835 | 1.5691378188088636
inferior | 1x5 | 5140.0 | 0.3304677134953809 | 0.9267300138047825 | 0.049028787062021496 | 0.02424119913319602 | 1.5705848066521406 | 1.5670007806227972
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
