Gecesars/emb_ant/resultados/r06/antena_malha_inicial/Centro_H.csv

Freq [GHz] | Phi [deg] | Theta [deg] | dB(RealizedGainTotal) [] | dB(GainTotal) [] | dB(DirTotal) []
5.17 | 90 | -180 | -5.71074126065511 | -5.52388572756055 | -5.38970743286026
5.17 | 90 | -179.75 | -5.71531010227756 | -5.52845456918299 | -5.39427627448271
5.17 | 90 | -179.5 | -5.72054659383415 | -5.53369106073959 | -5.3995127660393
5.17 | 90 | -179.25 | -5.7264508204281 | -5.53959528733354 | -5.40541699263325
5.17 | 90 | -179 | -5.73302401514515 | -5.54616848205059 | -5.41199018735031
5.17 | 90 | -178.75 | -5.74026856291839 | -5.55341302982383 | -5.41923473512355
5.17 | 90 | -178.5 | -5.7481880042542 | -5.56133247115964 | -5.42715417645936
5.17 | 90 | -178.25 | -5.75678703881105 | -5.56993150571649 | -5.43575321101621
5.17 | 90 | -178 | -5.76607152882429 | -5.57921599572973 | -5.44503770102944
5.17 | 90 | -177.75 | -5.77604850237354 | -5.58919296927898 | -5.4550146745787
5.17 | 90 | -177.5 | -5.78672615649125 | -5.59987062339669 | -5.4656923286964
5.17 | 90 | -177.25 | -5.7981138601136 | -5.61125832701903 | -5.47708003231875
5.17 | 90 | -177 | -5.8102221568772 | -5.62336662378263 | -5.48918832908235
5.17 | 90 | -176.75 | -5.82306276776774 | -5.63620723467318 | -5.5020289399729
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
