Gecesars/emb_ant/resultados/r06/antena_malha_inicial/Centro_V.csv

Freq [GHz] | Phi [deg] | Theta [deg] | dB(RealizedGainTotal) [] | dB(GainTotal) [] | dB(DirTotal) []
5.17 | 0 | -180 | -5.7107412606551 | -5.52388572756054 | -5.38970743286026
5.17 | 0 | -179.75 | -5.55934816828354 | -5.37249263518898 | -5.2383143404887
5.17 | 0 | -179.5 | -5.46900990616257 | -5.28215437306801 | -5.14797607836773
5.17 | 0 | -179.25 | -5.43968643043585 | -5.25283089734129 | -5.118652602641
5.17 | 0 | -179 | -5.47185742578367 | -5.28500189268911 | -5.15082359798883
5.17 | 0 | -178.75 | -5.56654798685532 | -5.37969245376075 | -5.24551415906047
5.17 | 0 | -178.5 | -5.7253778161486 | -5.53852228305404 | -5.40434398835376
5.17 | 0 | -178.25 | -5.95063874442695 | -5.76378321133239 | -5.62960491663211
5.17 | 0 | -178 | -6.24540851231176 | -6.0585529792172 | -5.92437468451691
5.17 | 0 | -177.75 | -6.61371333536358 | -6.42685780226902 | -6.29267950756874
5.17 | 0 | -177.5 | -7.06075886413252 | -6.87390333103796 | -6.73972503633768
5.17 | 0 | -177.25 | -7.59326061268023 | -7.40640507958566 | -7.27222678488538
5.17 | 0 | -177 | -8.21992423098555 | -8.03306869789099 | -7.89889040319071
5.17 | 0 | -176.75 | -8.9521598829928 | -8.76530434989824 | -8.63112605519795
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
