Gecesars/emb_ant/resultados/r05/rede/conector_25dB_hipotese.csv

MHz | ganho_min_dBi | ganho_max_dBi
5090.0 | 16.482852079548476 | 16.624651387414325
5100.0 | 16.520338567632805 | 16.642644611427905
5110.0 | 16.552272225672535 | 16.655658152672984
5120.0 | 16.578375115724768 | 16.664089461262858
5130.0 | 16.598548979457412 | 16.66842422699855
5140.0 | 16.612505583277496 | 16.669592184639438
5150.0 | 16.619866551918033 | 16.668848742804276
5160.0 | 16.620390094489398 | 16.667502909455038
5170.0 | 16.614855453733984 | 16.665986862850573
5180.0 | 16.605040420997614 | 16.66383139603412
5190.0 | 16.592688013654524 | 16.660652634160623
5200.0 | 16.579135546831004 | 16.656477475458264
5210.0 | 16.565453632696357 | 16.651552028365327
5220.0 | 16.552499354516588 | 16.646241006243905
5230.0 | 16.540857750888193 | 16.64105044328597
5240.0 | 16.531219419965094 | 16.636204098972506
5250.0 | 16.523852747159538 | 16.63215226170054
