Gecesars/emb_ant/resultados/r02/rede/rede_cargas_50ohm.csv

MHz | rede | perda_excedente_dB | potencia_saidas_W | refletida_W | dissipada_ou_radiada_W | amplitude_pico_a_pico_dB | fase_pico_a_pico_graus | desvio_medio_superior_inferior_graus
5090 | R01 | 1.228637 | 0.753592 | 0.095837 | 0.150571 | 0.142766 | 0.989528 | -0.012483
5090 | R02 | 1.075583 | 0.780624 | 0.073813 | 0.145563 | 0.086992 | 0.46636 | 0.05121
5100 | R01 | 1.223614 | 0.754464 | 0.094728 | 0.150808 | 0.14361 | 0.996945 | -0.012413
5100 | R02 | 1.046303 | 0.785904 | 0.068345 | 0.145751 | 0.087624 | 0.474323 | 0.05381
5110 | R01 | 1.218733 | 0.755313 | 0.093643 | 0.151044 | 0.144449 | 1.0044 | -0.012344
5110 | R02 | 1.016736 | 0.791273 | 0.062759 | 0.145968 | 0.088151 | 0.482492 | 0.05651
5120 | R01 | 1.213993 | 0.756137 | 0.092582 | 0.151281 | 0.145281 | 1.011895 | -0.012278
5120 | R02 | 0.987145 | 0.796683 | 0.057102 | 0.146215 | 0.088558 | 0.490766 | 0.059271
5130 | R01 | 1.209396 | 0.756938 | 0.091544 | 0.151518 | 0.146107 | 1.019428 | -0.012213
5130 | R02 | 0.957801 | 0.802084 | 0.051422 | 0.146494 | 0.088836 | 0.49902 | 0.062041
5140 | R01 | 1.204942 | 0.757715 | 0.090531 | 0.151754 | 0.146925 | 1.026997 | -0.012151
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
