Gecesars/emb_ant/resultados/r01/bobinas/comparacao.csv

MHz | IL_controle_dB | IL_bobina_dB | IL_incremento_dB | RL_controle_dB | RL_bobina_dB | fase_controle_graus | fase_bobina_graus
5090 | 0.770973 | 1.068449 | 0.297476 | 8.225201 | 6.838271 | -109.481452 | -104.72691
5100 | 0.775544 | 1.072226 | 0.296683 | 8.204719 | 6.826913 | -109.702733 | -104.970468
5110 | 0.780147 | 1.076039 | 0.295892 | 8.184267 | 6.815519 | -109.924052 | -105.214063
5120 | 0.784784 | 1.079888 | 0.295104 | 8.163847 | 6.804087 | -110.145408 | -105.457694
5130 | 0.789454 | 1.083773 | 0.29432 | 8.143457 | 6.792619 | -110.3668 | -105.701362
5140 | 0.794158 | 1.087695 | 0.293538 | 8.123099 | 6.781114 | -110.588227 | -105.945067
5150 | 0.798896 | 1.091655 | 0.292759 | 8.102771 | 6.769572 | -110.809689 | -106.188809
5160 | 0.803668 | 1.095652 | 0.291984 | 8.082475 | 6.757994 | -111.031185 | -106.432588
5170 | 0.808476 | 1.099688 | 0.291212 | 8.06221 | 6.746379 | -111.252714 | -106.676405
5180 | 0.813319 | 1.103762 | 0.290443 | 8.041976 | 6.734727 | -111.474276 | -106.920259
5190 | 0.818198 | 1.107876 | 0.289678 | 8.021773 | 6.723039 | -111.695869 | -107.164151
5200 | 0.823113 | 1.112029 | 0.288916 | 8.001603 | 6.711314 | -111.917493 | -107.40808
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
