Gecesars/emb_ant/resultados/historico/10x/balanco.csv

MHz | incidente_antenas_W | refletida_entradas_W | aceita_antenas_W | perda_cabos_W | perda_placa_W | correcao_referencia_dB | perda_cabo_ida_dB | dispersao_amplitude_dB | dispersao_fase_deg | pior_reflexao_ativa_direta_dB | maior_Sij_antenas_dB | perda_placa_A_casada_dB | perda_placa_B_casada_dB | S_AB_placa_casada_dB | perda_junta_W
5090 | 0.8191353735410001 | 0.09960799338925908 | 0.8131487631892619 | 0.04516589835441702 | 0.041503150334278205 | 0.8664431909002469 | 0.22935866141732283 | 0.6955328179794051 | 2.5405119142861055 | -19.367959151896457 | -23.463283101941034 | 0.7684861276699788 | 0.7629687387519207 | -44.82556320189485 | 0.0005741947327834174
5110 | 0.8367889405874761 | 0.08310262902002635 | 0.8292523166356826 | 0.046329323443237314 | 0.040737269923409536 | 0.7738406828747468 | 0.22981981627296588 | 0.5681226436170608 | 3.913024321941941 | -18.543521168989262 | -23.33890865956519 | 0.7582133272708265 | 0.7527542957158551 | -44.73356003547893 | 0.0005784609776440242
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
