Gecesars/emb_ant/resultados/historico/10x/resultados.csv

MHz | abertura_H_direta_deg | abertura_H_duas_entradas_deg | abertura_V_direta_deg | abertura_V_duas_entradas_deg | ganho_direto_dBi | ganho_duas_entradas_dBi
5090 | 98.20801 | 98.17476 | 5.68085 | 5.62782 | 17.45202 | 16.58063
5110 | 98.11156 | 98.08308 | 5.6593 | 5.6168 | 17.45957 | 16.68018
5130 | 98.01448 | 97.99564 | 5.638 | 5.61256 | 17.46575 | 16.78069
5150 | 97.91677 | 97.91028 | 5.61697 | 5.61214 | 17.47054 | 16.87237
5170 | 97.81828 | 97.82455 | 5.5962 | 5.61215 | 17.47389 | 16.94218
5190 | 97.71902 | 97.73628 | 5.57568 | 5.60897 | 17.47577 | 16.97596
5210 | 97.61914 | 97.64378 | 5.55541 | 5.59916 | 17.47617 | 16.96191
5230 | 97.51837 | 97.54578 | 5.5354 | 5.5806 | 17.47504 | 16.89414
5250 | 97.41691 | 97.44202 | 5.51563 | 5.5535 | 17.47236 | 16.77511
