Gecesars/emb_ant/resultados/historico/8x/balanco.csv

MHz | incidente_antenas_W | refletida_entradas_W | aceita_antenas_W | perda_cabos_W | perda_placa_W | correcao_referencia_dB | perda_cabo_ida_dB | dispersao_amplitude_dB | dispersao_fase_deg | pior_reflexao_ativa_direta_dB | maior_Sij_antenas_dB | perda_placa_A_casada_dB | perda_placa_B_casada_dB | S_AB_placa_casada_dB | perda_junta_W
5090 | 0.9043556766875661 | 0.024224693506527097 | 0.8979152357949316 | 0.03790938750697325 | 0.03931459917020319 | 0.43660730981384616 | 0.1754456692913386 | 0.682407507769005 | 1.0252061712975273 | -19.43912586161714 | -23.417260583780237 | 0.2527066969422704 | 0.2549046948062753 | -62.499662955727814 | 0.0006360840213650576
5110 | 0.9088959166589264 | 0.021885817736784004 | 0.9009308563347539 | 0.03825408040782334 | 0.0382985172592748 | 0.4148584770082242 | 0.1757984251968504 | 0.6003129555716917 | 2.4519615417931795 | -18.604514412591662 | -23.297141690426212 | 0.25168982228431813 | 0.2538745513561739 | -62.401797837091564 | 0.0006307282613638998
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
