Gecesars/emb_ant/resultados/historico/8x/resultados.csv

MHz | abertura_H_direta_deg | abertura_H_duas_entradas_deg | abertura_V_direta_deg | abertura_V_duas_entradas_deg | ganho_direto_dBi | ganho_duas_entradas_dBi
5090 | 97.79599 | 97.76038 | 7.11686 | 7.04094 | 16.48652 | 16.0451
5110 | 97.69455 | 97.66225 | 7.09017 | 7.02107 | 16.49394 | 16.07354
5130 | 97.59253 | 97.56779 | 7.0638 | 7.00925 | 16.49999 | 16.10417
5150 | 97.48961 | 97.4754 | 7.03776 | 7.00379 | 16.50461 | 16.13673
5170 | 97.38606 | 97.38399 | 7.01203 | 7.00255 | 16.5078 | 16.17031
5190 | 97.28194 | 97.2922 | 6.98528 | 7.00326 | 16.5095 | 16.20326
5210 | 97.17695 | 97.19846 | 6.95765 | 7.00319 | 16.50969 | 16.23325
5230 | 97.07131 | 97.10165 | 6.93035 | 6.99903 | 16.50834 | 16.25731
5250 | 96.96487 | 97.00048 | 6.90337 | 6.98685 | 16.50544 | 16.27201
