Gecesars/emb_ant/resultados/historico/9x/balanco.csv

MHz | incidente_antenas_W | refletida_entradas_W | aceita_antenas_W | perda_cabos_W | perda_placa_W | correcao_referencia_dB | perda_cabo_ida_dB | dispersao_amplitude_dB | dispersao_fase_deg | pior_reflexao_ativa_direta_dB | maior_Sij_antenas_dB | perda_placa_A_casada_dB | perda_placa_B_casada_dB | S_AB_placa_casada_dB | perda_junta_W
5170 | 0.8998665864143368 | 0.031029400015764003 | 0.8858417281778621 | 0.04644358153179556 | 0.03608889289421291 | 0.4582187398176635 | 0.21278070866141732 | 0.43943225469909564 | 4.114677239109348 | -16.57889332073776 | -23.13979151889327 | 0.6567467168661095 | 0.6557385169729515 | -44.882290744221095 | 0.0005963973803656542
