Gecesars/emb_ant/resultados/historico/9x/resultados.csv

MHz | abertura_H_direta_deg | abertura_H_duas_entradas_deg | abertura_V_direta_deg | abertura_V_duas_entradas_deg | ganho_direto_dBi | ganho_duas_entradas_dBi
5170 | 97.41 | 97.42612 | 6.22314 | 6.25228 | 17.0211 | 16.5577
