Gecesars/emb_ant/resultados/historico/elemento/resumo_AB.csv

frequencia_MHz | HPBW_H_graus | HPBW_V_graus | ganho_frontal_dBi | H_entre_81_e_99 | ganho_minimo_16
5090 | 94.5845 | 7.1052 | 16.3586 | True | True
5110 | 94.4596 | 7.0783 | 16.3652 | True | True
5130 | 94.3343 | 7.0518 | 16.371 | True | True
5150 | 94.2089 | 7.0256 | 16.3758 | True | True
5170 | 94.0833 | 6.9995 | 16.3797 | True | True
5190 | 93.9572 | 6.9717 | 16.3824 | True | True
5210 | 93.831 | 6.944 | 16.3841 | True | True
5230 | 93.7045 | 6.9166 | 16.3846 | True | True
5250 | 93.5779 | 6.8896 | 16.3839 | True | True
