Gecesars/emb_ant/resultados/historico/wilkinson/resultados.csv

MHz | abertura_H_direta_deg | abertura_H_duas_entradas_deg | abertura_V_direta_deg | abertura_V_duas_entradas_deg | ganho_direto_dBi | ganho_duas_entradas_dBi
5090 | 97.79599 | 97.79538 | 7.11686 | 7.10412 | 16.48652 | 13.71529
5110 | 97.69455 | 97.69238 | 7.09017 | 7.07855 | 16.49394 | 13.72488
5130 | 97.59253 | 97.58842 | 7.0638 | 7.05291 | 16.49999 | 13.77599
5150 | 97.48961 | 97.48348 | 7.03776 | 7.0271 | 16.50461 | 13.87521
5170 | 97.38606 | 97.3779 | 7.01203 | 7.00097 | 16.5078 | 14.02418
5190 | 97.28194 | 97.27183 | 6.98528 | 6.97238 | 16.5095 | 14.21826
5210 | 97.17695 | 97.16522 | 6.95765 | 6.94357 | 16.50969 | 14.44511
5230 | 97.07131 | 97.0585 | 6.93035 | 6.91494 | 16.50834 | 14.68351
5250 | 96.96487 | 96.95159 | 6.90337 | 6.88672 | 16.50544 | 14.90343
