Gecesars/emb_ant/projetos/P2M21/centro_sem_refinamento/continuacao_6_passes/resultados_centro.csv

frequencia_GHz | potencia_incidente_W | potencia_refletida_W | potencia_aceita_W | abertura_H_graus | limite_H_esquerdo_graus | limite_H_direito_graus | pico_H_graus | ganho_pico_H_dBi | ganho_frontal_total_realizado_dBi | ganho_frontal_total_dBi | diretividade_frontal_total_dBi | eficiencia_radiacao | erro_normalizacao_potencia_W | potencia_radiada_W | perda_interna_W | abertura_V_graus | limite_V_esquerdo_graus | limite_V_direito_graus | pico_V_graus | ganho_pico_V_dBi
5.17 | 1.0 | 0.08711084241234447 | 0.9128891575876555 | 32.54292212694659 | -16.297604092539537 | 16.24531803440706 | 0.0 | 23.3226687618986 | 23.3226687618986 | 23.718488272102 | 23.7000718932798 | 1.0042495316952746 | 9.2148511043888e-15 | 0.9167685089970968 | -0.0038793514094413117 | 3.4842678283566535 | -1.755980921518358 | 1.7282869068382958 | 0.0 | 23.3226687618986
