Gecesars/emb_ant/projetos/P2M21/centro_sem_refinamento/resultados/evolucao_passes.csv

passe | tetraedros | delta_s | ganho_frontal_dBi | maior_delta_campo_dB | nucleos
1 | 188299 |  | 17.026915127222 |  | 4
2 | 223568 | 1.0502413113421587 | 20.4619646637693 | 3.8827675965435997 | 4
3 | 265565 | 0.6434678432534602 | 21.9970559968239 | 1.7823349176484982 | 14
4 | 315408 | 0.6176809963052374 | 23.063118795073 | 1.3025818921252004 | 14
