Gecesars/emb_ant/resultados/r05/diagnostico/entrada/comparacao.csv

caso | MHz | IL_dB | RL_dB | potencia_dissipada_ou_radiada | fase_transmissao_graus
Bobina_r065 | 5090.0 | 0.08373342626113262 | 18.365684153727656 | 0.004526595283323529 | -100.45451827191657
Bobina_r065 | 5100.0 | 0.08332553306136568 | 18.396804102630135 | 0.004538486966177509 | -100.69691378111025
Bobina_r065 | 5110.0 | 0.0829216298031729 | 18.427929015254104 | 0.00455054502416017 | -100.93923815900288
Bobina_r065 | 5120.0 | 0.08252169431012343 | 18.459059406421964 | 0.004562771339508484 | -101.18149192994574
Bobina_r065 | 5130.0 | 0.08212570479442877 | 18.49019579651269 | 0.0045751678149226135 | -101.42367561453683
Bobina_r065 | 5140.0 | 0.08173363985155022 | 18.521338711646752 | 0.00458773637343568 | -101.66578972967848
Bobina_r065 | 5150.0 | 0.0813454784567503 | 18.552488683821757 | 0.004600478958535385 | -101.90783478873895
Bobina_r065 | 5160.0 | 0.0809611999652046 | 18.58364625072998 | 0.004613397534054311 | -102.14981130131716
Bobina_r065 | 5170.0 | 0.08058078410331851 | 18.61481195621955 | 0.004626494084133981 | -102.39171977358153
Bobina_r065 | 5180.0 | 0.08020421097178843 | 18.645986349936386 | 0.0046397706132012915 | -102.6335607079833
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
