Gecesars/emb_ant/projetos/P2M21/centro_sem_refinamento/continuacao_6_passes/resultados/Uniforme_H.csv

Freq [GHz] | Phi [deg] | Theta [deg] | re(rETheta) [mV] | im(rETheta) [mV] | re(rEPhi) [mV] | im(rEPhi) [mV] | dB(RealizedGainTotal) [] | dB(GainTotal) [] | dB(DirTotal) []
5.17 | 90 | -180 | -350.930465874138 | 213.99209789595 | 990.999575844741 | -1948.38513236412 | -10.8378918462457 | -10.4420723360424 | -10.4604887148645
5.17 | 90 | -179.75 | -345.894357092797 | 209.829818253021 | 991.704021807725 | -1945.19239824686 | -10.852231360269 | -10.4564118500657 | -10.4748282288878
5.17 | 90 | -179.5 | -340.659232776084 | 205.513093267089 | 991.941520435385 | -1939.22644120278 | -10.8770428137472 | -10.4812233035439 | -10.499639682366
5.17 | 90 | -179.25 | -335.228138309083 | 201.045435099401 | 991.709171191076 | -1930.49136562316 | -10.9123973239491 | -10.5165778137457 | -10.5349941925679
5.17 | 90 | -179 | -329.604244612161 | 196.430455758074 | 991.003459305755 | -1918.99312895274 | -10.9583949765138 | -10.5625754663105 | -10.5809918451326
5.17 | 90 | -178.75 | -323.790845252219 | 191.67186436552 | 989.820258801764 | -1904.73954090721 | -11.0151657362787 | -10.6193462260753 | -10.6377626048975
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
