Gecesars/emb_ant/projetos/P2M21/centro_sem_refinamento/continuacao_6_passes/resultados/Uniforme_V.csv

Freq [GHz] | Phi [deg] | Theta [deg] | re(rETheta) [mV] | im(rETheta) [mV] | re(rEPhi) [mV] | im(rEPhi) [mV] | dB(RealizedGainTotal) [] | dB(GainTotal) [] | dB(DirTotal) []
5.17 | 0 | -180 | 990.999575844751 | -1948.38513236413 | 350.93046587414 | -213.992097895951 | -10.8378918462457 | -10.4420723360423 | -10.4604887148645
5.17 | 0 | -179.75 | 936.755505216645 | -1946.48570358113 | 347.712502522461 | -218.892191257359 | -10.9374262387113 | -10.541606728508 | -10.5600231073302
5.17 | 0 | -179.5 | 860.169974355785 | -1891.29343827569 | 339.879948851503 | -219.896014814165 | -11.2679996589957 | -10.8721801487924 | -10.8905965276145
5.17 | 0 | -179.25 | 763.424870288988 | -1784.75767955294 | 327.773661201441 | -216.869317508453 | -11.8457220199657 | -11.4499025097624 | -11.4683188885845
5.17 | 0 | -179 | 649.381857206616 | -1630.77305013281 | 311.855825486117 | -209.791949086441 | -12.6997392348541 | -12.3039197246507 | -12.3223361034729
5.17 | 0 | -178.75 | 521.490568366546 | -1435.02655714454 | 292.691563332684 | -198.759225875798 | -13.8784735028126 | -13.4826539926092 | -13.5010703714314
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
