Gecesars/emb_ant/resultados/r05/diagnostico/entrada/Bobina_esmalte20/comparacao.csv

MHz | IL_cupom_dB | RL_cupom_dB | acrescimo_IL_dB | ganho_antena_congelada_sem_esmalte_dBi | ganho_antena_congelada_com_esmalte_dBi | diferenca_ganho_dB
5090.0 | 0.021156138326759114 | 30.784247602347577 | -0.0005027266453314326 | 16.54543266330412 | 16.543042363356356 | -0.002390299947762742
5100.0 | 0.021121697261436236 | 30.89531348058545 | -0.000494146606290248 | 16.607189714594018 | 16.605269063592864 | -0.0019206510011535727
5110.0 | 0.021089389339137905 | 31.00747851672692 | -0.0004857262343392482 | 16.638504601493842 | 16.637064046179287 | -0.0014405553145557803
5120.0 | 0.02105921338573677 | 31.120766206143973 | -0.0004774652258277452 | 16.645505851886863 | 16.644531647531352 | -0.0009742043555114321
5130.0 | 0.021031168499774003 | 31.235200611400877 | -0.0004693632908501118 | 16.636543746277866 | 16.63600281468954 | -0.0005409315883255772
5140.0 | 0.021005254058736676 | 31.350806360304013 | -0.00046142015405657016 | 16.620453163463605 | 16.62029994669593 | -0.0001532167676749907
5150.0 | 0.020981469712613773 | 31.467608659874017 | -0.0004536355492591078 | 16.605020993773095 | 16.60520417620971 | 0.00018318243661497036
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
