Gecesars/emb_ant/resultados/historico/8x/diagramas_5170.png

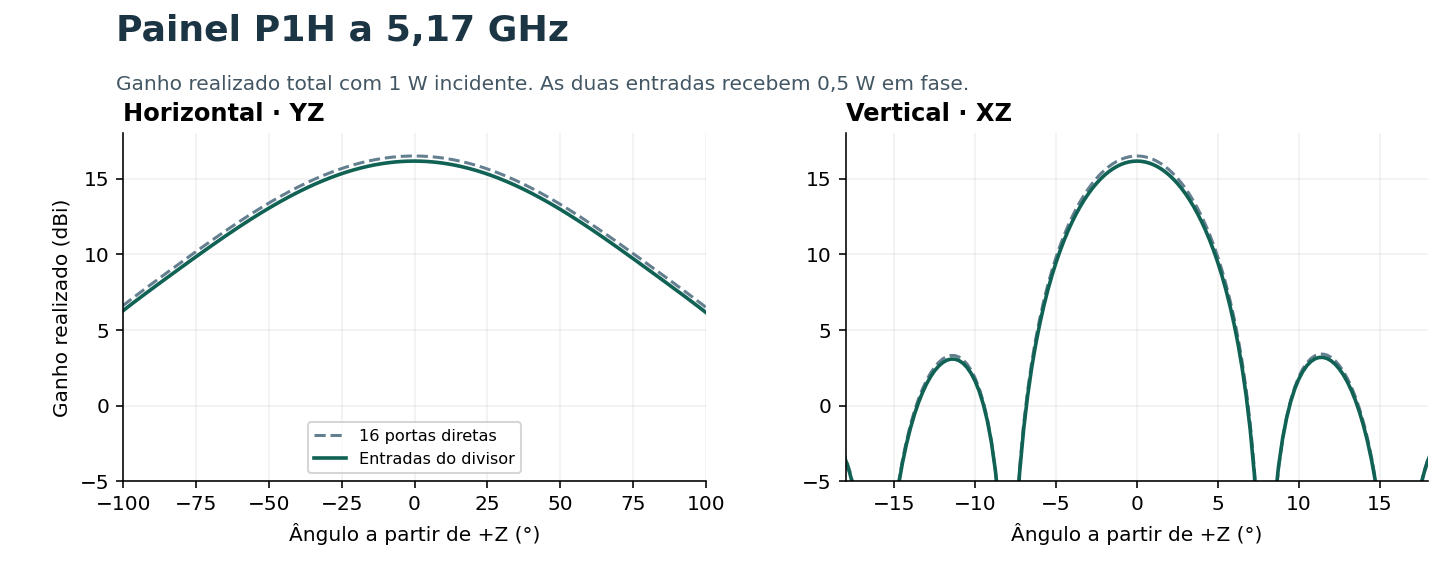
resultados/historico/8x/diagramas_5170.png
