Gecesars/emb_ant/resultados/historico/9x/diagramas_5170.png

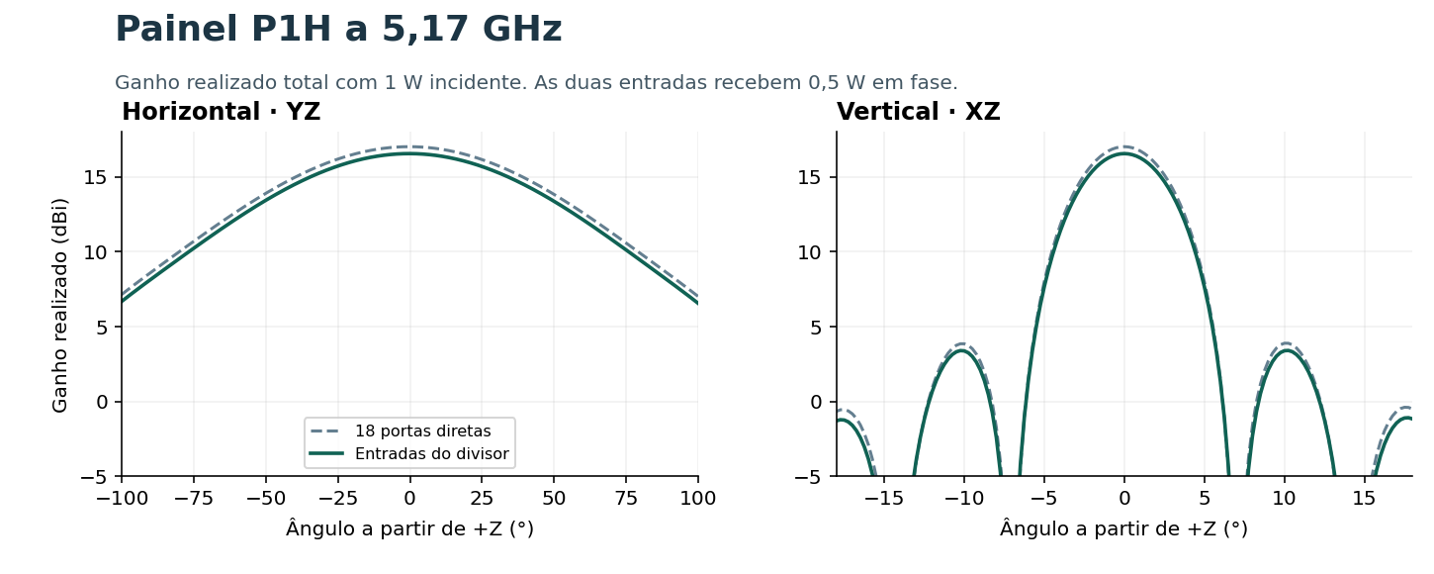
resultados/historico/9x/diagramas_5170.png
