Gecesars/emb_ant/resultados/historico/10x/diagramas_5170.png

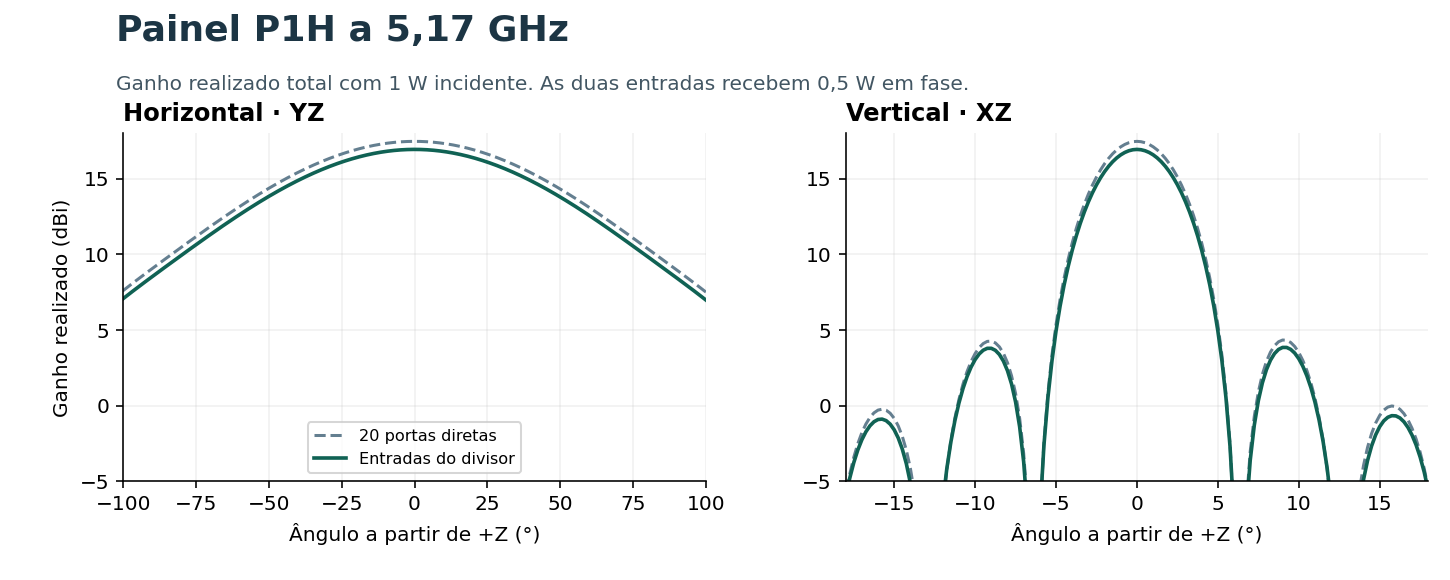
resultados/historico/10x/diagramas_5170.png
