Gecesars/emb_ant/resultados/historico/diagramas_8_9_10.png

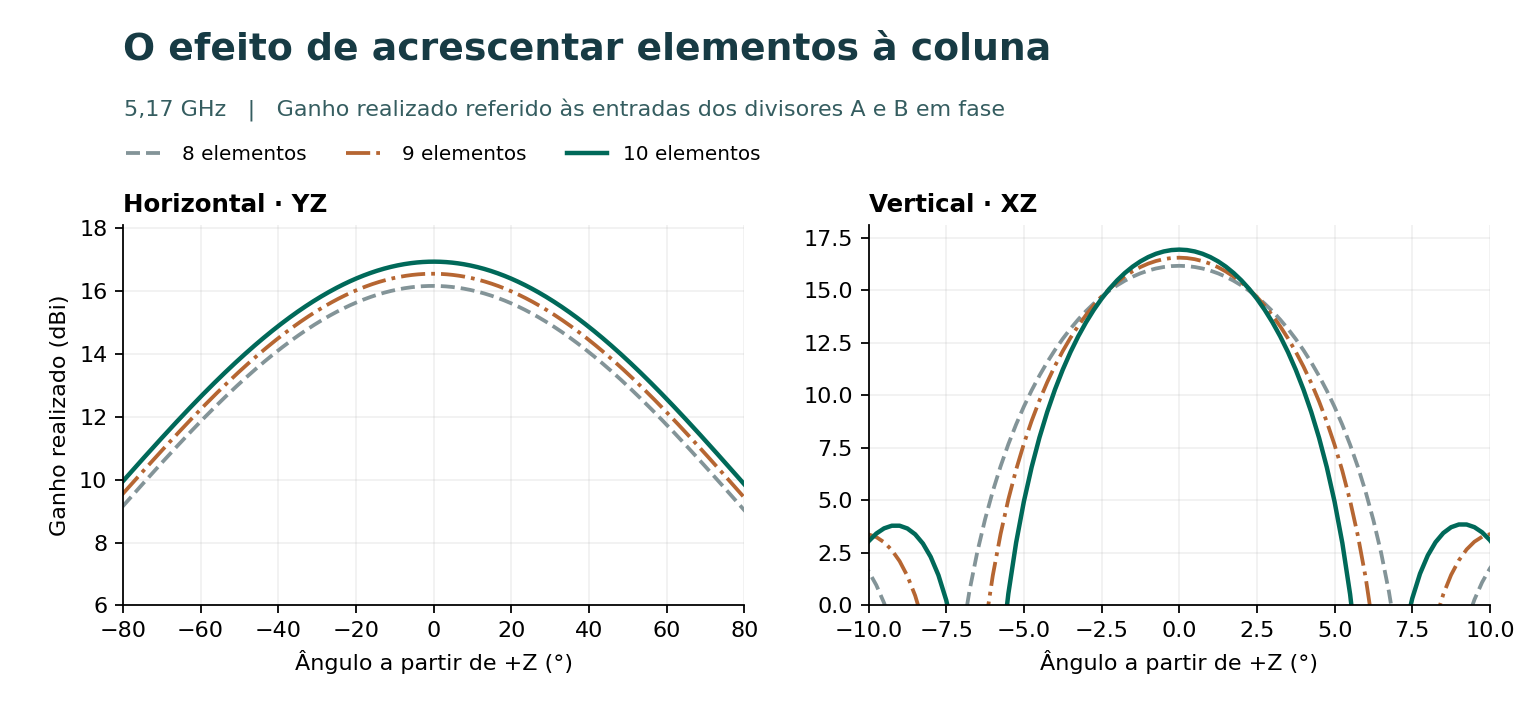
resultados/historico/diagramas_8_9_10.png
