Gecesars/emb_ant/resultados/historico/elemento/banda_AB.png

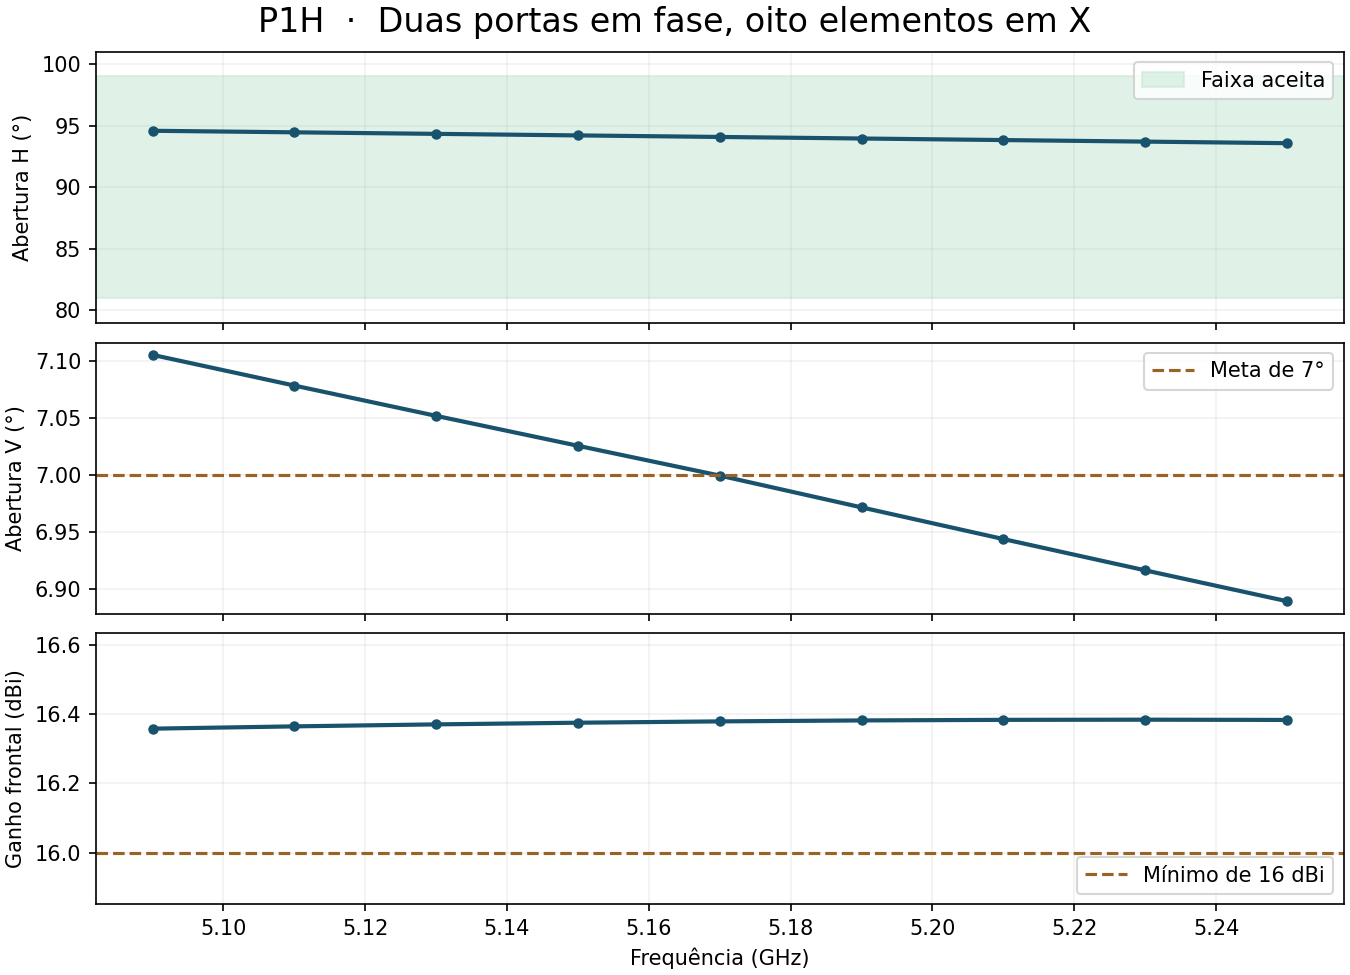
resultados/historico/elemento/banda_AB.png
