Gecesars/emb_ant/resultados/historico/elemento/diagramas_5170.png

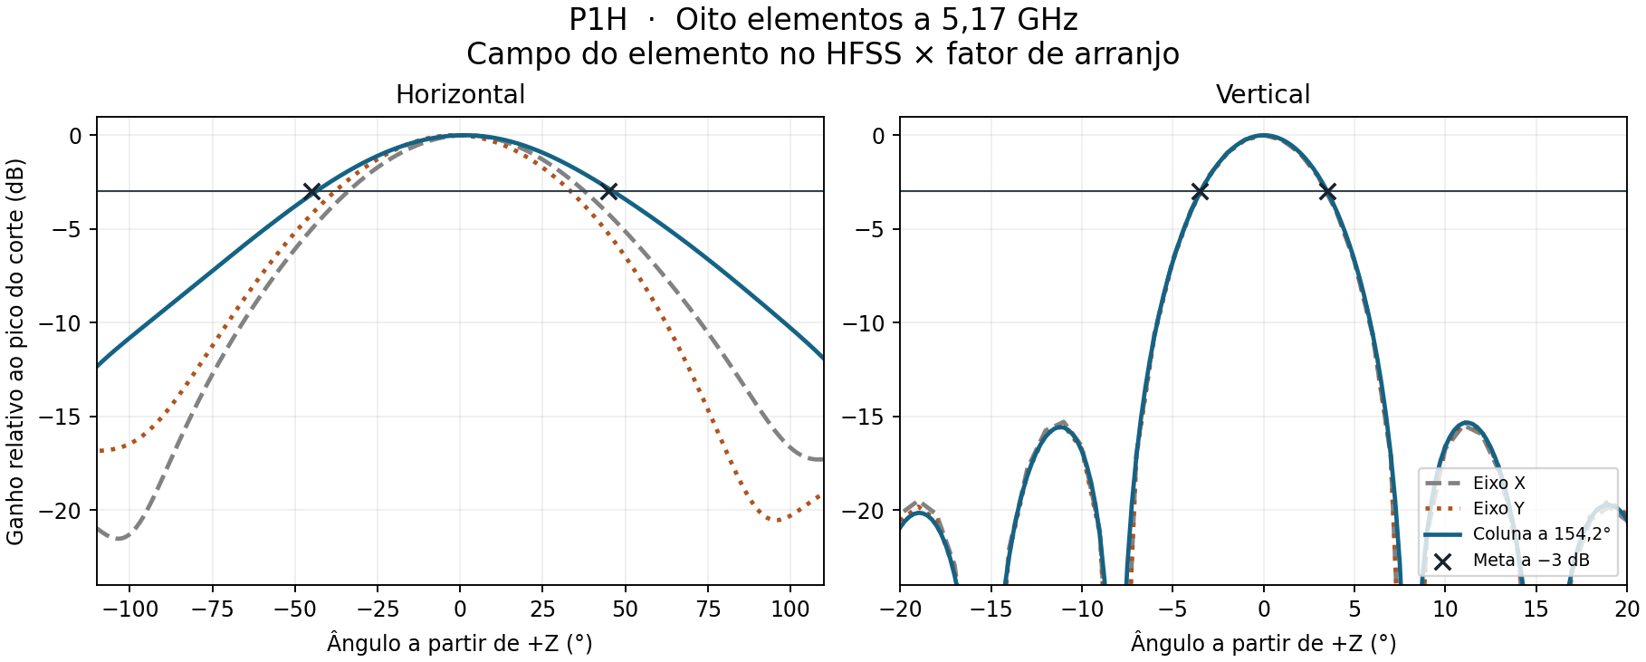
resultados/historico/elemento/diagramas_5170.png
