Gecesars/emb_ant/resultados/r02/JLC_Inferior.jpg

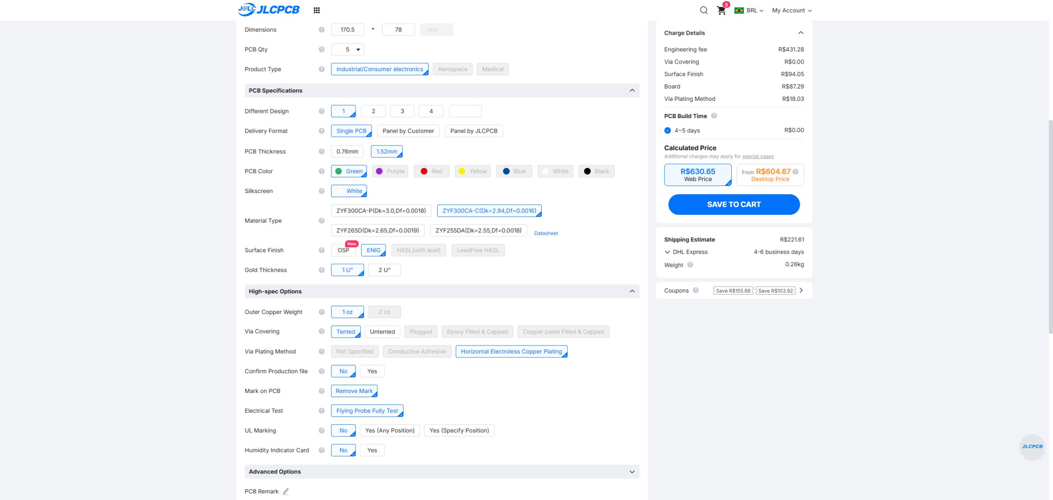
resultados/r02/JLC_Inferior.jpg
