Gecesars/emb_ant/resultados/r06/cotacao/inferior.jpg

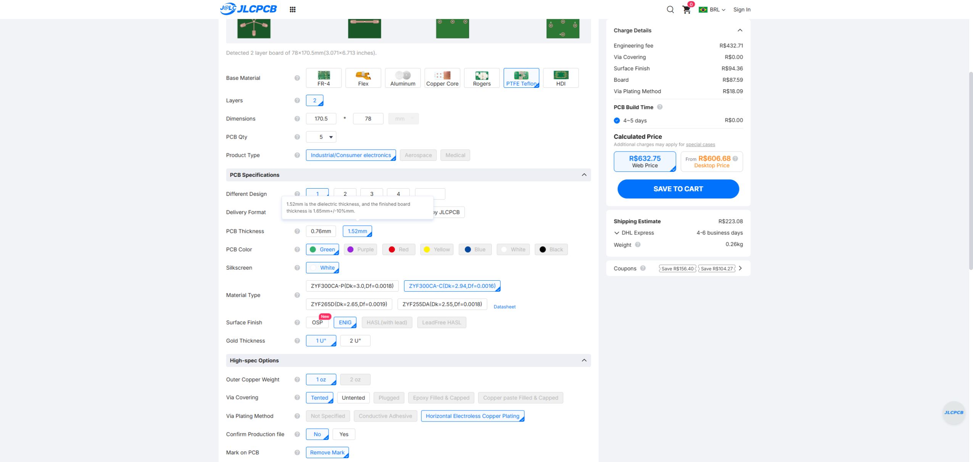
resultados/r06/cotacao/inferior.jpg
