Gecesars/emb_ant/resultados/r06/cotacao/superior.jpg

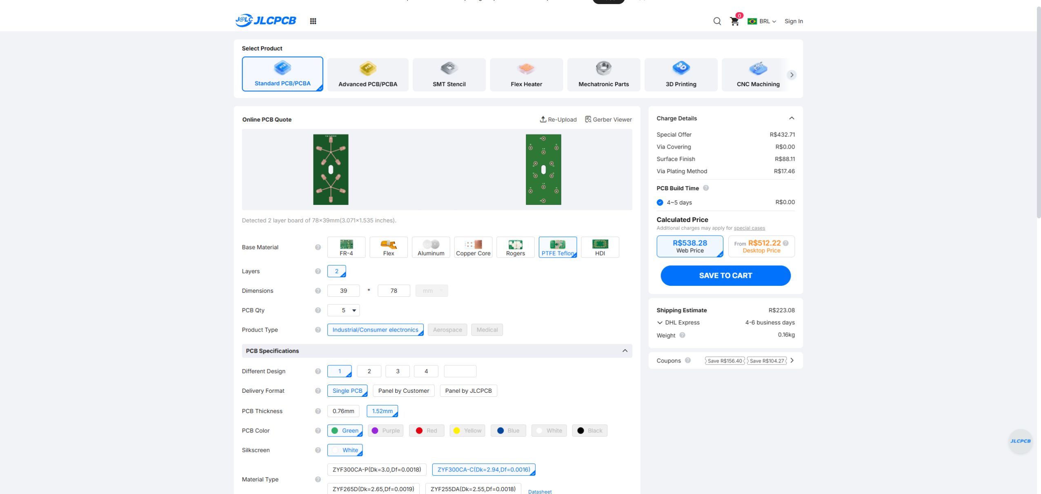
resultados/r06/cotacao/superior.jpg
