Gecesars/emb_ant/resultados/r06/imagens/apoio_passagem.png

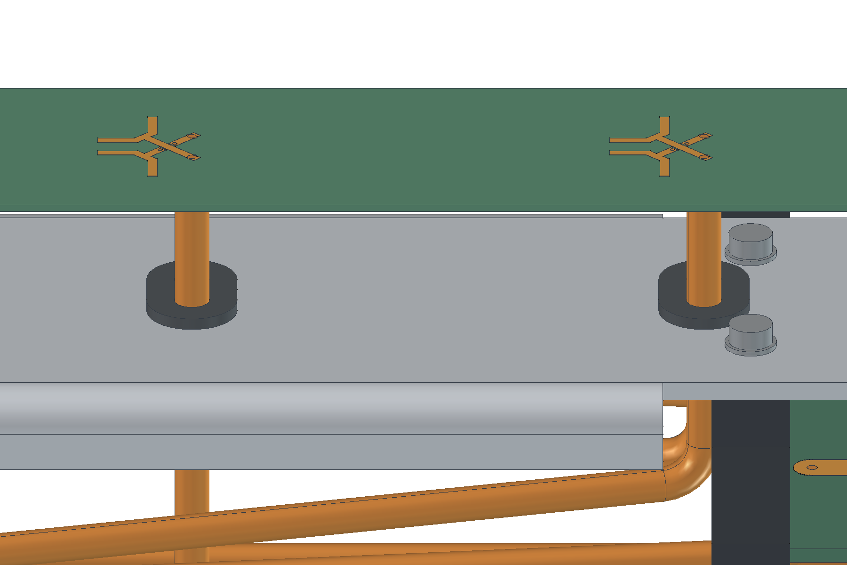
resultados/r06/imagens/apoio_passagem.png
