Gecesars/emb_ant/resultados/r06/imagens/diagramas.png

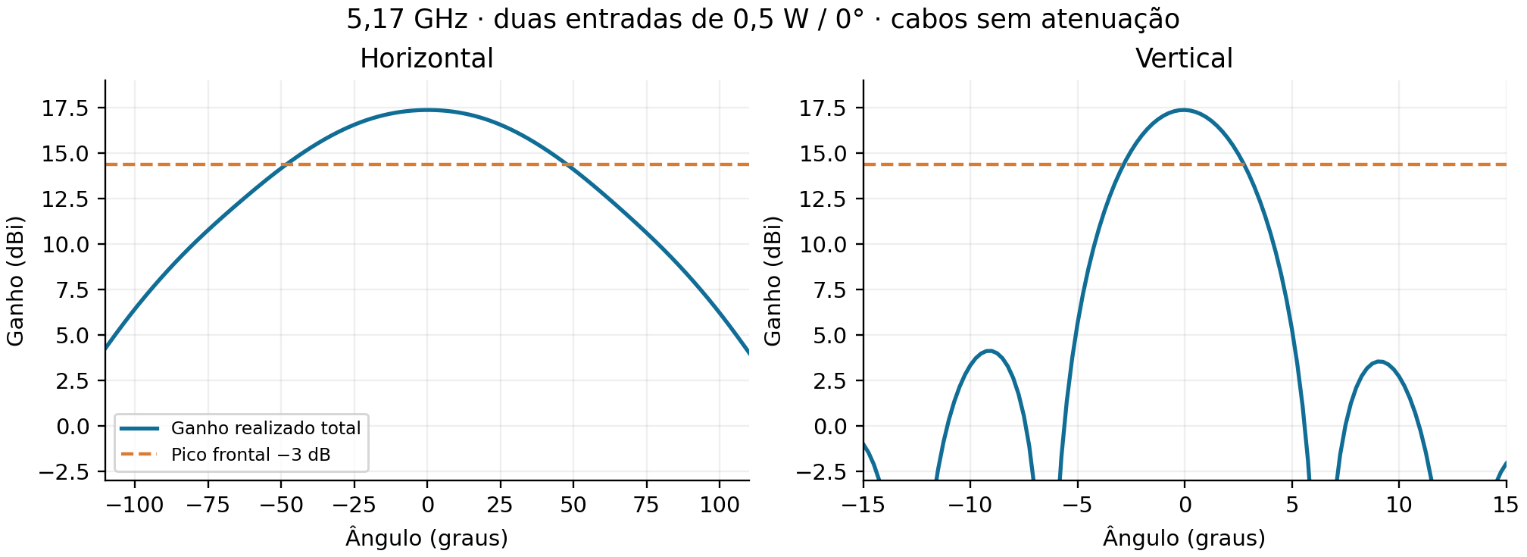
resultados/r06/imagens/diagramas.png
