Gecesars/emb_ant/resultados/r06/imagens/divisor_inferior_inferior.png

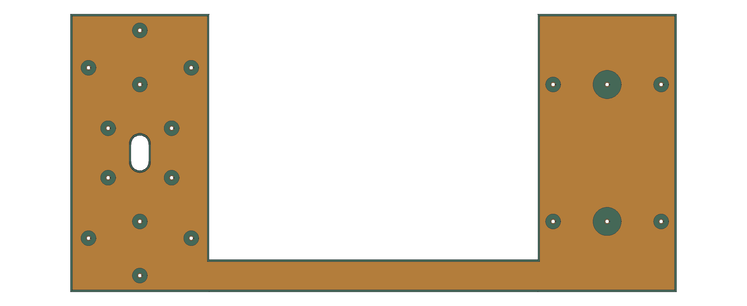
resultados/r06/imagens/divisor_inferior_inferior.png
