Gecesars/emb_ant/resultados/r06/imagens/divisor_superior_inferior.png

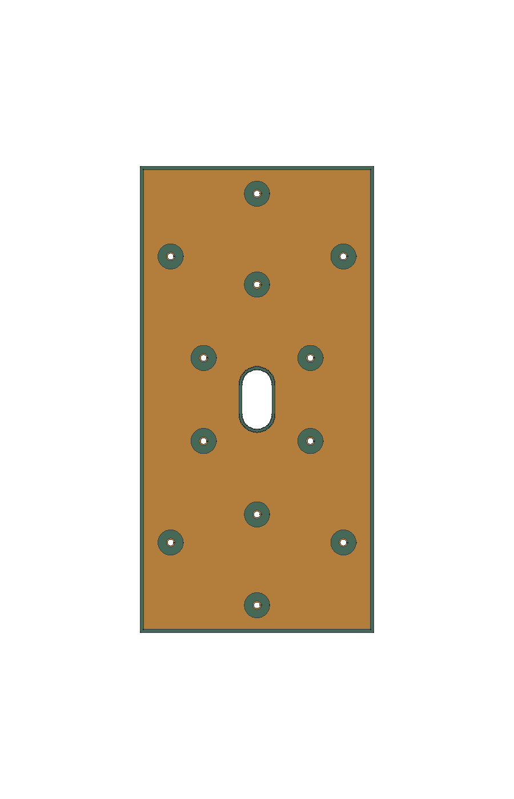
resultados/r06/imagens/divisor_superior_inferior.png
