Gecesars/emb_ant/resultados/r06/imagens/divisor_superior_superior.png

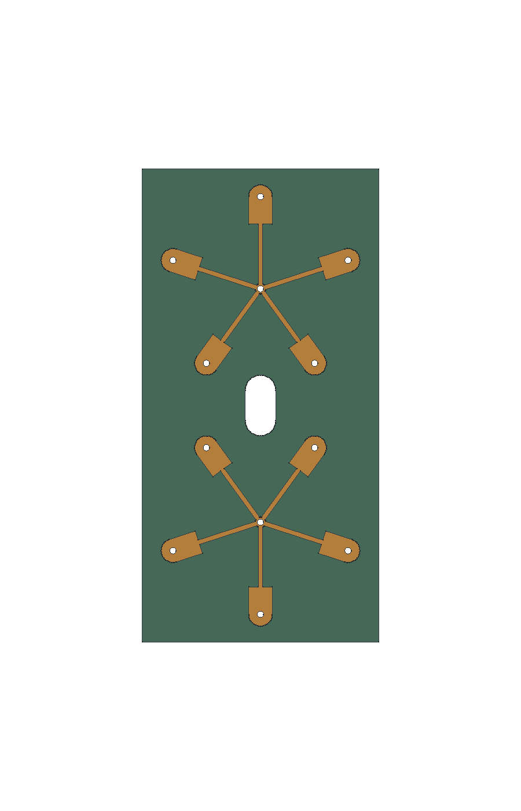
resultados/r06/imagens/divisor_superior_superior.png
