Gecesars/emb_ant/resultados/r06/imagens/pcb_continua_inferior.png

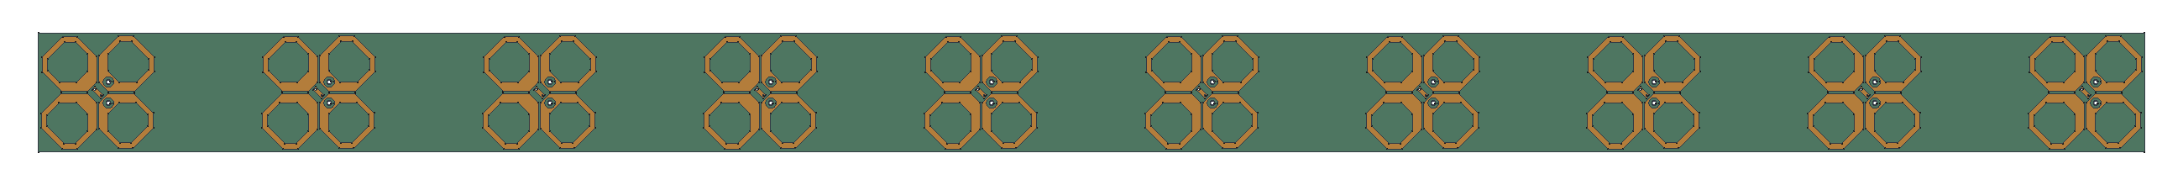
resultados/r06/imagens/pcb_continua_inferior.png
