Gecesars/emb_ant/resultados/r06/imagens/perdas_divisores.png

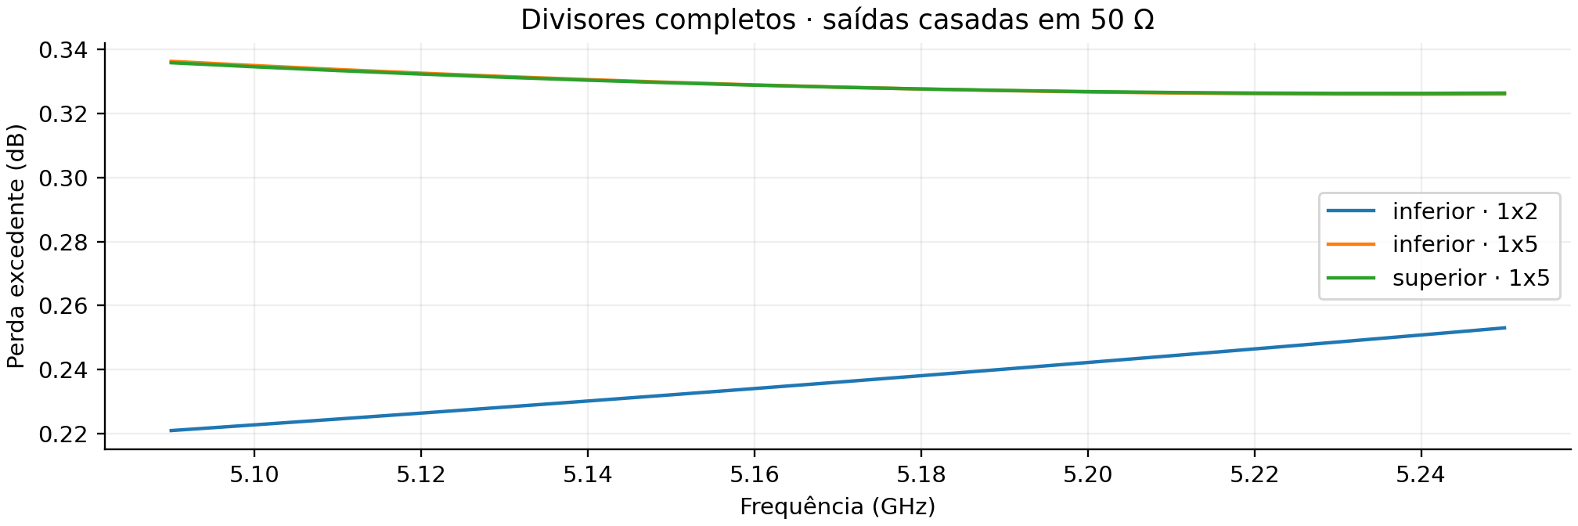
resultados/r06/imagens/perdas_divisores.png
