Gecesars/emb_ant/resultados/r06/imagens/refletor_dobrado.png

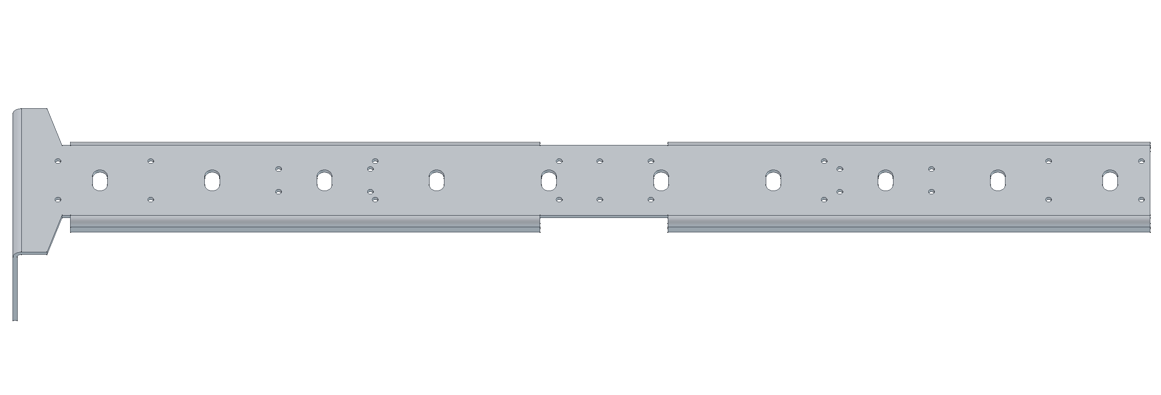
resultados/r06/imagens/refletor_dobrado.png
