Gecesars/emb_ant/resultados/r06/imagens/refletor_planificado.png

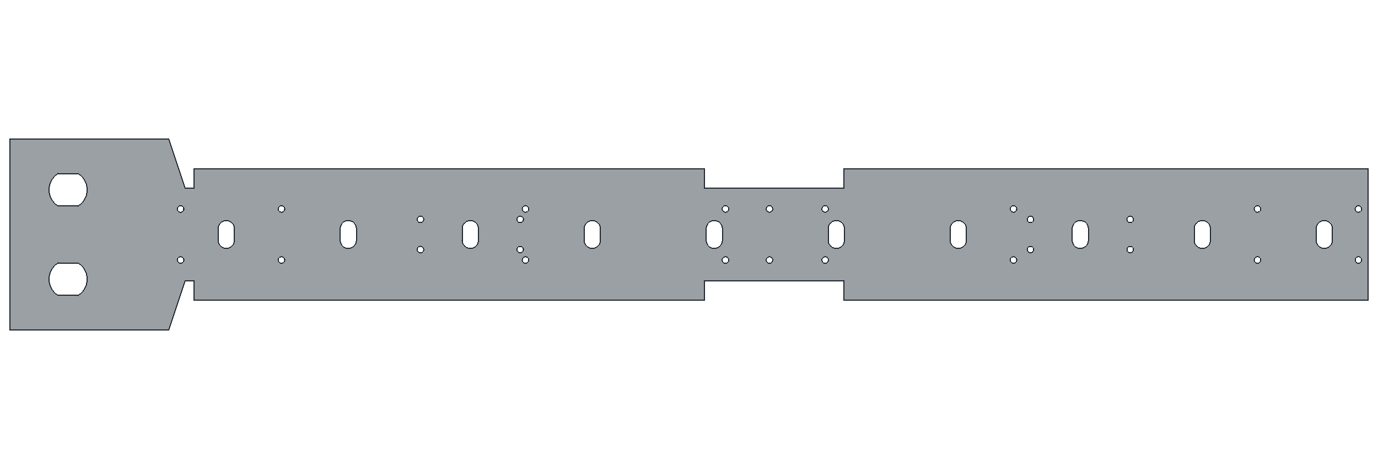
resultados/r06/imagens/refletor_planificado.png
