Gecesars/emb_ant/projetos/P2M21/dois_verticais_divisor/polar_selecionada.pdf

### H: máximo +1.75° | abertura 64.05°

### V: máximo -0.50° | abertura 29.19°

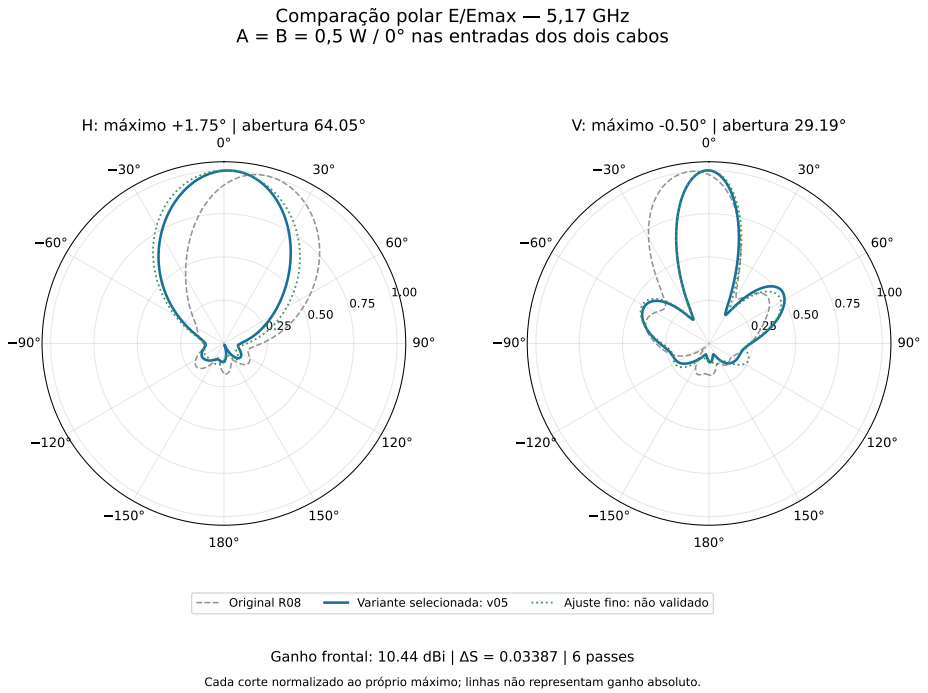
[picture p417: page 1]
Comparação polar E/Emax; 5,17 GHz; Original R08; Variante selecionada: v05; Ajuste fino: não validado

A = B = 0,5 W / 0° nas entradas dos dois cabos

Ganho frontal: 10.44 dBi | S = 0.03387 | 6 passes

Cada corte normalizado ao próprio máximo; linhas não representam ganho absoluto.
