Gecesars/emb_ant/projetos/P2M21/quatro_elementos_casamento_banda/c01_rede_banda/polar_HV.pdf

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

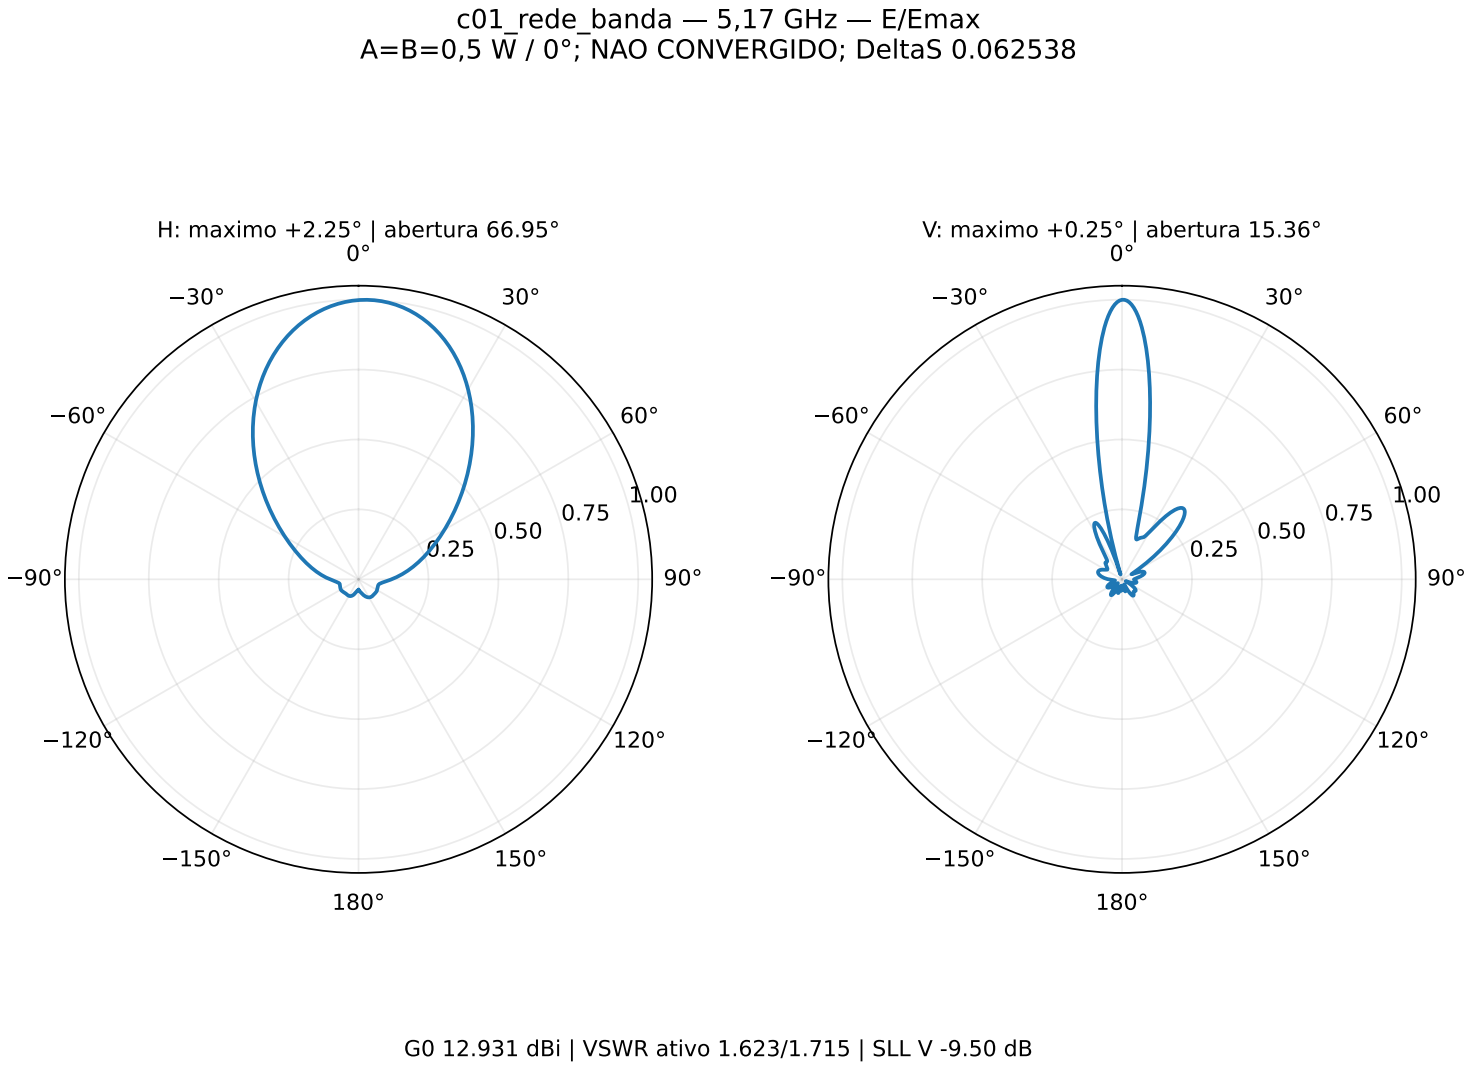
[picture p418: page 1]
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
