Gecesars/emb_ant/projetos/P2M21/quatro_elementos_casamento_banda/c12_raiz_intermediaria/polar_HV.pdf

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

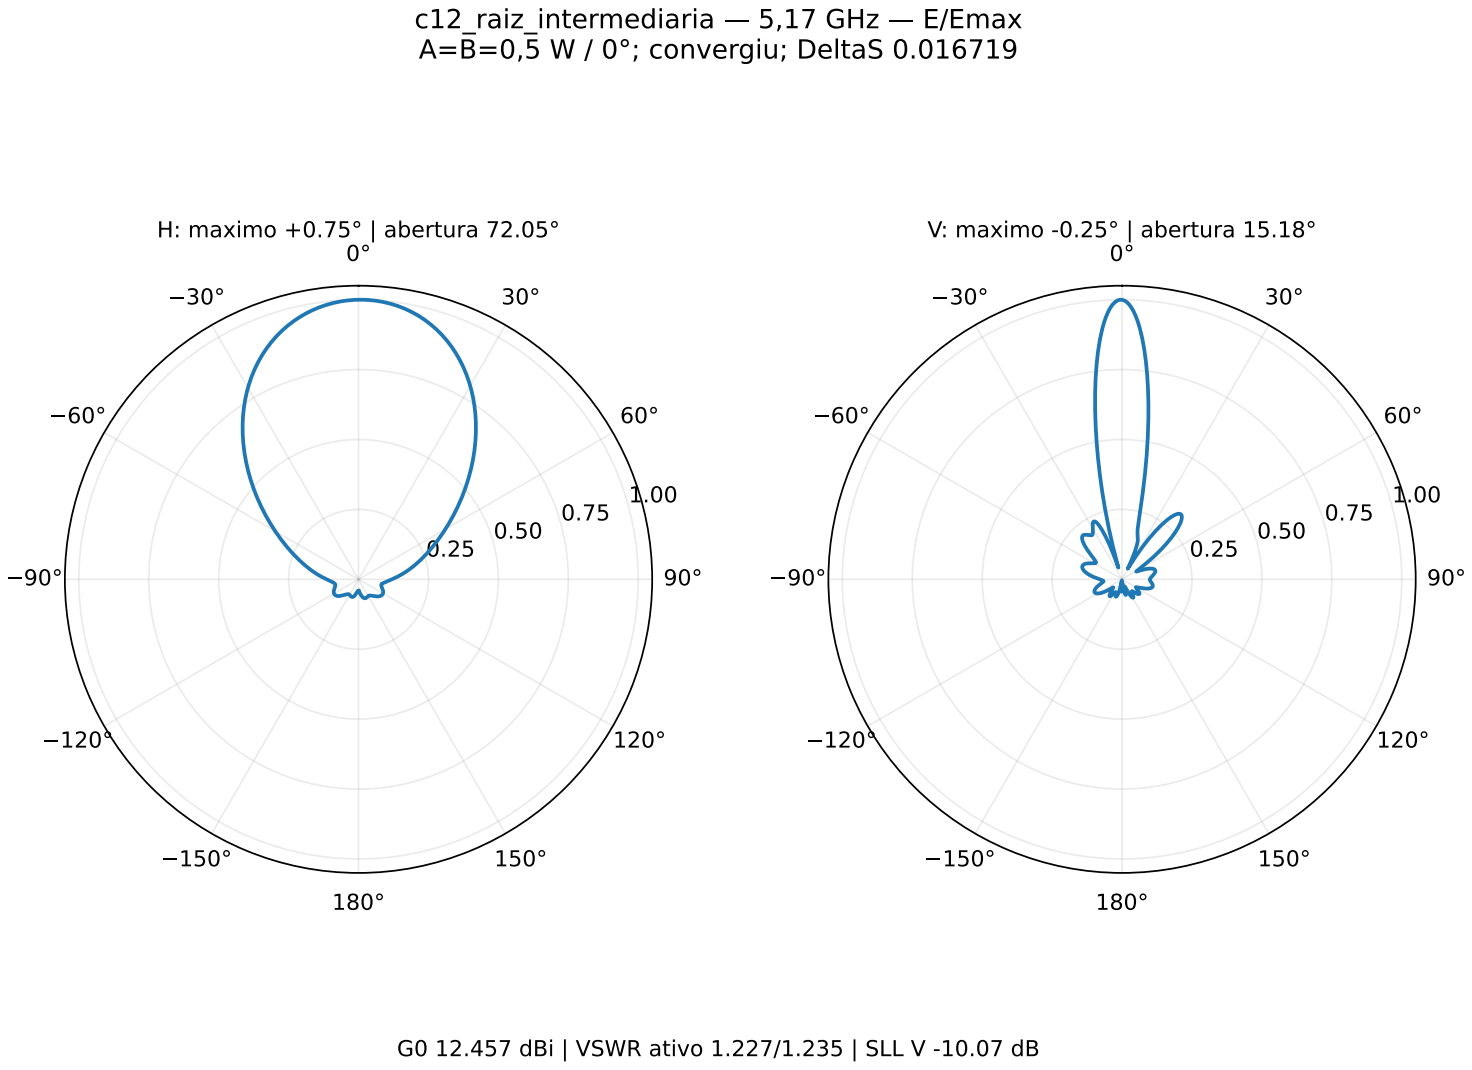
[picture p428: page 1]
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
