Gecesars/emb_ant/projetos/P2M21/quatro_elementos_ajuste/ensaios/v13_passo50_ajustado/polar_HV.pdf

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

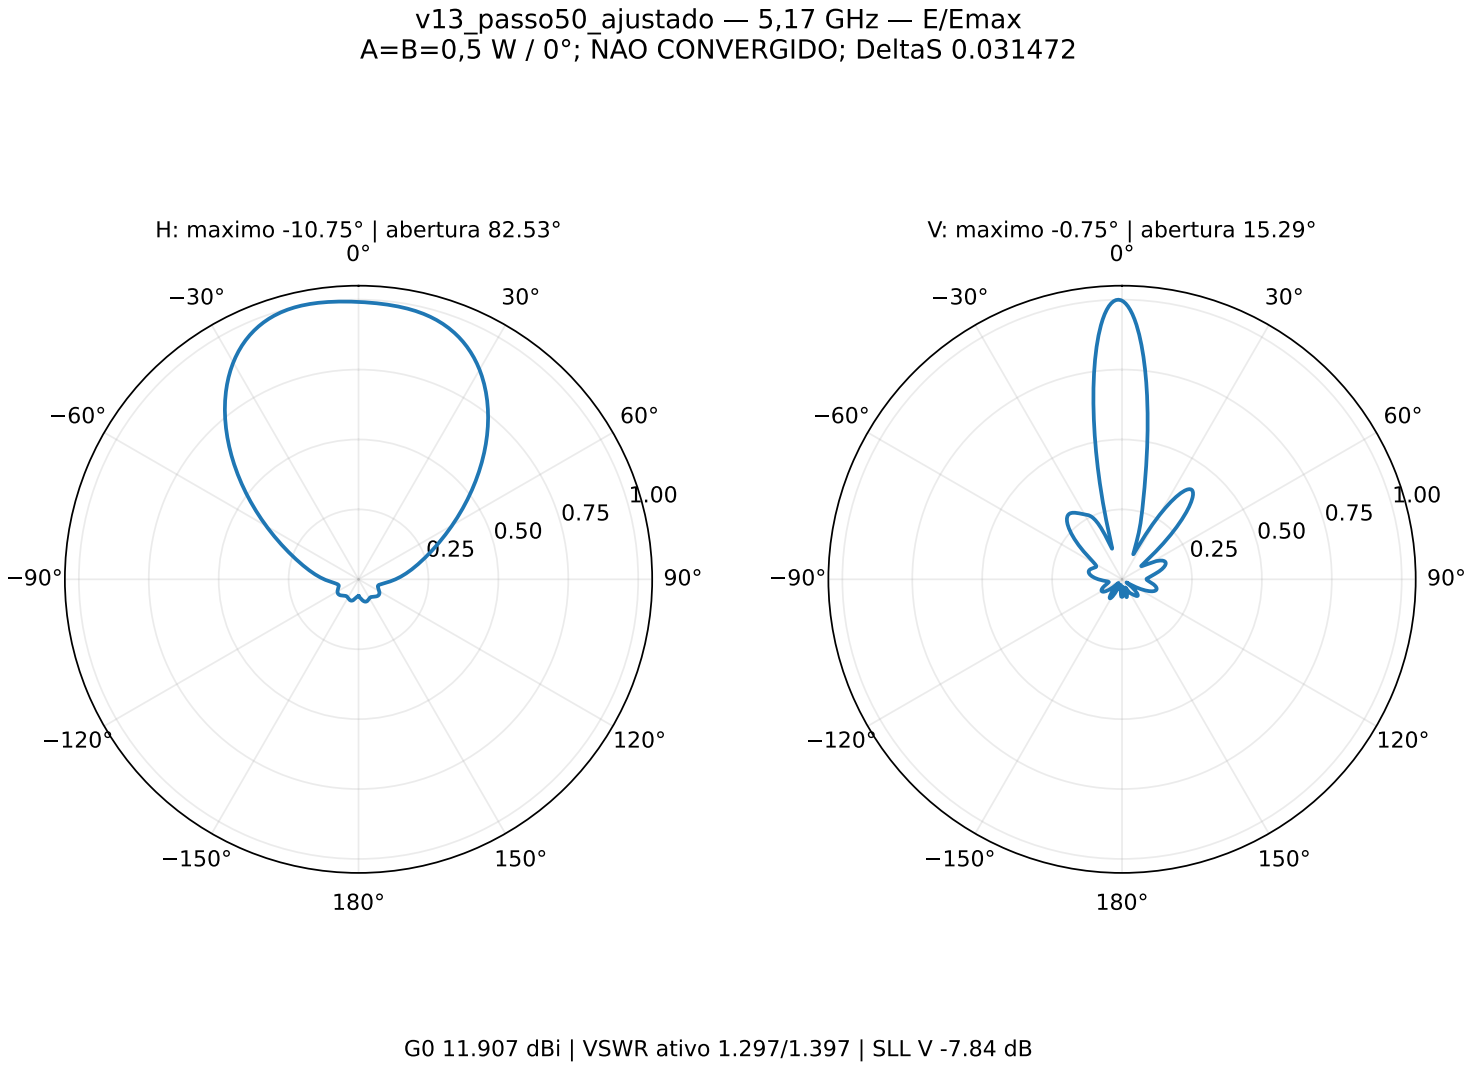
[picture p433: page 1]
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
