Gecesars/emb_ant/projetos/P2S13/kicad/conjunto_R12/divisor_C08/divisor_duplo_1x3_C08.kicad_pcb

## KiCad design projetos/P2S13/kicad/conjunto_R12/divisor_C08/divisor_duplo_1x3_C08.kicad_pcb (2026-11-12)

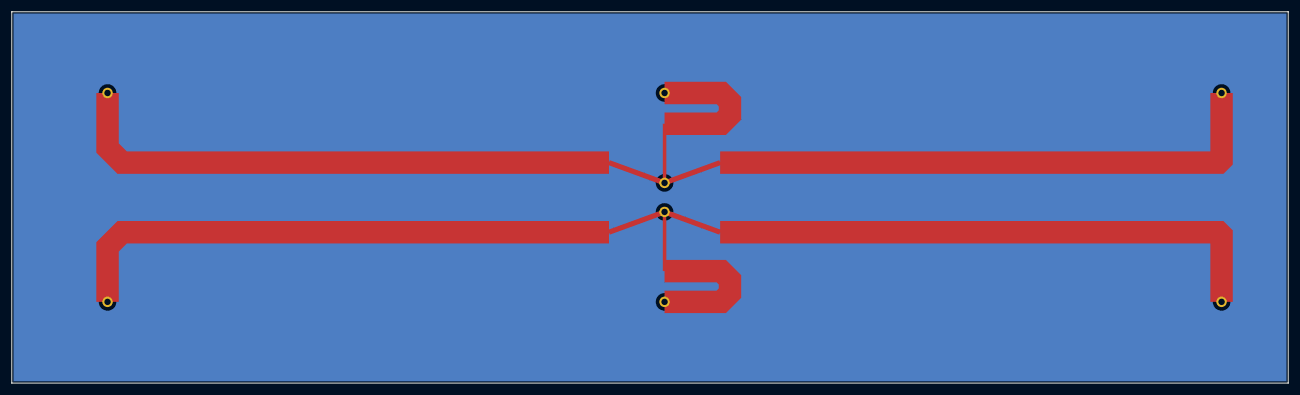
[picture p441: board divisor_duplo_1x3_C08.kicad_pcb from above]

Board: 2 copper layers, 220.0 x 64.0 mm, 8 parts (0 on the bottom side), 3 nets, no tracks yet.

Parts:
J1: IN_A_COAX_SOLDADO
J2: R1_A_COAX_SOLDADO
J3: R2_A_COAX_SOLDADO
J4: R3_A_COAX_SOLDADO
J5: IN_B_COAX_SOLDADO
J6: R1_B_COAX_SOLDADO
J7: R2_B_COAX_SOLDADO
J8: R3_B_COAX_SOLDADO

Connections:
GND: J1.2, J2.2, J3.2, J4.2, J5.2, J6.2, J7.2, J8.2
SIG_A: J1.1, J2.1, J3.1, J4.1
SIG_B: J5.1, J6.1, J7.1, J8.1
