Gecesars/emb_ant/projetos/P2M21/rede_dez_1x4/referencia_1x4/P2M21_Duplo_1x4.kicad_pcb

## KiCad design projetos/P2M21/rede_dez_1x4/referencia_1x4/P2M21_Duplo_1x4.kicad_pcb (2026-11-08)

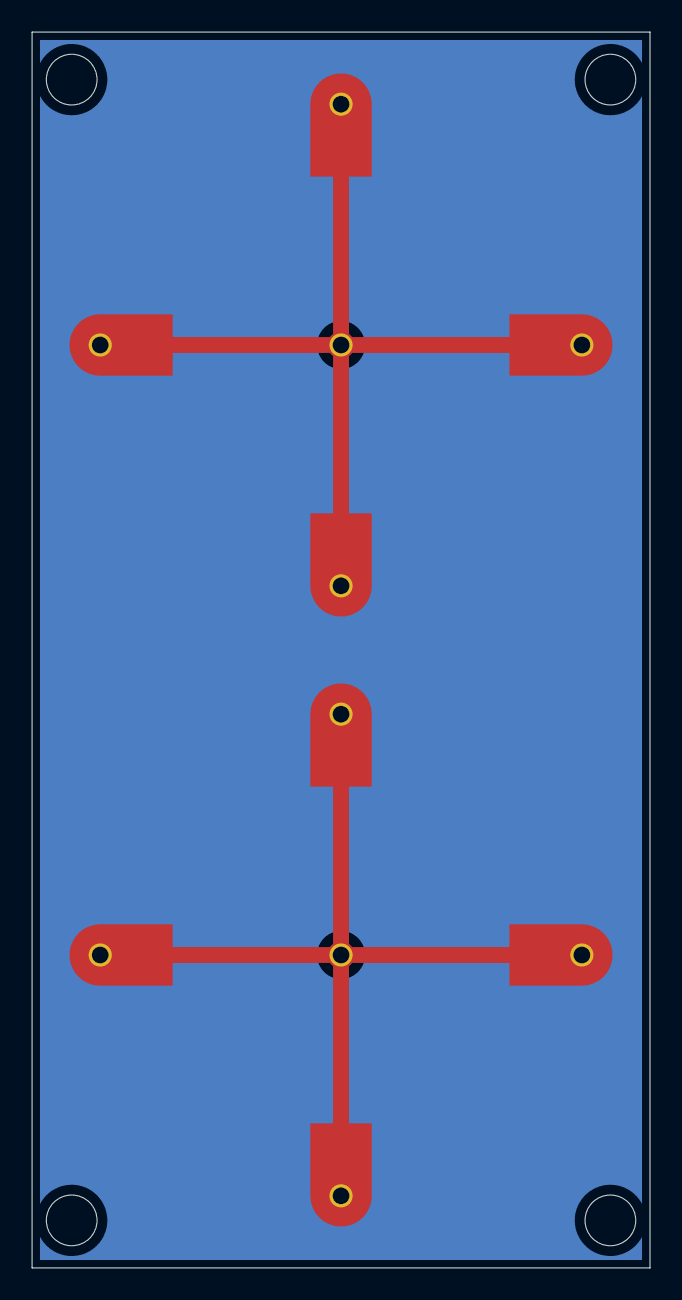
[picture p442: board P2M21_Duplo_1x4.kicad_pcb from above]

Board: 2 copper layers, 39.0 x 78.0 mm, 14 parts (0 on the bottom side), 3 nets, no tracks yet.

Parts:
H1: H1
H2: H2
H3: H3
H4: H4
J1: J1
J2: J2
J3: J3
J4: J4
J5: J5
J6: J6
J7: J7
J8: J8
J9: J9
J10: J10

Connections:
A: J1.1, J2.1, J3.1, J4.1, J5.1
B: J6.1, J7.1, J8.1, J9.1, J10.1
GND: J1.2, J2.2, J3.2, J4.2, J5.2, J6.2, J7.2, J8.2, J9.2, J10.2
