Gecesars/emb_ant/projetos/P2M21/kicad/P2M21_Duplo_1x8/P2M21_Duplo_1x8.kicad_pcb

## KiCad design projetos/P2M21/kicad/P2M21_Duplo_1x8/P2M21_Duplo_1x8.kicad_pcb (2026-11-08)

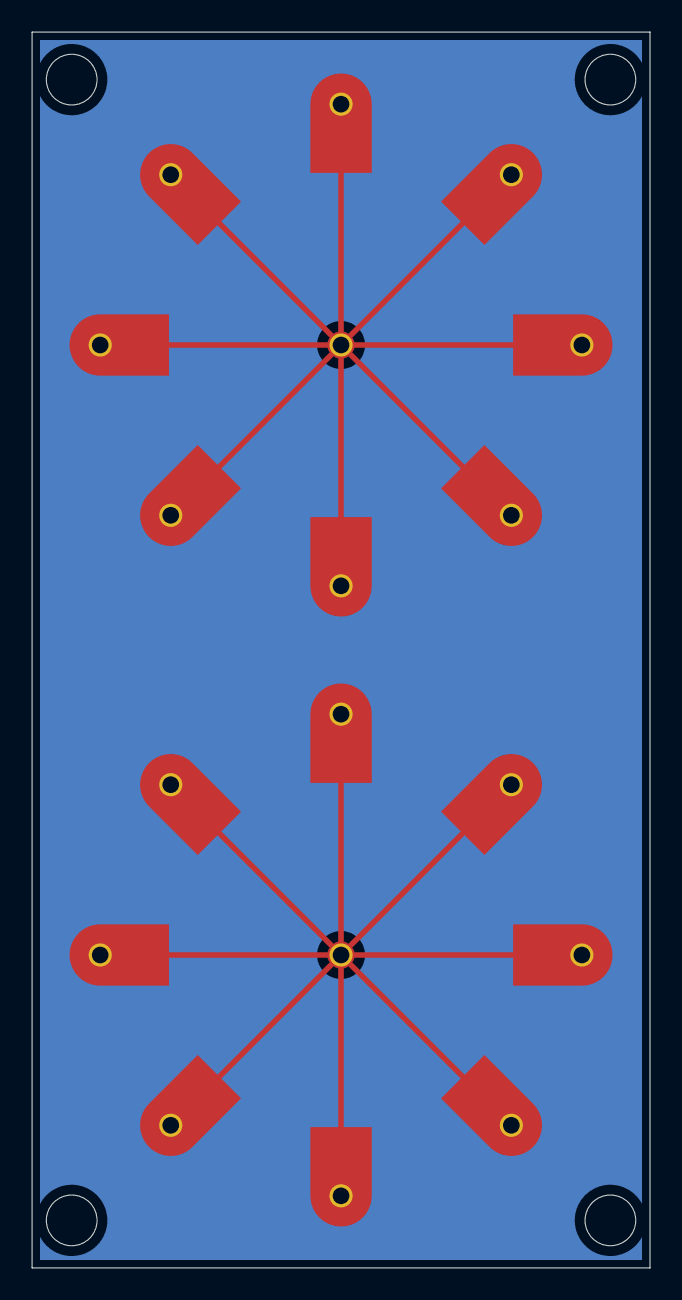
[picture p443: board P2M21_Duplo_1x8.kicad_pcb from above]

Board: 2 copper layers, 39.0 x 78.0 mm, 22 parts (0 on the bottom side), 3 nets, no tracks yet.

Parts:
H1: H1
H2: H2
H3: H3
H4: H4
J1: J1
J2: J2
J3: J3
J4: J4
J5: J5
J6: J6
J7: J7
J8: J8
J9: J9
J10: J10
J11: J11
J12: J12
J13: J13
J14: J14
J15: J15
J16: J16
J17: J17
J18: J18

Connections:
A: J1.1, J2.1, J3.1, J4.1, J5.1, J6.1, J7.1, J8.1, J9.1
B: J10.1, J11.1, J12.1, J13.1, J14.1, J15.1, J16.1, J17.1, J18.1
GND: J1.2, J2.2, J3.2, J4.2, J5.2, J6.2, J7.2, J8.2, J9.2, J10.2, J11.2, J12.2, J13.2, J14.2, J15.2, J16.2, J17.2, J18.2
