Gecesars/emb_ant/kicad/R03_Inferior/R03_ZYF300CA_C_Inferior.kicad_pcb

## KiCad design kicad/R03_Inferior/R03_ZYF300CA_C_Inferior.kicad_pcb (2026-11-07)

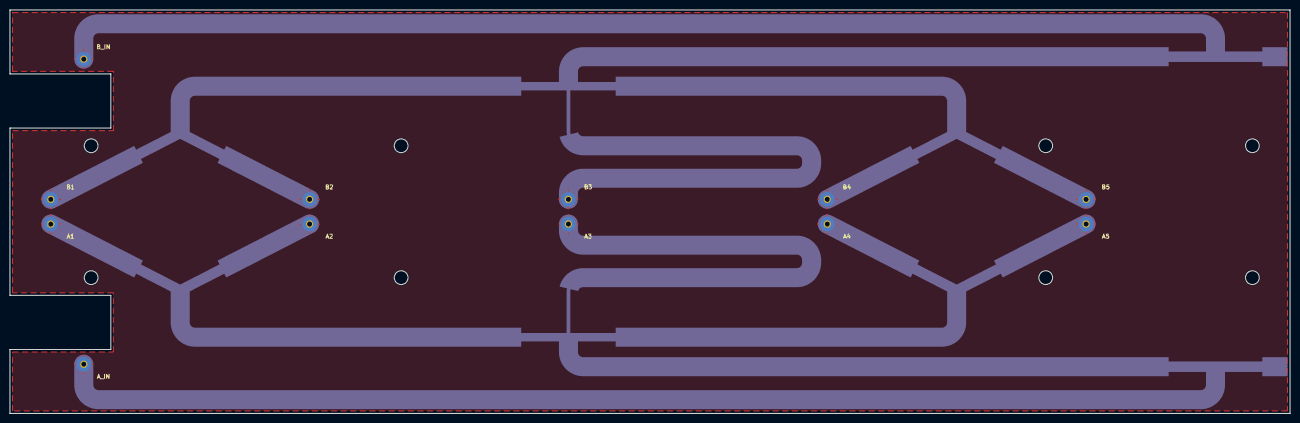
[picture p444: board R03_ZYF300CA_C_Inferior.kicad_pcb from above]

Board: 2 copper layers, 260.1 x 82.0 mm, 20 parts (0 on the bottom side), 3 nets, no tracks yet.

Parts:
H1, H2, H3, H4, H5, H6, H7, H8: Fixacao_M2.5
J1: A_IN_UT141C
J2: A1_UT141C
J3: A2_UT141C
J4: A3_UT141C
J5: A4_UT141C
J6: A5_UT141C
J7: B_IN_UT141C
J8: B1_UT141C
J9: B2_UT141C
J10: B3_UT141C
J11: B4_UT141C
J12: B5_UT141C

Connections:
GND: J1.2, J2.2, J3.2, J4.2, J5.2, J6.2, J7.2, J8.2, J9.2, J10.2, J11.2, J12.2
POL_A: J1.1, J2.1, J3.1, J4.1, J5.1, J6.1
POL_B: J7.1, J8.1, J9.1, J10.1, J11.1, J12.1
