Gecesars/emb_ant/kicad/Divisor_2x10/Divisor_2x10_PTFE.kicad_pcb

## KiCad design kicad/Divisor_2x10/Divisor_2x10_PTFE.kicad_pcb (2026-11-06)

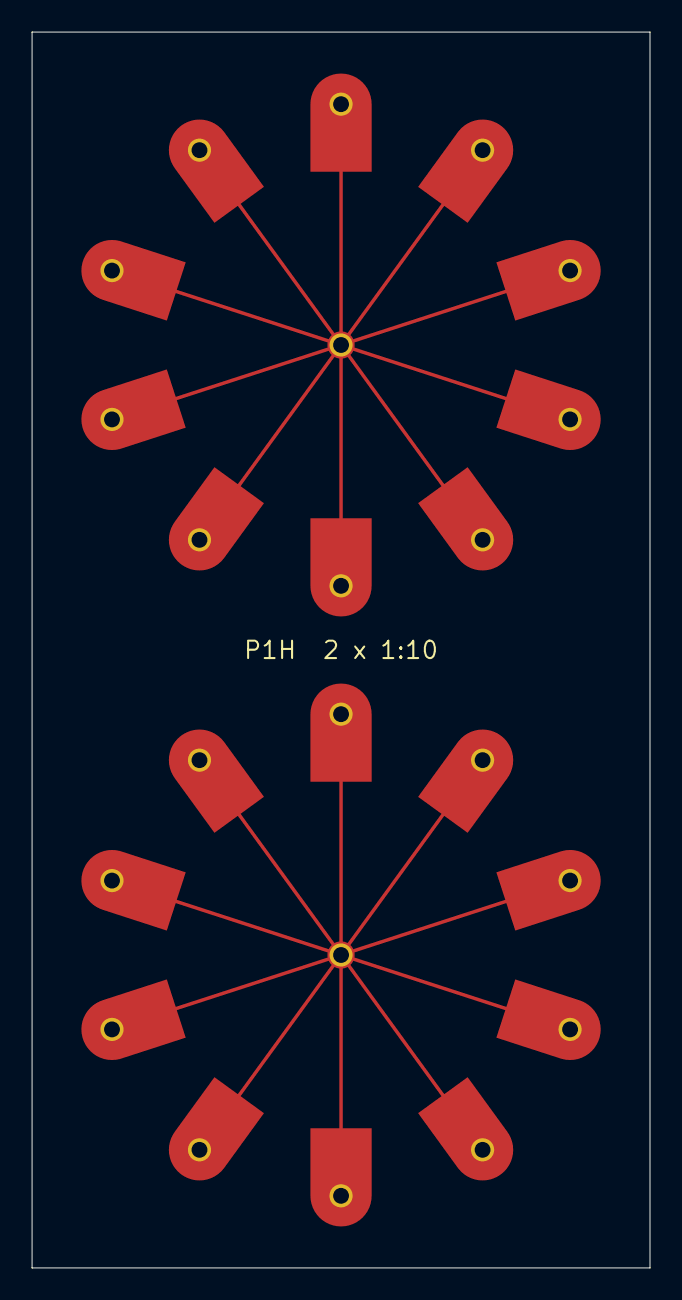
[picture p445: board Divisor_2x10_PTFE.kicad_pcb from above]

Board: 2 copper layers, 39.0 x 78.0 mm, 22 parts (0 on the bottom side), 3 nets, no tracks yet.

Parts:
J1: A_IN_UT141C
J2: A1_UT141C
J3: A2_UT141C
J4: A3_UT141C
J5: A4_UT141C
J6: A5_UT141C
J7: A6_UT141C
J8: A7_UT141C
J9: A8_UT141C
J10: A9_UT141C
J11: A10_UT141C
J12: B_IN_UT141C
J13: B1_UT141C
J14: B2_UT141C
J15: B3_UT141C
J16: B4_UT141C
J17: B5_UT141C
J18: B6_UT141C
J19: B7_UT141C
J20: B8_UT141C
J21: B9_UT141C
J22: B10_UT141C

Connections:
GND: J1.2, J2.2, J3.2, J4.2, J5.2, J6.2, J7.2, J8.2, J9.2, J10.2, J11.2, J12.2, J13.2, J14.2, J15.2, J16.2, J17.2, J18.2, J19.2, J20.2, J21.2, J22.2
POL_A: J1.1, J2.1, J3.1, J4.1, J5.1, J6.1, J7.1, J8.1, J9.1, J10.1, J11.1
POL_B: J12.1, J13.1, J14.1, J15.1, J16.1, J17.1, J18.1, J19.1, J20.1, J21.1, J22.1
