Gecesars/emb_ant/(commit log)

2026-11-06 Organiza os modelos e a documentação da antena setorial P1H
    [Divisor_2x10_PTFE.FCStd, Divisor_2x10_PTFE.kicad_pcb, P1H_10_Continua.FCStd, P1H_10_Separadas.FCStd, P1H_Coluna_10.kicad_pcb, P1H_Individual.kicad_pcb, Radial_Soldado_2x8.kicad_pcb, balanco.csv]
2026-11-06 Projeta a chapa dobrada e a montagem mecânica do painel de dez elementos
    [01_Refletor_dobrado.FCStd, 01_Refletor_dobrado.step, 02_Refletor_planificado.FCStd, 03_Antena_montada.FCStd, 04_Refletor_CORTE_1a1.dxf, 05_Refletor_marcacao_dobras.dxf, 08_Gabarito_dos_cabos.csv, P01_Berco.step]
2026-11-06 Integra o painel R01 no HFSS e confirma a cotação das duas PCBs
    Corrige a interferência dos trilhos com o silicone e verifica 0,25 mm de folga. Inclui o modelo nativo de duas portas N, a geometria nominal dos lançamentos e bobinas, os 22 coaxiais e o roteiro de resolução. Registra os lotes de cinco placas contínuas e cinco divisores por R$ 1.192,14. A validação geométrica e a cotação são independentes do resultado de campo.
    [03_Antena_montada.FCStd, P03_Trilho_E.step, P04_Trilho_D.step]
2026-11-06 Mede o efeito das bobinas no lançamento coaxial em 17 frequências
    No centro da banda, a janela de 4 mm apresenta 0,81 dB de perda de inserção em 50 ohms, contra 1,10 dB com a bobina. A comparação usa duas portas, cobre e PTFE com perda, controle sem bobina e duas malhas convergidas. Inclui as matrizes S e o modelo do painel com TAU Flex e solver iterativo, sem malhas.
    [comparacao.csv]
2026-11-06 Projeto R02 com divisores por metade, vinte ramais iguais de 130 mm e cotações JLCPCB
    Inclui chapas e trilhos, duas placas KiCad com Gerber verificado e as interfaces RF de 26 cabos. Geometria integrada aprovada na validação nativa do HFSS. Qualificação de ganho e abertura em andamento.
    [01_Refletor_dobrado.FCStd, 01_Refletor_dobrado.step, 02_Refletor_planificado.FCStd, 04_Refletor_CORTE_1a1.dxf, 05_Refletor_marcacao_dobras.dxf, Berco_2.step, P1H_R02_compacta.FCStd, R02_Inferior.kicad_pcb]
2026-11-06 Compara divisores e coaxiais R01/R02 em 17 frequências e 20 cargas casadas
    A 5,17 GHz, a perda excedente é 1,192 dB na R01 e 0,849 dB na R02. Dois métodos independentes concordam nas 22 portas a 7,1e-15. Inclui matrizes, convergência e os dois modelos HFSS dos estágios.
    [rede_cargas_50ohm.csv]
2026-11-06 Prepara comparação R02 contínua e dez placas no mesmo refletor e entrega relatório parcial
    Mantém as duas redes, os 26 coaxiais e as duas entradas; modela suportes de POM para os dez radiadores individuais. O PDF distingue o ensaio de alimentação concluído da qualificação de radiação em processamento.
2026-11-07 Registra a reprovação do painel R01 completo no centro da banda
    [Centro_H_5170.csv, Centro_V_5170.csv, adaptacao_centro.csv, diretividade_Centro.csv, metricas_Centro.csv]
2026-11-07 Compara divisores centrais compactos e alongados, quatro PTFE e custo JLCPCB
    [01_Refletor_dobrado.FCStd, 01_Refletor_dobrado.step, 02_Refletor_planificado.FCStd, 04_Refletor_CORTE_1a1.dxf, 05_Refletor_marcacao_dobras.dxf, P1H_R03_alongada.FCStd, R03_ZYF300CA_C_Inferior.kicad_pcb, R03_ZYF300CA_C_Superior.kicad_pcb]
2026-11-07 Valida oito cupons HFSS dos laminados JLC em 17 frequencias
    [comparacao_com_cupons.csv, cupons_hfss.csv]
2026-11-07 Registra desequilibrio da rede alongada e inicia controle de espessura
    [compactas_hfss.csv, rede_hfss_centro.csv]
2026-11-07 Conclui comparacao HFSS dos quatro PTFE e controle alongado de 0,76 mm
    [compactas_hfss.csv, rede_hfss_centro.csv]
2026-11-07 Conclui comparacao dos paineis completos e relatorio de qualificacao RF
    Registra resultados HFSS convergidos em 5,17 GHz com duas entradas N,
    0,5 W a 0 graus em cada uma, cabos, divisores, bobinas e mecanica completa.
    R02 continua: H94,82 graus, V5,54 graus e ganho realizado11,998 dBi.
    R02-S dez radiadores: H105,13 graus, V5,57 graus e ganho13,479 dBi.
    Ambas reprovam o requisito de H81-99 graus e >=16 dBi em toda a banda.
    Avaliacao dos paineis encerrada no centro reprovado. Redes compactas e
    cupons de quatro materiais simulados nos17 pontos de5,09 a5,25 GHz.
    Confere passividade, reciprocidade, concordancia de ganho e dois passes
    consecutivos deltaS<=0,015. Preserva CSV, S2P, convergencia e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
    [Centro_H_5170.csv, Centro_V_5170.csv, diretividade_Centro.csv, metricas_Centro.csv]
2026-11-07 Prepare R05 matching correction and validated ENIG/coil models
    Keep the continuous ten-element PCB and compact dual-polarization dividers. Replace the stripped coax window at each DC coil with a 1 mm radial opening, widen the reflector face to 40 mm, and route equal 290/132/135 mm inputs, trunks, and branches. Deliver the folded/flat reflector, A3 drawings, assembly, and cable list. OCCT finds no collisions and 1.25953 mm minimum cable clearance.
    Validate isolated coils, connector diagnostics, dividers, and the coupled twenty-port radiator model. The ENIG solid-copper 1:2 coupon passes eight adaptive iterations, two consecutive Delta S <= 0.008, and all 17 discrete frequencies, with 0.209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
    [01_Refletor_dobrado.FCStd, 01_Refletor_dobrado.step, 02_Refletor_planificado.FCStd, 04_Refletor_CORTE_1a1.dxf, 05_Refletor_marcacao_dobras.dxf, Centro_H.csv, Centro_V.csv, E01_A_H.csv]
2026-11-07 Document Drive connector CAD reference and RF limitations
2026-11-07 R06: separar PCBs no HFSS e preparar qualificacao por circuito
    Adota o aceite solicitado em 5,17 GHz: VSWR <1,5, ganho frontal realizado >=16 dBi e H entre 81 e 99 graus, com duas entradas de 0,5 W em fase e sem atenuacao dos cabos. Encerra o escopo integral R05 com chicote 3D.
    Inclui modelos e fila de calculo separados, auditoria de S/campos, refinamento local, recomposicao de campos e circuito Nexxim. A primeira malha da PCB convergiu em 16 passes: 17,3975 dBi, H95,0569 e V5,5589 com alimentacao direta uniforme. Ainda nao e qualificacao com a rede: os divisores e a verificacao local da malha permanecem pendentes.
    Registra vistas detalhadas da PCB, divisores e montagem FreeCAD; roteiro do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
    [Centro_H.csv, Centro_V.csv]
2026-11-07 R06: ajustar ramais para 133 mm e preservar qualificacao preliminar
    Conclui as duas distribuidoras em 17 frequencias e registra a verificacao Nexxim do candidato sem atenuacao nos cabos. A primeira malha apresenta 17,3477 dBi, H 95,2059 graus e VSWR maximo 1,2303; o aceite final continua pendente da malha refinada. Atualiza montagem FreeCAD, desenhos A3 e imagens, preserva a chapa e os Gerbers, e arquiva evidencias sem malhas.
    [01_Refletor_dobrado.FCStd, 01_Refletor_dobrado.step, 02_Refletor_planificado.FCStd, 04_Refletor_CORTE_1a1.dxf, 05_Refletor_marcacao_dobras.dxf, E01_A_H.csv, E01_A_V.csv, E01_B_H.csv]
2026-11-07 R06: conferir malha refinada e continuar criterios mais estritos
    A malha de 11 passes manteve 17,3447 dBi, H 94,3761 graus e VSWR maximo 1,23735, mas H mudou 0,82976 grau frente a inicial. Preserva dados e continua no passe12 com DeltaS0,004 e campo0,02dB. Corrige a auditoria para separar avisos historicos por TimeStamp: a malha refinada tem zero Major e dois Minor. Nao libera RF nem envia relatorio antes da estabilidade.
    [Centro_H.csv, Centro_V.csv, E01_A_H.csv, E01_A_V.csv, E01_B_H.csv, E01_B_V.csv, E02_A_H.csv, E02_A_V.csv]
2026-11-08 R06: preservar solucao de 21 passes e conferir estabilidade final
    Solucao rigorosa convergida apresenta 17,3599 dBi, H95,9455 graus e VSWRmax1,24633, mas H difere1,5694 grau dos11passes. Inicia pelo menos dois passes adicionais, mantendo os mesmos criterios e refinamento15porcento. Preserva S20 e40campos sem malhas; aceite e email continuam pendentes.
    [Centro_H.csv, Centro_V.csv, E01_A_H.csv, E01_A_V.csv, E01_B_H.csv, E01_B_V.csv, E02_A_H.csv, E02_A_V.csv]
2026-11-08 R06: preservar falha de memoria e retomar estabilidade com crescimento de 5%
2026-11-08 Qualificar P1H R06: 17.359 dBi, H96.064 e VSWR max1.247 em 5.17GHz
    PCB completa de 20 portas e divisores S18/S12 separados; cabos ideais de fase. Convergencia final em 23 passes, 6665585 tetraedros, estabilidade frente a21 aprovada e Nexxim conferido. Relatorio ilustrado de15 paginas revisado, mecanica/PCB/cotacao JLC e 343 artefatos rastreados, sem malhas ou campos volumetricos. Aceite restrito a5.17GHz, materiais nominais e N ideal; envio final por email na sequencia.
    [AL5052.step, Centro_H.csv, Centro_V.csv, Divisor_Inferior.FCStd, Divisor_Superior.FCStd, E01_A_H.csv, E01_A_V.csv, E01_B_H.csv]
2026-11-08 Inicia R07 em 17 frequencias com limite de seis passes e DeltaS 0.02
2026-11-08 Exige auditoria da malha R07 antes de liberar a varredura
2026-11-08 Recupera R07 com varredura na malha R06 validada apos falta de memoria
2026-11-08 Inicia P2M21 MIMO 16x2 e preserva P1H como semipronta
    Novo requisito confirmado: ganho frontal realizado >=21 dBi por entrada MIMO nos 17 pontos de5.09-5.25 GHz, outra entrada casada50ohms. R00 com32 radiadores em16niveis pares, duas colunas e4PCBs radiantes2x4. Distribuicao central duplo1:4 e4locais duplos1:8.
    Inclui tres projetos KiCad, montagem/planificacao FreeCAD e STEP/DXF, tres projetos HFSS separados64/10/18portas com Cu35um/ENIG, mapa de conexoes, comparacao de alternativas e imagens revisadas. Geometria reaberta sem intersecoes; DRC zero erros/zero desconectados, avisos de mascara registrados.
    Predimensionamento21.67dBi/H37.85graus no centro e apenas estimativa com reserva assumi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
    [AL5052.step, P2M21_Antena.FCStd, P2M21_Duplo_1x4.FCStd, P2M21_Duplo_1x4.kicad_pcb, P2M21_Duplo_1x8.FCStd, P2M21_Duplo_1x8.kicad_pcb, P2M21_Modulo_2x4.kicad_pcb, P2M21_Montagem.FCStd]
2026-11-08 Registra P2M21 sem convergencia em seis passes e bloqueio da qualificacao de banda
2026-11-09 Estima arranjos P2M21 com todas as portas A/B iguais e em fase
    [comparacao_40mm.csv, comparacao_completa.csv]
2026-11-09 Prepara malha P2M21 uniforme e fila de 17 pontos com Delta S 0.04
2026-11-09 Inclui evidencias compactas de preparacao e reparos TAU do centro
2026-11-09 Entrega P2M21 preliminar em quatro passes com ganho diagramas e DeltaS
    [Uniforme_H.csv, Uniforme_V.csv, evolucao_passes.csv, resultados_centro.csv]
2026-11-09 Conclui dois passes adicionais P2M21 e revisa polares E sobre Emax
    [P2M21_Horizontal_E_Emax.csv, P2M21_Vertical_E_Emax.csv, Uniforme_H.csv, Uniforme_V.csv, resultados_centro.csv]
2026-11-09 Planeja dez divisores 1x4 e posiciona cinco PCBs duplas P2M21
    [P2M21_Dez_1x4_Posicionamento.FCStd, P2M21_Duplo_1x4.FCStd, P2M21_Duplo_1x4.kicad_pcb, mapa_logico.csv]
2026-11-09 Compara dez variantes de divisor e retorno no modulo P2M21 de dois elementos
    Conexoes simetricas e ajustes de trilha com duas entradas 0,5 W/0 graus em 5,17 GHz, 14 nucleos e seis passes. Preserva modelos HFSS/FreeCAD, matrizes S, campos distantes e evidencias sem malhas. v05 converge com 10,442 dBi e picos H+1,75/V-0,50 graus; v09 chega a H+0,25/V-0,25 sem completar dois passes consecutivos. Meta de zero grau ainda nao validada.
    [AB_H.csv, AB_V.csv, A_H.csv, A_V.csv, B_H.csv, B_V.csv, Dois_Verticais.FCStd, comparacao.csv]
2026-11-09 Cria placa KiCad 2_elementos da v05 e planeja modulo vertical de quatro elementos
    Preserva arte RF de dois elementos e divisores 1:2, RO4350B 0,76 mm, contorno 49x82,8 mm. Confere cobre por rede/camada, continuidade e DRC: zero erros, zero desconectados, 138 avisos de mascara aberta intencional. Inclui Gerber, Excellon e rastreabilidade. Propoe quatro radiadores a 48 mm, placa 70x178,8 mm e duas arvores 1:4 centrais; novo conjunto ainda nao simulado.
    [2_elementos-B_Cu.gbl, 2_elementos-B_Mask.gbs, 2_elementos-Edge_Cuts.gm1, 2_elementos-F_Cu.gtl, 2_elementos-F_Mask.gts, 2_elementos-NPTH.drl, 2_elementos-PTH.drl, 2_elementos-job.gbrjob]
2026-11-09 Simula modulo de quatro elementos com divisores 1:4 e cabos
    [4_elementos.FCStd, AB_H.csv, AB_V.csv, A_H.csv, A_V.csv, B_H.csv, B_V.csv, resumo.csv]
2026-11-09 Estuda espacamento e altura do refletor no modulo P2M21 de quatro elementos
    Compara 42/44/48/50/52/54 mm, reajusta os transformadores comuns A/B e verifica alturas de 14,949/16,610/18,271 mm. Preserva a comparacao controlada de altura separada do ajuste posterior de casamento.
    Candidato numerico: passo48 mm, altura14,949 mm, raiz0,656371 x9,000142 mm. G0=12,7018 dBi; VSWR ativo1,2327/1,0940, casado1,1041/1,1808; H/V73,630/15,180 graus; SLLV=-8,385 dB. Maximos ainda em-1/-1,25 graus.
    Nao liberado: seis passes, DeltaS0,057225 acima do alvo0,05, zero de dois consecutivos. Nenhum ensaio R11 completou convergencia. Todos em5,17 GHz,14nucleos,semGUI,duas fontes0,5W/0graus e dois cabos fisicos50m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
    [4_elementos.FCStd, AB_H.csv, AB_V.csv, A_H.csv, A_V.csv, B_H.csv, B_V.csv]
2026-11-09 P2M21: converge modulo em oito passes e verifica VSWR com Fast
    Continua exatamente os passes 7 e 8 da variante com passo48mm e altura14.949mm, preservando historico, malha e geometria. Fontes A=B=0.5W/0graus, dois cabos fisicos50mm, 14nucleos. Convergencia real: DeltaS0.019769973, dois passes abaixo de0.05, zero Major/Minor.
    Em5.17GHz: ganho frontal12.758603dBi; VSWR ativo1.364823/1.228512 e casado1.209073/1.173343; H73.322195/V15.058432graus, maximos0/-1.25graus, SLLvertical-9.094837dB. Casamento<1.3 e apontamento vertical ainda pendentes.
    Fast5.09–5.25GHz com161pontos de saida, somente parametrosS; diagramas apenas LastAdaptive5.17GHz. Piores VSWR ativos2.279596/2.014202 em5.09GHz. His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
    [4_elementos.FCStd, AB_H.csv, AB_V.csv, A_H.csv, A_V.csv, B_H.csv, B_V.csv, vswr_banda_fast.csv]
2026-11-10 P2M21: atinge VSWR 1.25 na banda no modulo de quatro elementos
    Ajusta os transformadores impressos com tres secoes simetricas por raiz,
    preservando os dipolos, passo de 48 mm, altura de 14.949 mm e duas fontes
    de 0.5 W a 0 graus. C12: pior VSWR ativo 1.23548 e casado 1.23260 na
    banda de 5.09 a 5.25 GHz. Fast com 161 pontos conferido por Discrete em
    5.09/5.17/5.25 GHz e no pico de 5.173 GHz; erro S no pico de 2.044e-6,
    sem adaptacao adicional e com 14 nucleos.
    Centro em 5.17 GHz: G0 = 12.4566 dBi, H = 72.055 e V = 15.183 graus,
    maximos H +0.75 e V -0.25 grau, SLL vertical -10.075 dB. Seis passes,
    DeltaS final 0.016719, dois consecutivos abaixo de 0.05, zero reparos
    Major/Minor; passividade,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
    [4_elementos.FCStd, AB_H.csv, AB_V.csv, A_H.csv, A_V.csv, B_H.csv, B_V.csv, vswr_banda.csv]
2026-11-10 P2M21: cria 4_elementos no KiCad e Gerbers da geometria C12
    [4_elementos-B_Cu.gbl, 4_elementos-B_Mask.gbs, 4_elementos-Edge_Cuts.gm1, 4_elementos-F_Cu.gtl, 4_elementos-F_Mask.gts, 4_elementos-NPTH.drl, 4_elementos-PTH.drl, 4_elementos-job.gbrjob]
2026-11-10 P2M21: monta oito celulas C12 e registra ensaio central nao convergido
    R14 preserva as oito PCBs 4_elementos em 16 niveis x 2 colunas, com passo horizontal aprovado de 72 mm. Modelo HFSS completo com refletor comum, 16 coaxiais locais e 16 portas iguais/em fase, 1 W total, 5.17 GHz, 14 nucleos e seis passes. DeltaS final 0.164297 nao atende 0.05; ganho 18.8776 dBi, H25.2549/V3.7541 graus, VSWR ativo maximo 1.8421. Arquiva CAD, nativo HFSS, S16, campos complexos, auditorias e imagens revisadas, sem malhas ou resultados volumetricos. Comparacao R04 identificada como historica e nao convergida; rede externa permanece pendente.
    [ALL_H.csv, ALL_V.csv, C1R1_A_H.csv, C1R1_A_V.csv, C1R1_B_H.csv, C1R1_B_V.csv, C1R2_A_H.csv, C1R2_A_V.csv]
2026-11-10 P2M21: conclui mecanica R18 preliminar e interrompe ensaios HFSS
    Atende ao pedido de interromper simulacoes e entregar a montagem preliminar com dez PCBs C12 (20 niveis x 2 colunas), passos 48/78 mm, refletor Al 2 mm dobrado e planificado, 40 grampos POM e dois N Amphenol 082-6784 do STEP fornecido. Inclui FreeCAD, STEP, DXFs 1:1, BOM, 12 imagens, relatorio de 10 paginas e 3 pranchas A3 revisadas.
    Mantem 410 objetos das celulas; verifica 581 objetos fisicos validos, 312 pares sem interferencia e recortes passantes. Cabo UT-141C e comprimentos propostos documentados; duas redes 1:10, chicote final, curto DC, fechamento e fixacao externa permanecem pendentes. Nao ha liberacao de fabricacao ne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
    [82-6784.stp, ALL_H.csv, ALL_V.csv, C1R1_A_H.csv, C1R1_A_V.csv, C1R1_B_H.csv, C1R1_B_V.csv, C1R2_A_H.csv]
2026-11-10 Corrige malha do refletor P2S13 e registra RF preliminar
    Reconstrucao nativa da mesma dobra reduz geracao inicial de mais de 56 minutos sem concluir para 129 segundos no Classic, sem reparos. Preserva placas, materiais, geometria e recursos; documenta tentativas rejeitadas e conferencia booleana.
    Resultado central com quatro entradas em fase, 14 nucleos e seis passes: 12.905 dBi, H 78.234, V 7.543, DeltaS 0.06705. Mantem reprovacao por convergencia, metas e reciprocidade. Inclui nativos, campos distantes, S4 e manifesto byte a byte; exclui malhas e caches.
    [AL5052.step, ALL_H.csv, ALL_V.csv, P2S13.FCStd, POL_A_H.csv, POL_A_V.csv, POL_B_H.csv, POL_B_V.csv]
2026-11-10 P2S13: cria placa2 simetrica e documenta tres ensaios 4+2
    Adiciona dois divisores 1:2 simetricos derivados das etapas locais da C12, quatro ramos iguais e auditoria CAD de continuidade/isolacao. Preserva a placa4 C12 e a antiga KiCad 2_elementos. Testa seis niveis, quatro entradas0.25W/0graus e cabos50mm fisicos, em5.17GHz,14nucleos,max6passes,sem sweep.
    Tres refletores b20/60,b20/90,b10/90: H73.71/78.01/85.91graus e G10.939/11.134/10.145dBi. Todos preliminares: apenas1/2passes consecutivos DeltaS<=0.05,campos instaveis; b20/90 tambem falha reciprocidade. Metas13dBi/H99-121/V16.2-19.8 nao atingidas; VSWR da placa2 exige ajuste. Nao aprova pela simetria ou pelo limite de passes.
    Arquiva148a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
    [2_elementos_simetrica.FCStd, AL5052.step, ALL_H.csv, ALL_V.csv, P2S13_6elementos.FCStd, POL_A_H.csv, POL_A_V.csv, POL_B_H.csv]
2026-11-11 P2S13: ajusta transformadores simetricos da PCB2 para VSWR central abaixo de 1.25
    Modifica somente largura e comprimento dos transformadores para 0.546717 x 13.151813 mm. Preserva ramos iguais, fases externas 0 graus, PCB4, radiadores, retornos, refletor b10/90 e cabos fisicos de 50 mm. Triagem por matriz Z4 congelada seguida de HFSS completo do painel 4+2, em 5.17 GHz, 14 nucleos, seis passes, sem sweep.
    PCB2: VSWR ativo A/B 1.19565/1.16847 e com outras entradas casadas 1.15011/1.21075. Ganho frontal total 10.65673 dBi, H 87.2966 graus, V 10.0732 graus; picos -1.75/+2.50 graus. PCB4 tem VSWR ativo maximo 1.25950. Meta numerica PCB2 atendida, mas resultado PRELIMINAR: DeltaS final 0.042633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
    [2_elementos_simetrica.FCStd, ALL_H.csv, ALL_V.csv, P2S13_Casamento2.FCStd, POL_A_H.csv, POL_A_V.csv, POL_B_H.csv, POL_B_V.csv]
2026-11-11 P2S13: conclui passes 7 e 8 preservando a malha da PCB2 ajustada
    Retoma somente os dois passes autorizados, em 5,17 GHz, com 14 nucleos e quatro entradas iguais/em fase. Confere hashes da malha antes da retomada e preservacao integral do historico de seis passes e da revisao original.
    DeltaS final 0,01642882 com tres passes consecutivos abaixo de 0,05. VSWR ativo PCB2 A/B 1,220846/1,149802; com demais entradas casadas 1,101247/1,147077. Ganho frontal total do conjunto 4+2 10,75545 dBi, aberturas H/V 86,7382/10,1479 graus e maximos -0,50/+2,50 graus.
    Mantem resultado sem validacao completa: estabilidade de uma sonda de campo e reciprocidade reprovadas. Sem relaxar tolerancias ou modificar a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
    [ALL_H.csv, ALL_V.csv, P2S13_Casamento2.FCStd, POL_A_H.csv, POL_A_V.csv, POL_B_H.csv, POL_B_V.csv, R1_A_H.csv]
2026-11-11 P2S13: cria tres PCBs2 e aproxima abertura horizontal de 100 graus
    Interrompe e preserva a campanha 4+2 a pedido do usuario. Bloqueia a
    retomada das filas antigas e registra o ensaio que terminou durante a
    parada, sem iniciar outro solve dessa topologia.
    Cria cinco variantes reais do conjunto de tres PCBs2 identicas, seis
    niveis a 48 mm, seis cabos fisicos de 50 mm e seis entradas de 1/6 W a
    0 graus. HFSS headless em 5,17 GHz, 14 nucleos, sem sweep, maximo de seis
    passes por geometria e alvo DeltaS 0,05 por dois passes consecutivos.
    Caso mais proximo: dobra iniciando a 28,5 mm do eixo, angulo 150 graus.
    Ganho frontal realizado 13,2799006 dBi; H 99,3178475 graus; V 9,9109612
    graus conforme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
    [AL5052.step, ALL_H.csv, ALL_V.csv, P2S13_Dobras.FCStd, P2S13_TresPCB2.FCStd, POL_A_H.csv, POL_A_V.csv, POL_B_H.csv]
2026-11-11 P2S13: concluir oito passes e planejar divisor duplo 1:3
    Preserva malha e seis passes; executa somente 7/8 a 5,17 GHz com 14 nucleos. DeltaS 0,017600, ganho frontal 13,349 dBi e H/V 98,727/9,931 graus. Mantem ressalvas de campo, reciprocidade e VSWR direto.
    Dimensiona duas redes Wilkinson simetricas em circuito, carrega S6 real com os cabos existentes e confere a interconexao no Nexxim. VSWR maximo estimado 1,198; plano sem layout/validacao EM do divisor. Arquiva nativos, campos distantes, figuras e 69 artefatos verificados por SHA256, sem malhas.
    [ALL_H.csv, ALL_V.csv, P2S13_TresPCB2.FCStd, POL_A_H.csv, POL_A_V.csv, POL_B_H.csv, POL_B_V.csv, R1_A_H.csv]
2026-11-11 P2S13: simulate physical dual 1:3 divider and report loaded RF mismatch
    Build mirrored planar unequal/equal Wilkinson networks in HFSS and preserve
    both the initial layout and C01 junction correction. Each geometry uses
    5.17 GHz, 14 cores, no sweep, and no more than six adaptive passes.
    C01 meets DeltaS 0.05 for two consecutive passes (last 0.04945786).
    Connect exported S8 to the unchanged antenna S6 and embedded fields with
    two 0.5 W / 0 degree inputs. Active VSWR 1.3188/1.4170 exceeds 1.25;
    frontal realized gain 11.7724 dBi is below 13 dBi, H/V 99.308/10.321 deg.
    Retain amplitude/phase imbalance, reciprocity and antenna field-stability
    limitations, component assumptions, and excluded spat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
    [Alumina_nominal.step, Divisor_Duplo3.FCStd, PTFE_terminal.step, SAC305.step, ZYF300.step, copper.step, diagrama_H.csv, diagrama_V.csv]
2026-11-11 P2S13: center the vertical main lobe with a corrected dual 1:3 divider
    Replace the cascaded layout with mirrored direct three-way networks and tune physical trace lengths while keeping both external inputs at 0.5 W / 0 degrees. Preserve all eight HFSS candidates, CAD, circuit data and illustrated results without meshes.
    Selected C07 at 5.17 GHz: 12.746 dBi frontal realized gain, active VSWR 1.093/1.092, H/V widths 98.614/10.162 degrees and vertical peak -0.01 degree on the fine angular grid. Main-lobe asymmetry within +/-4 degrees is 0.060 dB. The divider converged in six passes with 14 cores and DeltaS 0.023112; Nexxim agrees within 8.63e-16.
    Document the user's revised >=12 dBi goal and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
    [AL5052.step, ALL_V.csv, Divisor_Duplo3.FCStd, PTFE_terminal.step, R1_A_V.csv, R1_B_V.csv, R2_A_V.csv, R2_B_V.csv]
2026-11-11 P2S13: reproduce the C07 dual 1:3 divider in KiCad and export JLC CAM
    Preserve the simulated 220 x 64 mm C07 copper, impedance transformers, compensation lengths, ground antipads and eight non-plated coax holes. Add the editable KiCad 10 project, Gerber X2 / Excellon package, illustrated fabrication notes and reproducible exporters.
    Verified zero boolean differences against the source HFSS CAD, continuous A/B and ground networks, zero open connections and less than 0.000003 mm CAM boundary deviation. Restore the native 0.919500 mm drill diameter after KiCad tool-format truncation and verify all drill coordinates.
    Keep nine DRC errors and 25 full-mask-opening warnings visible: copper to NPT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
    [conexoes.csv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]
2026-11-12 P2S13: archive manufacturable C08 and reject invalid radome solve
    Preserve six-pass HFSS output, diagnose iterative solver failure and nonphysical power balance, and label all RF values and plots as invalid. Include verified C08 KiCad/Gerbers, native CAD/HFSS, five-page reviewed diagnostic report and reproducible scripts, without meshes.
    [ALL_H.csv, ALL_V.csv, ALL_V_fino.csv, Divisor_Duplo3.FCStd, IN_A_H.csv, IN_A_V.csv, IN_B_H.csv, IN_B_V.csv]
2026-11-12 P2S13: simplify cable joints and enable curvilinear direct-solver study
    Merge 18 same-material contacts without changing exterior geometry, reduce basis order, enable GlobalCurvilinear, and verify the saved native setup before a six-pass 14-core solve. Archive preparation evidence; RF results remain pending and the active AEDT stays local.
    [P2S13_Curvilinear.FCStd]
2026-11-12 Documenta R12 concluida sem convergencia e corrige auditoria do solver direto
    Seis passes a 5,17 GHz, 14 nucleos, fontes 0,5 W em fase: DeltaS 0,0783068, ganho frontal 11,5719 dBi, VSWR ativo 1,6199/1,5228. Potencia consistente; principal vertical centrado em -0,0079 grau, assimetria 0,0676 dB. Nao atende convergencia, ganho frontal ou casamento. Exporta nativo fechado, S2, campos distantes, graficos preliminares e evidencias, sem malhas. Auditoria recuperada sem novo solve; 48 artefatos conferidos byte a byte.
    [ALL_H.csv, ALL_V.csv, ALL_V_fino.csv, IN_A_H.csv, IN_A_V.csv, IN_B_H.csv, IN_B_V.csv, POL_A_H.csv]
2026-11-12 Conclui passes 7 e 8 da R12 e entrega KiCad e montagem FreeCAD
    Malha, geometria, fontes e seis passes iniciais preservados; somente dois passes novos com 14 nucleos, 5,17 GHz e sem sweep. DeltaS 0,0418775/0,0342912, convergencia S atendida; ganho frontal 11,5693 dBi e VSWR ativo 1,5475/1,4550 ainda reprovam metas. Potencia consistente; simetria V e estabilidade de campo permanecem pendentes.
    Inclui M00 KiCad exata (3 placas), C08 reutilizada, Gerbers conferidos e DRC zero erros/desconectados. Montagem de 123 solidos do modelo RF salva e deixada aberta no FreeCAD, com imagens e interfaces mecanicas pendentes documentadas. Conferidos 106 artefatos byte a byte no indice; sem malhas, campos vol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
    [2_elementos-B_Cu.gbl, 2_elementos-B_Mask.gbs, 2_elementos-Edge_Cuts.gm1, 2_elementos-F_Cu.gtl, 2_elementos-F_Mask.gts, 2_elementos-NPTH.drl, 2_elementos-PTH.drl, 2_elementos-job.gbrjob]
2026-11-12 Cria C09 compacto com ramais iguais e verifica antena no Nexxim
    Substitui o estudo integral com radome por HFSS separado da antena S6 e do divisor S8, sem cabos longos em 3D. C09 mede 36 x 78 mm e usa duas secoes identicas em cada um dos seis ramais. Mantem seis cabos fisicos de 134 mm no CAD; Nexxim usa RLGC de 133,82 mm entre planos de referencia.
    Em 5,17 GHz e duas entradas 0,5 W / 0 graus, Nexxim confirma VSWR ativo 1,5283 / 1,6999; a meta 1,25 nao foi atingida. Recomposicao dos campos: ganho frontal 13,9252 dBi, H/V 86,228 / 10,073 graus, maximos H/V 0 / +0,0691 grau. Abertura H inferior ao alvo aproximado de 100 graus.
    Antena: seis passes, DeltaS 0,0243789; divisor: cinco passes, Del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
    [ALL_H.csv, ALL_V.csv, ALL_V_fino.csv, Antena_C09_SemRadome_PRELIMINAR.FCStd, Divisor_Duplo3.FCStd, P2S13_Compacto_SemRadome.FCStd, PCB_SemCabos.FCStd, POL_A_H.csv]
2026-11-12 Ajusta C09 para VSWR abaixo de 1.25 com antena e confirma no HFSS e Nexxim
    [Antena_C09_Ajustada_PRELIMINAR.FCStd, Divisor_Duplo3.FCStd, PTFE_terminal.step, SAC305.step, ZYF300.step, copper.step, diagrama_H.csv, diagrama_V.csv]
2026-11-12 P2S13: estudar tubo PVC DN100 e ressintonizar C09 para a antena
    Pesquisa de tubos Tigre Serie Normal e montagem nominal DN100: De101,6 mm, parede1,8 mm, L350 mm, extremidades abertas. Encaixe conservador com folga radial1,39 mm. PVC er2,68/tand0,008 e hipotese de referencia, nao medicao ou certificacao do tubo comercial. Abertura passa a ser informativa.
    HFSS separado S6/S8, sem cabos longos3D; seis coaxiais iguais de134 mm com perdas nominais somente no Nexxim. Duas entradas0,5W/0graus,5,17GHz,14nucleos,max6passes,sem sweep. C09 com tubo iniciou em VSWR1,43449/1,44216. Dois ajustes comuns das secoes preservaram terminais, ramais de19,323906720mm, antena e cabos. Selecionada dn100_c02: W1/W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
    [ALL_H.csv, ALL_V.csv, ALL_V_fino.csv, Antena_PVC_DN100_C01_PRELIMINAR.FCStd, Antena_PVC_DN100_C02_PRELIMINAR.FCStd, Antena_PVC_DN100_PRELIMINAR.FCStd, Divisor_Duplo3.FCStd, POL_A_H.csv]
2026-11-12 P2S13 R17: dimensiona fechamento DN100 e compara refletor plano
    Cria montagem preliminar com flanges Al Ø110x4.76, canais confirmados
    2.5x2.5, juntas, linguetas de chapa, 12 grampos radiantes, 4 grampos
    do divisor, ferragens, N Amphenol082-6784 e oito cabos. Preserva PCBs,
    C02 e seis ramais R16. Zero intersecoes nas novas interfaces, contatos
    conferidos e STEP reaberto. Envelope completo 371.72x110x110mm.
    HFSS plano90 em 5.17GHz: 6passes/14nucleos/DeltaS0.030507, apenas um
    passe consecutivo valido. Ganho14.305dBi, H78.774/V10.106graus,
    VSWR ativo1.124/1.057. Nexxim confere a matriz com erro7.345e-16.
    Mantem abas150 na montagem principal pelo vertical preliminar mais
    simetrico. Nao qualific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
    [82-6784.stp, ALL_H.csv, ALL_V.csv, ALL_V_fino.csv, Antena_DN100_R17_PRELIMINAR.FCStd, Antena_DN100_R17_PRELIMINAR.step, BOM_R17.csv, Flange_Inferior.dxf]
2026-11-13 P2M19: simula painel 16x2 a 88 mm e registra resultado preliminar
    Cria oito placas C12 (32 radiadores e 16 portas iguais/em fase), com
    refletor 178 x 776 mm, passo vertical 48 mm e altura 14,949 mm. Resolve
    somente 5,17 GHz com 14 nucleos, solver direto/Classic curvilinear,
    limite de seis passes e alvo DeltaS 0,05, sem cabos 3D nem rede externa.
    O sexto passe termina com DeltaS 0,177100: NAO convergiu. Ganho frontal
    19,055 dBi, abertura principal H 19,428 graus e V 3,820 graus. O ganho
    atinge a meta apenas numericamente; lobulo H em -37 graus a -2,829 dB.
    VSWR ativo 1,364 a 2,295. Preserva esta limitacao nos graficos e textos.
    Auditoria confirma 14 nucleos em todos os passes, balanco de po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
    [ALL_H.csv, ALL_H_fino.csv, ALL_Potencia.csv, ALL_V.csv, ALL_V_fino.csv, C1R1_A_H.csv, C1R1_A_V.csv, C1R1_B_H.csv]
2026-11-13 P2M19: registra abertura horizontal proxima de 30 graus como aceitavel
2026-11-13 P2M19: compara colunas de 72 e 88 mm e ajustes do refletor
    Executa R02 (72/178 mm), R03 (72/162 mm) e R04 (72/146 mm) em fila
    local finita, sempre com 16 niveis, 16 entradas de 0,0625 W a 0 graus,
    14 nucleos, seis passes maximos, DeltaS alvo 0,05 e 5,17 GHz sem sweep.
    R02: G frontal 19,209303 dBi, H/V 24,238076/3,752049 graus,
    SLL H/V -4,865521/-5,775311 dB, DeltaS 0,156138.
    R03: 19,417975 dBi, H/V 23,988613/3,764508 graus,
    SLL -5,261047/-5,956615 dB, DeltaS 0,116891.
    R04: 19,500282 dBi, H/V 23,549832/3,693246 graus,
    SLL -5,446880/-6,239981 dB, DeltaS 0,139600.
    Nenhum caso convergiu ou confirmou estabilidade completa dos campos.
    Todos permanecem preliminares, assim como a referencia R01 de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
    [ALL_H.csv, ALL_H_fino.csv, ALL_Potencia.csv, ALL_V.csv, ALL_V_fino.csv, C1R1_A_H.csv, C1R1_A_V.csv, C1R1_B_H.csv]
2026-11-13 P2M19: continue 72 mm / 146 mm mesh through passes 7 and 8
    Preserve the six-pass reference, geometry, material and boundary definitions,
    mesh configuration and nine field cache IDs. Resume only two adaptive passes
    at 5.17 GHz with 14 cores, 16 equal in-phase inputs and no frequency sweep.
    Final result remains preliminary: DeltaS 0.05196469 exceeds 0.05. Realized
    frontal gain 20.10098 dBi, H/V 22.73419/3.75340 deg, active VSWR 1.14303-1.35297.
    Power balance, passivity, reciprocity and field recomposition checked; zero
    Major/Minor repairs. Gain changed 0.24101 dB on the last pass.
    Include reviewed polar/Cartesian plots, per-port VSWR, HFSS/FreeCAD natives,
    S16 and far-field exports. Preserve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
    [ALL_H.csv, ALL_H_fino.csv, ALL_Potencia.csv, ALL_V.csv, ALL_V_fino.csv, C1R1_A_H.csv, C1R1_A_V.csv, C1R1_B_H.csv]
2026-11-14 P2M19: confirm DeltaS convergence after preserved-mesh passes 9 and 10
    Resume only two additional passes of the 72 mm column / 146 mm reflector
    configuration at 5.17 GHz: 14 cores, 16 equal in-phase inputs, no sweep.
    Preserve the eight-pass source, geometry, materials, boundaries, mesh settings
    and nine field-cache trace IDs. Verify the full 1-8 history remains identical.
    DeltaS 9/10 = 0.02161726 / 0.02450976; two consecutive passes below 0.05.
    Realized frontal gain 20.39075 dBi, H/V 22.76093 / 3.76793 deg, active VSWR
    1.05404-1.22092; maximum matched-port VSWR 1.29355. Valid power balance,
    passivity, reciprocity and field recomposition; zero Major/Minor repairs.
    Field stability remains pen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
    [ALL_H.csv, ALL_H_fino.csv, ALL_Potencia.csv, ALL_V.csv, ALL_V_fino.csv, C1R1_A_H.csv, C1R1_A_V.csv, C1R1_B_H.csv]
2026-11-14 Conclui P2M19 72/146 mm com passes 11 e 12 e compara estabilidade
    Preserva os dez passes anteriores, geometria e monitores; 14 nucleos, 16 entradas iguais/em fase, 5,17 GHz, sem sweep. DeltaS final 0,014268; ganho frontal 20,47487 dBi; H/V 22,68259/3,77794 graus; VSWR ativo 1,00921-1,17386.
    Inclui checkpoint RF real do passe 11 e comparacao 10/11/12. Entre os dois novos passes, ganho varia +0,02481 dB e aberturas -0,06339/+0,00437 grau. Convergencia S confirmada; estabilidade completa de 0,1 dB nas nove sondas ainda nao atendida. Nao qualifica banda nem ganho MIMO por entrada.
    Confere potencia, passividade, reciprocidade, recomposicao dos campos, continuidade da malha e zero Major/Minor. D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
    [ALL_H.csv, ALL_H_fino.csv, ALL_Potencia.csv, ALL_V.csv, ALL_V_fino.csv, C1R1_A_H.csv, C1R1_A_V.csv, C1R1_B_H.csv]
2026-11-14 Conclui P2M19 com passes 13 e 14 e compara estabilidade
    Continua a malha de 72 mm entre colunas e refletor de 146 mm, com 14 nucleos, 16 entradas iguais em fase, 5,17 GHz e sem sweep. Preserva exatamente os doze passes anteriores e exporta o passe 13 antes do 14.
    DeltaS final 0,01048445 atende 0,05. Ganho frontal total 20,54404 dBi; H/V 22,49105/3,78322 graus; VSWR ativo 1,03305-1,18168 e maximo com demais entradas casadas 1,31598. Entre 13/14: DeltaG +0,039965 dB, DeltaH -0,098558 grau, DeltaV +0,001522 grau.
    Balanco de potencia, passividade, reciprocidade e recomposicao dos campos conferidos; zero reparos Major/Minor. Nove sondas ainda nao atendem 0,1 dB por dois passes: maximo final 0,1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
    [ALL_H.csv, ALL_H_fino.csv, ALL_Potencia.csv, ALL_V.csv, ALL_V_fino.csv, C1R1_A_H.csv, C1R1_A_V.csv, C1R1_B_H.csv]
2026-11-14 Prepara mecanica P2M19 R09 e rede externa com simulacoes suspensas
    Registra a ordem de parar a simulacao e de interromper/registrar falta de memoria, sem repeticao automatica. Confirma ausencia de solver P2M19; bloqueia executores historicos e inclui guarda com limiares preventivos, identidade de processos e testes usando apenas processos Python inertes. Nao iniciou HFSS, Nexxim ou FEM.
    Envia resumo da R08 (20,544 dBi; H/V 22,491/3,783 graus; VSWR ativo maximo 1,182; DeltaS 0,010484) para gecesars@gmail.com, mensagem 1a1db636cf5f699f, com a pendencia de estabilidade completa de campo e sem afirmar desempenho final com a nova rede.
    Monta FreeCAD preliminar com base Al146x70x4mm, dois reforc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
    [82-6784.stp, Base_aluminio_PRELIMINAR.step, P2M19_R09_PRELIMINAR.FCStd, P2M19_R09_PRELIMINAR.step, Refletor_furado_PRELIMINAR.step, conexoes.csv, furacao_PRELIMINAR.csv, lista_materiais_PRELIMINAR.csv]
